seonukkim/gps_hc12_robot/docs/rc_channel_map.md

# RC Channel Map

Context:
- Station controller: disassembled RadioLink transmitter integrated into the Jetson/station box
- Expected receiver output: combined PPM/SUM into OpenRB D6
- Verification sources: old integrated `openrb_robot_controller.ino`, safe PPM
  probes, and rover `USBDBG` logs

The station transmitter panel labels are not enough to validate this map. The
rover-side receiver output mode and the signal wire going to OpenRB `D6` must
also be correct. If USBDBG reports `PPM_SYNC_ONLY_NO_CHANNELS`, then `D6` is
not receiving a usable combined PPM/SUM frame even if the station controller is
powered and linked.

## Station Integrated Controller Mapping

| PPM Channel | Station Control | Firmware Use | Notes |
|---:|---|---|---|
| CH1 | Steering joystick horizontal | Steering | `STEERING_CHANNEL_INDEX = 0` |
| CH2 | Throttle joystick vertical | Throttle | `THROTTLE_CHANNEL_INDEX = 1` |
| CH5 | Manual/Auto switch | Mode select | `MODE_CHANNEL_INDEX = 4` |
| CH7 | Reserved / unused | None | Do not use for mode |

The station panel can physically look like `CH7`, but the firmware uses the receiver's PPM `CH5` for Manual/Auto mode. `CH7` is reserved/unused for now.

## Firmware Constants

- `STEERING_CHANNEL_INDEX = 0`
- `THROTTLE_CHANNEL_INDEX = 1`
- `MODE_CHANNEL_INDEX = 4`
- PPM decoder edge/sync: `RISING`, frame gap `>3000 us`, matching the old
  integrated `openrb_robot_controller.ino` baseline that physically moved
- `STEERING_CENTER_US = 1504`
- `THROTTLE_CENTER_US = 1500`
- `RC_DEADBAND_US = 80`
- `RC_AUTO_SWITCH_ON_US = 1600`
- `MANUAL_FORWARD_SIGN = -1` for the current rover/controller
- `MANUAL_TURN_SIGN = 1` for the current rover/controller
- `MOTOR_OUTPUT_SWAP_LR = 0`
- `DRIVE_CALIBRATION_ENABLE = 0` for the current uncalibrated baseline

RC manual mode no longer uses the old 45-degree remap in the final drive path.
The raw CH1/CH2 stick axes are interpreted as steering and throttle, then mixed
as arcade forward/turn commands into logical wheel commands:

```cpp
forward = MANUAL_FORWARD_SIGN * throttle_norm;
turn = MANUAL_TURN_SIGN * steer_norm;
logical_left = clamp(forward + turn);
logical_right = clamp(forward - turn);
```

The same common output layer used by AUTO and motor pulse then maps logical
wheels to the probe-confirmed physical A/B pins:

```cpp
A = (logical_left + logical_right) / 2;
B = (logical_right - logical_left) / 2;
```

Target behavior:

- physical stick straight up -> forward
- physical stick straight down -> reverse
- physical stick straight left/right -> steering without forward/reverse bias

This is an RC axis sign convention. It does not change the physical output
truth table: A is throttle, B is turn, `A=(L+R)/2`, and `B=(R-L)/2`.

## Mode Interpretation

- `CH5 <= 1600 us` -> `MANUAL`
- `CH5 > 1600 us` -> `AUTO_READY`
- `CH5` high by itself must not drive motors
- In `AUTO_READY`, `control_source` remains `STOP` until a valid explicit station/autonomous command is accepted
- `MANUAL` allows RC manual drive

## Confirmed Observations

- `CH1` moves with steering input
- `CH2` moves with throttle input
- `CH5` low/mid stays `MANUAL`
- `CH5` high selects `AUTO_READY`
- `CH7` is not used by firmware for mode
- Transmitter/link loss drives RC invalid handling and motor stop behavior

## Bench Check

1. Move the steering joystick and confirm `CH1` changes.
2. Move the throttle joystick and confirm `CH2` changes.
3. Toggle the Manual/Auto switch and confirm `CH5` changes between low/high values.
4. Confirm `CH7` may move independently, but it does not affect rover mode.
5. Turn the transmitter off or break the RC link and confirm the rover returns to stop/failsafe behavior.

Before interpreting channel numbers, confirm the PPM frame itself is valid:

- `ppm_frame_count` should increase.
- `ppm_last_channel_count` should be at least `5`.
- `raw_ch1_us`, `raw_ch2_us`, and `raw_ch5_us` should be in the roughly
  `900..2100 us` range.
- If `ppm_edge_count` and `ppm_sync_count` increase but `ppm_frame_count=0`,
  the receiver is not delivering combined PPM/SUM to `D6`.

## Final note on station physical switch label

The physical switch on the station panel may appear to be labeled CH7, but the receiver PPM stream reports this Manual/Auto switch as PPM CH5.

Final firmware mapping:
- Steering: PPM CH1 / code index 0
- Throttle: PPM CH2 / code index 1
- Manual/Auto: PPM CH5 / code index 4
- PPM CH7 is not used for Manual/Auto in the current firmware.

Do not change `MODE_CHANNEL_INDEX` to 6 unless raw PPM logs confirm that the desired physical switch actually changes printed CH7.

## Final physical station control note

Final operating convention:

- Steering: joystick horizontal -> PPM CH1 -> code index 0
- Throttle: joystick vertical -> PPM CH2 -> code index 1
- Manual/Auto mode: the working physical mode switch on the station panel -> PPM CH5 -> code index 4

The station panel label may look confusing because the working physical switch may appear to be in a CH7 position.
For operation, relabel that working switch as `CH5 / MODE / MANUAL-AUTO`.
CH7 is not used for mode in the current firmware.
