seonukkim/gps_hc12_robot/docs/autonomy_plan.md

# Autonomy Plan

This project does not have real autonomous waypoint following yet. The current
autonomy work is limited to a safe fixed-wiring dry-run mode that combines RC
manual driving with GPS readiness calculations.

## Status

Unified fixed-wiring RC + GPS dry-run validation is complete. The single
waypoint experiment with `AUTO_MOTION_ARMED=0` has now passed the no-motion AUTO
candidate-command validation outdoors: GPS placement was corrected, MANUAL/AUTO
switching was verified, `distance_allowed=true` and `safety_ready=true` were
observed, candidate commands reached `0.100` / `0.100`, and final motor outputs
remained inhibited at `0.000` / `0.000`. Compile-time target override is
verified in USBDBG, but targets still become stale whenever the rover moves.
GPS readiness is tiered so no-motion dry-run can use `gps_dryrun_ready`, while
any future armed motion must require `gps_motion_ready`. On 2026-05-29 the armed
build (`AUTO_MOTION_ARMED=1`) reached firmware-side final output for the first
time (`final_left_cmd=0.100` / `final_right_cmd=0.100`, motion-grade GPS, all
gates passing) but produced **no visible motion** — almost certainly the
motor/ESC/friction deadband (`0.100` ≈ 1530 µs, only 30 µs above neutral). The
AUTO command must not be raised ungated. Armed motion is now permitted ONLY
through the guarded ground crawl harness (`GROUND_CRAWL_TEST_MODE=1`) with a
command clamp and a hard latch stop. The first guarded crawl 0.08 validation is
now complete: `AUTO_RUNNING` was reached during a good GPS window,
`ground_crawl_ready=true`, the raw `0.100` candidate commands were clamped to
`0.080`, latch stop forced zero output after the duration limit, too-close
target distance was blocked as `DISTANCE_OUT_OF_RANGE`, and degraded GPS was
blocked as `GPS_NOT_MOTION_READY`. This validates the safety harness, not full
autonomous driving. The current target is now too close and must be replaced
with a fresh target for any future crawl. A later cap-only 0.12 run
confirmed that `GROUND_CRAWL_MAX_CMD` only raises the final cap: the candidate
command stayed at `0.100`, so final commands stayed at `0.100`. The firmware now
uses `SINGLE_WP_CRAWL_BASE_CMD` for candidate speed and keeps
`GROUND_CRAWL_MAX_CMD` as the final safety clamp. Floor waypoint driving is not
approved yet. After the manual/drive mapping fix, the first successful guarded
AUTO crawl physically moved the rover briefly forward. The confirmed baseline
was `MANUAL_FORWARD_SIGN=-1`, `MANUAL_TURN_SIGN=1`,
`old_angle_remap_active=false`, physical A/B mapping
`A=(logical_left+logical_right)/2`, `B=(logical_right-logical_left)/2`,
`SINGLE_WP_CRAWL_BASE_CMD=0.220`, and `GROUND_CRAWL_MAX_CMD=0.220`. The
successful `AUTO_RUNNING` line showed motion-grade GPS, `target_distance_m≈9.6`,
`distance_allowed=true`, `ground_crawl_ready=true`, straight output
`physical_a_cmd=0.220` / `physical_b_cmd=0.000`, and final logical commands
`0.220` / `0.220`; the latch stopped output after roughly `510` ms. This is
short guarded forward motion only, not waypoint following or coverage driving.
The repeated `1000` ms guarded crawl has also now been validated. With
`GROUND_CRAWL_TEST_MODE=1`, `GROUND_CRAWL_MAX_CMD=0.220`,
`GROUND_CRAWL_MAX_AUTO_MS=1000`, `SINGLE_WP_CRAWL_BASE_CMD=0.220`,
`AUTO_MOTION_ARMED=1`, `MANUAL_FORWARD_SIGN=-1`, and `MANUAL_TURN_SIGN=1`, the
user toggled AUTO/MANUAL about `3..4` times and `AUTO_RUNNING` was observed
multiple times. Each valid AUTO window produced straight forward output
(`physical_a_cmd=0.220`, `physical_b_cmd=0.000`) and the latch returned outputs
to zero after about `1000` ms. `target_distance_m` varied around `16.8..18.0`
instead of monotonically decreasing, which is expected because no steering or
course correction is active yet.

Full coverage driving from `mission.json` / `mission.csv` is intentionally not
the next step. The rover must first prove one carefully bounded waypoint motion
with explicit safety gates, GPS validity policy, heading plan, manual override,
and wheel-off-ground checks.

Motor deadband calibration is now temporarily split out from GPS/path planning:
`MOTOR_PULSE_TEST_MODE=1` ignores GPS readiness and waypoint distance, disables
HC-12, preserves RC MANUAL, and emits one AUTO-only neutral-stick pulse before
latching stop. Use it only to identify motor/drivetrain response thresholds.
The first calibration result shows `0.180` is below visible motion while `0.220`
does move, but symmetric `0.220` software output produced rotation-like motion
rather than straight motion. The physical pin probe has now clarified the output
path: physical output A is throttle, physical output B is turn, and logical
wheel commands must be converted with `A=(left+right)/2` and
`B=(right-left)/2`. The current blocker is validating that corrected mapping
with both-wheel forward/reverse tests, not right-side compensation yet.

Staged plan:

1. Dry-run complete: MANUAL RC and AUTO GPS distance/bearing computation coexist
   with AUTO motor output forced to zero.
2. Single-waypoint candidate-command dry-run complete: candidate commands were
   computed behind safety gates while `AUTO_MOTION_ARMED=0` forced final motor
   output to zero.
3. Target override diagnostics complete: USBDBG now confirms
   `target_override_enabled=true`, `target_source=compile_time`, and runtime
   `target_lat` / `target_lon` matching the compile-time macros.
4. RC recovery complete: with the station/controller powered and linked, MANUAL
   shows `mode_us≈1000..1001` and `control_source=RC_MANUAL`; AUTO shows
   `mode_us≈2001..2002`, `mode=AUTO_READY`, and `control_source=STOP`.
5. Outdoor GPS/distance recovery complete: rover placement farther outdoors
   recovered stable GPS and target distance can be brought into range with a
   recomputed compile-time target.
6. Full outdoor fixed-frame no-motion dry-run complete: AUTO_READY,
   `timeout_ok=true`, `distance_allowed=true`, `safety_ready=true`, nonzero
   candidate commands, and inhibited final outputs were observed together.
7. Timeout semantics improvement complete in firmware: the single-waypoint
   experiment tracks AUTO entry time, resets the AUTO timeout when leaving
   AUTO, and reports `timeout_source=auto_entry`, `auto_entry_ms`,
   `auto_elapsed_ms`, `timeout_limit_ms`, and `timeout_ok`.
8. GPS reacquisition policy complete: if GPS is lost, reacquire stable outdoor
   GPS before repeating AUTO_READY validation. Placement farther outdoors is the
   known fix for the recent no-fix runs.
9. GPS readiness hardening complete: operational `gps_lat` / `gps_lon`, target
   distance, and target bearing no longer use stale cached TinyGPS coordinates.
   No-motion dry-run uses the dry-run GPS tier; armed motion uses the motion GPS
   tier.
10. GPS readiness tiers complete:
   - `gps_solution_valid` confirms a valid fresh solution with usable NMEA fix
     status when available.
   - `gps_dryrun_ready` allows no-motion candidate calculations with
     `GPS_DRYRUN_MIN_SATS=4` and `GPS_DRYRUN_MAX_HDOP=6.0`.
   - `gps_motion_ready` keeps stricter motion gating with
     `GPS_MOTION_MIN_SATS=5` and `GPS_MOTION_MAX_HDOP=2.5`.
11. Sensor-frame validation: keep the GPS antenna fixed to the rover body in open
   sky. IMU diagnostics remain useful, but IMU is optional for the current
   GPS+RC single-waypoint preparation stage and must not block candidate dry-run
   work.
12. Guarded ground crawl 0.08 safety validation complete. Armed AUTO motion is
   permitted ONLY through the guarded ground crawl harness. The 0.08 run reached
   `AUTO_RUNNING` with `ground_crawl_ready=true`, clamped
   `candidate_left_cmd=0.100` / `candidate_right_cmd=0.100` down to
   `final_left_cmd=0.080` / `final_right_cmd=0.080`, latched stop after the
   duration limit, blocked a too-close `3.9..4.4` m target as
   `DISTANCE_OUT_OF_RANGE`, and blocked degraded GPS as `GPS_NOT_MOTION_READY`.
13. Guarded ground crawl 0.12 deadband retry: only if 0.08 produced no visible
   physical movement, first reacquire current GPS and compute a fresh target
   `10..12` m away. Then retry with `SINGLE_WP_CRAWL_BASE_CMD=0.12` and
   `GROUND_CRAWL_MAX_CMD=0.12`, the same `GROUND_CRAWL_MAX_AUTO_MS` latch,
   neutral RC, motion-grade GPS, near-field target window, and manual override.
   `SINGLE_WP_CRAWL_BASE_CMD` controls the candidate command; `GROUND_CRAWL_MAX_CMD`
   remains the final safety clamp. Do not reuse stale targets.
14. First successful guarded forward crawl complete. With
   `SINGLE_WP_CRAWL_BASE_CMD=0.220` and `GROUND_CRAWL_MAX_CMD=0.220`, the rover
   briefly moved forward in `AUTO_RUNNING`, then latch-stop forced neutral.
   This validates a short bounded forward crawl, not full path execution.
15. Physical output pin truth table: complete. `firmware/physical_output_pin_probe`
   confirmed A is throttle and B is turn. The integrated conversion now uses
   `A=(left+right)/2` and `B=(right-left)/2`.
16. Corrected direct wheel pulse validation: first run both-wheel forward and
   reverse tests. Single-wheel logical commands are halved at the physical pin
   level and may still be near deadband.
17. Differential left/right motor pulse calibration: after corrected both-wheel
   behavior is verified, characterize left-only, right-only, and matched
   left/right thresholds with `MOTOR_PULSE_LEFT_CMD` and
   `MOTOR_PULSE_RIGHT_CMD` before any GPS path work.
18. Shared drive calibration layer: apply any deadband compensation, left/right
   trim, or output scaling in one common layer used by both MANUAL and AUTO.
   This layer is behind `DRIVE_CALIBRATION_ENABLE=1`; identity/off defaults
   preserve current behavior.
19. Repeated 1000 ms guarded forward crawl complete. This proves repeated
   short guarded autonomous forward actuation, not path execution.
20. Station-side path planning preview only, with no motor execution.
21. Single-waypoint steering dry-run diagnostics added with
   `SINGLE_WP_STEERING_DRYRUN=1`. This mode prints desired steering fields but
   does not enable motion by itself.
22. Heading/course estimation before physical waypoint following. GPS position
   alone is insufficient for steering; course-over-ground is only accepted after
   at least `SINGLE_WAYPOINT_COURSE_MIN_DISPLACEMENT_M` of GPS displacement
   (default `2.0` m, compile-time configurable via
   `-DCOURSE_MIN_DISPLACEMENT_M=<meters>`). A diagnostic tethered steering
   dry-run may set `-DCOURSE_MIN_DISPLACEMENT_M=1.0` to estimate heading over
   shorter movement. This only changes when course-over-ground is estimated; it
   does not weaken actual GPS motion safety thresholds (`gps_motion_min_sats`,
   `gps_motion_max_hdop`, `gps_motion_stale_ms` are unchanged) and does not
   enable motor execution.
23. Low-speed floor test: only after guarded crawl behavior, drivetrain
   calibration, steering behavior, and sensor-frame assumptions are validated.
24. Multi-waypoint motion: only after single-waypoint behavior is proven.
25. Coverage path / lawnmower driving: last step, after mission sequencing,
   heading control, logging, and safety policy are complete.

## GPS Antenna Frame Vs Rover Body Frame

GPS coordinates are antenna coordinates. During the recent single-waypoint
candidate dry-run, the GPS antenna was placed far outside while the rover body
remained indoors. That setup is acceptable for validating GPS reception,
`gps_fix`, distance/bearing computation, and AUTO motor inhibition, but it is
not valid for floor navigation.

A detached antenna means `gps_lat` / `gps_lon` represents the antenna location,
not the rover body location. An IMU cannot fully correct a detached or
free-moving GPS antenna into rover body position. The IMU may help later with
heading, rotation, tilt, and short-term motion sensing, but it does not replace
a rover-mounted GPS position source.

Real outdoor navigation requires one of these conditions:

- the GPS antenna is rigidly mounted on the rover; or
- the antenna offset from the rover body frame is fixed, measured, and modeled.

Until that is true, do not proceed to floor waypoint driving and do not approve
`AUTO_MOTION_ARMED=1` floor tests.

## Next Required Validation Before Further Motion

- BLOCKER (2026-05-30): the AUTO/MANUAL switch channel must be stable before any
  physical path following. A PPM hold test showed receiver CH5 did not hold
  HIGH: `ch5_high_auto_like=4` of `total_ch5_samples=68`
  (`RESULT=CH5_AUTO_DID_NOT_HOLD`). Raising AUTO briefly enters `AUTO_READY` then
  `FAILSAFE` as `ppm_age_ms` grows. Use `firmware/ppm_channel_map_probe` with
  `tools/analyze_ppm_log.py` to find a receiver channel that is a stable
  2-position switch (reaches both LOW and HIGH and holds HIGH), then set
  `-DMODE_CHANNEL_INDEX=<0-based index>` in the main controller (default `4` =
  CH5). Path planning preview is allowed; physical path execution is not.
- Station-side path planning preview only; do not send rover motor commands from
  the station mission output yet.
- Use `SINGLE_WP_STEERING_DRYRUN=1` for no-motion single-waypoint steering
  diagnostics before longer ground motion.
- Add heading/course estimation before physical waypoint following. If movement
  is too small, expect `heading_ready=false` and
  `steering_block_reason=NO_HEADING`. The minimum displacement is
  `SINGLE_WAYPOINT_COURSE_MIN_DISPLACEMENT_M` (default `2.0` m); a tethered
  diagnostic build can lower it with `-DCOURSE_MIN_DISPLACEMENT_M=1.0` without
  changing GPS motion safety thresholds or enabling motion. USBDBG reports the
  active value as `course_min_displacement_m` and the configured macro as
  `course_min_displacement_source`.
- After each guarded crawl, compare GPS delta and target-distance change against
  the expected forward movement. Do not infer path-following quality from wheel
  motion alone.
- For each guarded crawl run, go fully outdoors with the rover and GPS fixed
  together, acquire a fresh GPS fix in MANUAL, and compute a fresh target from
  that actual fix. Do not reuse stale target coordinates.
- Choose a target roughly `10..12` m away so it remains inside the crawl
  near-field window (`5..20` m) but does not immediately trip the too-close
  block.
- Confirm the station/controller is powered on and linked before interpreting
  RC mode values; controller-off can make the PPM stream appear stuck or
  failsafe-like.
- Verify Manual/Auto switch positions before the crawl run: MANUAL should show
  `mode_us≈1000` and `control_source=RC_MANUAL`; AUTO should show
  `mode_us≈2000` and either `mode=AUTO_READY` before the crawl gates pass or
  `mode=AUTO_RUNNING` only while all guarded crawl gates pass.
- Confirm the target override fields still match the intended target, then
  interpret `target_distance_m`, `distance_allowed`, `safety_ready`, and
  `ground_crawl_block_reason`.
- `distance_allowed=true` in MANUAL is not enough; verify the same nearby-target
  condition in AUTO with `gps_motion_ready=true`, `timeout_ok=true`,
  `safety_ready=true`, and `ground_crawl_ready=true`.
- Confirm GPS readiness using `gps_age_ms`, `gps_hdop`, and `gps_sats`; do not
  rely on `gps_fix=true` alone.
- `gps_chars` increasing only proves serial/NMEA input is alive. Do not proceed
  to AUTO candidate validation when `gps_fix=false`, `gps_lat=NA`,
  `gps_lon=NA`, `gps_sats=0`, or `gps_hdop=99.99`.
- In updated USBDBG, `gps_ready` remains the stricter motion-level field.
  `gps_location_valid=true` only means TinyGPS has a cached location; it is not
  enough by itself.
- `AUTO_MOTION_ARMED=0` no-motion candidate calculations may use
  `gps_dryrun_ready=true`; this is reported as `active_gps_ready=true` in the
  single-waypoint debug fields.
- Any `AUTO_MOTION_ARMED=1` guarded crawl build must require
  `gps_motion_ready=true`.
- HDOP around `5` is acceptable only for no-motion dry-run candidate
  calculation. It is not approved for floor driving.
- If the relevant readiness tier is false, target-distance and bearing should
  print `NA`. Inspect `gps_cached_lat`, `gps_cached_lon`, and
  `gps_cached_age_ms` only as debug-only cached data.
- Run candidate validation after entering AUTO; MANUAL GPS waiting no longer
  consumes the single-waypoint AUTO timeout in the updated firmware.
- In MANUAL, expect `auto_entry_ms=NA` and `auto_elapsed_ms=NA`; after switching
  to AUTO, expect `timeout_source=auto_entry`, a numeric `auto_entry_ms`, a
  small `auto_elapsed_ms`, and `timeout_ok=true` until the AUTO timeout limit is
  exceeded.
- Repeated 1000 ms guarded forward crawl succeeded at
  `SINGLE_WP_CRAWL_BASE_CMD=0.220`, `GROUND_CRAWL_MAX_CMD=0.220`, and
  `GROUND_CRAWL_MAX_AUTO_MS=1000`. Future retries must still use the guarded
  crawl harness, duration latch, and fresh target.
- Do not run floor driving yet. Keep any indoor or non-bench validation in
  no-motion mode with `AUTO_MOTION_ARMED=0`; guarded crawl is a bounded
  deadband-calibration step, not full autonomous driving.
- IMU status: optional for the current GPS+RC single-waypoint stage. The
  default `Wire` scanner currently shows D11/D12 stuck low before scanning, so
  no IMU address is verified and no IMU data may be used for autonomy yet.

## Current Fixed-Wiring Dry-Run Mode

Compile-time flag:

```text
FIXED_WIRING_GPS_SERIAL2_RC_AUTONOMY_DRYRUN=1
```

Behavior:

- GPS uses the fixed central OpenRB connector on `Serial2` at `9600`.
- HC-12 is disabled/ignored because it may conflict with the fixed GPS
  `Serial2` wiring.
- RC PPM remains enabled and is the safety/manual interface.
- MANUAL mode preserves current RC manual driving behavior and reports
  `control_source=RC_MANUAL`.
- AUTO switch position does not drive motors. It forces `left_cmd=0` and
  `right_cmd=0`, then prints readiness/debug fields over USB.
- STOP, RC failsafe, and manual override must not be weakened.

AUTO dry-run debug fields:

```text
autonomy_dryrun=true
target_lat=35.571120
target_lon=129.186050
target_distance_m=...
target_bearing_deg=...
gps_ready=...
target_ready=...
autonomy_ready=...
```

The current placeholder target is hard-coded in the firmware as:

```text
lat=35.571120
lon=129.186050
```

The placeholder target is only used to compute distance and bearing from the
current GPS position. It must not cause motor movement.

## Onboard Mission Dry-Run Implementation

The current onboard mission dry-run is implemented inside
`firmware/openrb_robot_controller/openrb_robot_controller.ino` and is enabled
only by:

```text
FIXED_WIRING_GPS_SERIAL2_RC_AUTONOMY_DRYRUN=1
```

The dry-run target is a small placeholder config section in the firmware:

- `DRYRUN_TARGET_AVAILABLE`
- `DRYRUN_TARGET_LAT`
- `DRYRUN_TARGET_LON`
- `DRYRUN_GPS_READY_MAX_AGE_MS`

The Arduino-side geodesy helpers are:

- `dryrunDistanceMeters(...)`: haversine distance in meters.
- `dryrunBearingDegrees(...)`: initial bearing in degrees, normalized to
  `0..360`.

These helpers are currently Arduino-side only, so there is no Python unit test
for them. Manual validation is by USB debug output in the dry-run build:

- verify `target_distance_m` is finite when the active GPS tier is ready
  (`gps_dryrun_ready=true` for inhibited dry-run);
- verify `target_bearing_deg` stays in `0..360`;
- verify motion-level `gps_ready=true` only when GPS has a valid recent
  high-quality location;
- verify AUTO mode still reports `left_cmd=0` and `right_cmd=0`;
- verify switching RC back to MANUAL restores `control_source=RC_MANUAL`.

This is the onboard preparation step for future mission execution. It is not
real waypoint following.

## Validation Result

The unified fixed-wiring dry-run firmware is complete and was tested with
`FIXED_WIRING_GPS_SERIAL2_RC_AUTONOMY_DRYRUN=1`.

Observed:

- USBDBG identified the build as unified dry-run, not default and not GPS-only
  diagnostic:
  - `fixed_wiring_gps_serial2_diag=false`
  - `hc12_enabled=false`
  - `autonomy_dryrun=true`
- `GPS_SERIAL=Serial2`.
- HC-12 was disabled/ignored.
- MANUAL mode worked with RC control.
- `control_source=RC_MANUAL` in MANUAL mode.
- Stick input changed manual command, logical wheel, and final command fields.
- Current MANUAL RC sign convention is `MANUAL_FORWARD_SIGN=-1`,
  `MANUAL_TURN_SIGN=1`, `MOTOR_OUTPUT_SWAP_LR=0`, and
  `DRIVE_CALIBRATION_ENABLE=0`; this is an RC axis sign fix and does not alter
  GPS, motor pulse, or physical A/B output mapping.
- AUTO mode printed `autonomy_dryrun=true`.
- AUTO mode printed GPS fields, `target_lat`, `target_lon`, and target
  distance/bearing fields.
- With the antenna outside/open sky, `gps_fix=true` was observed.
- Earlier `gps_sats=0` / `gps_hdop=99.99` was poor antenna placement, not UART
  failure.
- AUTO mode used `control_source=STOP` and kept `left_cmd=0` and
  `right_cmd=0`.
- No motor movement occurred in AUTO dry-run.

Rule:

- This is the first firmware mode where MANUAL and GPS dry-run coexist in one
  firmware.
- AUTO is still computation-only.
- Real motion is not enabled yet.
- MANUAL remains the recovery/manual override path.
- HC-12 remains disabled in this fixed-wiring GPS mode.

## Readiness Logic

- `gps_ready=true` is the stricter motion-level GPS gate.
- In inhibited dry-run, `gps_dryrun_ready=true` can allow distance, bearing,
  and candidate-command diagnostics while final motor commands remain zero.
- `target_ready=true` when the placeholder waypoint is available.
- `autonomy_ready=true` only when RC is valid, the RC AUTO switch is on, the
  relevant GPS tier is ready, and the target is ready.

`autonomy_ready=true` is still only a dry-run state. It is not permission to
move.

## Single-Waypoint Experiment

Compile-time flag:

```text
FIXED_WIRING_GPS_SERIAL2_SINGLE_WAYPOINT_EXPERIMENT=1
```

Default motion arming flag:

```text
AUTO_MOTION_ARMED=0
```

Behavior:

- GPS uses fixed `Serial2` at `9600`.
- HC-12 is disabled/ignored.
- RC PPM remains enabled.
- MANUAL mode preserves existing RC manual driving and reports
  `control_source=RC_MANUAL`.
- AUTO mode uses one placeholder target only.
- AUTO mode computes `target_distance_m` and `target_bearing_deg`.
- AUTO mode prints candidate left/right commands.
- Candidate commands are straight low-speed placeholders. Target bearing is
  printed for inspection, but heading control is not implemented yet.
- With `AUTO_MOTION_ARMED=0`, final `left_cmd` and `right_cmd` remain zero even
  when candidate commands are nonzero.
- With `AUTO_MOTION_ARMED=1`, low-speed candidate output is allowed only if all
  safety gates pass. This is reserved for a later explicit wheel-off-ground
  bench test.

Target override rule:

- Runtime USBDBG `target_lat` and `target_lon` are the source of truth.
- Compile-time target override flags must be verified in USBDBG before using
  `target_distance_m`, `distance_allowed`, or `safety_ready` to approve any next
  step.
- With both override macros provided, USBDBG should print
  `target_override_enabled=true` and `target_source=compile_time`.
- Without override macros, USBDBG should print `target_override_enabled=false`
  and `target_source=fallback`, using the existing placeholder target.
- USBDBG also prints `target_lat_macro`, `target_lon_macro`,
  `max_target_distance_m`, and `arrival_radius_m` for diagnostics.
- The latest nearby retest attempted to compile with
  `SINGLE_WP_TARGET_LAT=35.5716800` and `SINGLE_WP_TARGET_LON=129.1866516`, but
  runtime USBDBG still printed `target_lat=35.571120` and
  `target_lon=129.186050`.
- Therefore the nearby retest was blocked by target override plumbing and must
  not be counted as a successful nearby candidate-command test.
- A later target override check compiled with
  `SINGLE_WP_TARGET_LAT=35.5710210` and `SINGLE_WP_TARGET_LON=129.1864016`.
  USBDBG correctly printed `target_override_enabled=true`,
  `target_source=compile_time`, matching macro strings, and runtime
  `target_lat=35.571021`, `target_lon=129.186402`.
- That proves target override plumbing is fixed. It does not prove nearby
  candidate command behavior, because the current GPS position was around
  `35.56752..35.56756,129.18688`, making `target_distance_m≈380..392`.
- A next-day retest kept target override working
  (`target_override_enabled=true`, `target_source=compile_time`) but the antenna
  position changed to about `35.571310,129.188630` while the firmware target was
  `35.567560,129.186792`, producing `target_distance_m≈448.9`.
- That next-day run was also blocked by GPS readiness: `gps_fix=true` appeared,
  but `gps_ready=false` remained because `gps_age_ms` was often very large,
  `gps_sats` fluctuated, and `gps_hdop` was often `99.99` with only occasional
  readings around `4.7`.
- A later nearby attempt compiled with `SINGLE_WP_TARGET_LAT=35.5713100` and
  `SINGLE_WP_TARGET_LON=129.1885416`; USBDBG confirmed the override target, and
  GPS fix was acquired at `gps_lat=35.571384`, `gps_lon=129.187514`. The target
  was still `93.3` m away from the actual fix, so `distance_allowed=false` with
  `max_target_distance_m=30.0`.
- The latest window/outside-antenna test compiled with
  `SINGLE_WP_TARGET_LAT=35.5713840` and `SINGLE_WP_TARGET_LON=129.1874256`;
  USBDBG confirmed the override, but the antenna position was around
  `35.571284,129.188456`, the target was still about `93.9` m away, and GPS
  quality was unstable (`gps_sats` often `0`, `gps_hdop` often `99.99`,
  stale `gps_age_ms`).

Safety constants:

- `SINGLE_WP_CRAWL_BASE_CMD=0.100` (candidate straight-line crawl command before
  final guarded-crawl clamping)
- `SINGLE_WAYPOINT_ARRIVAL_RADIUS_M=2.5`
- `SINGLE_WAYPOINT_MAX_TARGET_DISTANCE_M=30.0`
- Dry-run GPS tier: `GPS_DRYRUN_STALE_MS=2000`,
  `GPS_DRYRUN_MIN_SATS=4`, `GPS_DRYRUN_MAX_HDOP=6.0`
- Motion GPS tier: `GPS_MOTION_STALE_MS=2000`, `GPS_MOTION_MIN_SATS=5`,
  `GPS_MOTION_MAX_HDOP=2.5`
- `SINGLE_WAYPOINT_AUTO_TIMEOUT_MS=15000`
- Guarded ground crawl (armed-motion harness; only path to armed motion):
  - `GROUND_CRAWL_TEST_MODE` (default `0`; `1` enables the crawl harness)
  - `GROUND_CRAWL_MAX_CMD=0.08` (final command clamp magnitude)
  - `GROUND_CRAWL_MAX_AUTO_MS=1200` (latch hard-stop after this much continuous
    AUTO; latch clears only on MANUAL)
  - `GROUND_CRAWL_MIN_TARGET_DISTANCE_M=5.0`,
    `GROUND_CRAWL_MAX_TARGET_DISTANCE_M=20.0` (near-field target window, further
    restricting `SINGLE_WAYPOINT_MAX_TARGET_DISTANCE_M=30.0`)

Safety gates:

- GPS tier ready:
  `gps_dryrun_ready=true` when `AUTO_MOTION_ARMED=0`, and
  `gps_motion_ready=true` for any future `AUTO_MOTION_ARMED=1` build.
- Target valid.
- RC input valid.
- RC AUTO switch on.
- Target distance above arrival radius.
- Target distance below max allowed distance.
- AUTO timeout not exceeded.

USB debug fields:

```text
single_waypoint_experiment=true
target_override_enabled=...
target_source=...
target_lat_macro=...
target_lon_macro=...
auto_motion_armed=...
auto_motor_inhibit=...
active_gps_ready=...
gps_location_valid=...
gps_location_fresh=...
gps_solution_valid=...
gps_dryrun_ready=...
gps_motion_ready=...
gps_age_ok=...
gps_sats_ok=...
gps_hdop_ok=...
gps_block_reason=...
gps_dryrun_block_reason=...
gps_motion_block_reason=...
target_ready=...
timeout_source=auto_entry
auto_entry_ms=...
auto_elapsed_ms=...
timeout_limit_ms=...
timeout_ok=...
max_target_distance_m=...
max_coord_sanity_distance_m=...
dryrun_ready=...
motion_ready=...
safety_ready_source=...
arrival_radius_m=...
distance_allowed=...
safety_ready=...
arrived=...
target_lat=...
target_lon=...
target_distance_m=...
target_bearing_deg=...
candidate_left_cmd=...
candidate_right_cmd=...
final_left_cmd=...
final_right_cmd=...
```

This mode does not load `mission.json`, does not run multiple waypoints, and
does not implement coverage/lawnmower driving.

Observed candidate dry-run status:

- `single_waypoint_experiment=true`
- `auto_motion_armed=false`
- `auto_motor_inhibit=true`
- `gps_fix=true` eventually with open-sky antenna placement
- `target_distance_m` and `target_bearing_deg` printed
- AUTO kept final `left_cmd` / `right_cmd` at `0`
- MANUAL returned to `RC_MANUAL`, and stick input changed motor command fields

This confirms candidate dry-run safety and basic distance/bearing computation,
but it does not validate rover body localization while the GPS antenna is
detached from the rover.

Latest nearby candidate retest:

- Build/upload succeeded with
  `FIXED_WIRING_GPS_SERIAL2_SINGLE_WAYPOINT_EXPERIMENT=1`,
  `AUTO_MOTION_ARMED=0`, `SINGLE_WP_TARGET_LAT=35.5716800`, and
  `SINGLE_WP_TARGET_LON=129.1866516`.
- Runtime USBDBG still printed the old placeholder target:
  `target_lat=35.571120`, `target_lon=129.186050`.
- GPS fix was achieved, and at least one log line reached `gps_hdop=1.19` and
  `gps_ready=true`.
- Because the target remained the old placeholder, `target_distance_m` stayed
  around `40` to `60` m, `distance_allowed=false`, and `safety_ready=false`.
- `candidate_left_cmd=0.000`, `candidate_right_cmd=0.000`,
  `final_left_cmd=0.000`, and `final_right_cmd=0.000`.
- MANUAL still returned to `control_source=RC_MANUAL`.
- This was a safe failed validation. Safety gates and motor inhibit worked, but
  target override plumbing is the next blocker.

Latest target override check:

- Build/upload succeeded with
  `FIXED_WIRING_GPS_SERIAL2_SINGLE_WAYPOINT_EXPERIMENT=1`,
  `AUTO_MOTION_ARMED=0`, `SINGLE_WP_TARGET_LAT=35.5710210`, and
  `SINGLE_WP_TARGET_LON=129.1864016`.
- USBDBG correctly printed `target_override_enabled=true`,
  `target_source=compile_time`, `target_lat_macro=35.5710210`,
  `target_lon_macro=129.1864016`, `target_lat=35.571021`, and
  `target_lon=129.186402`.
- GPS fix was true, but current GPS was around `gps_lat≈35.56752..35.56756`
  and `gps_lon≈129.18688`.
- `target_distance_m` remained around `380` to `392` m while
  `max_target_distance_m=30.0`.
- `distance_allowed=false`, `safety_ready=false`,
  `candidate_left_cmd=0.000`, and `candidate_right_cmd=0.000`.
- `AUTO_MOTION_ARMED=0` correctly kept `final_left_cmd=0.000` and
  `final_right_cmd=0.000`.
- This verifies target override plumbing, but nearby candidate command remains
  incomplete. Recompute a nearby target from the current GPS position and rerun
  with `AUTO_MOTION_ARMED=0`.

Latest next-day GPS retest:

- The GPS antenna was placed outside again on the next day.
- Runtime GPS moved to approximately `gps_lat=35.571310`,
  `gps_lon=129.188630`.
- Firmware still used the previous compile-time target:
  `target_lat=35.567560`, `target_lon=129.186792`.
- Target override was still working:
  `target_override_enabled=true`, `target_source=compile_time`.
- The target was no longer nearby: `target_distance_m≈448.9` while
  `max_target_distance_m=30.0`.
- `distance_allowed=false` and `safety_ready=false`.
- `gps_fix=true` appeared, but `gps_ready=false` remained because `gps_age_ms`
  was often very large, `gps_sats` fluctuated, and `gps_hdop` was often
  `99.99` and only occasionally around `4.7`.
- `AUTO_MOTION_ARMED=0` and `auto_motor_inhibit=true` kept
  `final_left_cmd=0.000` and `final_right_cmd=0.000`.
- This was a safe blocked validation, not candidate-command success. Recompute
  the target from the current GPS location and rerun with `AUTO_MOTION_ARMED=0`.

Latest nearby attempt:

- Build/upload succeeded with
  `FIXED_WIRING_GPS_SERIAL2_SINGLE_WAYPOINT_EXPERIMENT=1`,
  `AUTO_MOTION_ARMED=0`, `SINGLE_WP_TARGET_LAT=35.5713100`, and
  `SINGLE_WP_TARGET_LON=129.1885416`.
- USBDBG correctly printed `target_override_enabled=true`,
  `target_source=compile_time`, `target_lat_macro=35.5713100`,
  `target_lon_macro=129.1885416`, `target_lat=35.571310`, and
  `target_lon=129.188542`.
- GPS UART was alive and `gps_chars` increased.
- GPS fix was eventually acquired in MANUAL:
  `gps_fix=true`, `gps_lat=35.571384`, `gps_lon=129.187514`,
  `gps_sats=4`, and `gps_hdop=3.39..4.12`.
- `gps_age_ms` was initially fresh but later grew stale.
- The target was not nearby relative to the actual fix:
  `target_distance_m=93.3`, greater than `max_target_distance_m=30.0`.
- `distance_allowed=false`, `safety_ready=false`,
  `candidate_left_cmd=0.000`, and `candidate_right_cmd=0.000`.
- `AUTO_MOTION_ARMED=0` and `auto_motor_inhibit=true` kept
  `final_left_cmd=0.000` and `final_right_cmd=0.000`.
- This is a safe blocked result, not nearby candidate-command success.
  Recompute the target from the actual GPS fix position
  `35.571384,129.187514` and rerun with `AUTO_MOTION_ARMED=0`.

Latest window/outside-antenna attempt:

- The user tested by placing or throwing the GPS antenna outside from indoors.
- Build/upload succeeded with
  `FIXED_WIRING_GPS_SERIAL2_SINGLE_WAYPOINT_EXPERIMENT=1`,
  `AUTO_MOTION_ARMED=0`, `SINGLE_WP_TARGET_LAT=35.5713840`, and
  `SINGLE_WP_TARGET_LON=129.1874256`.
- USBDBG correctly printed `target_override_enabled=true`,
  `target_source=compile_time`, `target_lat_macro=35.5713840`,
  `target_lon_macro=129.1874256`, `target_lat=35.571384`, and
  `target_lon=129.187426`.
- GPS fix was eventually seen, but not stable enough for candidate validation:
  `gps_fix=true` appeared, `gps_lat≈35.571284`, `gps_lon≈129.188456`,
  `gps_sats` often became `0`, `gps_hdop` often became `99.99`, and
  `gps_age_ms` grew very large.
- The target was not nearby relative to the actual GPS position:
  `target_distance_m≈93.9`, greater than `max_target_distance_m=30.0`.
- `distance_allowed=false`, `gps_ready=false`, `safety_ready=false`,
  `candidate_left_cmd=0.000`, and `candidate_right_cmd=0.000`.
- `AUTO_MOTION_ARMED=0` and `auto_motor_inhibit=true` kept
  `final_left_cmd=0.000` and `final_right_cmd=0.000`.
- This is a safe blocked result, not candidate-command success. Go fully
  outdoors with the rover and GPS fixed together, acquire a fresh MANUAL fix,
  recompute the target from that actual fix, and rerun with
  `AUTO_MOTION_ARMED=0`.

Latest outdoor Manual/Auto recovery and stale-target block:

- The previous RC issue was caused by the station/controller being off.
- After restoring the controller/link, AUTO was verified with
  `mode=AUTO_READY`, `auto_sw=true`, `mode_us≈2001..2002`, and
  `control_source=STOP`.
- MANUAL was verified with `mode=MANUAL`, `auto_sw=false`,
  `mode_us≈1000..1001`, and `control_source=RC_MANUAL`.
- Manual stick input changed `steer_us` / `throttle_us`, and at least one
  MANUAL line produced nonzero `left_cmd` / `final_left_cmd`.
- Outdoor GPS was usable at several points: `gps_fix=true` and `gps_ready=true`
  appeared when HDOP was good.
- The compile-time target was stale: `target_lat=35.570675`,
  `target_lon=129.186769`, while runtime GPS was around `35.5716,129.1875`.
- `target_distance_m≈100..131`, greater than `max_target_distance_m=30.0`.
- `distance_allowed=false`, `safety_ready=false`,
  `candidate_left_cmd=0.000`, and `candidate_right_cmd=0.000`.
- `AUTO_MOTION_ARMED=0` and `auto_motor_inhibit=true` kept AUTO final commands
  at zero.
- This is a successful RC recovery and a safety-blocked autonomy dry-run, not a
  nearby candidate-command success. Recompute a nearby target from the current
  runtime GPS fix and rerun with `AUTO_MOTION_ARMED=0`.

Latest outdoor nearby dry-run:

- Build/upload used `FIXED_WIRING_GPS_SERIAL2_SINGLE_WAYPOINT_EXPERIMENT=1`,
  `AUTO_MOTION_ARMED=0`, `SINGLE_WP_TARGET_LAT=35.5707680`, and
  `SINGLE_WP_TARGET_LON=129.1867906`.
- USBDBG confirmed target override:
  `target_override_enabled=true`, `target_source=compile_time`,
  `target_lat_macro=35.5707680`, `target_lon_macro=129.1867906`,
  `target_lat=35.570768`, and `target_lon=129.186791`.
- Outdoor GPS readiness improved: `gps_fix=true`, repeated `gps_ready=true`,
  `gps_sats=7..8`, `gps_hdop≈0.95..1.98`, and fresh `gps_age_ms` appeared in
  many lines.
- The rover/GPS became close enough to the target. `target_distance_m` decreased
  from around `45..55` m to `27.1`, `25.4`, `23.5`, `21.1`, `18.8`, and
  `18.5` m. `distance_allowed=true` was observed once below
  `max_target_distance_m=30.0`.
- The run was still blocked: mode stayed mostly `MANUAL`, `auto_sw=false`,
  `timeout_ok=false`, `safety_ready=false`, and candidate commands remained
  zero.
- A brief PPM/failsafe-like glitch appeared with `mode=FAILSAFE`,
  `rc_ok=false`, `steer_us≈495`, `throttle_us≈2504`, and
  `control_source=STOP`; keeping `STOP` is the correct safe behavior.
- This is partial progress and a safe blocked validation, not a successful AUTO
  candidate dry-run.

Timeout semantics update:

- The single-waypoint experiment now starts the timeout window on AUTO entry
  rather than at boot or during MANUAL waiting.
- Leaving AUTO resets the AUTO entry timestamp.
- MANUAL no longer consumes the AUTO candidate timeout.
- USBDBG now prints `timeout_source=auto_entry`, `auto_entry_ms`,
  `auto_elapsed_ms`, `timeout_limit_ms`, and `timeout_ok`.
- Next outdoor dry-run should verify `AUTO_READY`, `active_gps_ready=true`,
  `dryrun_ready=true`, `distance_allowed=true`, `timeout_ok=true`,
  `safety_ready=true`, and nonzero candidate commands while
  `AUTO_MOTION_ARMED=0` keeps final outputs at zero.

GPS readiness and stale-coordinate update:

- USBDBG now splits the old ambiguous `gps_fix` meaning into
  `gps_location_valid`, `gps_location_fresh`, `gps_age_ok`, `gps_sats_ok`,
  `gps_hdop_ok`, `gps_ready`, and `gps_block_reason`.
- `gps_ready` remains the stricter motion-level field. It requires valid
  location, fresh age, enough satellites, and good HDOP.
- USBDBG prints `gps_stale_ms`, `gps_min_sats`, and `gps_max_hdop`.
- If motion-level `gps_ready=false`, operational `gps_lat` and `gps_lon` print
  `NA`. In the single-waypoint experiment with `AUTO_MOTION_ARMED=0`,
  `target_distance_m` and `target_bearing_deg` may still print when
  `gps_dryrun_ready=true`.
- Cached TinyGPS coordinates are printed separately as `gps_cached_lat`,
  `gps_cached_lon`, and `gps_cached_age_ms`.
- The single-waypoint experiment computes target distance and bearing only when
  the active tier is ready: dry-run tier for `AUTO_MOTION_ARMED=0`, motion tier
  for any future armed build.
- The single-waypoint experiment also prints `gps_coord_sane`; positions more
  than the coordinate-sanity limit from the compile-time target block safety.
- NMEA status diagnostics now include `last_rmc_status` for `GPRMC` / `GNRMC`
  and `last_gga_fix_quality` for `GPGGA` / `GNGGA`.

GPS readiness tier update:

- `gps_solution_valid` is true when the location is valid and fresh and, when
  NMEA fix status is available, RMC status is `A` or GGA fix quality is at
  least `1`.
- `gps_dryrun_ready` uses `GPS_DRYRUN_STALE_MS=2000`,
  `GPS_DRYRUN_MIN_SATS=4`, and `GPS_DRYRUN_MAX_HDOP=6.0`.
- `gps_motion_ready` uses `GPS_MOTION_STALE_MS=2000`,
  `GPS_MOTION_MIN_SATS=5`, and `GPS_MOTION_MAX_HDOP=2.5`.
- In the single-waypoint experiment, `AUTO_MOTION_ARMED=0` uses
  `gps_dryrun_ready` to compute target distance/bearing and candidate commands.
- In any future `AUTO_MOTION_ARMED=1` build, `gps_motion_ready` is required.
- `safety_ready_source` reports `dryrun_when_inhibited` or
  `motion_when_armed`.
- HDOP around `5` can be used only for no-motion diagnostics. It is not a floor
  driving approval criterion.

Latest post-timeout-fix GPS no-fix attempt:

- Firmware printed `timeout_source=auto_entry`, `auto_entry_ms=NA`,
  `auto_elapsed_ms=NA`, `timeout_limit_ms=15000`, and `timeout_ok=true`, so the
  previous MANUAL-wait timeout issue appears improved.
- Target override was confirmed with `target_override_enabled=true`,
  `target_source=compile_time`, `target_lat_macro=35.5708340`,
  `target_lon_macro=129.1869576`, `target_lat=35.570834`,
  `target_lon=129.186958`, and `target_ready=true`.
- RC was in MANUAL: `mode=MANUAL`, `auto_sw=false`, `mode_us≈1000..1001`, and
  `control_source=RC_MANUAL`.
- GPS UART was alive because `gps_chars` increased continuously.
- GPS fix was not acquired: `gps_fix=false`, `gps_lat=NA`, `gps_lon=NA`,
  `gps_sats=0`, `gps_hdop=99.99`, and `gps_age_ms=NA`.
- Therefore `target_distance_m=NA`, `distance_allowed=false`,
  `safety_ready=false`, candidate commands were zero, and final outputs were
  zero.
- This is a safe blocked validation. The current blocker is GPS satellite fix,
  not timeout, target override, or RC mode mapping.

Latest GPS-only Serial2 probe:

- `firmware/gps_uart_probe` was built and uploaded with
  `GPS_PROBE_MODE=2` and `GPS_PROBE_BAUD=9600`.
- `Serial2/9600` received continuous NMEA characters, so GPS UART wiring and
  baudrate are not the current blocker.
- Most lines showed no usable fix: RMC status `V`, GGA fix quality `0`,
  `sats=0`, `hdop=99.99`, and either `fix=false` or stale cached TinyGPS++
  coordinates.
- A few short bursts showed RMC status `A`, valid lat/lon, `sats=4..5`, and
  `hdop≈1.77..2.48`, but the state returned quickly to RMC `V` / GGA quality
  `0`.
- Treat this as intermittent GPS satellite acquisition. It is not a target
  override issue, RC issue, or timeout issue.

GPS fix recovery after placement change:

- After moving the rover/GPS farther outdoors with clearer sky view, the same
  `Serial2/9600` probe transitioned from `NO_FIX` through `INTERMITTENT_FIX`
  to `STABLE_FIX`.
- Latest stable lines showed `current_valid_fix=true`, RMC `A`, GGA fix
  quality `2`, `sats=9`, `hdop=3.56`, `age_ms≈85..89`, lat/lon around
  `35.57029,129.187078`, and `valid_fix_seconds_consecutive=58..60`.
- The GPS RF issue is now attributed primarily to rover/GPS placement and sky
  view, not UART, target override, RC mode mapping, or timeout semantics.

Main-controller outdoor gate recovery:

- With the rover farther outdoors, main-controller GPS readiness also recovered:
  `gps_location_valid=true`, `gps_location_fresh=true`,
  `gps_solution_valid=true`, `gps_dryrun_ready=true`,
  `gps_motion_ready=true`, `gps_ready=true`, `gps_block_reason=OK`, RMC `A`,
  GGA quality `2`, `gps_sats≈9..11`, and `gps_hdop≈1.46`.
- AUTO entry was verified with `mode=AUTO_READY`, `auto_sw=true`,
  `mode_us≈2001..2002`, `timeout_source=auto_entry`, and `timeout_ok=true`.
- `AUTO_MOTION_ARMED=0` and `auto_motor_inhibit=true` kept
  `final_left_cmd=0.000` and `final_right_cmd=0.000`.
- The prior nearby waypoint candidate dry-run was incomplete because the
  compile-time target was stale: target `35.5702838,129.1869899` versus
  current GPS around `35.57050,129.18736` produced `target_distance_m≈41`,
  which exceeds `max_target_distance_m=30.0`. Therefore
  `distance_allowed=false`, `safety_ready=false`, and candidate commands
  stayed zero.

No-motion AUTO waypoint dry-run complete:

- A follow-up run used a nearby compile-time target:
  `35.5705010,129.1872696`.
- MANUAL confirmed GPS readiness and nearby target range:
  `gps_location_valid=true`, `gps_location_fresh=true`,
  `gps_solution_valid=true`, `gps_dryrun_ready=true`, RMC `A`, GGA quality `2`,
  `gps_sats≈7..9`, `gps_hdop≈1.28..1.56`,
  `target_distance_m≈8.4..15.2`, and `distance_allowed=true`.
- AUTO entry was verified with `mode=AUTO_READY`, `auto_sw=true`,
  `mode_us≈2001`, `timeout_source=auto_entry`, and `timeout_ok=true`.
- The dry-run safety gate passed: `safety_ready=true`.
- Candidate autonomous commands were produced:
  `candidate_left_cmd=0.100`, `candidate_right_cmd=0.100`.
- Final motor output remained inhibited as required:
  `AUTO_MOTION_ARMED=0`, `auto_motor_inhibit=true`,
  `final_left_cmd=0.000`, `final_right_cmd=0.000`.
- Some AUTO lines still reported motion-level `gps_ready=false` /
  `gps_block_reason=BAD_HDOP`. This is acceptable only in
  `AUTO_MOTION_ARMED=0` when `gps_dryrun_ready=true` /
  `active_gps_ready=true`; it is not valid for real motion.

Autonomy block:

- Outdoor GPS recovery is complete for dry-run.
- No-motion AUTO waypoint dry-run is complete.
- Do not proceed to floor driving from this result alone.
- A one-second RMC `A` burst is not enough. Require sustained usable fix fields:
  RMC `A` or GGA fix quality `>=1`, nonzero satellites, acceptable HDOP, fresh
  age, and no immediate fallback to RMC `V` / GGA quality `0`.
- TinyGPS++ cached lat/lon after RMC returns to `V` must not be used for target
  distance or candidate commands.
- Next step is wheel-off-ground bench testing with a strict safety procedure.
  Floor driving remains blocked.

## Safety Rules

- No real autonomous motion in this mode.
- AUTO computes readiness only.
- Switching RC back to MANUAL must immediately return to RC manual behavior.
- If RC is invalid, firmware must stop outputs and enter failsafe behavior.
- HC-12 is not used in this fixed-wiring dry-run mode.
- Motor tests remain wheel-off-ground.

## Future Real Autonomy Requirements

Next milestone:

- Prepare a wheel-off-ground bench test. Keep the rover physically lifted,
  verify RC manual override and STOP/failsafe first, use the same nearby-target
  procedure, and do not move to floor testing until bench logs prove the exact
  expected behavior. Continue IMU electrical diagnostics separately, but do not
  block GPS+RC bench preparation on IMU availability.
- Keep the waypoint target small and explicit when motion work resumes.
- Require GPS readiness, known GPS body-frame placement, heading/attitude plan,
  RC override, STOP/failsafe checks, and wheel-off-ground validation before any
  ground-contact test.
- Do not jump directly to full coverage/lawnmower execution.

Before implementing waypoint following:

- define GPS fix and age requirements;
- define heading source and BMI160 integration plan;
- define STOP/override behavior for every state;
- define path and waypoint acceptance criteria;
- define low-speed test procedure;
- log all GPS, RC, mode, command, target, distance, and bearing fields;
- verify behavior with wheels off ground before any ground-contact test.

Real waypoint following must be introduced as a separate milestone, not by
expanding the dry-run mode directly into motion.

## Path-Following Dry-Run (Breadboard Stage)

A firmware-side path-following dry-run is now available behind
`PATH_FOLLOWING_DRYRUN=1` for safe breadboard/indoor development. It is the
companion to the station path-planning preview (`tools/path_planning_preview.py`).

- Computes per-waypoint distance, bearing, heading (from GPS course-over-ground),
  bearing error, and desired forward/turn/logical/physical commands, and advances
  through a compile-time path on arrival. Indoors it can use a compile-time mock
  position; a mock/static position yields no heading
  (`path_following_block_reason=NO_HEADING`).
- Runs a motor-free HC-12 waypoint protocol (`PING`/`PONG`, `SET_TARGET`,
  `STATUS`, `ESTOP`, `CLEAR`) on `Serial3`/`Serial1`. `SET_TARGET` updates a
  dry-run target only.
- Guarded physical execution exists but is disabled by default: motors stay
  neutral unless all four motion gates plus `PATH_FOLLOWING_MODE_CHANNEL_STABLE`
  are set and every runtime gate passes, under hard forward/turn caps and a
  500 ms latch-stop.

This is still not real autonomous waypoint following. Do not enable physical
output until the RC/PPM Manual/Auto channel holds reliably and an IMU/GPS heading
source is validated (calibration + drift). IMU `0x69`/`0x6F` is signal-only for now.

## IMU Heading Diagnostic Stage (Breadboard -> Outdoor)

The rebuilt breadboard circuit made the IMU and HC-12 reliable, so the next stage
adds IMU heading *diagnostics* (not control) ahead of outdoor validation.

- `firmware/imu_probe` now does gyro-bias calibration, motion detection, and
  relative-yaw integration with configurable axis/sign.
- `firmware/openrb_robot_controller` with `IMU_ENABLE=1` reads the IMU read-only
  in the path-following dry-run and prints yaw + a seeded GPS-course-vs-IMU-yaw
  delta comparison (`heading_agreement_diag`, `heading_agreement_error_deg`).
- IMU yaw is relative and drifts; it is diagnostic-only and never drives motors.
  The plan to qualify it as a heading source: validate raw signal -> calibrate
  bias -> find axis/sign -> integrate relative yaw -> compare delta vs GPS
  course-over-ground outdoors -> only then guard it for path following.

Scope note: UI and ROS2 are optional. ROS2 should not be over-prioritized
because the director plans to try ViAM over the summer, which may replace or
reduce the value of a ROS2 integration. Keep the core protocol, planning, and
firmware dry-run independent of ROS2 so either path stays open. The priority is
physical path planning / path-following validation with the safety gates intact.
