seonukkim/gps_hc12_robot/docs/figures/generated/figure_captions.md

# Generated Figure Captions

Generated by `python3 scripts/analysis/generate_all_figures.py`.
Captions describe what each figure shows without treating mock or schematic data as measured results.

## fig_system_overview.png

- Script: `scripts/analysis/generate_system_figures.py`
- Data source: mock schematic derived from repository architecture, protocol, and safety docs
- Recommended use: System architecture section: introduce station, radio, rover, RC, GPS, and safety boundaries.
- Caption: Repository-derived schematic of the current pre-ROS2 system concept. It shows the intended station, radio, rover, RC, GPS, and motor boundaries without claiming completed end-to-end autonomy.

## fig_control_flow.png

- Script: `scripts/analysis/generate_system_figures.py`
- Data source: mock schematic derived from repository architecture, protocol, and safety docs
- Recommended use: Control architecture section: explain planner-to-station-to-rover flow and safe station defaults.
- Caption: Control-flow schematic for the current Python prototype. The diagram separates offline planning from runtime station behavior and highlights heartbeat/STOP defaults.

## fig_state_machine.png

- Script: `scripts/analysis/generate_system_figures.py`
- Data source: mock schematic derived from repository architecture, protocol, and safety docs
- Recommended use: Safety design section: summarize rover-side state logic and STOP/failsafe behavior.
- Caption: Repository-derived safety state-machine schematic based on current USB debug state fields and documented safety boundaries. It is a design summary, not formal verification.

## fig_ab_region_definition.png

- Script: `scripts/analysis/generate_path_figures.py`
- Data source: mock mission: data/mock_runs/example_20260503_1801/waypoints.csv
- Recommended use: Planning method section: explain manual A/B point selection and planar rectangular region definition.
- Caption: Mock planar work-region definition from operator-selected A/B points. The shaded rectangle and offsets illustrate the current planning assumption, not a validated hull survey.

## fig_lawnmower_path_preview.png

- Script: `scripts/analysis/generate_path_figures.py`
- Data source: mock mission: data/mock_runs/example_20260503_1801/waypoints.csv
- Recommended use: Planning/results section: show the generated coverage pattern before hardware execution.
- Caption: Mock lawnmower coverage preview generated by the ROS-independent Python planner. The sequence shows the intended coverage geometry only; it is not an autonomous field result.

## fig_waypoint_sequence.png

- Script: `scripts/analysis/generate_path_figures.py`
- Data source: mock mission: data/mock_runs/example_20260503_1801/waypoints.csv
- Recommended use: Planner implementation section: document waypoint ordering and alternating lane traversal.
- Caption: Mock waypoint order for the generated lawnmower path. Labels identify the planner's sequential output and alternating lane direction.

## fig_gps_fix_timeline.png

- Script: `scripts/analysis/generate_gps_figures.py`
- Data source: real log: data/gps_logs/gps_fix_usbdbg_20260503_131914.log
- Recommended use: GPS validation section: show whether the selected log reported fix availability over the capture.
- Caption: GPS fix status over the selected log. For USB debug captures without per-line timestamps, elapsed time is reconstructed from sample order and should be treated as nominal.

## fig_gps_satellites_vs_time.png

- Script: `scripts/analysis/generate_gps_figures.py`
- Data source: real log: data/gps_logs/gps_fix_usbdbg_20260503_131914.log
- Recommended use: GPS validation section: summarize satellite count stability during valid-fix records.
- Caption: Satellite count for records with valid GPS fix in the selected log. No-fix placeholder values are omitted from the plotted series.

## fig_gps_hdop_vs_time.png

- Script: `scripts/analysis/generate_gps_figures.py`
- Data source: real log: data/gps_logs/gps_fix_usbdbg_20260503_131914.log
- Recommended use: GPS validation section: report HDOP trend for valid-fix samples without claiming navigation accuracy.
- Caption: HDOP values for records with valid GPS fix in the selected log. The plot is a log quality summary and does not by itself validate closed-loop path tracking.

## fig_gps_position_scatter.png

- Script: `scripts/analysis/generate_gps_figures.py`
- Data source: real log: data/gps_logs/gps_fix_usbdbg_20260503_131914.log
- Recommended use: GPS validation section: visualize fixed-position spread in local meters.
- Caption: Local-position scatter for valid GPS fixes, converted relative to the first fixed point. This summarizes observed spread in the selected log, not hull-surface localization performance.

## fig_manual_control_timeline.png

- Script: `scripts/analysis/generate_manual_control_figures.py`
- Data source: real log: data/safety_logs/manual_safety_20260503_174504.log
- Recommended use: Safety validation section: show RC/manual input and resulting normalized motor commands.
- Caption: Manual-control timeline from the selected USB debug log. The figure summarizes logged commands only and should be discussed with the wheel-off-ground bench-test constraint.

## fig_failsafe_event_timeline.png

- Script: `scripts/analysis/generate_manual_control_figures.py`
- Data source: real log: data/gps_logs/gps_fix_usbdbg_20260503_131914.log
- Recommended use: Failsafe validation section: show when invalid RC/failsafe/STOP conditions appear in the log.
- Caption: Failsafe-related conditions from the selected USB debug log. The bars show logged state conditions and zero-command intervals; they do not claim full autonomous safety validation.

## fig_control_source_transition.png

- Script: `scripts/analysis/generate_manual_control_figures.py`
- Data source: real log: data/safety_logs/manual_safety_20260503_174504.log
- Recommended use: Control and safety section: document transitions among STOP, RC manual, and other logged sources.
- Caption: Logged control-source transitions over the selected USB debug capture. This figure documents source selection in the log and should not be described as completed ROS2 autonomy.
