seonukkim/gps_hc12_robot/legacy/stage_configs/README.md

Deprecated. Use `configs/physical_path_planning_default.json` and the unified
physical path planner workflow.

These templates record historical numbered stage experiment presets.
