seonukkim/gps_hc12_robot/legacy/stage_tools/README.md

Deprecated. Use `scripts/run_physical_path_planner.sh`.

These modules are preserved only for historical compatibility with old numbered
stage workflows. They are not part of the active field workflow and are not
collected by default pytest runs.
