seonukkim/gps_hc12_robot/data/mock_runs/example_20260503_1801/path_preview.png

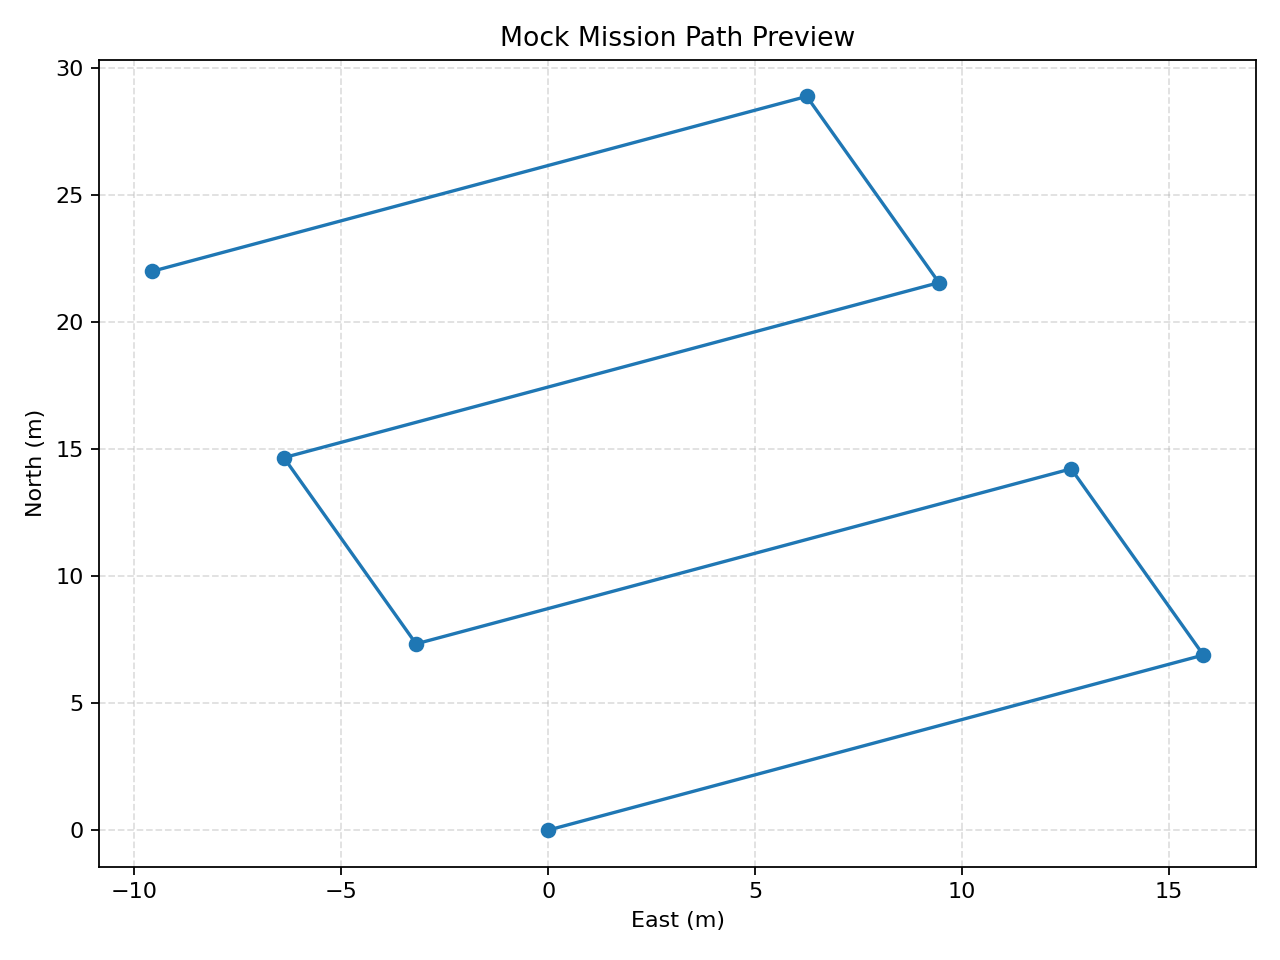
data/mock_runs/example_20260503_1801/path_preview.png
