seonukkim/gps_hc12_robot/docs/figures/generated/fig_ab_region_definition.png

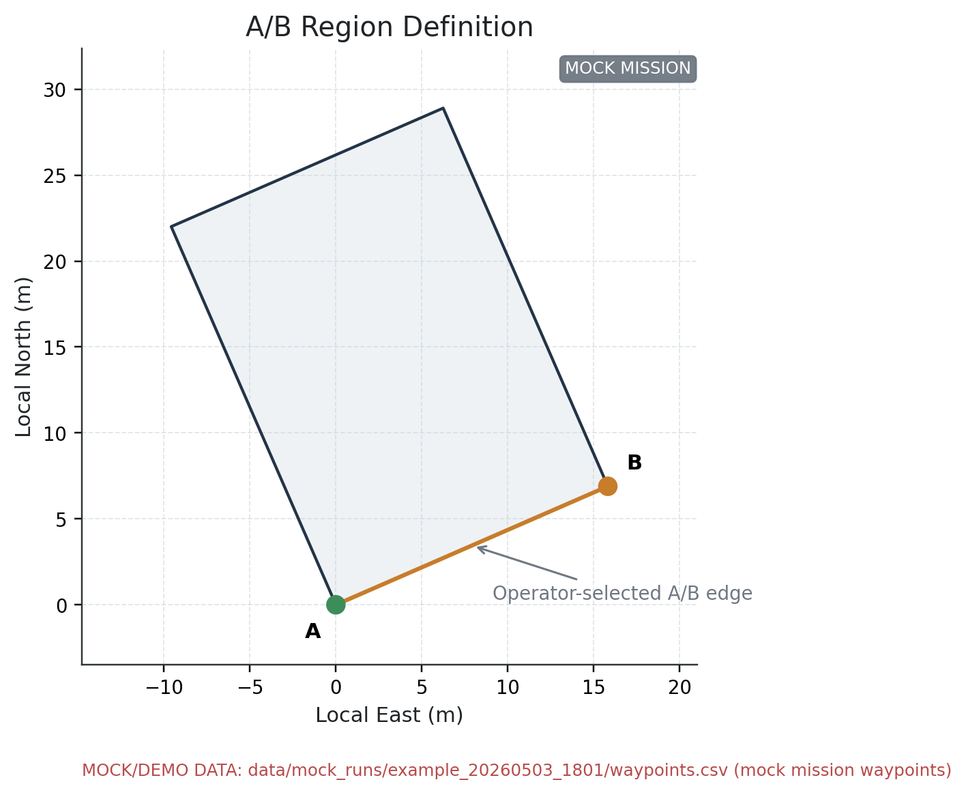
docs/figures/generated/fig_ab_region_definition.png
