seonukkim/gps_hc12_robot/docs/figures/generated/fig_control_flow.png

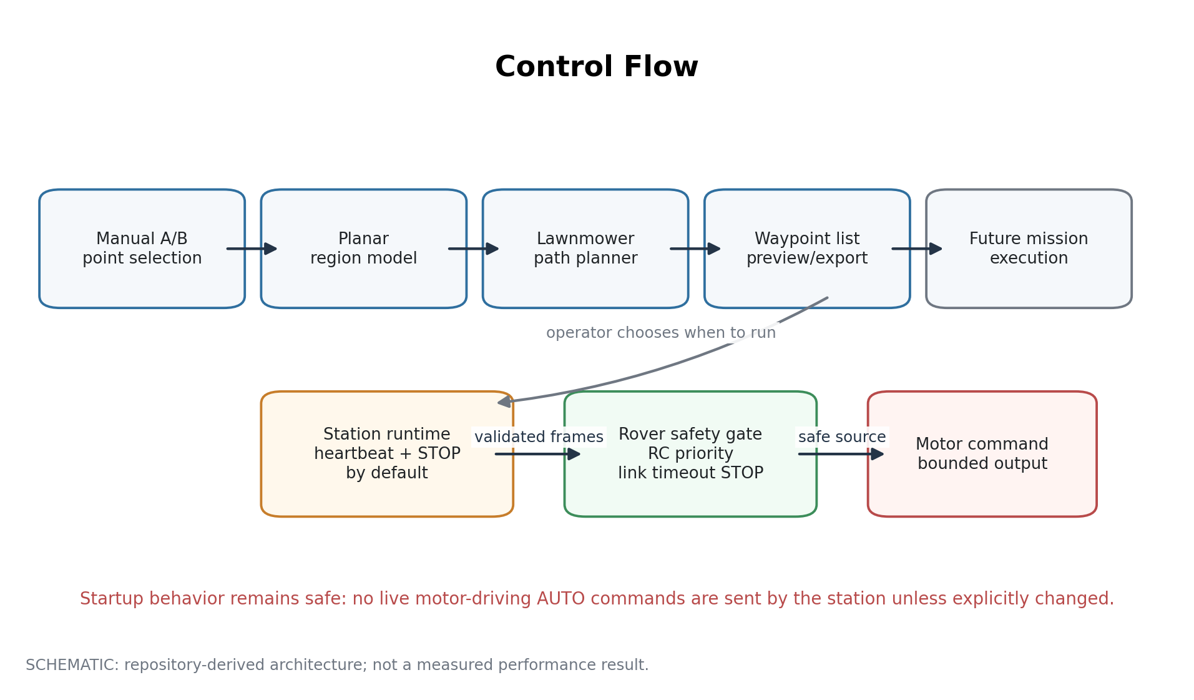
docs/figures/generated/fig_control_flow.png
