seonukkim/gps_hc12_robot/docs/figures/generated/fig_control_source_transition.png

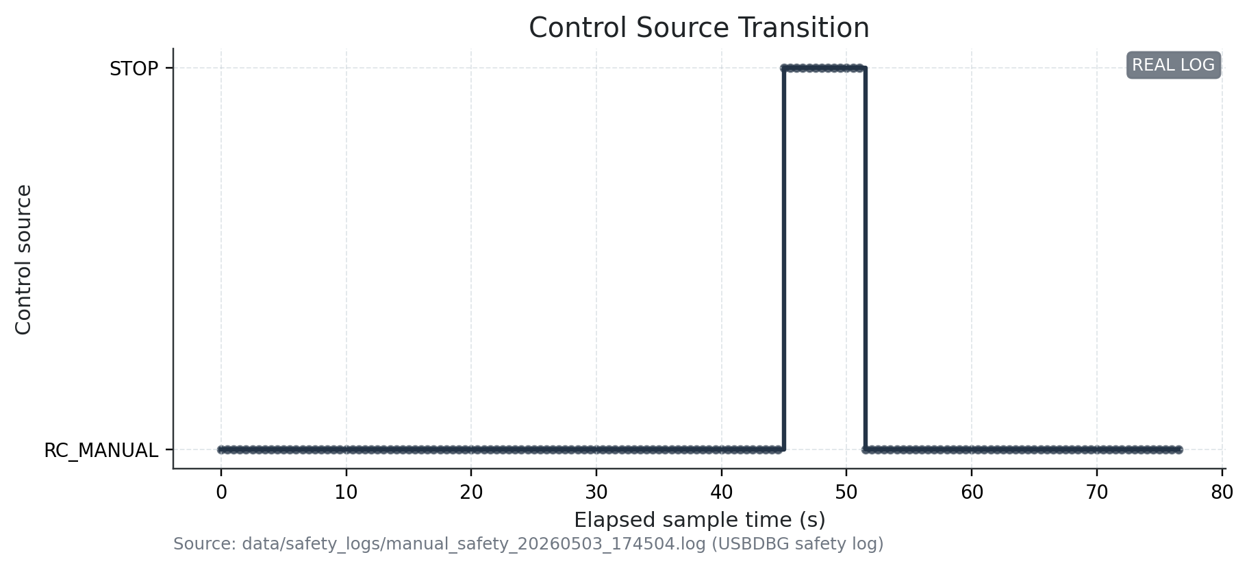
docs/figures/generated/fig_control_source_transition.png
