seonukkim/gps_hc12_robot/docs/figures/generated/fig_failsafe_event_timeline.png

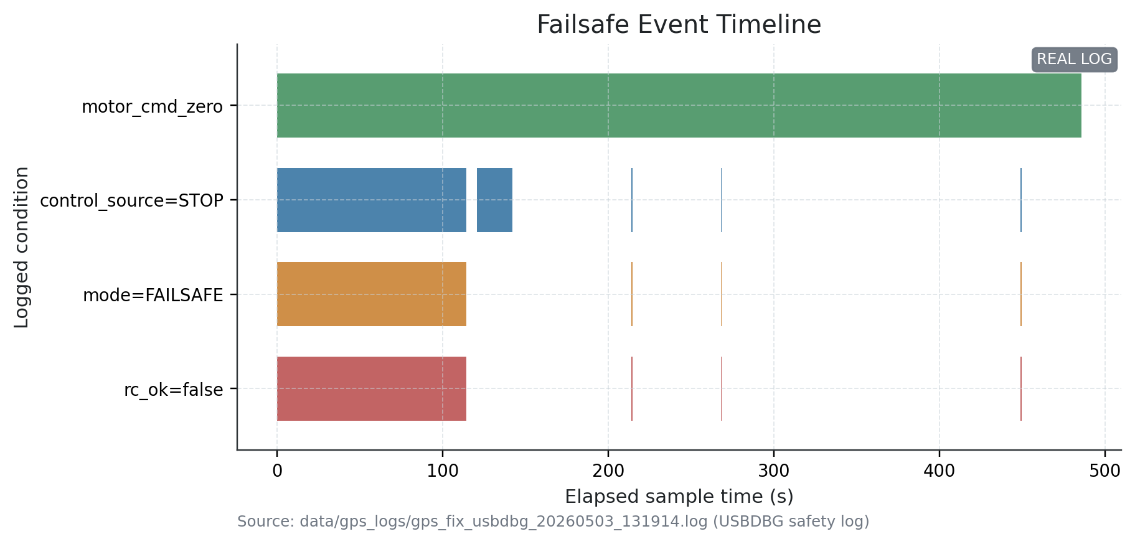
docs/figures/generated/fig_failsafe_event_timeline.png
