seonukkim/gps_hc12_robot/docs/figures/generated/fig_gps_hdop_vs_time.png

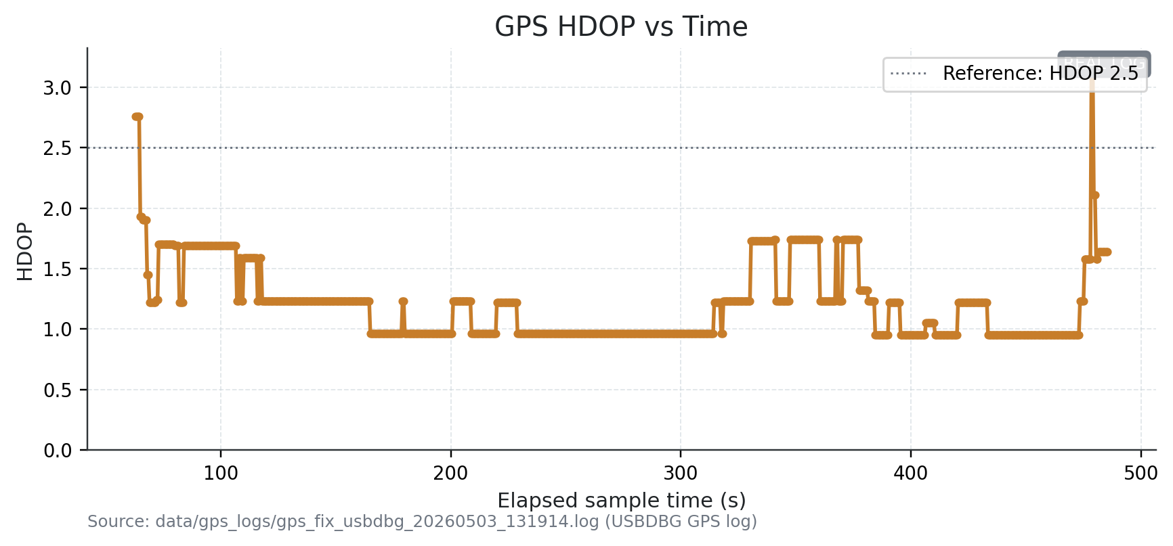
docs/figures/generated/fig_gps_hdop_vs_time.png
