seonukkim/gps_hc12_robot/docs/figures/generated/fig_gps_position_scatter.png

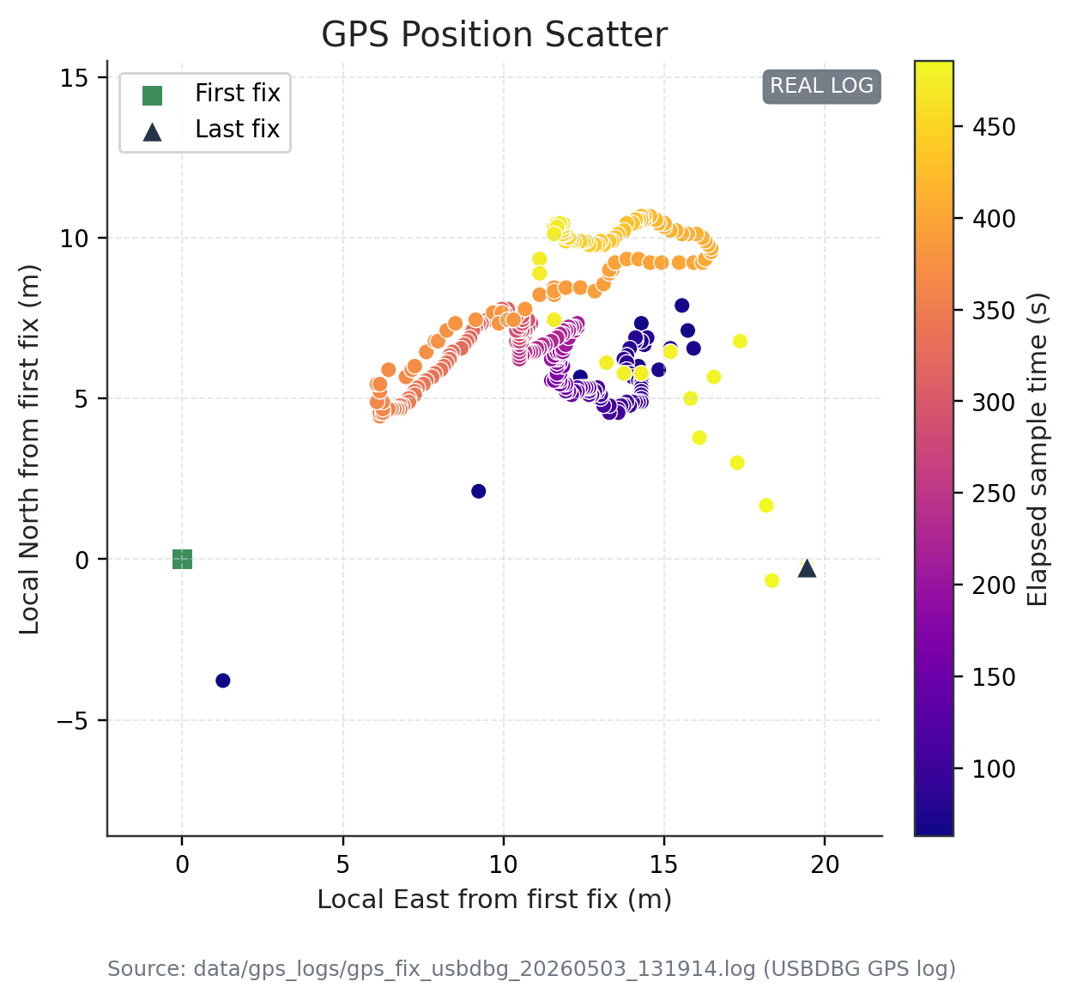
docs/figures/generated/fig_gps_position_scatter.png
