seonukkim/gps_hc12_robot/docs/figures/generated/fig_lawnmower_path_preview.png

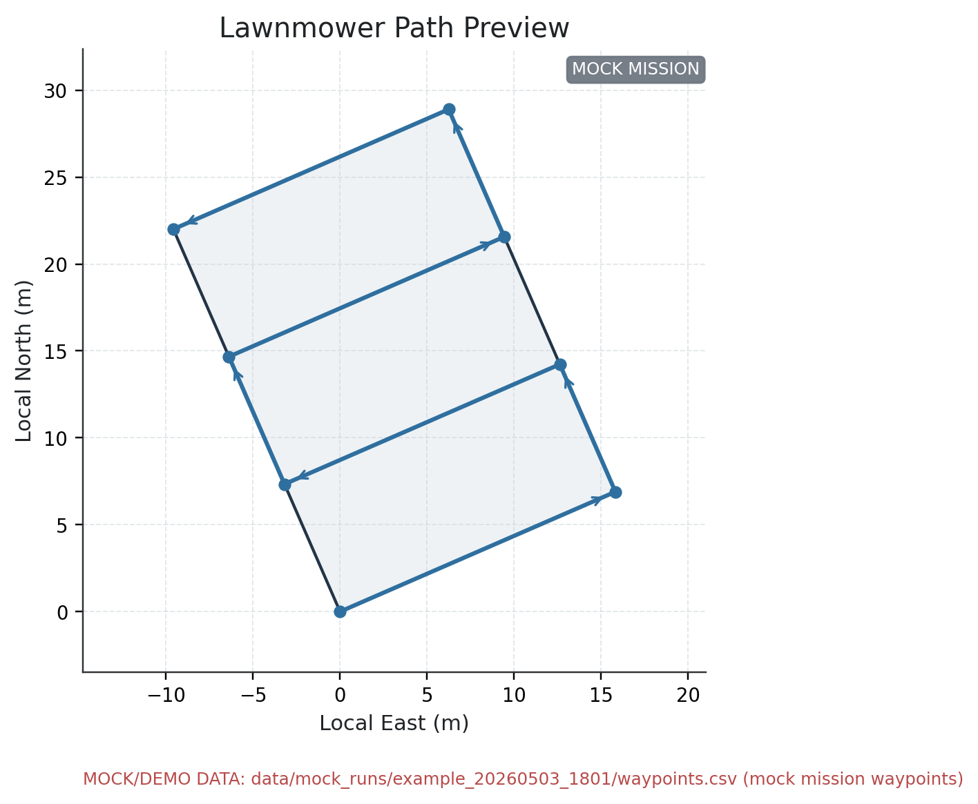
docs/figures/generated/fig_lawnmower_path_preview.png
