seonukkim/gps_hc12_robot/docs/figures/generated/fig_state_machine.png

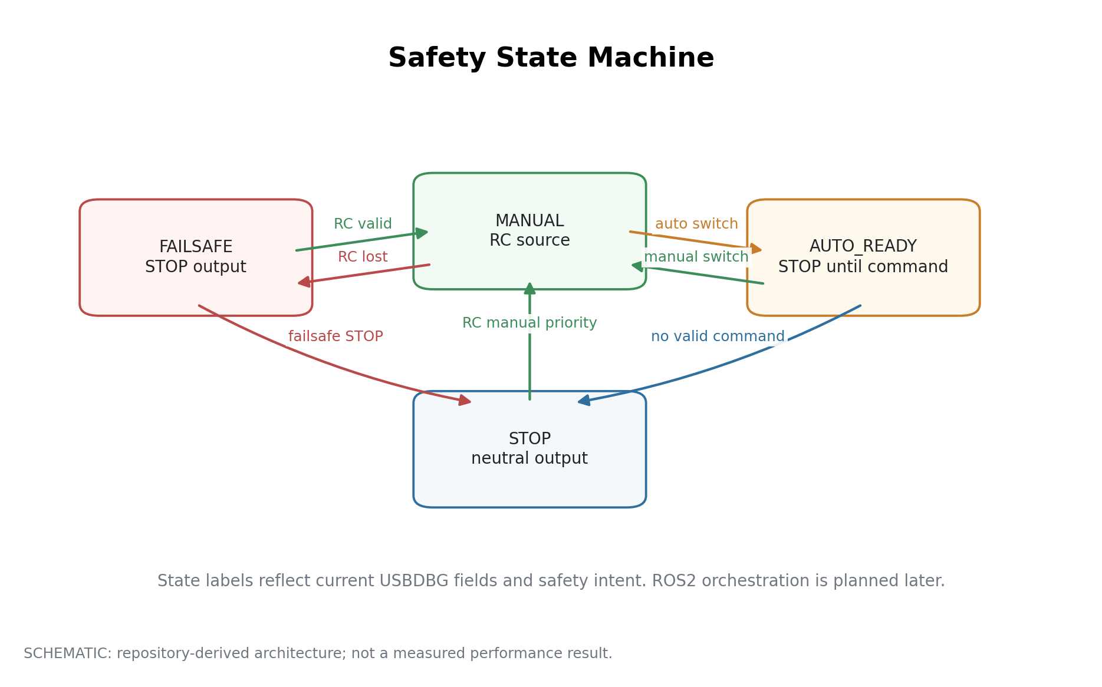
docs/figures/generated/fig_state_machine.png
