seonukkim/gps_hc12_robot/docs/figures/generated/fig_system_overview.png

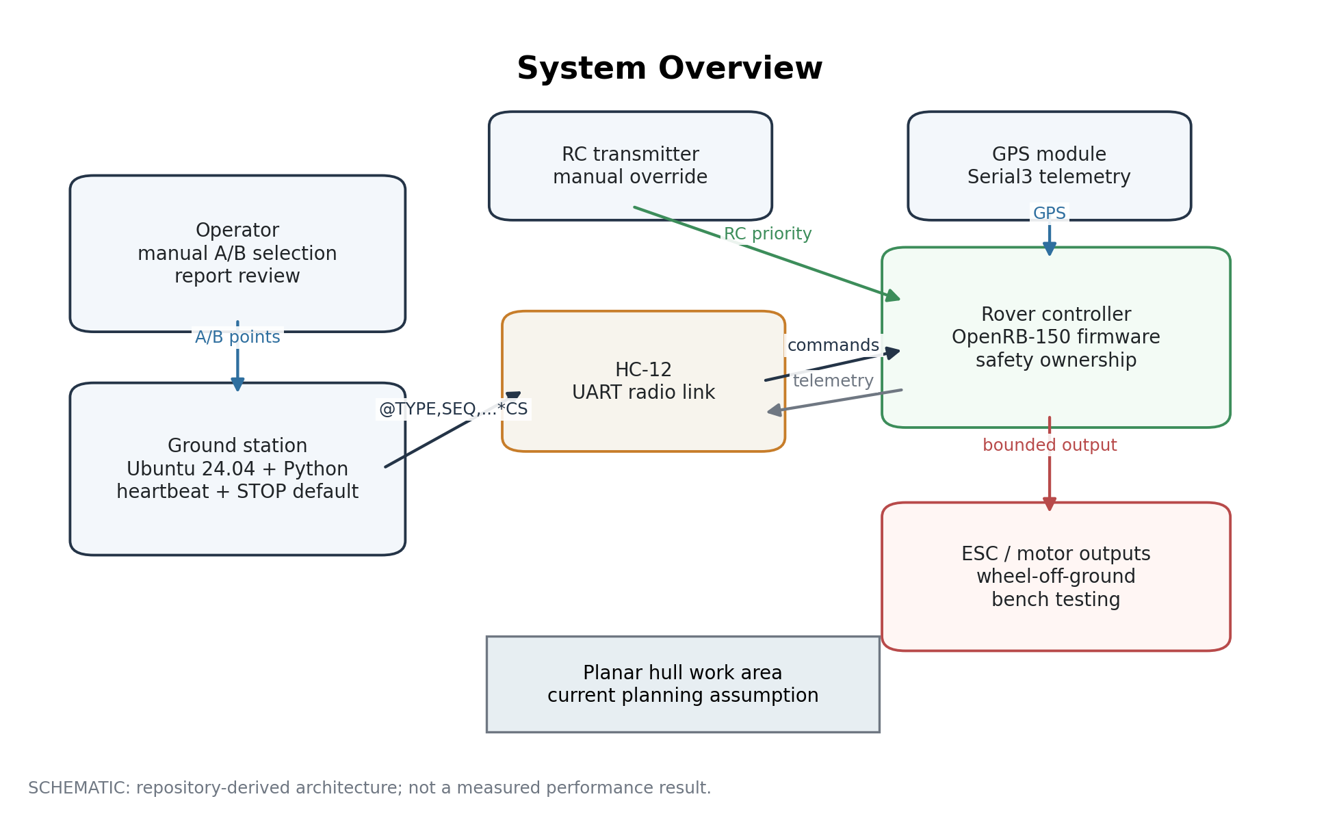
docs/figures/generated/fig_system_overview.png
