seonukkim/gps_hc12_robot/docs/figures/generated/fig_waypoint_sequence.png

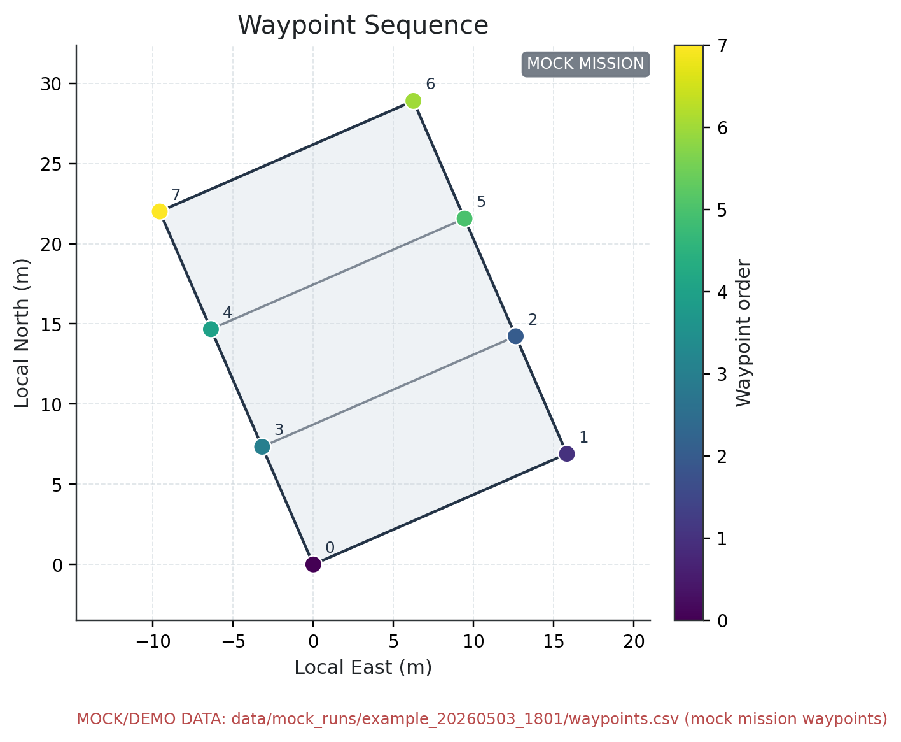
docs/figures/generated/fig_waypoint_sequence.png
