seonukkim/gps_hc12_robot/docs/claude_collaboration_guide.md

# Claude 협업 가이드 (Physical Path Planning)

이 문서는 Claude(또는 다른 AI 어시스턴트)와 함께 이 저장소에서 작업을 이어갈 때
새 세션에 그대로 붙여 넣거나 참조시키기 위한 단일 진입점이다. 마지막 갱신:
2026-06-11 (lawnmower connector 리팩토링 직후).

## 1. 프로젝트 한 줄 요약

OpenRB-150 로버(GPS + BMI160 IMU + HC-12 + PPM RC)를 스테이션(Mac, USB 시리얼)이
감독하며, ㄹ자(lawnmower) 커버리지 경로를 물리적으로 주행시키는 프로젝트.
모든 필드 작업은 단일 진입점을 쓴다:

```bash
bash scripts/run_physical_path_planner.sh <mode> [options]
```

## 2. 새 세션을 시작할 때 Claude에게 먼저 읽힐 것

1. `AGENTS.md` — 저장소 불변 규칙(안전 기본값, STOP 우선, ROS2 금지 등)
2. `docs/claude_collaboration_guide.md` — 이 문서
3. `docs/physical_path_planning_architecture.md` — 모듈 구조와 제어 의미론
4. `docs/README_physical_path_planning.md` — 모드별 런북(ㄹ 필드 런북 포함)
5. `docs/known_issues.md` — 하드웨어 특이사항(특히 회전/모터 항목)
6. 직전 보고서: `docs/reports/interim/2026-06-11_lawnmower_connector_refactor.md`

## 3. 현재 하드웨어 상태(2026-06-11 기준, 코드가 가정하는 사실)

- 바퀴 모터가 비대칭이고 약하다. 특히 우회전이 약함.
- 승인된 모션 캘리브레이션(`outputs/physical_path_planning/calibration/motion_calibration.json`):
  - forward: `A=+0.30, 600ms` / backward: `A=-0.08, 300ms`
  - turn_left_90: `B=+0.24, 700ms` / turn_right_90: `B=-0.08, 600ms`
  - **중요**: 위 turn 펄스는 이름과 달리 실제로는 한 번에 약 15~45도만 돈다.
    실측 각도를 `target_angle_deg`에 저장해야 하며(예: 30), 코드는 그 값으로
    코너당 펄스 수를 계산한다. `assume_90` 정책은 레거시 호환용.
- BMI160 yaw는 상대값이고 드리프트가 있다(절대 나침반 아님). 몇 분짜리 미션
  안에서는 mission heading 기준으로 쓸 만하다.
- GPS는 m급 오차. `--cross-track-correction-threshold-m`은 레인 간격보다
  충분히 작아야 한다(1.2m 간격이면 0.35m 권장).
- RC CH5(모드 스위치)는 MANUAL/AUTO 전환에 쓰이며, USB 감독 모드에서도
  스테이션 루프가 MANUAL 전환을 감지해 즉시 정지한다.

## 4. 핵심 제어 의미론 (2026-06-11 리팩토링 결과)

### 4.1 ㄹ 코너 = turn_step_turn

`coverage_lawnmower`의 레인 전환은 기본적으로 3개 세그먼트로 분해된다:

```
connector_turn(제자리 ~90°) -> step_lane(간격만큼 직진/후진) -> connector_turn(~90° 복귀)
```

- 전진 레인 뒤 스텝은 전진, 후진 레인 뒤 스텝은 후진으로 주행
  (사용자가 원한 "전진→회전→약간 전진→회전→후진→회전→약간 후진→회전" 패턴).
- 각 세그먼트에 `body_heading_deg`(몸체가 향해야 할 방향)와 connector에
  `turn_angle_deg`(부호 있는 회전각, +좌/-우)가 들어 있다.
- 레거시 플랜(`path_connector` 단일 세그먼트)도 그대로 실행 가능.
  새 플랜을 옛 방식으로 만들려면 `--connector-style single_turn`.

### 4.2 connector/보정 회전 = 버스트→정지→측정 사이클

- **모터가 도는 동안에는 yaw를 읽지 않는다.** 펌웨어가 출력 중 MOTOR_TRACE를
  2ms마다 쏟아내 시리얼(115200bps)을 포화시켜, 주행 중 heartbeat가 거의
  도착하지 않기 때문(2026-06-12 필드런에서 연속 피드백 회전 4/4가 10초
  타임아웃으로 실명 회전). 대신:
  1. 남은 각도 ÷ 회전속도 추정(`target_angle_deg/pulse_ms`)의 80%로 버스트
     길이 계산(250~1000ms 클램프) → live SET 1회 → 정지(LIVE_STOP)
  2. 정지하면 trace 홍수가 멈춤 → 안정화된 정지 yaw 측정
  3. 남은 각도 갱신 후 반복. 종료: 허용오차(기본 10°)/과회전(부호 반전)/
     정체(진전 3° 미만 = 모터 멈춤·역방향)/REJECT/MANUAL/시간상한
     (`--max-connector-turn-ms` 기본 20초, 보정은
     `--max-heading-correction-ms` 기본 8초).
- 버스트는 펌웨어 안전 길이라 가드 펄스 최대길이(COMMAND_EXCEEDS_MAX_MS,
  업로드 시 구워짐) 문제 없음.
- IMU가 없을 때만 개루프 펄스 폴백: `ceil(|각도|/target_angle_deg)`개,
  펄스당 1000ms로 클램프(횟수는 비례 보정).

### 4.3 heading 기준 = mission (기본)

- 미션 시작 시(첫 레인, 정렬된 상태) yaw 프레임을 한 번 잡고 끝까지 유지.
- 코너에서 덜 돈 각도가 다음 레인의 heading 오차로 그대로 드러나고,
  기존 IMU 제자리 보정 회전이 그것을 고친다.
- 후진 레인은 `body_heading_deg`(주행방향+180)를 유지한다.
- 옛 동작(레인마다 기준 재캡처, 오차 흡수)은 `--heading-reference per_lane`.

### 4.4 AUTO/MANUAL 스위치 — 유선(auto-relative-run) vs 무선(rc-auto-pattern)

- **유선**: auto-relative-run은 두뇌가 스테이션(Python)에 있다. USB를 뽑으면
  데드맨이 정지시키는 게 설계다(자율 비활성 안전장치).
- **무선**: `rc-auto-pattern` 모드가 별도 펌웨어(full-telemetry-ppm 수동
  프로파일 + IMU + 온보드 ㄹ 패턴)를 업로드한다. CH5 MANUAL=스틱 주행,
  MANUAL 1초 후 AUTO 플립=패턴 1회(타이머 레인 + IMU 피벗), MANUAL 복귀=즉시
  정지. 부팅 시 AUTO면 절대 안 움직임(재무장 필요). 패턴 파라미터는 업로드 시
  컴파일로 구워짐(--lane-ms 등). 업로드 시 예상 경로 PNG
  (rc_auto_pattern_preview.png)를 out-dir에 생성. 온보드 위치는
  IMU+시간 추측항법(GPS 1-2m 오차가 레인급이라 온보드 GPS 보정은 의도적 제외).
- **무선 헤딩 체인(2026-06-12)**: AUTO 시작 순간의 yaw를 기준(RUN_START)으로
  모든 스텝이 **절대 바디 헤딩 목표**를 가진다. 직진은 heading-hold
  (`B = drive_steer_sign × clamp(오차×--heading-kp, ±--heading-hold-max-b)
  + --drive-b-trim`, 전·후진 동일)로 휨을 매 틱 보정하고, 피벗은 남은 각의
  부호로 매 틱 방향을 다시 골라 오버슈트도 되돌아온다(조기 정지 래치 없음).
  상대 목표가 아니므로 코너 잔차·레인 휨이 누적되지 않는다.
- **★주행 중 B 반응 반전(필드 실증 2026-06-12, 절대 잊지 말 것)**: 이 구동계는
  **정지 피벗에서는 +B→+yaw, 주행 중에는 반대(−c·B)**다(전·후진 동일).
  로그 증거: 피벗 2회 수렴(-39.6→+2.5, -50.6→-0.6) vs 주행 3구간 모두 같은
  부호로 발산(-0.3→-148.9 폭주, B 포화 0.25, 모터 0.55 포화). 그래서
  `--drive-steer-sign` 기본 -1 (레인 피드백에만 적용, 피벗 불변). 직진 중
  `heading_err_deg`가 줄어야 정상 — 커지면 부호를 +1로 재업로드해 비교.
  레인 오차가 `--drive-abort-err-deg`(60°)를 넘으면 도넛 방지를 위해 그
  레인을 조기 종료(`DRIVE_ABORT_HEADING` 출력).
- **회전을 진짜 90°로 만드는 3중 장치(2026-06-12)**: ① 관성 보상 조기 정지
  (`--turn-coast-s` 0.15: 정지 명령을 |yaw rate|×0.15s 만큼 일찍) ② 정지·정착
  후 재측정—허용오차 밖이면 같은 피벗 재실행(`--turn-settle-retries` 2,
  `TURN_SETTLE_RETRY` 출력) ③ 정지 시 자이로 바이어스 자동 재영점(아래).
- **자이로 온도 드리프트 자동 보상(2026-06-12)**: 부팅 캘리브레이션 바이어스가
  발열로 이동(-1.3°/s 정지 드리프트 실측). 0.7초 이상 정지가 지속되면
  바이어스를 현재 원시값으로 천천히(τ≈2s) 재추정. 스텝 사이 일시정지 기본
  800ms(--pause-ms)로 매 스텝 경계가 재영점 기회가 된다. "처음엔 잘 되다
  시간 지나면 틀어진다"의 해답.
- **무선 재시작 규칙**: MANUAL→AUTO 플립마다 스텝을 재계산하고 현재 자세를
  새 원점으로 **무조건 0번 스텝부터** 시작한다(이전 부분 실행 재개 없음).
- **무선 RC 유실 유예**: 신호 유실 시 모터는 즉시 정지(failsafe)하되,
  `--rc-loss-grace-ms`(기본 1500) 이내 복귀하면 진행 중이던 스텝을 이어서
  실행(타이머는 유실 시간만큼 시프트). 초과하면 리셋+무장해제 — 다시
  MANUAL(1초)→AUTO 필요(이때도 처음부터). 과거 "직진→회전→약간 직진 후
  멈춤"은 순간 RC 글리치가 런을 즉사시키던 동작이 원인 후보.
- **USB 출력 가드(2026-06-12)**: 모든 디버그 출력은 (a) 호스트 게이트를 최대
  1초에 1번만 평가(코어의 `(bool)Serial`이 호출당 ~10ms일 수 있음), (b) 출력
  소요시간을 측정해 50ms를 넘기면(모니터 방치/포트만 열린 채 리더 죽음) 전체
  출력을 5초 뮤트 후 1패킷 프로브로만 재시도. → 꽂은 상태/뺀 상태/모니터
  멈춤 상태 전부에서 수동 조작이 밀리지 않는다. USBDBG의
  `loop_dt_max_ms`(직전 주기 최악 루프 시간)가 작은데도 조작이 밀리면 원인은
  펌웨어 밖(배터리/모터·ESC 열/송신기)이다.
- **발열 저감**: `LOOP_IDLE_WFI`(기본 1)로 루프 사이 CPU를 인터럽트 대기
  절전(WFI)시킨다(루프 ≥~1kHz 유지, 추가 지연 ≤1ms). busy-spin 자체 발열
  제거 — 보드가 "많이 뜨겁다"(2026-06-12 보고) 완화책. 잔여 발열은 GPS/HC-12/
  수신기 전원 레일과 날씨 몫이므로 그늘/휴식/배터리 점검이 함께 필요.
  피벗은 1.5초간 회전 5° 미만이면 B를 30%씩 증폭(상한 0.6, 방향 반전 시
  기본값 복귀) — 정지마찰/배터리 강하 자동 보상.

### 4.4.1 유선 AUTO/MANUAL (auto-relative-run)

- MANUAL→AUTO: 현재 GPS 위치를 원점으로 상대 ENU 플랜을 1회 실행.
- AUTO→MANUAL: 펄스 윈도/보정 회전 중에도 감지하여 즉시 정지
  (`stop_reason=USER_SWITCHED_TO_MANUAL`), RC 수동 조작으로 복귀.
- 다시 실행하려면 명령을 재실행(AUTO 플립마다 1회 실행, 현재 위치 재앵커).

## 5. 실행 결과를 판독하는 법 (트러블슈팅 결정 트리)

실행 후 `outputs/.../stop_correct_go_trace.csv`를 본다.

1. **코너가 둥글다/덜 돈다** → `phase=connector` 행에서
   `applied_turn_delta_deg` vs `requested_turn_angle_deg` 비교.
   - `turn_pulse_index`가 `turn_pulse_budget`까지 갔는데 미달이면 모터 출력
     부족: B를 키우거나 ms를 늘리고 `target_angle_deg` 재실측.
   - `turn_measured_by_imu=False`면 IMU 미수신 문제부터 해결.
2. **레인이 비스듬하다** → 레인 행 `heading_error_deg`가 큰데
   `phase=correction`이 안 나오면 `--heading-correction-threshold-deg`가
   너무 큰 것. `heading_reference`가 `per_lane`이면 오차가 0으로 숨겨진다.
3. **레인을 벗어나도 복귀 안 함** → `cross_track_error_m` 대비
   `--cross-track-correction-threshold-m`이 큰 것(레인 간격보다 작게).
4. **회전이 끝없이 돈다/너무 오래 돈다** → `turn_timed_out=True`면 모터가
   목표각까지 못 돈 것(`--max-connector-turn-ms` 내). B를 키우거나 배터리 확인.
   `turn_overshoot=True`가 코너마다 나오면 회전이 너무 빠른 것 → B 축소.
5. **A와 B가 동시에 나가는 코너** → connector는 항상 `a=0.000`이어야
   한다(`move_a_cmd` 확인). 아니면 calibration JSON의 turn 항목 `a`를 0으로.
6. **첫 청크 만에 레인이 "완료"됨 / cte가 수 m** → 플랜 원점과 로봇 위치
   불일치(오래된 plan-dir) 또는 GPS 표류. 실행은 `run`(현재 위치 재앵커)으로,
   `--max-gps-jump-m 1.2`로 순간이동 보정 거부(`gps_jump_rejected` 카운트 확인).
7. **rc-auto-pattern에서 AUTO/수동 모두 무반응** → 모니터에서
   `ppm_decode_reason=PPM_SYNC_ONLY_NO_CHANNELS`, `mode=FAILSAFE`인지 확인.
   PPM 디코드 설정이 수신기와 불일치한 것 — `--profile`을 바꿔 재업로드
   (기본 full-telemetry-ppm = 감독 펌웨어와 동일한 검증된 디코드;
   rc-mix-ppm의 FALLING 에지는 2026-06-12에 채널 디코드 실패 확인).
   정상 게이트: `ppm_frame_count` 증가 + MANUAL에서 `mode=MANUAL`.
8. **코너에서 REJECT: COMMAND_EXCEEDS_MAX_MS** → 가드 펄스 길이가 펌웨어
   상한(업로드 시 결정) 초과. 현행 코드는 코너를 live-drive로 돌므로 발생하면
   안 됨 — 발생 시 개루프 폴백(IMU 부재) 여부와 turn_mode 확인.
9. **무선(rc-auto-pattern)에서 직진이 한쪽으로 휜다** → 모니터의
   `heading_err_deg`가 줄지 않으면 `--heading-kp`를 0.02~0.03으로,
   일정한 기계적 편향이면 `--drive-b-trim`(좌로 휘면 음수)을 추가해 재업로드.
10. **무선 패턴이 몇 스텝 만에 영영 멈춘다** → RC 글리치로 grace 초과 여부
   확인(`rc_loss_grace_ms` 늘려 재업로드). 재개하려면 MANUAL(1초)→AUTO —
   이때는 의도적으로 처음부터 재시작된다.
11. **꽂아두면/모니터 띄워두면 수동이 밀린다** → USBDBG `loop_dt_max_ms`와
   `usb_print_stall_count` 확인. stall 카운트가 증가하면 호스트가 포트를 열고
   읽지 않는 상태(출력 가드가 자동 뮤트하므로 구버전 펌웨어인지부터 확인).
   `loop_dt_max_ms`가 작은데도 밀리면 펌웨어 밖: 배터리 전압, ESC/모터 온도,
   송신기 배터리 순으로 점검(전원 끄고 식힌 뒤 회복되면 열/배터리 확정 —
   2026-06-12 현장에서 과열 해소 후 수동 정상 확인됨).
12. **직진 중 heading_err_deg가 점점 커진다(폭주)** → 조향 부호 문제.
   기본 `--drive-steer-sign -1`이 이 로버의 실측값. 만약 -1에서도 발산하면
   +1로 재업로드해 비교(§4.4 ★항목). `DRIVE_ABORT_HEADING`이 자주 뜨면
   kp를 줄이거나 표면 상태(한쪽 바퀴 걸림)를 확인.
13. **회전이 90°가 안 된다** → 모니터에서 TURN 후 PAUSE의 `heading_err_deg`
   확인: tol(8°) 이내면 정상 동작이고 시각적 차이는 시작 자세 문제.
   `TURN_SETTLE_RETRY`가 매번 2회 다 소진되면 coast가 큰 것 —
   `--turn-coast-s`를 0.2~0.25로. 정지 상태에서 yaw가 흘러가면(±0.5°/s 이상)
   재영점이 작동할 정지 시간이 부족한 것 — `--pause-ms`를 1000으로.
14. **PPM 카운터 진단**: `ppm_incomplete_frames`/`ppm_short_rejects`가 운용 중
   계속 늘면 수신기 신호선 노이즈(실측: 2µs 글리치). 배선/전원 분리 점검.
   `ppm_age_ms=42949672xx`(음수 언더플로)는 구펌웨어 표시 버그 — 최신 펌웨어로.

summary.json에서 보는 핵심 카운터:
`connector_turn_count / connector_completed_count / connector_incomplete_count`,
`heading_correction_count`, `turn_calibration_angle_policy`,
`turn_left_90_target_angle_deg`, `turn_right_90_target_angle_deg`,
`turn_angle_warnings`.

## 6. 코드 변경 시 지켜야 할 것 (Claude용 체크리스트)

- 모든 summary에 `ready_for_full_path_following=false`가 유지되어야 한다
  (`checks.assert_not_ready_for_full_path_following`이 강제).
- 기존 CLI 플래그 의미를 바꾸지 말 것. 새 동작은 새 플래그 + 안전한 기본값.
- 시리얼이 필요 없는 로직은 순수 함수로 빼고 `FakeSerial`
  (`tests/test_ppp_stop_correct_go.py` 패턴)으로 테스트를 붙인다.
- 검증 순서: `uv run pytest -q` 전체 통과 →
  `bash -n scripts/run_physical_path_planner.sh` →
  `uv run python -m tools.physical_path_planning.cli <mode> --help` →
  필요 시 `/tmp`에 preview 스모크 실행(PNG 확인).
- outputs/ 아래 산출물과 raw 로그는 커밋하지 않는다.
- 회전/방향 코드를 바꾸기 전 `docs/known_issues.md`의 방향 매핑 항목을 읽는다.

## 7. git 워크플로

```bash
# 스테이션(Mac)에서 최신 작업 받기
cd ~/Desktop/project-lab/gps_hc12_robot
git fetch origin
git checkout claude/epic-rubin-dbha7t   # 이 리팩토링이 들어있는 브랜치
git pull origin claude/epic-rubin-dbha7t

# main에 합쳐졌다면
git checkout main && git pull origin main
```

Claude 원격 세션은 같은 브랜치에 커밋/푸시한다. 필드 테스트 결과(트레이스
CSV, summary)는 필요한 부분만 발췌해 새 세션에 붙여 넣으면 된다.

## 8. 용어 사전 (대화 ↔ 코드)

| 대화 표현 | 코드/문서 용어 |
|---|---|
| ㄹ자 경로 | `coverage_lawnmower` (path_shape) |
| 코너/꺾기 | `connector_turn` 세그먼트, `phase=connector` |
| 약간 전진/후진(스텝) | `step_lane` 세그먼트 (`step_spacing_m` 길이) |
| 작은 회전 펄스 | turn primitive 1회 = `target_angle_deg`만큼 회전 |
| 멈추고-보정-가기 | `--path-control-mode stop_correct_go` |
| 스위치 자동 실행 | `auto-relative-run` (CH5 AUTO 플립) |
| 수동 전환 즉시 정지 | `USER_SWITCHED_TO_MANUAL` abort |
| 진행 기록 | `stop_correct_go_trace.csv`, `summary.md/json` |
