seonukkim/gps_hc12_robot/docs/figures/generated/fig_manual_control_timeline.png

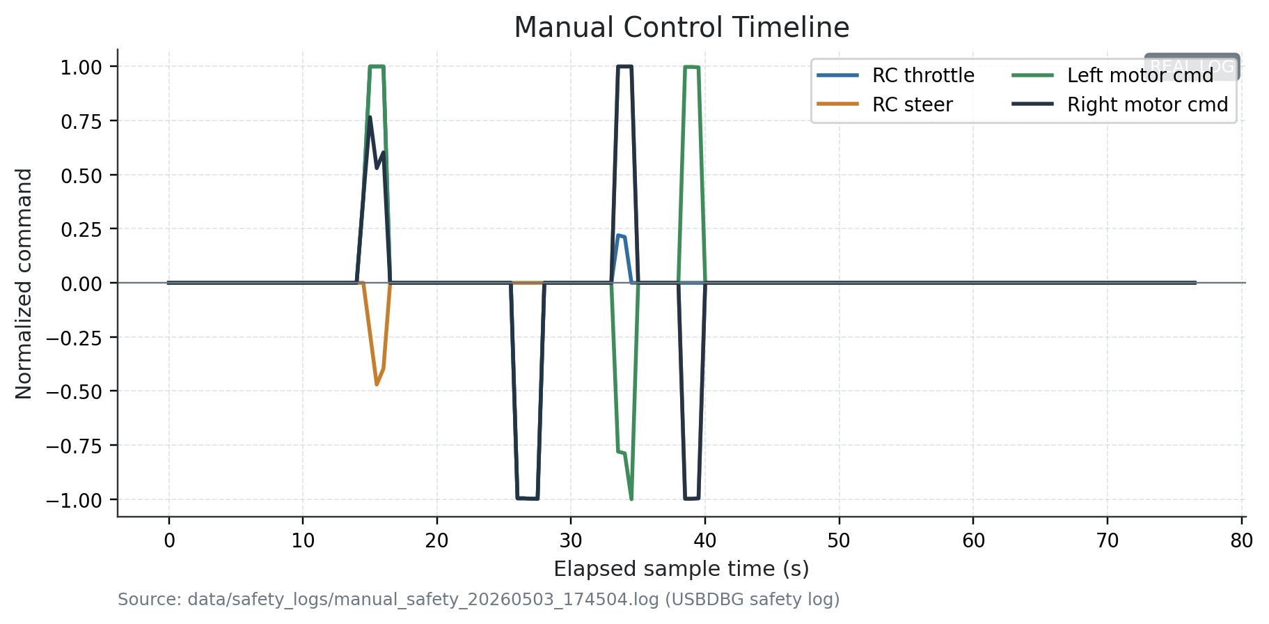
docs/figures/generated/fig_manual_control_timeline.png
