seonukkim/gps_hc12_robot/legacy/stage_tests/README.md

Deprecated. Use tests for `tools/physical_path_planning/`.

These tests cover historical numbered stage modules and are kept outside the
default pytest collection path.
