seonukkim/gps_hc12_robot/docs/known_issues.md

# Known Issues

This file lists known technical gaps and recurring mistakes. Read it before
changing control, protocol, planning, or station workflow code.

## Manual Direction Mapping Is Fragile

Status:

- Current firmware uses `rc-arcade-manual-fwdneg`.
- Neutral USBDBG is verified.
- Working RC sign convention for the current rover/controller is
  `MANUAL_FORWARD_SIGN=-1`, `MANUAL_TURN_SIGN=1`,
  `MOTOR_OUTPUT_SWAP_LR=0`, and `DRIVE_CALIBRATION_ENABLE=0`.
- This is an RC axis sign fix, not a wheel mapping or physical A/B output fix.
- Full straight up/down/left/right wheel-off-ground validation should still be
  repeated after flashing.

Current code:

```cpp
manual_forward_cmd = MANUAL_FORWARD_SIGN * throttle_norm;
manual_turn_cmd = MANUAL_TURN_SIGN * steer_norm;
logical_left_cmd = clamp(manual_forward_cmd + manual_turn_cmd);
logical_right_cmd = clamp(manual_forward_cmd - manual_turn_cmd);
```

Known mistakes:

- changing only throttle sign moved the problem to another diagonal
- after the A/B mapping was fixed, `MANUAL_FORWARD_SIGN=1` made manual
  forward/reverse inverted: pulling drove forward and pushing drove backward
- treating left/right as forward/reverse was wrong
- judging only wheel spin can confuse RC axis mapping with motor/ESC direction

Reference:

- `docs/manual_control.md`
- `docs/field_test_log.md`

## RC Mode Switch Requires Powered Controller/Link

Status:

- A recent outdoor test showed the previous stuck-looking RC issue was caused
  by the station/controller being off.
- After restoring the controller/link, Manual/Auto switching worked again.
- AUTO was verified with `mode=AUTO_READY`, `auto_sw=true`,
  `mode_us≈2001..2002`, and `control_source=STOP`.
- MANUAL was verified with `mode=MANUAL`, `auto_sw=false`,
  `mode_us≈1000..1001`, and `control_source=RC_MANUAL`.
- Manual stick input changed `steer_us` / `throttle_us`, and at least one
  MANUAL line produced nonzero `left_cmd` / `final_left_cmd`.

Diagnostic:

- Use `firmware/rc_channel_probe`.
- Confirm the station/controller is powered on and linked before interpreting
  static channel output.
- Move one stick or switch at a time.
- Record `ch1_us` through `ch8_us`, each channel min/max, and
  `changed_channels`.
- The AUTO candidate is the channel that reaches around `2000 us`.
- Manual/Auto verification requires seeing both ends of the switch travel:
  `mode_us≈1000` for MANUAL and `mode_us≈2000` for AUTO.

Do not repeat:

- Do not assume the physical switch label matches the PPM channel number.
- Do not treat static RC probe channels as a mapping failure until the
  station/controller power and link are confirmed.
- Do not change controller channel mapping based only on panel labels.
- Do not approve AUTO, bench, or floor testing unless USBDBG shows the expected
  Manual/Auto mode values and the relevant safety gates.

## PPM Sync-Only On D6 Is A Receiver Output/Wiring Problem

Status:

- A recent manual-control run showed `ppm_interrupt_edge=FALLING`,
  `ppm_decode_reason=PPM_SYNC_ONLY_NO_CHANNELS`,
  `ppm_edge_count` and `ppm_sync_count` increasing, but
  `ppm_frame_count=0`, `ppm_last_channel_count=0`, `steer_us=0`,
  `throttle_us=0`, and `mode_us=0`.
- This means OpenRB `D6` is receiving periodic sync-like timing edges, but no
  decoded PPM channel intervals.
- The rover correctly remains stopped with `rc_ok=false` and
  `control_source=STOP`.

Interpretation:

- This is not an A/B motor mapping issue.
- This is not a manual direction sign issue.
- This is not solved by changing MANUAL/AUTO channel selection.
- A single PWM receiver channel on `D6` cannot provide CH1 steering, CH2
  throttle, and CH5 mode to a one-wire PPM decoder.

Required next check:

1. Inspect the rover-side receiver, not only the station transmitter panel.
2. Confirm whether the wire going to OpenRB `D6` is connected to a combined
   PPM/SUM output or to an individual PWM channel output.
3. If the receiver supports PPM/SUM, enable that receiver output mode and keep
   the PPM signal on `D6`.
4. If the receiver only provides separate PWM channel outputs, use separate
   wires for CH1, CH2, and CH5 and add/use a separate multi-pin PWM input
   profile.

Do not repeat:

- Do not weaken `rc_ok` or force `control_source=RC_MANUAL` while
  `ppm_frame_count=0`.
- Do not continue changing motor signs or A/B mapping until
  `raw_ch1_us`, `raw_ch2_us`, and `raw_ch5_us` are nonzero and valid.

## AUTO/MANUAL Channel (CH5) Does Not Hold HIGH

Status (2026-05-30):

- A standalone PPM hold test showed receiver CH5 does not hold the AUTO/HIGH
  state: `total_ch5_samples=68`, `ch5_high_auto_like=4`,
  `ch5_low_manual_like=64`, `RESULT=CH5_AUTO_DID_NOT_HOLD`.
- Raw frames look mostly manual-like (`CH5≈1000`) with only brief AUTO blips
  (`CH5≈2001` for a few frames).
- Some frames are misaligned/out of range (`CH1=2617`, `CH3=841`,
  `CH7=1001`, `CH8=1001`), which suggests occasional PPM channel-slip rather
  than a clean switch.
- In the main firmware, raising AUTO briefly enters `AUTO_READY` and then
  `FAILSAFE` because `ppm_age_ms` grows; this is correct failsafe behavior given
  an unstable mode signal.

Impact:

- Physical path following is blocked until a stable 2-position AUTO/MANUAL
  channel is identified and confirmed.
- Path planning preview is allowed; physical path execution is not.

Diagnostic:

- Use `firmware/ppm_channel_map_probe` (read-only; no GPS/HC-12/motors).
- It prints `PPMEVT` lines on each LOW/MID/HIGH transition and `PPMSUM` lines
  every second; capture to a log and run `tools/analyze_ppm_log.py`.
- A usable mode channel must reach both LOW and HIGH and hold HIGH (the analyzer
  reports candidate channels and flags channels whose HIGH does not hold).
- The mode channel is now selectable in the main controller with
  `-DMODE_CHANNEL_INDEX=<0-based index>` (default `4` = CH5, unchanged). USBDBG
  prints `mode_channel_index`, `mode_channel_label`, `raw_mode_channel_us`, and
  `raw_ch1_us`..`raw_ch8_us`.

Do not repeat:

- Do not raise the AUTO command or weaken failsafe to "get past" the unstable
  switch. The failsafe is working as intended.
- Do not change `MODE_CHANNEL_INDEX` until the probe proves another channel is a
  stable 2-position switch.

## Rover Drifts Left/Right During Long Manual Movement

Status:

- known issue
- not the top priority

Likely causes to investigate later:

- motor/ESC calibration mismatch
- wheel traction or mechanical asymmetry
- steering mix imbalance
- surface friction
- heading correction not implemented

Do not hide this by changing path planning. Treat it as a low-level calibration
and control issue after station dry-run workflow is stable.

## GPS Telemetry Schema Mismatch

Firmware currently emits key/value GPS payloads:

```text
fix=1,lat=...,lon=...,sats=...,hdop=...,age_ms=...
```

Python `GPSTelemetry.from_payload()` expects positional fields:

```text
lat,lon,alt,sats,hdop,fix_valid
```

This must be fixed before relying on live station GPS telemetry.

## GPS And HC-12 UART Allocation Conflict

Status:

- GPS UART receive is confirmed on `Serial2` at `9600` with the GPS connected
  to the current central OpenRB connector.
- GPS module baudrate is confirmed as `9600`.
- The central OpenRB connector is confirmed as `Serial2`.
- The purple module appears to be an IMU on an I2C-style connection and should
  not be treated as UART.
- HC-12 appears to be mounted under or behind the OpenRB board and needs its
  UART wiring verified separately.
- GPS cannot be moved.
- HC-12 cannot be moved right now.
- GPS fix succeeded on that path:
  - `lat` around `35.57107`
  - `lon` around `129.1860`
  - `sats` around `5`
  - `hdop` around `1.61-1.62`
- Integrated GPS `Serial2` diagnostic sky test succeeded:
  - `fixed_wiring_gps_serial2_diag=true`
  - `hc12_enabled=false`
  - `gps_chars` increased continuously
  - `gps_fix=true` after moving the external GPS antenna farther outside into
    open sky
  - latitude/longitude, satellites, and HDOP became valid
  - motors remained disarmed/neutral
- The integrated rover firmware currently defines:

```cpp
#define HC12_SERIAL Serial2
#define GPS_SERIAL Serial3
```

Risk:

- GPS and HC-12 cannot both own the same `Serial2` UART during normal rover
  operation.
- If HC-12 shares GPS `Serial2`, simultaneous GPS plus HC-12 bidirectional
  communication may not be possible.
- Do not assume HC-12 shares `Serial2`; audit current wiring from code,
  board inspection, and diagnostics first.
- Keeping the integrated firmware unchanged means integrated GPS telemetry will
  still read from `Serial3`, where current GPS wiring has no bytes.

Decision:

- Previous Option A and Option B UART-rewiring plans are superseded.
- Fixed Wiring Plan:
  - keep GPS on the current central connector / `Serial2`
  - keep HC-12 physically as-is
  - do not move either module
  - audit whether HC-12 is independent from or sharing GPS `Serial2`

Decision table:

| Current HC-12 wiring audit result | Decision |
|---|---|
| HC-12 is independent from GPS `Serial2` | Proceed with integrated GPS on `Serial2` plus HC-12 telemetry after diagnostics confirm both paths can coexist. |
| HC-12 shares GPS `Serial2` | Do not use GPS and HC-12 simultaneously. Use USB/onboard mission flow for GPS-dependent work and mark HC-12 operation blocked by fixed hardware. |

Next software milestone:

- Add an integrated GPS `Serial2` diagnostic firmware mode.
- Audit current HC-12 wiring.
- Run receive-only station telemetry testing only if safe.
- Keep station-side path planning dry-run only.
- The diagnostic mode should report selected GPS UART, raw character counts,
  TinyGPS++ processed characters, fix state, sats, HDOP, lat/lon, and GPS age.
- It must not implement autonomous movement.
- It must not weaken manual control, STOP override, heartbeat timeout, or
  failsafe behavior.

Do not repeat:

- Do not treat `gps_chars=0` in the default controller build as GPS failure
  under current fixed wiring. Default firmware still reads GPS from `Serial3`.
- Do not expect manual driving in `FIXED_WIRING_GPS_SERIAL2_DIAG`; this mode is
  for GPS testing only, disables/ignores HC-12, and forces motors neutral.
- Do not expect HC-12 in fixed-wiring GPS modes. HC-12 remains
  disabled/ignored there because GPS and HC-12 cannot both use the current
  `Serial2` wiring safely.
- Do not connect both OpenRB USB and station USB-serial during OpenRB upload if
  `arduino-cli` selects the wrong upload port.
- If upload fails because it selected `/dev/cu.usbserial-02444963`, unplug the
  station USB-serial and upload with only OpenRB connected.

Next architecture:

- For fixed wiring, implement a future GPS `Serial2` plus RC switch mode:
  - Auto OFF: RC manual drive
  - Auto ON: onboard GPS mission/autonomy after separate safety design
- HC-12 is not used in that mode until hardware can be revised or proven
  independent from GPS `Serial2`.

## GPS Indoor Or Window-Side Fix Can Fail

Status:

- GPS UART bytes can arrive correctly while GPS fix remains false.
- Indoor/window-side tests may show increasing `gps_chars`, valid NMEA
  sentences, and TinyGPS++ character counts, but still fail to acquire enough
  satellites.
- `gps_sats=0` and `gps_hdop=99.99` are consistent with no satellite
  acquisition, not UART or firmware failure by themselves.
- Outdoor/open-sky antenna placement produced `gps_fix=true` in the
  `FIXED_WIRING_GPS_SERIAL2_DIAG` build.
- Rain did not prevent fix when the antenna had open-sky exposure, but the
  electronics, USB adapters, and antenna connectors must be protected from
  water.

Decision rule:

- `gps_chars=0`: wiring, selected UART, baudrate, power, or GPS output problem.
- `gps_chars>0` with `gps_fix=false`: GPS data is arriving, but satellite fix
  quality is not sufficient yet.
- `gps_sats=0` and `gps_hdop=99.99`: no satellite acquisition yet.
- For first fix, place the GPS antenna outdoors with open sky view and wait
  before debugging firmware.

## GPS Antenna Frame Is Not Rover Body Frame

Status:

- Recent GPS fix and single-waypoint candidate dry-run tests used an external
  antenna placed far outside while the rover body remained indoors.
- In that setup, `gps_lat` and `gps_lon` are the antenna position, not the rover
  body position.

Risk:

- Detached-antenna GPS is valid for reception and satellite-fix validation.
- Detached-antenna GPS is invalid for floor navigation and rover body
  localization.
- The IMU cannot fully correct a detached or free-moving GPS antenna into rover
  body position.
- The IMU may help later with heading/rotation sensing, but it does not replace
  a rover-mounted GPS position source.

Required before motion:

- Mount the GPS antenna rigidly on the rover, or define a fixed measured offset
  from the rover body frame.
- Run an IMU I2C scan.
- Verify IMU orientation and axis signs.
- Re-test candidate GPS fields with mounted antenna and open-sky placement.
- Use wheel-off-ground bench testing before any floor test.

Do not repeat:

- Do not approve `AUTO_MOTION_ARMED=1` floor tests while the GPS antenna is
  detached from the rover body.
- Do not assume IMU data can turn detached antenna coordinates into rover body
  coordinates.

## IMU I2C Wiring Is Fixed On D11/D12

Status:

- The IMU wiring cannot be moved casually.
- Current fixed wiring is believed to be:
  - IMU SDA: OpenRB D11 / PA08
  - IMU SCL: OpenRB D12 / PA09
- OpenRB-150 variant files confirm:
  - Arduino D11 = SDA = PA08
  - Arduino D12 = SCL = PA09
  - `PIN_WIRE_SDA = 11`
  - `PIN_WIRE_SCL = 12`
  - `Wire` is constructed using those pins
- Use `firmware/i2c_scanner_test` as the primary diagnostic for the current
  fixed IMU wiring because D11/D12 are the board's default `Wire` pins.
- Use `firmware/i2c_d11_d12_bitbang_scanner` only as a secondary diagnostic.
- If the scanner reports every address, or a very large number of addresses,
  treat it as scanner/bus failure such as ACK stuck low. It is not evidence of
  many I2C devices.
- The original bit-bang scanner produced impossible all-address detection; this
  result is invalid and must not be treated as successful IMU detection.
- The hardened bit-bang scanner was tested with SDA=D11/SCL=D12 and with the
  swapped SDA=D12/SCL=D11 assignment. Both variants repeatedly reported
  `released_sda=LOW`, `released_scl=LOW`, `SDA stuck low`, `SCL stuck low`,
  `raw_found_count=0`, `valid_found_count=0`, and `stable_valid_address=NA`.
- IMU presence remains unverified.
- D11/D12 stuck-low means an electrical or bus issue, not a pin mapping issue.
- Possible causes include IMU power, GND, pullups, or a bus-stuck fault.
- Robust default `Wire` scanner result:
  - scanner runs and prints repeated scan passes
  - every pass shows `pre_scan_sda=LOW` and `pre_scan_scl=LOW`
  - every pass prints `BUS_STUCK_LOW_BEFORE_SCAN`
  - every pass reports `found_count=0`
  - every pass reports `stable_valid_address=NA`
- `pre_scan_sda=LOW` and `pre_scan_scl=LOW` mean the bus is stuck low before
  address probing.
- `stable_valid_address=NA` means no valid IMU address has been verified.
- Continue GPS+RC work without relying on IMU data for now.

Do not repeat:

- Do not ask to move IMU wires as a routine software step.
- Do not conclude the IMU is absent only because `firmware/i2c_scanner_test`
  finds no devices; verify the startup output and D11/D12 line states first.
- Do not treat all-address detection as valid.
- Do not infer device type from I2C address alone.
- Do not rely on IMU heading or acceleration for autonomy until a stable I2C
  device address and orientation/axis checks are confirmed.

## Single-Waypoint Target Override Must Be Verified In USBDBG

Status:

- A nearby single-waypoint candidate retest was compiled/uploaded with:
  - `FIXED_WIRING_GPS_SERIAL2_SINGLE_WAYPOINT_EXPERIMENT=1`
  - `AUTO_MOTION_ARMED=0`
  - `SINGLE_WP_TARGET_LAT=35.5716800`
  - `SINGLE_WP_TARGET_LON=129.1866516`
- Runtime USBDBG still printed the old placeholder:
  - `target_lat=35.571120`
  - `target_lon=129.186050`
- GPS fix was achieved, and at least one log line reached `gps_hdop=1.19` and
  `gps_ready=true`.
- Because the target remained the old placeholder, `target_distance_m` stayed
  around `40` to `60` m, `distance_allowed=false`, and `safety_ready=false`.
- `AUTO_MOTION_ARMED=0` correctly kept final motor output at zero.
- MANUAL still returned to `control_source=RC_MANUAL`.
- Firmware source now supports compile-time target override through:
  - `SINGLE_WP_TARGET_LAT`
  - `SINGLE_WP_TARGET_LON`
- If both macros are provided, USBDBG should print
  `target_override_enabled=true` and `target_source=compile_time`.
- If the macros are not provided, USBDBG should print
  `target_override_enabled=false` and `target_source=fallback`.
- A later check verified target override plumbing with:
  - `SINGLE_WP_TARGET_LAT=35.5710210`
  - `SINGLE_WP_TARGET_LON=129.1864016`
  - `target_override_enabled=true`
  - `target_source=compile_time`
  - `target_lat_macro=35.5710210`
  - `target_lon_macro=129.1864016`
  - `target_lat=35.571021`
  - `target_lon=129.186402`
- That same run had current GPS around `gps_lat≈35.56752..35.56756` and
  `gps_lon≈129.18688`, so `target_distance_m≈380..392`.
- Since `max_target_distance_m=30.0`, `distance_allowed=false` and
  `safety_ready=false` were expected.
- A next-day retest showed the same rule again:
  - runtime GPS moved to approximately `gps_lat=35.571310`,
    `gps_lon=129.188630`
  - firmware still used previous compile-time target
    `target_lat=35.567560`, `target_lon=129.186792`
  - `target_override_enabled=true` and `target_source=compile_time`, so target
    override was working
  - `target_distance_m≈448.9`, above `max_target_distance_m=30.0`
  - `distance_allowed=false` and `safety_ready=false`
- In that next-day run, `gps_fix=true` appeared but `gps_ready=false` remained
  because `gps_age_ms` was often very large, `gps_sats` fluctuated, and
  `gps_hdop` was often `99.99` and only occasionally around `4.7`.
- A later nearby attempt showed why the target must be calculated from the
  actual runtime fix:
  - override target was `target_lat=35.571310`, `target_lon=129.188542`
  - actual GPS fix was `gps_lat=35.571384`, `gps_lon=129.187514`
  - `gps_sats=4`
  - `gps_hdop=3.39..4.12`
  - `gps_age_ms` was initially fresh but later grew stale
  - `target_distance_m=93.3`, above `max_target_distance_m=30.0`
  - `distance_allowed=false` and `safety_ready=false`
- A window/outside-antenna attempt showed another blocked case:
  - target override was valid for `target_lat=35.571384`,
    `target_lon=129.187426`
  - GPS fix appeared around `gps_lat≈35.571284`, `gps_lon≈129.188456`
  - `gps_sats` often became `0`
  - `gps_hdop` often became `99.99`
  - `gps_age_ms` grew very large
  - `target_distance_m≈93.9`, above `max_target_distance_m=30.0`
  - `distance_allowed=false`, `gps_ready=false`, and `safety_ready=false`
- Latest outdoor Manual/Auto recovery showed the RC path is recovered and GPS
  can be usable outdoors, but the autonomy dry-run was still target-blocked:
  - AUTO verified with `mode_us≈2001..2002`, `mode=AUTO_READY`, and
    `control_source=STOP`
  - MANUAL verified with `mode_us≈1000..1001` and
    `control_source=RC_MANUAL`
  - runtime GPS was around `35.5716,129.1875`
  - target remained stale at `35.570675,129.186769`
  - `target_distance_m≈100..131`, above `max_target_distance_m=30.0`
  - `distance_allowed=false` and `safety_ready=false`
  - `AUTO_MOTION_ARMED=0` / `auto_motor_inhibit=true` kept AUTO final commands
    at zero
- Latest outdoor nearby dry-run showed partial progress but remained blocked:
  - target override worked with `target_lat=35.570768`,
    `target_lon=129.186791`
  - outdoor GPS readiness was repeatedly good (`gps_ready=true`,
    `gps_sats=7..8`, `gps_hdop≈0.95..1.98`, fresh `gps_age_ms`)
  - `target_distance_m` decreased below `30.0` m, and
    `distance_allowed=true` was observed
  - mode stayed mostly `MANUAL`
  - `auto_sw=false`
  - `timeout_ok=false`
  - `safety_ready=false`
  - `candidate_left_cmd=0.000` and `candidate_right_cmd=0.000`
- A brief PPM/failsafe-like glitch was observed with `mode=FAILSAFE`,
  `rc_ok=false`, `steer_us≈495`, `throttle_us≈2504`, and
  `control_source=STOP`.

Interpretation:

- This was a safe failed validation, not a successful nearby candidate-command
  test.
- Safety gates and AUTO motor inhibit worked correctly.
- Compile-time target override is now verified, but target override success must
  be checked separately from `distance_allowed`, `safety_ready`, or candidate
  command values.
- Runtime GPS can move far from a previously computed target. Recompute the
  nearby target from the current GPS position before each nearby candidate run.
- The target must be recalculated from the actual runtime GPS fix, not from an
  assumed antenna location.
- Outdoor GPS readiness and RC mode recovery do not make a stale target valid.
  Recompute the target from the current runtime GPS fix before interpreting
  `distance_allowed` or candidate commands.
- `distance_allowed=true` in MANUAL is progress, but it is not sufficient for a
  candidate dry-run success.
- `safety_ready` must be verified in `AUTO_READY` with the active GPS tier
  ready (`active_gps_ready=true`; `dryrun_ready=true` for inhibited dry-run or
  `motion_ready=true` for future armed motion), `distance_allowed=true`,
  `timeout_ok=true`, valid RC, and the AUTO switch on.
- Previous `timeout_ok=false` observations showed that the experiment timeout
  could expire while waiting in MANUAL for GPS/target setup.
- Firmware has been updated so the single-waypoint experiment timeout starts on
  AUTO entry, resets when leaving AUTO, and no longer consumes time during
  MANUAL waiting.
- USBDBG must now be checked for `timeout_source=auto_entry`,
  `auto_entry_ms`, `auto_elapsed_ms`, `timeout_limit_ms`, and `timeout_ok`.
- Brief PPM/failsafe glitches can occur; the safe response is
  `control_source=STOP` with no autonomous output.
- A window-thrown or window/outside antenna position is not equivalent to the
  rover body position. It can validate that GPS reception is possible, but it
  cannot validate rover localization.
- Compile-time nearby targets are only valid for the GPS location used when
  calculating them. If the antenna is moved on another day, the target must be
  recalculated.
- Compile-time targets also become stale whenever the rover itself moves. A
  target that was nearby before moving the rover can immediately exceed
  `max_target_distance_m`.
- The latest successful no-motion dry-run used compile-time target
  `35.5705010,129.1872696` and target distance around `8.4..15.2` m. If the
  rover moves before the next test, recompute the target again.
- `distance_allowed=false` is expected when `target_distance_m` exceeds
  `max_target_distance_m`.
- If GPS quality is good (`gps_ready=true`, RMC `A`, GGA quality `>=1`, enough
  satellites, acceptable HDOP) but `distance_allowed=false`, the usual cause is
  that the compile-time target is too far or stale, not that GPS is broken.
- `gps_fix=true` alone is not enough. `gps_age_ms`, `gps_hdop`, and `gps_sats`
  must also satisfy readiness gates before interpreting a run as GPS-ready.
- `gps_chars` increasing does not imply `gps_fix=true`; it only proves that
  NMEA/serial input is alive.
- GPS fix can be lost between outdoor attempts. If `gps_sats=0` and
  `gps_hdop=99.99`, treat the run as GPS no-fix and do not proceed to AUTO
  candidate validation.
- Latest GPS-only `Serial2/9600` probe showed continuous NMEA input but
  intermittent fix. Most lines reported RMC status `V`, GGA fix quality `0`,
  `sats=0`, and `hdop=99.99`; a few short bursts reached RMC `A`, valid
  lat/lon, `sats=4..5`, and `hdop≈1.77..2.48`, then returned to no-fix.
- Moving the rover/GPS farther outdoors recovered stable fix in the standalone
  probe. The latest stable lines showed `gps_probe_state=STABLE_FIX`,
  `current_valid_fix=true`, RMC `A`, GGA quality `2`, `sats=9`, `hdop=3.56`,
  and `valid_fix_seconds_consecutive=58..60`.
- Main-controller outdoor validation also recovered GPS and AUTO gates:
  `gps_dryrun_ready=true`, `gps_motion_ready=true`, `gps_ready=true`,
  `gps_block_reason=OK`, RMC `A`, GGA quality `2`, `gps_sats≈9..11`,
  `gps_hdop≈1.46`, `mode=AUTO_READY`, `auto_sw=true`, and `timeout_ok=true`.
  It was still blocked because stale target distance was about `41` m, greater
  than `max_target_distance_m=30.0`.
- Main-controller no-motion AUTO waypoint dry-run is now validated with
  `AUTO_MOTION_ARMED=0`: `safety_ready=true`,
  `candidate_left_cmd=0.100`, `candidate_right_cmd=0.100`,
  `auto_motor_inhibit=true`, and final commands still `0.000`.
- Treat the previous persistent `NO_FIX` primarily as a placement/sky-view
  issue. Indoor, near-building, window-side, or partially covered positions can
  keep reporting RMC `V`, GGA quality `0`, `sats=0`, and `hdop=99.99` even
  while UART data is continuous.
- `gps_chars` increasing only proves serial/NMEA input. It does not prove a
  usable GPS position.
- RMC status `V`, GGA fix quality `0`, `sats=0`, and `hdop=99.99` means no
  current usable fix.
- RMC status `A` or GGA quality `>=1` for one second is not enough for
  autonomy validation; require sustained stable fix. In `gps_uart_probe`, use
  `gps_probe_state=STABLE_FIX` or `valid_fix_seconds_consecutive >= 30`.
- TinyGPS++ cached lat/lon after RMC returns to `V` must not be used for target
  distance, safety gates, or candidate commands.
- The current blocker is unstable GPS satellite acquisition, not target
  override, RC mode mapping, or timeout semantics.
- The latest post-timeout-fix run confirmed `timeout_source=auto_entry` and
  target override, but was blocked by `gps_fix=false`, `gps_lat=NA`,
  `gps_lon=NA`, `gps_sats=0`, `gps_hdop=99.99`, and `gps_age_ms=NA`.
- The firmware now separates cached TinyGPS location validity from a usable GPS
  solution:
  - `gps_location_valid` means TinyGPS has a cached location.
  - `gps_location_fresh` / `gps_age_ok` mean the cached location is recent.
  - `gps_sats_ok` requires enough satellites.
  - `gps_hdop_ok` requires acceptable HDOP.
  - `gps_ready` is the stricter motion-level usable-position gate.
- GPS readiness is tiered:
  - `gps_solution_valid` requires valid/fresh location plus RMC `A` or GGA fix
    quality at least `1` when those NMEA statuses are available.
  - `gps_dryrun_ready` is for no-motion candidate calculation and allows HDOP
    up to `6.0`.
  - `gps_motion_ready` is for any future armed motion and keeps stricter HDOP
    and satellite thresholds.
- Dry-run GPS and motion GPS gates are intentionally different.
  `gps_ready=false` / `gps_block_reason=BAD_HDOP` can coexist with
  `safety_ready=true` only in `AUTO_MOTION_ARMED=0` when
  `gps_dryrun_ready=true` / `active_gps_ready=true`. It is not acceptable for
  real motion or floor driving.
- If motion-level `gps_ready=false`, operational `gps_lat` and `gps_lon`
  should be `NA`. In the single-waypoint experiment with
  `AUTO_MOTION_ARMED=0`, target distance and bearing may still be computed from
  `gps_dryrun_ready=true` for no-motion diagnostics.
- Cached coordinates may still be visible as `gps_cached_lat`,
  `gps_cached_lon`, and `gps_cached_age_ms`, but they are debug-only and must
  not be used for target distance or safety decisions.
- `gps_block_reason` identifies the first blocker, such as `NO_LOCATION`,
  `STALE_LOCATION`, `NO_SATS`, `BAD_HDOP`, `NOT_READY`, or `OK`.
- NMEA status fields `last_rmc_status` and `last_gga_fix_quality` are
  diagnostics only; armed-motion safety must still require `gps_motion_ready`
  / motion-level `gps_ready`.
- HDOP around `5` is acceptable only for no-motion dry-run candidate
  calculation when `gps_dryrun_ready=true`. It is not approved for floor
  driving or armed motion.
- `target_distance_m` must also be checked even when `gps_fix=true` and target
  override are both valid.
- `safety_ready` is the combined gate to inspect before any later motion work.
- `timeout_ok` can expire while waiting too long after upload/reset or AUTO
  entry; candidate validation should be done promptly after the run is ready.
- Runtime `target_lat` and `target_lon` are the source of truth.

Do not repeat:

- Do not assume a compile command changed the target unless USBDBG confirms the
  runtime `target_lat` / `target_lon`.
- Do not treat `target_override_enabled=true` as proof that the target is nearby
  enough. Check `target_distance_m` against `max_target_distance_m`.
- Do not treat `distance_allowed=true` in MANUAL as a successful AUTO candidate
  dry-run.
- Do not approve bench testing until `AUTO_READY`, `active_gps_ready=true`,
  `dryrun_ready=true`, `distance_allowed=true`, `timeout_ok=true`,
  `safety_ready=true`, and nonzero candidate commands are observed while final
  outputs remain inhibited.
- Do not reuse a previously computed nearby target after moving the antenna or
  on a later day without recalculating it from the current GPS position.
- Do not reuse a compile-time target from an earlier outdoor location; even
  100 m of target error correctly keeps `distance_allowed=false`.
- Do not compute the target from an assumed antenna location; use the actual
  runtime GPS fix printed by USBDBG.
- Do not treat a window/outside antenna toss as equivalent to moving the rover
  outdoors with the GPS fixed to the rover body.
- Do not treat `gps_fix=true` as sufficient when `gps_age_ms` is stale,
  `gps_hdop` is high, or satellites are unstable.
- Do not treat increasing `gps_chars` as a valid GPS position fix.
- Do not treat `gps_location_valid=true` as a usable GPS fix if age, satellites,
  or HDOP fail.
- Do not treat `gps_dryrun_ready=true` as approval for floor driving. Armed
  motion must require `gps_motion_ready=true`.
- Do not use `gps_cached_lat` / `gps_cached_lon` for target distance,
  waypoint acceptance, or safety decisions.
- Do not proceed to AUTO candidate validation when `gps_sats=0` and
  `gps_hdop=99.99`.
- Do not ignore `timeout_ok`; if it expires, rerun the validation promptly from
  a fresh AUTO entry state.
- Do not interpret `timeout_ok` without checking `timeout_source=auto_entry`.
  In MANUAL, `auto_entry_ms` / `auto_elapsed_ms` should be `NA`; after switching
  to AUTO, they should become numeric.
- Do not ignore PPM/failsafe glitches; any `rc_ok=false` or invalid pulse values
  must keep the rover stopped.
- Do not approve bench testing or floor driving from a run where the target
  override did not take effect or where `distance_allowed=false`.

## Station HC-12 Device Still Needs Confirmation

The repository defaults to `/dev/ttyACM0`, but the actual station HC-12 USB
adapter must be confirmed on the target station host. Do not hard-code a new
port. Use `--port`.

## Path Planning Is Offline/Mock

The planner generates a locally planar A/B lawnmower path. It does not yet:

- capture live A/B points from a station UI
- account for hull curvature
- account for obstacles or edge margins
- account for paint/cleaning process constraints
- command rover motion

Path generation must remain dry-run until a mission approval and safety state
machine exists.

## GPS Fix Loss Policy Is Not Fully Enforced For Autonomy

Autonomous GPS-dependent motion is not implemented. Before adding it:

- define valid GPS fix requirements
- define stale GPS timeout
- define station UI warnings
- define rover-side rejection behavior
- log GPS fix state alongside command requests

## RC + GPS Dry-Run Is Not Real Autonomy

The build flag `FIXED_WIRING_GPS_SERIAL2_RC_AUTONOMY_DRYRUN=1` is a safe
integration step, not waypoint following.

Validated behavior:

- USBDBG build identity for the completed validation:
  `fixed_wiring_gps_serial2_diag=false`, `hc12_enabled=false`, and
  `autonomy_dryrun=true`.
- This is the first firmware mode where MANUAL and GPS dry-run coexist in one
  firmware.
- MANUAL mode works with `control_source=RC_MANUAL`, and stick input changes
  manual command and logical wheel fields.
- AUTO mode prints `autonomy_dryrun=true`, GPS fields, and target
  distance/bearing fields.
- AUTO mode must keep `control_source=STOP`, `left_cmd=0`, and `right_cmd=0`.
- No motor movement occurs in AUTO dry-run.
- GPS may show increasing `gps_chars` indoors or near a window while still
  failing to fix; open-sky antenna placement is required before treating this
  as firmware failure.

Known boundaries:

- HC-12 is disabled/ignored in this mode.
- RC MANUAL mode may drive using the existing RC manual behavior.
- AUTO mode must force `left_cmd=0` and `right_cmd=0`.
- `autonomy_ready=true` only means RC, GPS, and target readiness checks passed.
- The placeholder target `35.571120,129.186050` is for distance/bearing
  calculation only.
- AUTO is still computation-only.
- Real motion is not enabled yet.
- Do not convert this mode into motor-driving autonomy without a separate
  safety design and test plan.

## Armed AUTO Output Reached But No Motion (Motor Deadband)

On 2026-05-29 the armed single-waypoint build (`AUTO_MOTION_ARMED=1`) reached
firmware-side final output for the first time: `mode=AUTO_RUNNING`,
`auto_motor_inhibit=false`, motion-grade GPS, all gates passing, and
`final_left_cmd=0.100` / `final_right_cmd=0.100`. No visible rover movement
occurred. Returning to MANUAL drove final commands to `0.000`.

Diagnosis:

- This is NOT a GPS problem and NOT an AUTO-gate problem; the firmware produced
  the commanded output correctly.
- `0.100` maps to only ≈1530 µs (30 µs above the 1500 µs neutral), almost
  certainly below the motor/ESC/friction deadband.

Rule — do not raise the AUTO command without the latch stop:

- Do NOT raise the armed AUTO command magnitude in an ungated, time-unbounded
  build. That is a runaway risk.
- The next motion test must use the guarded ground crawl build
  (`GROUND_CRAWL_TEST_MODE=1`). Armed motion is now gated to zero in any build
  without it.
- The crawl harness clamps to ±`GROUND_CRAWL_MAX_CMD` (default `0.08`, which is
  intentionally below the observed deadband) and latches a hard stop after
  `GROUND_CRAWL_MAX_AUTO_MS` (default `1200` ms; clears only on MANUAL). Step the
  command up only by setting `-DSINGLE_WP_CRAWL_BASE_CMD` for the candidate
  command and `-DGROUND_CRAWL_MAX_CMD` for the final clamp, under latch
  protection, wheels-off-ground or open-area-with-kill-switch.
- Confirm the deadband interpretation with `unclamped_final_left_cmd` /
  `unclamped_final_right_cmd` and `ground_crawl_block_reason` in USBDBG before
  raising the cap.

## Guarded Crawl 0.08 Validated; Current Target Too Close

The guarded ground crawl 0.08 test validated the safety harness:

- `GROUND_CRAWL_TEST_MODE=1` and `AUTO_MOTION_ARMED=1` were active.
- A good GPS window reached `AUTO_RUNNING` with `gps_motion_ready=true`,
  `gps_sats=5`, `gps_hdop≈1.34`, and `gps_block_reason=OK`.
- `ground_crawl_ready=true` and `ground_crawl_block_reason=OK` were observed.
- `candidate_left_cmd=0.100` / `candidate_right_cmd=0.100` were clamped to
  `final_left_cmd=0.080` / `final_right_cmd=0.080`.
- `ground_crawl_latched_stop=true` stopped output after the duration limit.

Remaining cautions:

- The compile-time target later became too close (`target_distance_m≈3.9..4.4`),
  below `GROUND_CRAWL_MIN_TARGET_DISTANCE_M=5.0`, so the harness correctly
  blocked as `DISTANCE_OUT_OF_RANGE`.
- Intermittent GPS degradation can still block as `GPS_NOT_MOTION_READY`.
- This validates the guarded crawl safety behavior, not full autonomous
  driving.
- Historical 0.08/0.12 tests established that `SINGLE_WP_CRAWL_BASE_CMD`
  controls candidate speed and `GROUND_CRAWL_MAX_CMD` is only the final clamp.
  Do not reuse stale or too-close target coordinates.

## First Guarded AUTO Crawl Succeeded, But It Is Not Full Autonomy

Status:

- After the manual/drive mapping fix, the rover briefly moved forward under
  guarded `AUTO_RUNNING`.
- Working manual baseline: `MANUAL_FORWARD_SIGN=-1`,
  `MANUAL_TURN_SIGN=1`, `old_angle_remap_active=false`.
- Physical A/B mapping remains A = throttle and B = turn:
  `A=(logical_left+logical_right)/2`, `B=(logical_right-logical_left)/2`.
- Successful crawl fields included `gps_motion_ready=true`,
  `gps_block_reason=OK`, `target_distance_m≈9.6`, `distance_allowed=true`,
  `ground_crawl_ready=true`, `ground_crawl_block_reason=OK`,
  `left_cmd=0.220`, `right_cmd=0.220`, `final_left_cmd=0.220`,
  `final_right_cmd=0.220`, `physical_a_cmd=0.220`, and `physical_b_cmd=0.000`.
- The latch stopped output after roughly `510` ms.

Known risk:

- Do not treat a short straight guarded crawl as waypoint-following success.
- The 1000 ms repeat is complete. The next checks are station-side path planning
  preview only, single-waypoint steering dry-run, and heading/course estimation.
- Full floor waypoint driving and coverage driving remain blocked.

## Repeated 1000 ms Guarded Crawl Is Still Straight-Only

Status:

- Repeated 1000 ms guarded AUTO crawl succeeded with `GROUND_CRAWL_TEST_MODE=1`,
  `GROUND_CRAWL_MAX_CMD=0.220`, `GROUND_CRAWL_MAX_AUTO_MS=1000`,
  `SINGLE_WP_CRAWL_BASE_CMD=0.220`, and `AUTO_MOTION_ARMED=1`.
- `AUTO_RUNNING` was observed multiple times after the user toggled AUTO/MANUAL
  about `3..4` times.
- Straight output was correct: `physical_a_cmd=0.220`,
  `physical_b_cmd=0.000`.
- Latch stop returned final outputs to zero after roughly `1000` ms.
- `target_distance_m` varied around `16.8..18.0` and did not monotonically
  decrease.

Interpretation:

- This is expected because the current guarded crawl only drives straight.
- It has no steering correction, heading/course estimator, or waypoint follower
  yet.
- Do not diagnose this as a path-planning failure.

Next:

- station-side path planning preview only, no motor execution
- single-waypoint steering dry-run
- heading/course estimation before physical waypoint following

## GPS Bearing Is Not Rover Heading

Status:

- `SINGLE_WP_STEERING_DRYRUN=1` adds steering diagnostics.
- GPS position can compute `target_bearing_deg`, but it does not tell which way
  the rover body is pointing.
- Course-over-ground is estimated only after the rover has moved at least
  `2.0` m between GPS samples.

Known pitfall:

- Do not use target bearing alone as `desired_turn_cmd`.
- If `heading_ready=false` and `steering_block_reason=NO_HEADING`, the steering
  dry-run must not be interpreted as ready for physical waypoint following.
- Straight guarded crawl may move the rover but still leave
  `target_distance_m` non-monotonic because heading/course correction is not
  active.

## GPS-Gated Crawl Is Noisy For Motor Deadband Calibration

GPS remains intermittent enough that GPS-gated guarded crawl tests can be slow
and noisy when the immediate question is only motor deadband or drivetrain
response.

Use `MOTOR_PULSE_TEST_MODE=1` for GPS-independent deadband calibration:

- It does not use GPS readiness or waypoint target distance.
- It disables HC-12.
- It preserves RC MANUAL behavior.
- AUTO emits one neutral-stick pulse and then latches stop until MANUAL.
- It intentionally skips GPS initialization and GPS byte processing. Do not use
  motor pulse USBDBG lines to validate GPS.

Do not use this mode as autonomy proof. It only answers whether a given
`MOTOR_PULSE_CMD` produces physical drivetrain response.

Expected motor pulse GPS-looking fields:

- `gps_chars=0`
- `last_rmc_status=NA`
- `last_gga_fix_quality=NA`
- `gps_block_reason=NO_LOCATION`

These are expected in `MOTOR_PULSE_TEST_MODE=1` and do not mean the GPS module
or `Serial2/9600` wiring failed. Validate GPS separately with
`firmware/gps_uart_probe` or with the no-motion main-controller GPS build:
`FIXED_WIRING_GPS_SERIAL2_SINGLE_WAYPOINT_EXPERIMENT=1` and
`AUTO_MOTION_ARMED=0`, with no `MOTOR_PULSE_TEST_MODE`.

## Drivetrain Asymmetry Suspected

Current calibration observations:

- `MOTOR_PULSE_CMD=0.180` produced valid software output but no visible motion.
- `MOTOR_PULSE_CMD=0.220` produced visible motion.
- The 0.22 log showed symmetric software output:
  - `left_cmd=0.220`
  - `right_cmd=0.220`
  - `motor_pulse_ready=true`
  - `motor_pulse_block_reason=OK`
- The observed physical motion looked more like rotation than straight forward
  motion.
- Manual RC driving is also asymmetric:
  - forward tends to drift/curve left;
  - backward tends to drift/curve right.

Working hypothesis:

- The right-side drive may be stronger than the left-side drive, or the left
  side may have higher friction/deadband.
- Causes may be mechanical, electrical, motor/ESC-related, or software scaling.

Do not hide this in GPS/path planning. Use differential left/right motor pulse
calibration (`MOTOR_PULSE_LEFT_CMD`, `MOTOR_PULSE_RIGHT_CMD`) to characterize
the drivetrain, then apply corrections through the shared drive calibration
layer (`DRIVE_CALIBRATION_ENABLE=1`) used by both MANUAL and AUTO command
paths. Keep defaults identity/off until measured values justify a change.

Latest differential pulse observations:

- Left-only `+0.22`: left wheel rotates forward.
- Right-only `+0.22`: right wheel rotates forward, and the rover curves left as
  expected for right-only drive.
- Both `+0.22/+0.22`: both wheels appear to rotate forward, but the rover
  curves/rotates right instead of going straight.
- Both `-0.22/-0.22`: both wheels appear to rotate backward, but the rover
  curves left while reversing.

Interpretation:

- Basic motor polarity was not enough to explain the behavior.
- The motor pulse path bypasses RC stick angle remapping, but the physical PWM
  pins were later found to be throttle/turn inputs rather than direct wheel-side
  outputs.
- Treat the old symmetric pulse observations as pre-mapping-fix evidence. Do not
  use them to tune left/right scale.

Next debugging step: validate the corrected `A=(left+right)/2`,
`B=(right-left)/2` mapping with both-wheel forward/reverse tests.

Latest critical retest:

- `MOTOR_PULSE_LEFT_CMD=+0.25`, `MOTOR_PULSE_RIGHT_CMD=0.00` made the physical
  left wheel rotate forward while the physical right wheel rotated backward.
- `MOTOR_PULSE_LEFT_CMD=0.00`, `MOTOR_PULSE_RIGHT_CMD=+0.25` made the physical
  left wheel rotate backward while the physical right wheel rotated forward.

This result must be treated as a direct-output-path validation failure, not as a
simple left/right scale problem. Do not run compensation tests until USBDBG shows
the staged command path clearly:

- `motor_pulse_left_cmd` / `motor_pulse_right_cmd`
- `logical_left_cmd` / `logical_right_cmd`
- `calibrated_left_cmd` / `calibrated_right_cmd`
- `output_left_cmd` / `output_right_cmd`
- `output_left_pin_cmd` / `output_right_pin_cmd`
- `motor_output_swap_lr=false` unless explicitly testing a physical output swap

The firmware now separates those stages. `MOTOR_PULSE_LEFT_CMD` and
`MOTOR_PULSE_RIGHT_CMD` are intended to be direct logical wheel commands, not
steering/throttle commands. In motor pulse mode, the firmware converts those
direct wheel commands to the current controller's steer/throttle-style PWM input
pair only at the final pin-write stage.

Latest pin-path conclusion:

- `logical_left_cmd` / `logical_right_cmd` now match the compile-time
  `MOTOR_PULSE_LEFT_CMD` / `MOTOR_PULSE_RIGHT_CMD` values.
- `output_left_pin_cmd` and `output_right_pin_cmd` are physical controller pin
  commands, not physical left/right wheel commands.
- `firmware/physical_output_pin_probe` confirmed A is throttle and B is turn.
- The integrated conversion now uses `A=(left+right)/2` and
  `B=(right-left)/2`.

Do not tune `LEFT_MOTOR_SCALE`, `RIGHT_MOTOR_SCALE`, `LEFT_MOTOR_MIN_CMD`, or
`RIGHT_MOTOR_MIN_CMD` until the corrected mapping is physically verified with
both-wheel forward/reverse motor pulse tests. Single-wheel logical commands are
halved at the physical pin level and can still sit near deadband.

## Legacy IMU Notes Superseded By BMI160 Integration

Older notes said BMI160/IMU support was not integrated and that D11/D12 remained
unverified. That is now superseded for the current hardware:

- BMI160 is detected on `Wire` at `0x68`.
- `firmware/imu_bmi160_normal_probe` passed with `chip_id=0xD1`, accel/gyro PMU
  normal, plausible `accel_mag_g`, and low stationary `gyro_mag_dps`.
- Integrated no-motion controller reports `imu_type=BMI160`, `imu_present=true`,
  `imu_chip_id=0xD1`, `imu_pmu_normal=true`, `imu_data_plausible=true`, and
  `imu_heading_ready=true`.

The legacy `firmware/imu_probe` is MPU/ICM-only and must not be used as the
BMI160 health check. BMI160 relative-yaw/heading remains diagnostic only; do not
enable physical path following from IMU data.

## ROS2 Is Skeleton-Only

`ros2_ws/src/` packages exist but are not functional runtime nodes. Do not claim
ROS2 integration is complete. Do not introduce ROS2 behavior until simple HC-12
telemetry, STOP, and dry-run station workflow are stable.

## micro-ROS Should Wait

Do not introduce micro-ROS on the rover now. The OpenRB firmware has a simple
HC-12 protocol that should be stabilized first.

## Generated Artifacts Policy Is Unsettled

Some mock mission outputs and generated figures are useful report evidence, but
logs and local test outputs can grow quickly. Decide per artifact whether it is:

- tracked report evidence
- reproducible generated output
- ignored local run data

## Firmware Source Must Match Board Firmware

The rover previously had firmware that printed:

```text
STAT,...,MANUAL_CENTER_STOP,...
```

That firmware source was not the active repo integrated firmware. Always confirm
the USB startup marker after upload before debugging behavior.

## Legacy MPU/ICM Device Identity Note

Status:

- This applies only to the old MPU/ICM-style `firmware/imu_probe` result
  (`0x69` / `WHO_AM_I=0x6F`).
- The current rover IMU path is BMI160 at `0x68`, `CHIP_ID=0xD1`.
- Do not use `WHO_AM_I=0x6F` as the current IMU identity.

## GPS And HC-12 Serial Allocation

Status:

- GPS is confirmed on `Serial2` (central connector). The legacy default
  controller build also assigns HC-12 to `Serial2`, so that legacy build cannot
  validate GPS + HC-12 together.
- The integrated no-motion path-following dry-run selects HC-12 on `Serial3`,
  so GPS (`Serial2`) and HC-12 (`Serial3`) do not conflict in that build.
- OpenRB-150 has two other hardware UARTs (`Serial1` D26/D27, `Serial3`
  D14/D13). The path-following HC-12 protocol rejects `Serial2` at compile time.
- Current status is `HC12_DEFERRED_RF_LINK`: Serial3 is configured, but RF RX/TX
  and parse success are not proven yet.

## Old Circuit Was The Root Cause Of IMU/HC-12 Failures (Resolved 2026-06-03)

Status:

- After a director meeting, the previous board/circuit was found to have
  wiring/circuit issues. The circuit was rebuilt on a breadboard.
- HC-12 now works with the computer/station, and the IMU is detected and works.
- The earlier IMU and HC-12 failures were therefore most likely the old
  circuit/wiring, not the OpenRB-150 board or the firmware/code.
- Wiring rule reaffirmed: GPS on `Serial2`; HC-12 on `Serial3` (or `Serial1`),
  never `Serial2`. Path-following builds reject HC-12 on `Serial2` at compile
  time.
- Remaining blockers before physical driving are unchanged: the RC/PPM
  Manual/Auto mode channel must hold, and a heading source must be validated
  outdoors (GPS course, and an IMU-yaw-vs-GPS-course agreement check).

## IMU Yaw Is Relative And Drifts (Not An Absolute Heading)

Status:

- Gyro-integrated yaw (`imu_relative_yaw_deg`) is relative, reset to 0 at start,
  and drifts unless calibrated/fused/seeded. It is NOT a compass heading.
- The probe and the controller dry-run print it as diagnostic only. The
  controller never uses IMU yaw for motor output: `HEADING_SOURCE_MODE` values
  other than GPS_COURSE (0) / GPS_COURSE_WITH_IMU_DIAG (2) report
  `physical_block_reason=HEADING_SOURCE_NOT_APPROVED_FOR_MOTION`.
- Correct path: validate raw signal, calibrate gyro bias, find axis/sign,
  integrate relative yaw, compare IMU-yaw delta with GPS course-over-ground
  outdoors, and only then consider it a guarded heading source.

## Lawnmower Corners Rounded Into Wide Arcs (Resolved 2026-06-11)

Status: fixed in code; re-verify on the field.

Symptom: the executed ㄹ/lawnmower path looked roughly right but every corner
was a wide gentle arc and lanes drifted diagonally, even though the preview
showed sharp 90 degree corners.

Three compounding causes, all in `tools/physical_path_planning/`:

1. The angle-calibrated connector assumed ONE turn pulse completes a 90 degree
   corner, but the stored `turn_left_90`/`turn_right_90` pulses physically turn
   only ~15-45 degrees on this rover. The calibration JSON's `target_angle_deg`
   was dropped by `connector_primitive`, and the post-turn verification
   measured against `--start-yaw-deg`, which is normally absent, so the check
   always read zero error and "passed" after one small pulse.
2. Each lane re-captured its IMU reference yaw at the lane start, so the
   connector's 45-75 degree under-turn was silently adopted as the new
   "correct" heading instead of being corrected.
3. The planned `path_connector` claimed a `step_spacing_m` sideways translation
   that execution never drove (a pivot cannot translate), so the planned and
   physical paths could never match even with perfect turns.

Fixes (see `docs/physical_path_planning_architecture.md`):

- connectors now pulse repeatedly and stop on the measured IMU yaw delta,
  budgeted from `target_angle_deg` and capped by
  `--max-connector-pulses-per-turn`;
- `--heading-reference mission` (default) chains one yaw frame across the run;
- the lawnmower planner decomposes corners into
  `connector_turn -> step_lane -> connector_turn` (`--connector-style
  turn_step_turn`, the default).

Operator rules learned:

- store the REAL measured per-pulse angle in `target_angle_deg`
  (`set-motion-calibration --target-angle-deg 30`), never a hoped-for 90;
- keep `--cross-track-correction-threshold-m` well below the lane spacing
  (a 1.5 m threshold on 1.2 m lanes disables lane recovery entirely);
- check `stop_correct_go_trace.csv` `phase=connector` rows
  (`applied_turn_delta_deg` vs `requested_turn_angle_deg`) before blaming
  calibration strength.

## First Field Run Findings After The Corner Refactor (2026-06-12)

Two failures from the first 2.4 m x 2.4 m run, both fixed in code:

1. `COMMAND_EXCEEDS_MAX_MS` on the first corner: the guarded-pulse firmware's
   maximum pulse duration is a COMPILE-TIME flag baked in at upload
   (`STAGE_USB_GUARDED_MAX_MS_VALUE`; tune-motion uploads with 3000 ms,
   usb-pulse-test with 1000 ms), so a 2200 ms calibrated turn pulse can pass in
   tune-motion and then be rejected during execution under a different upload.
   Connectors now run as continuous live-drive IMU pivots (no long guarded
   pulses); the no-IMU fallback clamps pulses to 1000 ms.
2. Lane "completed" after one chunk with cross-track ~1.8 m: the plan origin
   (preview-time fix) and the rover's execute-time position disagreed by
   meters, and with 5 sats / HDOP ~2 the stationary fix wandered ~1 m per 10 s.
   Use `run` (re-anchors the relative plan at the current fix) for execution
   and `--max-gps-jump-m` to reject teleport-scale GPS steps mid-run. A 2.4 m
   lane is at the GPS noise floor; expect IMU + dead reckoning to carry
   progress and treat GPS as a loose tether.

Measured turn rates for reference (B command, continuous):

- left B=+0.24: ~13 deg/s (2200 ms -> ~28 deg median, stiction outliers ~2 deg)
- right B=-0.12: ~80 deg/s (2050-2200 ms -> ~160-173 deg, one ~81 deg outlier)

## Untethered Pattern: Veer, Early Permanent Stop, And "Resume" Illusion (Resolved 2026-06-12)

First untethered rc-auto-pattern run: straights bowed hard left (yaw 37->98
during one lane), the run stopped for good after forward -> turn -> short
forward, and re-flipping AUTO appeared to "continue the remaining path".

Causes and fixes (all in the RC_AUTO_PATTERN firmware module):

1. Lanes were driven open-loop (`B=0`), so a drivetrain veer of ~14 deg/s
   went uncorrected. Straights now run heading-hold against an ABSOLUTE
   body-heading chain anchored at AUTO start (`RUN_START`):
   `B = clamp(err * HEADING_KP, +/-HEADING_MAX_B) + DRIVE_B_TRIM`, both
   drive directions.
2. Any RC blip entered the `!rcValid` branch, which killed and DISARMED the
   run permanently (rover sat idle until a fresh MANUAL->AUTO). Signal loss
   still stops motors instantly, but a dropout <= RC_LOSS_GRACE_MS (1500)
   now only pauses the run and resumes the interrupted step; longer outages
   reset+disarm as before.
3. Turn targets were RELATIVE (+/-90 from wherever the body pointed), so a
   re-armed run in a rotated pose looked like it was "resuming". Targets are
   now absolute headings in the run frame, and every MANUAL->AUTO flip
   rebuilds the steps and restarts from step 0 at the current pose - resume
   of a partial run is impossible by construction.

## Manual Control Lag While Plugged In / After Long Hot Sessions (2026-06-12)

Two distinct mechanisms, do not conflate them:

1. FIRMWARE (fixed): a USB host that holds the CDC port open but stops
   draining it (monitor window suspended, reader killed without closing the
   port) makes every Serial write block; one ~3 KB status line can stall the
   loop for seconds. All debug printing now passes a stall guard: cached
   host gate (checked <= 1/s, because the core's `(bool)Serial` can cost
   ~10 ms per call), a 50 ms per-print budget, a 5 s mute on breach, and a
   one-packet probe to resume. `usb_print_stall_count` in USBDBG counts
   breaches. Additionally `LOOP_IDLE_WFI` (default on) sleeps the CPU until
   the next interrupt each loop instead of busy-spinning - less board
   self-heating; loop still runs >= ~1 kHz.
2. HARDWARE (operator checklist): lag that survives a power cycle AND an
   unplugged cable is not firmware - the board reported "very hot", and
   powering everything off and resting recovered it. Suspect battery sag
   (voltage recovers after rest) and ESC/motor/regulator heat. Use
   `loop_dt_max_ms` in USBDBG to discriminate: small (a few ms) while
   controls feel mushy = electrical/thermal, not the control loop. Field
   rules: shade the electronics, power off between sessions, verify battery
   voltage/charge before blaming firmware, let it cool before re-testing.

## Drive-Time B Response Is INVERTED vs Stationary Pivots (Field-Proven 2026-06-12)

Tethered monitor capture of the first heading-hold run is unambiguous and
MUST be respected by any future motion code:

- Both pivots converged with the pivot-domain sign (absolute heading errors
  -39.6 -> +2.5 and -50.6 -> -0.6 deg): stationary, +B raises yaw.
- All three driven segments diverged under the SAME sign: lane heading error
  accelerated -0.3 -> -3.8 -> -24.9 -> -55.7 -> -99.2 -> -148.9 deg while the
  correction grew to saturation (B=-0.25), i.e. while TRANSLATING the yaw
  response to B is OPPOSITE (forward A=+0.3 and reverse A=-0.3 both showed
  yaw_rate ~ -c*B). The runaway also explains motor saturation (left=0.55),
  battery strain, and "lanes bowing" reports.

Consequences in code: RC_AUTO_PATTERN drives lanes with
`RC_AUTO_PATTERN_DRIVE_STEER_SIGN` (default -1) applied to the heading-hold
feedback only; pivots keep the pivot-domain sign. A lane aborts early past
`RC_AUTO_PATTERN_DRIVE_ABORT_ERR_DEG` (60) as an anti-donut safety net. The
station's stop_correct_go is unaffected: it corrects heading while STOPPED
(pivot domain). If a future surface/drivetrain change restores the normal
relation, re-upload with `--drive-steer-sign 1` -- decide from the monitor's
`heading_err_deg` trend (must shrink during DRIVE), never from theory.

## Gyro Bias Drifts With Temperature; Stationary Re-Zero Added (2026-06-12)

After a long hot session the boot-time gyro bias was off enough to show
-1.3 deg/s of yaw drift while imu_stationary=true (log tail: 161.4 -> 158.6
over ~2 s stationary). Over a 60 s pattern that is tens of degrees of fake
heading error, which corrupts "90 deg" corners progressively -- matching the
"turns are not really 90" and "fine at first, degrades over time" reports.
Fix: whenever the body is measurably stationary for >=700 ms, all three gyro
bias estimates relax toward the current raw readings (alpha 0.01 per 20 ms
sample, tau ~2 s). The pattern's inter-step pause default rose to 800 ms so
every step boundary provides a re-zero window. Square corners additionally
use coast-compensated stops (`RC_AUTO_PATTERN_TURN_COAST_S`) plus
settle-verify retries (`RC_AUTO_PATTERN_TURN_SETTLE_RETRIES`): after the
pause, the settled heading is re-checked and the same pivot re-runs (bounded)
if outside tolerance.

## Printed PPM Ages Can Show 4294967xxx / False rc_input_detected=false (Fixed 2026-06-12)

`(bool)Serial` inside the print gate can sleep ~10 ms on SAMD cores; ages
computed against a pre-gate `millis()` then see ISR-stamped frame times from
the "future" and underflow (ppm_age_ms=4294967288 = -8 ms), printing
rc_input_detected=false / PPM_EDGES_NO_VALID_FRAME on alternate lines while
control (which reads its own clock) was healthy the whole time. The debug
printers now re-read millis() after the gate. Also seen and benign-but-noted:
ppm_min_width_us=2 (a real electrical glitch on D6 rejected by the decoder)
and loop_dt_max_ms alternating ~15/~25 ms tethered (status line cost plus the
once-per-second gate refresh).
