seonukkim/gps_hc12_robot/docs/figures/generated/fig_gps_fix_timeline.png

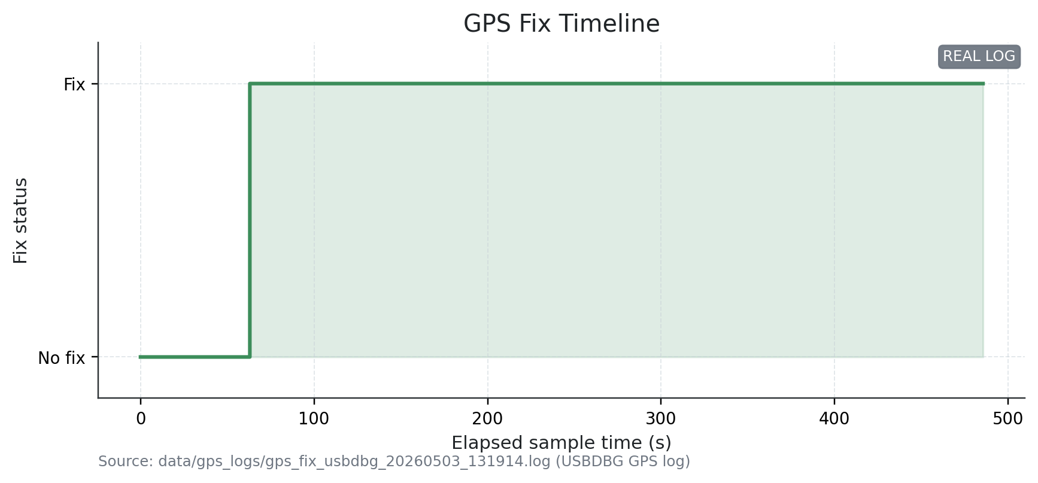
docs/figures/generated/fig_gps_fix_timeline.png
