seonukkim/gps_hc12_robot/firmware/openrb_robot_controller/openrb_robot_controller.ino

#include <Servo.h>
#include <TinyGPS++.h>
#include <math.h>

// ---- IMU diagnostic integration (Task D) ----
// Read-only IMU diagnostics on the Wire bus (D11 SDA / D12 SCL). Disabled by
// default: with IMU_ENABLE=0 there is no Wire include, no IMU code, and the
// default controller behaviour is unchanged. IMU yaw here is a RELATIVE,
// drifting diagnostic and is never used to drive motors.
#ifndef IMU_ENABLE
#define IMU_ENABLE 0
#endif
#ifndef IMU_HEADING_DRYRUN
#define IMU_HEADING_DRYRUN 0
#endif
#ifndef IMU_YAW_DIAG
#define IMU_YAW_DIAG 0
#endif
#ifndef IMU_CALIBRATION_SECONDS
#define IMU_CALIBRATION_SECONDS 5
#endif
#ifndef IMU_YAW_AXIS
#define IMU_YAW_AXIS 2
#endif
#ifndef IMU_YAW_SIGN
#define IMU_YAW_SIGN 1
#endif
#ifndef IMU_I2C_ADDR
#define IMU_I2C_ADDR 0x69
#endif
#ifndef IMU_GYRO_LSB_PER_DPS
#define IMU_GYRO_LSB_PER_DPS 131.0
#endif
#ifndef IMU_ACCEL_LSB_PER_G
#define IMU_ACCEL_LSB_PER_G 16384.0
#endif
// HEADING_SOURCE_MODE: 0=GPS_COURSE (default/existing), 1=IMU_RELATIVE,
// 2=GPS_COURSE_WITH_IMU_DIAG, 3=MOCK_HEADING, 4=FUSION_DIAG. Only GPS-course
// modes (0/2) are approved to drive motors; the rest are diagnostic-only.
#ifndef HEADING_SOURCE_MODE
#define HEADING_SOURCE_MODE 0
#endif
#ifndef MOCK_HEADING_DEG
#define MOCK_HEADING_DEG 0.0
#endif
#if IMU_ENABLE
#include <Wire.h>
#endif

#ifndef FIXED_WIRING_GPS_SERIAL2_DIAG
#define FIXED_WIRING_GPS_SERIAL2_DIAG 0
#endif

#ifndef FIXED_WIRING_GPS_SERIAL2_RC_AUTONOMY_DRYRUN
#define FIXED_WIRING_GPS_SERIAL2_RC_AUTONOMY_DRYRUN 0
#endif

#ifndef FIXED_WIRING_GPS_SERIAL2_SINGLE_WAYPOINT_EXPERIMENT
#define FIXED_WIRING_GPS_SERIAL2_SINGLE_WAYPOINT_EXPERIMENT 0
#endif

#ifndef MOTOR_PULSE_TEST_MODE
#define MOTOR_PULSE_TEST_MODE 0
#endif

#ifndef MANUAL_RC_RECOVERY
#define MANUAL_RC_RECOVERY 0
#endif

#ifndef MANUAL_CONTROL_PPM
#define MANUAL_CONTROL_PPM 0
#endif

// Untethered RC AUTO pattern: with MANUAL_CONTROL_PPM, CH5=MANUAL drives RC
// manual as usual and CH5=AUTO runs ONE onboard lawnmower (turn-step-turn)
// pattern using timed lanes and IMU-feedback pivots. Re-arming requires a
// fresh MANUAL period, so booting with the switch in AUTO never moves.
#ifndef RC_AUTO_PATTERN
#define RC_AUTO_PATTERN 0
#endif
#ifndef RC_AUTO_PATTERN_LANES
#define RC_AUTO_PATTERN_LANES 4
#endif
#ifndef RC_AUTO_PATTERN_LANE_MS
#define RC_AUTO_PATTERN_LANE_MS 4200
#endif
#ifndef RC_AUTO_PATTERN_STEP_MS
#define RC_AUTO_PATTERN_STEP_MS 1400
#endif
#ifndef RC_AUTO_PATTERN_FORWARD_A
#define RC_AUTO_PATTERN_FORWARD_A 0.30f
#endif
#ifndef RC_AUTO_PATTERN_REVERSE_A
#define RC_AUTO_PATTERN_REVERSE_A -0.30f
#endif
#ifndef RC_AUTO_PATTERN_TURN_B_LEFT
#define RC_AUTO_PATTERN_TURN_B_LEFT 0.24f
#endif
#ifndef RC_AUTO_PATTERN_TURN_B_RIGHT
#define RC_AUTO_PATTERN_TURN_B_RIGHT -0.12f
#endif
#ifndef RC_AUTO_PATTERN_TURN_TARGET_DEG
#define RC_AUTO_PATTERN_TURN_TARGET_DEG 90.0
#endif
#ifndef RC_AUTO_PATTERN_TURN_TOL_DEG
#define RC_AUTO_PATTERN_TURN_TOL_DEG 8.0
#endif
#ifndef RC_AUTO_PATTERN_TURN_TIMEOUT_MS
#define RC_AUTO_PATTERN_TURN_TIMEOUT_MS 15000
#endif
// 800 ms lets the body settle AND gives the stationary gyro re-zero a window
// at every step boundary, so yaw drift cannot accumulate across the pattern.
#ifndef RC_AUTO_PATTERN_PAUSE_MS
#define RC_AUTO_PATTERN_PAUSE_MS 800
#endif
// Pivot coast compensation: command the stop early by (yaw rate x this many
// seconds) so a fast pivot (~80 deg/s measured on the right turn) does not
// coast past the target after motors stop.
#ifndef RC_AUTO_PATTERN_TURN_COAST_S
#define RC_AUTO_PATTERN_TURN_COAST_S 0.15f
#endif
// Settle-verify: after a pivot stops and the pause elapses, the yaw is read
// again while fully stationary; if the body settled outside tolerance the
// SAME turn re-runs (up to this many times) before the pattern advances.
// This is what makes corners physically ~90 deg instead of "tolerance plus
// coast plus drift".
#ifndef RC_AUTO_PATTERN_TURN_SETTLE_RETRIES
#define RC_AUTO_PATTERN_TURN_SETTLE_RETRIES 2
#endif
#ifndef RC_AUTO_PATTERN_ARM_MANUAL_MS
#define RC_AUTO_PATTERN_ARM_MANUAL_MS 1000
#endif
// Heading-hold on straight steps: B = kP * heading error (deg), clamped.
#ifndef RC_AUTO_PATTERN_HEADING_KP
#define RC_AUTO_PATTERN_HEADING_KP 0.015f
#endif
#ifndef RC_AUTO_PATTERN_HEADING_MAX_B
#define RC_AUTO_PATTERN_HEADING_MAX_B 0.25f
#endif
#ifndef RC_AUTO_PATTERN_DRIVE_B_TRIM
#define RC_AUTO_PATTERN_DRIVE_B_TRIM 0.0f
#endif
// Sign of the heading-hold feedback while TRANSLATING. Field log 2026-06-12:
// on this drivetrain the yaw response to B while driving is INVERTED relative
// to a stationary pivot (pivots converged with the pivot-domain sign, while
// the same sign during lanes produced a positive-feedback runaway: error
// -0.3 -> -3.8 -> -24.9 -> -55.7 -> -99.2 deg as B saturated). Default -1
// flips the lane feedback only; pivots are untouched.
#ifndef RC_AUTO_PATTERN_DRIVE_STEER_SIGN
#define RC_AUTO_PATTERN_DRIVE_STEER_SIGN -1.0f
#endif
// Safety net: if a lane's heading error still diverges past this many degrees
// (wrong steer sign for the surface, dragged wheel, shove), end the drive step
// early instead of carving a donut; the next pivot re-aims at the absolute
// target heading.
#ifndef RC_AUTO_PATTERN_DRIVE_ABORT_ERR_DEG
#define RC_AUTO_PATTERN_DRIVE_ABORT_ERR_DEG 60.0
#endif
// Brief RC dropouts pause the run (motors stopped) instead of killing it;
// only a loss longer than this grace disarms the pattern.
#ifndef RC_AUTO_PATTERN_RC_LOSS_GRACE_MS
#define RC_AUTO_PATTERN_RC_LOSS_GRACE_MS 1500
#endif

#ifndef PPM_INTERRUPT_EDGE_FALLING
#define PPM_INTERRUPT_EDGE_FALLING 0
#endif

#ifndef PPM_SYNC_THRESHOLD_US
#define PPM_SYNC_THRESHOLD_US 3000
#endif

#ifndef PPM_CAPTURE_MIN_US_VALUE
#define PPM_CAPTURE_MIN_US_VALUE 800
#endif

#ifndef PPM_CAPTURE_MAX_US_VALUE
#define PPM_CAPTURE_MAX_US_VALUE 2200
#endif

#ifndef MOTOR_TRACE_ENABLE
#define MOTOR_TRACE_ENABLE 1
#endif

// Idle the core between loop iterations (wake on any interrupt: SysTick 1 ms,
// PPM edge, SERCOM RX, USB). A free-running busy spin burns full CPU power
// continuously, which adds avoidable self-heating to a board that already
// runs hot outdoors; with WFI the loop still runs at >=~1 kHz, far above the
// 50 Hz PPM frame rate every control path is clocked from.
#ifndef LOOP_IDLE_WFI
#define LOOP_IDLE_WFI 1
#endif

#ifndef AUTO_MOTION_ARMED
#define AUTO_MOTION_ARMED 0
#endif

#ifndef MOTOR_PULSE_CMD
#define MOTOR_PULSE_CMD 0.15
#endif

#ifndef MOTOR_PULSE_LEFT_CMD
#define MOTOR_PULSE_LEFT_CMD MOTOR_PULSE_CMD
#endif

#ifndef MOTOR_PULSE_RIGHT_CMD
#define MOTOR_PULSE_RIGHT_CMD MOTOR_PULSE_CMD
#endif

#ifndef MOTOR_PULSE_MS
#define MOTOR_PULSE_MS 300
#endif

#ifndef DRIVE_CALIBRATION_ENABLE
#define DRIVE_CALIBRATION_ENABLE 0
#endif

#ifndef LEFT_MOTOR_SIGN
#define LEFT_MOTOR_SIGN 1
#endif

#ifndef RIGHT_MOTOR_SIGN
#define RIGHT_MOTOR_SIGN 1
#endif

#ifndef LEFT_MOTOR_SCALE
#define LEFT_MOTOR_SCALE 1.0
#endif

#ifndef RIGHT_MOTOR_SCALE
#define RIGHT_MOTOR_SCALE 1.0
#endif

#ifndef LEFT_MOTOR_MIN_CMD
#define LEFT_MOTOR_MIN_CMD 0.0
#endif

#ifndef RIGHT_MOTOR_MIN_CMD
#define RIGHT_MOTOR_MIN_CMD 0.0
#endif

#ifndef MOTOR_OUTPUT_SWAP_LR
#define MOTOR_OUTPUT_SWAP_LR 0
#endif

#ifndef MANUAL_FORWARD_SIGN
#define MANUAL_FORWARD_SIGN -1
#endif

#ifndef MANUAL_TURN_SIGN
#define MANUAL_TURN_SIGN 1
#endif

#ifndef GROUND_CRAWL_TEST_MODE
#define GROUND_CRAWL_TEST_MODE 0
#endif

#ifndef STAGE15_GUARDED_CRAWL_TEST
#define STAGE15_GUARDED_CRAWL_TEST 0
#endif

#ifndef STAGE15_MAX_CMD
#define STAGE15_MAX_CMD 0.06
#endif

#ifndef STAGE15_PULSE_MS
#define STAGE15_PULSE_MS 200
#endif

#ifndef STAGE15_INTER_PULSE_MS
#define STAGE15_INTER_PULSE_MS 2000
#endif

#ifndef STAGE15_REQUIRE_RC_NEUTRAL
#define STAGE15_REQUIRE_RC_NEUTRAL 0
#endif

#ifndef STAGE16_USB_GUARDED_CRAWL
#define STAGE16_USB_GUARDED_CRAWL 0
#endif

#ifndef STAGE16_MAX_CMD
#define STAGE16_MAX_CMD 0.04
#endif

#ifndef STAGE16_MAX_MS
#define STAGE16_MAX_MS 150
#endif

#ifndef STAGE17_FIRST_PRIMITIVE_CRAWL
#define STAGE17_FIRST_PRIMITIVE_CRAWL 0
#endif

#ifndef STAGE17_MAX_CMD
#define STAGE17_MAX_CMD 0.06
#endif

#ifndef STAGE17_MAX_MS
#define STAGE17_MAX_MS 500
#endif

#ifndef STAGE18_MOTOR_MAPPING_PROBE
#define STAGE18_MOTOR_MAPPING_PROBE 0
#endif

#ifndef STAGE18_MAX_CMD
#define STAGE18_MAX_CMD 0.08
#endif

#ifndef STAGE18_MAX_MS
#define STAGE18_MAX_MS 800
#endif

#ifndef STATION_DRIVE_GUARDED
#define STATION_DRIVE_GUARDED 0
#endif

#ifndef STATION_DRIVE_IGNORE_RC_INPUT
#define STATION_DRIVE_IGNORE_RC_INPUT 0
#endif

#ifndef STATION_DRIVE_MAX_ABS_A
#define STATION_DRIVE_MAX_ABS_A 0.35
#endif

#ifndef STATION_DRIVE_MAX_ABS_B
#define STATION_DRIVE_MAX_ABS_B 0.35
#endif

#ifndef STATION_DRIVE_MAX_MS
#define STATION_DRIVE_MAX_MS 1000
#endif

#ifndef USB_PULSE_TEST_GUARDED
#define USB_PULSE_TEST_GUARDED 0
#endif

#ifndef USB_PULSE_TEST_IGNORE_RC_INPUT
#define USB_PULSE_TEST_IGNORE_RC_INPUT 0
#endif

#ifndef MAC_PHYSICAL_SUPERVISED
#define MAC_PHYSICAL_SUPERVISED 0
#endif

#ifndef USB_PULSE_TEST_MAX_ABS_A
#define USB_PULSE_TEST_MAX_ABS_A 0.35
#endif

#ifndef USB_PULSE_TEST_MAX_ABS_B
#define USB_PULSE_TEST_MAX_ABS_B 0.35
#endif

#ifndef USB_PULSE_TEST_MAX_MS
#define USB_PULSE_TEST_MAX_MS 1000
#endif

#ifndef USB_DRIVE_LIVE_ENABLE
#define USB_DRIVE_LIVE_ENABLE 0
#endif

#ifndef USB_DRIVE_LIVE_IGNORE_RC_INPUT
#define USB_DRIVE_LIVE_IGNORE_RC_INPUT 0
#endif

#ifndef USB_DRIVE_LIVE_MAX_ABS_A
#define USB_DRIVE_LIVE_MAX_ABS_A 0.35
#endif

#ifndef USB_DRIVE_LIVE_MAX_ABS_B
#define USB_DRIVE_LIVE_MAX_ABS_B 0.35
#endif

#ifndef USB_DRIVE_LIVE_MAX_DURATION_MS
#define USB_DRIVE_LIVE_MAX_DURATION_MS 3000
#endif

#ifndef USB_DRIVE_LIVE_UPDATE_TIMEOUT_MS
#define USB_DRIVE_LIVE_UPDATE_TIMEOUT_MS 350
#endif

#ifndef STATION_HW_MANUAL_ENABLE
#define STATION_HW_MANUAL_ENABLE 0
#endif

#ifndef STATION_HW_MANUAL_A_B_MAPPING
#define STATION_HW_MANUAL_A_B_MAPPING 0
#endif

#ifndef STATION_HW_MANUAL_IGNORE_RC_INPUT
#define STATION_HW_MANUAL_IGNORE_RC_INPUT 0
#endif

#ifndef STATION_HW_MANUAL_DIAGNOSE_ONLY
#define STATION_HW_MANUAL_DIAGNOSE_ONLY 0
#endif

#ifndef STATION_HW_MANUAL_MAX_ABS_A
#define STATION_HW_MANUAL_MAX_ABS_A 0.35
#endif

#ifndef STATION_HW_MANUAL_MAX_ABS_B
#define STATION_HW_MANUAL_MAX_ABS_B 0.35
#endif

#ifndef STAGE20_PHYSICAL_AB_GUARDED_CRAWL
#define STAGE20_PHYSICAL_AB_GUARDED_CRAWL 0
#endif

#ifndef STAGE20_MAX_ABS_A
#define STAGE20_MAX_ABS_A 0.25
#endif

#ifndef STAGE20_MAX_ABS_B
#define STAGE20_MAX_ABS_B 0.25
#endif

#ifndef STAGE20_MAX_MS
#define STAGE20_MAX_MS 300
#endif

#ifndef STATION_MANUAL_IGNORE_RC_INPUT
#define STATION_MANUAL_IGNORE_RC_INPUT 0
#endif

#if STATION_DRIVE_GUARDED
#undef STAGE20_PHYSICAL_AB_GUARDED_CRAWL
#define STAGE20_PHYSICAL_AB_GUARDED_CRAWL 1
#undef STAGE20_MAX_ABS_A
#define STAGE20_MAX_ABS_A STATION_DRIVE_MAX_ABS_A
#undef STAGE20_MAX_ABS_B
#define STAGE20_MAX_ABS_B STATION_DRIVE_MAX_ABS_B
#undef STAGE20_MAX_MS
#define STAGE20_MAX_MS STATION_DRIVE_MAX_MS
#undef STATION_MANUAL_IGNORE_RC_INPUT
#define STATION_MANUAL_IGNORE_RC_INPUT STATION_DRIVE_IGNORE_RC_INPUT
#endif

#if USB_PULSE_TEST_GUARDED
#undef STAGE20_PHYSICAL_AB_GUARDED_CRAWL
#define STAGE20_PHYSICAL_AB_GUARDED_CRAWL 1
#undef STAGE20_MAX_ABS_A
#define STAGE20_MAX_ABS_A USB_PULSE_TEST_MAX_ABS_A
#undef STAGE20_MAX_ABS_B
#define STAGE20_MAX_ABS_B USB_PULSE_TEST_MAX_ABS_B
#undef STAGE20_MAX_MS
#define STAGE20_MAX_MS USB_PULSE_TEST_MAX_MS
#undef STATION_MANUAL_IGNORE_RC_INPUT
#define STATION_MANUAL_IGNORE_RC_INPUT USB_PULSE_TEST_IGNORE_RC_INPUT
#endif

#if USB_DRIVE_LIVE_ENABLE
#undef STAGE20_PHYSICAL_AB_GUARDED_CRAWL
#define STAGE20_PHYSICAL_AB_GUARDED_CRAWL 1
#undef STAGE20_MAX_ABS_A
#define STAGE20_MAX_ABS_A USB_DRIVE_LIVE_MAX_ABS_A
#undef STAGE20_MAX_ABS_B
#define STAGE20_MAX_ABS_B USB_DRIVE_LIVE_MAX_ABS_B
#undef STAGE20_MAX_MS
#define STAGE20_MAX_MS USB_DRIVE_LIVE_MAX_DURATION_MS
#undef STATION_MANUAL_IGNORE_RC_INPUT
#define STATION_MANUAL_IGNORE_RC_INPUT USB_DRIVE_LIVE_IGNORE_RC_INPUT
#endif

#if STAGE15_GUARDED_CRAWL_TEST && \
    (PHYSICAL_PATH_FOLLOWING_ENABLE != 0 || PATH_FOLLOWING_ALLOW_MOTOR_OUTPUT != 0 || \
     PATH_FOLLOWING_DRYRUN != 0 || GROUND_CRAWL_TEST_MODE != 0 || AUTO_MOTION_ARMED != 0 || \
     STAGE16_USB_GUARDED_CRAWL != 0 || STAGE17_FIRST_PRIMITIVE_CRAWL != 0 || \
     STAGE18_MOTOR_MAPPING_PROBE != 0 || STAGE20_PHYSICAL_AB_GUARDED_CRAWL != 0)
#error "Stage 15 guarded crawl must not enable path following, autonomous motion, or path motor-output gates."
#endif

#if STAGE16_USB_GUARDED_CRAWL && \
    (PHYSICAL_PATH_FOLLOWING_ENABLE != 0 || PATH_FOLLOWING_ALLOW_MOTOR_OUTPUT != 0 || \
     PATH_FOLLOWING_DRYRUN != 0 || GROUND_CRAWL_TEST_MODE != 0 || AUTO_MOTION_ARMED != 0 || \
     STAGE15_GUARDED_CRAWL_TEST != 0 || STAGE17_FIRST_PRIMITIVE_CRAWL != 0 || \
     STAGE18_MOTOR_MAPPING_PROBE != 0 || STAGE20_PHYSICAL_AB_GUARDED_CRAWL != 0)
#error "Stage 16 guarded crawl must not enable path following, autonomous motion, Stage 15, or path motor-output gates."
#endif

#if STAGE17_FIRST_PRIMITIVE_CRAWL && \
    (PHYSICAL_PATH_FOLLOWING_ENABLE != 0 || PATH_FOLLOWING_ALLOW_MOTOR_OUTPUT != 0 || \
     PATH_FOLLOWING_DRYRUN != 0 || GROUND_CRAWL_TEST_MODE != 0 || AUTO_MOTION_ARMED != 0 || \
     STAGE15_GUARDED_CRAWL_TEST != 0 || STAGE16_USB_GUARDED_CRAWL != 0 || \
     STAGE18_MOTOR_MAPPING_PROBE != 0 || STAGE20_PHYSICAL_AB_GUARDED_CRAWL != 0)
#error "Stage 17 first-primitive crawl must not enable path following, autonomous motion, Stage 15, Stage 16, or path motor-output gates."
#endif

#if STAGE18_MOTOR_MAPPING_PROBE && \
    (PHYSICAL_PATH_FOLLOWING_ENABLE != 0 || PATH_FOLLOWING_ALLOW_MOTOR_OUTPUT != 0 || \
     PATH_FOLLOWING_DRYRUN != 0 || GROUND_CRAWL_TEST_MODE != 0 || AUTO_MOTION_ARMED != 0 || \
     STAGE15_GUARDED_CRAWL_TEST != 0 || STAGE16_USB_GUARDED_CRAWL != 0 || \
     STAGE17_FIRST_PRIMITIVE_CRAWL != 0 || STAGE20_PHYSICAL_AB_GUARDED_CRAWL != 0)
#error "Stage 18 motor mapping probe must not enable path following, autonomous motion, Stage 15, Stage 16, Stage 17, or path motor-output gates."
#endif

#if STAGE20_PHYSICAL_AB_GUARDED_CRAWL && \
    (PHYSICAL_PATH_FOLLOWING_ENABLE != 0 || PATH_FOLLOWING_ALLOW_MOTOR_OUTPUT != 0 || \
     PATH_FOLLOWING_DRYRUN != 0 || GROUND_CRAWL_TEST_MODE != 0 || AUTO_MOTION_ARMED != 0 || \
     STAGE15_GUARDED_CRAWL_TEST != 0 || STAGE16_USB_GUARDED_CRAWL != 0 || \
     STAGE17_FIRST_PRIMITIVE_CRAWL != 0 || STAGE18_MOTOR_MAPPING_PROBE != 0)
#error "Stage 20 physical A/B guarded crawl must not enable path following, autonomous motion, Stage 15, Stage 16, Stage 17, Stage 18, or path motor-output gates."
#endif

#if (MANUAL_RC_RECOVERY || MANUAL_CONTROL_PPM) && \
    (PHYSICAL_PATH_FOLLOWING_ENABLE != 0 || PATH_FOLLOWING_ALLOW_MOTOR_OUTPUT != 0 || \
     PATH_FOLLOWING_DRYRUN != 0 || GROUND_CRAWL_TEST_MODE != 0 || AUTO_MOTION_ARMED != 0 || \
     STAGE15_GUARDED_CRAWL_TEST != 0 || STAGE16_USB_GUARDED_CRAWL != 0 || \
     STAGE17_FIRST_PRIMITIVE_CRAWL != 0 || STAGE18_MOTOR_MAPPING_PROBE != 0 || \
     STAGE20_PHYSICAL_AB_GUARDED_CRAWL != 0)
#error "PPM manual control must not enable path following, autonomous motion, or guarded station pulse modes."
#endif

#ifndef GROUND_CRAWL_MAX_CMD
#define GROUND_CRAWL_MAX_CMD 0.08
#endif

#ifndef GROUND_CRAWL_MAX_AUTO_MS
#define GROUND_CRAWL_MAX_AUTO_MS 1200
#endif

#ifndef SINGLE_WP_CRAWL_BASE_CMD
#define SINGLE_WP_CRAWL_BASE_CMD 0.100
#endif

#ifndef SINGLE_WP_STEERING_DRYRUN
#define SINGLE_WP_STEERING_DRYRUN 0
#endif

#ifndef COURSE_MIN_DISPLACEMENT_M
#define COURSE_MIN_DISPLACEMENT_M 2.0
#endif

#ifndef GPS_COURSE_LATCH_DIAG
#define GPS_COURSE_LATCH_DIAG 1
#endif

#ifndef GPS_COURSE_LATCH_DIAG_MAX_AGE_MS
#define GPS_COURSE_LATCH_DIAG_MAX_AGE_MS 5000
#endif

#ifndef GPS_COURSE_OUTPUT_LATCH_MS
#define GPS_COURSE_OUTPUT_LATCH_MS GPS_COURSE_LATCH_DIAG_MAX_AGE_MS
#endif

// 0-based PPM index of the Manual/Auto switch channel. Default 4 = receiver CH5.
// Override only after firmware/ppm_channel_map_probe proves a stable 2-position
// switch channel. This does not weaken failsafe or change motion gates.
#ifndef MODE_CHANNEL_INDEX
#define MODE_CHANNEL_INDEX 4
#endif

// ---- Path-following dry-run / guarded execution (Tasks E/F/G) ----
// PATH_FOLLOWING_DRYRUN is a self-contained top-level mode. It computes waypoint
// distance/bearing/heading/steering diagnostics and NEVER drives motors unless
// every gate below is satisfied. All four motion gates default to 0, so the
// default build (and the dry-run build) can never move motors.
#ifndef PATH_FOLLOWING_DRYRUN
#define PATH_FOLLOWING_DRYRUN 0
#endif
#ifndef PHYSICAL_PATH_FOLLOWING_ENABLE
#define PHYSICAL_PATH_FOLLOWING_ENABLE 0
#endif
#ifndef PATH_FOLLOWING_ALLOW_MOTOR_OUTPUT
#define PATH_FOLLOWING_ALLOW_MOTOR_OUTPUT 0
#endif
// Operator acknowledgement that the RC/PPM Manual/Auto channel is stable. The
// current hardware blocker (CH5 did not hold HIGH) means this must stay 0 until
// firmware/ppm_channel_map_probe proves a stable 2-position switch.
#ifndef PATH_FOLLOWING_MODE_CHANNEL_STABLE
#define PATH_FOLLOWING_MODE_CHANNEL_STABLE 0
#endif
// Allow a compile-time mock current position so the dry-run works indoors with
// no GPS fix. Mock position cannot produce a heading, so it can never satisfy
// the physical-output gate.
#ifndef PATH_FOLLOWING_ALLOW_MOCK_POSITION
#define PATH_FOLLOWING_ALLOW_MOCK_POSITION 1
#endif
#ifndef PATH_FOLLOWING_MOCK_CURRENT_LAT
#define PATH_FOLLOWING_MOCK_CURRENT_LAT 35.5705500
#endif
#ifndef PATH_FOLLOWING_MOCK_CURRENT_LON
#define PATH_FOLLOWING_MOCK_CURRENT_LON 129.1871000
#endif
// Hard caps for any guarded physical output.
#ifndef PATH_FOLLOWING_MAX_FORWARD_CMD
#define PATH_FOLLOWING_MAX_FORWARD_CMD 0.18
#endif
#ifndef PATH_FOLLOWING_MAX_TURN_CMD
#define PATH_FOLLOWING_MAX_TURN_CMD 0.04
#endif
#ifndef PATH_FOLLOWING_MAX_AUTO_MS
#define PATH_FOLLOWING_MAX_AUTO_MS 500
#endif
#ifndef PATH_FOLLOWING_ARRIVAL_RADIUS_M
#define PATH_FOLLOWING_ARRIVAL_RADIUS_M 2.0
#endif
#ifndef PATH_FOLLOWING_MIN_TARGET_DISTANCE_M
#define PATH_FOLLOWING_MIN_TARGET_DISTANCE_M 3.0
#endif
#ifndef PATH_FOLLOWING_MAX_TARGET_DISTANCE_M
#define PATH_FOLLOWING_MAX_TARGET_DISTANCE_M 20.0
#endif
// HC-12 waypoint protocol for the dry-run. It must be on a UART different from
// GPS (Serial2); 1=Serial1, 3=Serial3. Serial2 is rejected at compile time.
#ifndef PATH_FOLLOWING_HC12_ENABLED
#define PATH_FOLLOWING_HC12_ENABLED 1
#endif
#ifndef PATH_FOLLOWING_HC12_SERIAL_PORT
#define PATH_FOLLOWING_HC12_SERIAL_PORT 3
#endif
#ifndef PATH_FOLLOWING_HC12_CMD_STALE_MS
#define PATH_FOLLOWING_HC12_CMD_STALE_MS 2000
#endif
// Compile-time path (override per-waypoint with -D...). Defaults are real nearby
// coordinates from the documented test site, forming a short multi-leg path.
#ifndef PATH_FOLLOWING_WP_COUNT
#define PATH_FOLLOWING_WP_COUNT 3
#endif
#ifndef PATH_FOLLOWING_WP1_LAT
#define PATH_FOLLOWING_WP1_LAT 35.5706361
#endif
#ifndef PATH_FOLLOWING_WP1_LON
#define PATH_FOLLOWING_WP1_LON 129.1870540
#endif
#ifndef PATH_FOLLOWING_WP2_LAT
#define PATH_FOLLOWING_WP2_LAT 35.5707680
#endif
#ifndef PATH_FOLLOWING_WP2_LON
#define PATH_FOLLOWING_WP2_LON 129.1867906
#endif
#ifndef PATH_FOLLOWING_WP3_LAT
#define PATH_FOLLOWING_WP3_LAT 35.5705010
#endif
#ifndef PATH_FOLLOWING_WP3_LON
#define PATH_FOLLOWING_WP3_LON 129.1872696
#endif

#define STRINGIFY_VALUE_IMPL(value) #value
#define STRINGIFY_VALUE(value) STRINGIFY_VALUE_IMPL(value)

#define ENABLE_GPS_TELEMETRY 1
#if MOTOR_PULSE_TEST_MODE || FIXED_WIRING_GPS_SERIAL2_DIAG || \
    FIXED_WIRING_GPS_SERIAL2_RC_AUTONOMY_DRYRUN || \
    FIXED_WIRING_GPS_SERIAL2_SINGLE_WAYPOINT_EXPERIMENT || PATH_FOLLOWING_DRYRUN || \
    STAGE15_GUARDED_CRAWL_TEST || STAGE16_USB_GUARDED_CRAWL || \
    STAGE17_FIRST_PRIMITIVE_CRAWL || STAGE18_MOTOR_MAPPING_PROBE || \
    STAGE20_PHYSICAL_AB_GUARDED_CRAWL || MANUAL_RC_RECOVERY || MANUAL_CONTROL_PPM
// GPS owns Serial2 here. The legacy station HC-12 command stack (which can drive
// motors via CMD,MANUAL/CMD,AUTO) stays disabled. Path-following mode runs its
// own motor-free HC-12 waypoint protocol on a separate UART (Serial1/Serial3).
#define HC12_LINK_ENABLED 0
#define GPS_SERIAL Serial2
#else
#define HC12_LINK_ENABLED 1
#define HC12_SERIAL Serial2
#define GPS_SERIAL Serial3
#endif

constexpr const char *FIRMWARE_ID = "openrb_robot_controller station-hw-manual usb-pulse-test rc-arcade-manual-fwdneg 2026-05-30";
constexpr uint8_t PPM_PIN = 6;
constexpr uint8_t ESC_LEFT_PIN = 4;
constexpr uint8_t ESC_RIGHT_PIN = 5;
constexpr long HC12_BAUD = 9600;
constexpr long GPS_BAUD = 9600;
constexpr long USB_BAUD = 115200;

constexpr uint32_t GPS_DRYRUN_STALE_MS = 2000;
constexpr uint8_t GPS_DRYRUN_MIN_SATS = 4;
constexpr double GPS_DRYRUN_MAX_HDOP = 6.0;
constexpr uint32_t GPS_MOTION_STALE_MS = 2000;
constexpr uint8_t GPS_MOTION_MIN_SATS = 5;
constexpr double GPS_MOTION_MAX_HDOP = 2.5;
constexpr uint32_t GPS_STALE_MS = GPS_MOTION_STALE_MS;
constexpr uint8_t GPS_MIN_SATS = GPS_MOTION_MIN_SATS;
constexpr double GPS_MAX_HDOP = GPS_MOTION_MAX_HDOP;
constexpr bool MOTOR_PULSE_ENABLED = MOTOR_PULSE_TEST_MODE != 0;
constexpr bool MANUAL_RC_RECOVERY_ENABLED = MANUAL_RC_RECOVERY != 0;
constexpr bool MANUAL_CONTROL_PPM_ENABLED = MANUAL_CONTROL_PPM != 0;
constexpr bool MOTOR_TRACE_ENABLED =
    MOTOR_TRACE_ENABLE != 0 && !(MANUAL_RC_RECOVERY != 0 || MANUAL_CONTROL_PPM != 0);
constexpr float MOTOR_PULSE_CMD_VALUE = MOTOR_PULSE_CMD;
constexpr float MOTOR_PULSE_LEFT_CMD_VALUE = MOTOR_PULSE_LEFT_CMD;
constexpr float MOTOR_PULSE_RIGHT_CMD_VALUE = MOTOR_PULSE_RIGHT_CMD;
constexpr uint32_t MOTOR_PULSE_MS_VALUE = MOTOR_PULSE_MS;
constexpr bool DRIVE_CALIBRATION_ENABLED = DRIVE_CALIBRATION_ENABLE != 0;
constexpr float LEFT_MOTOR_SIGN_VALUE = LEFT_MOTOR_SIGN;
constexpr float RIGHT_MOTOR_SIGN_VALUE = RIGHT_MOTOR_SIGN;
constexpr float LEFT_MOTOR_SCALE_VALUE = LEFT_MOTOR_SCALE;
constexpr float RIGHT_MOTOR_SCALE_VALUE = RIGHT_MOTOR_SCALE;
constexpr float LEFT_MOTOR_MIN_CMD_VALUE = LEFT_MOTOR_MIN_CMD;
constexpr float RIGHT_MOTOR_MIN_CMD_VALUE = RIGHT_MOTOR_MIN_CMD;
constexpr bool MOTOR_OUTPUT_SWAP_LR_ENABLED = MOTOR_OUTPUT_SWAP_LR != 0;
constexpr float MANUAL_FORWARD_SIGN_VALUE = MANUAL_FORWARD_SIGN;
constexpr float MANUAL_TURN_SIGN_VALUE = MANUAL_TURN_SIGN;
constexpr bool STAGE15_GUARDED_CRAWL_ENABLED = STAGE15_GUARDED_CRAWL_TEST != 0;
constexpr float STAGE15_MAX_CMD_VALUE = STAGE15_MAX_CMD;
constexpr uint32_t STAGE15_PULSE_MS_VALUE = STAGE15_PULSE_MS;
constexpr uint32_t STAGE15_INTER_PULSE_MS_VALUE = STAGE15_INTER_PULSE_MS;
constexpr bool STAGE15_REQUIRE_RC_NEUTRAL_VALUE = STAGE15_REQUIRE_RC_NEUTRAL != 0;
constexpr bool STAGE16_USB_GUARDED_CRAWL_ENABLED = STAGE16_USB_GUARDED_CRAWL != 0;
constexpr float STAGE16_MAX_CMD_VALUE = STAGE16_MAX_CMD;
constexpr uint32_t STAGE16_MAX_MS_VALUE = STAGE16_MAX_MS;
constexpr bool STAGE17_FIRST_PRIMITIVE_CRAWL_ENABLED = STAGE17_FIRST_PRIMITIVE_CRAWL != 0;
constexpr float STAGE17_MAX_CMD_VALUE = STAGE17_MAX_CMD;
constexpr uint32_t STAGE17_MAX_MS_VALUE = STAGE17_MAX_MS;
constexpr bool STAGE18_MOTOR_MAPPING_PROBE_ENABLED = STAGE18_MOTOR_MAPPING_PROBE != 0;
constexpr float STAGE18_MAX_CMD_VALUE = STAGE18_MAX_CMD;
constexpr uint32_t STAGE18_MAX_MS_VALUE = STAGE18_MAX_MS;
constexpr bool STATION_DRIVE_GUARDED_ENABLED = STATION_DRIVE_GUARDED != 0;
constexpr bool USB_PULSE_TEST_GUARDED_ENABLED = USB_PULSE_TEST_GUARDED != 0;
constexpr bool USB_DRIVE_LIVE_ENABLED = USB_DRIVE_LIVE_ENABLE != 0;
constexpr bool USB_DRIVE_LIVE_IGNORE_RC_INPUT_ENABLED = USB_DRIVE_LIVE_IGNORE_RC_INPUT != 0;
constexpr float USB_DRIVE_LIVE_MAX_ABS_A_VALUE = USB_DRIVE_LIVE_MAX_ABS_A;
constexpr float USB_DRIVE_LIVE_MAX_ABS_B_VALUE = USB_DRIVE_LIVE_MAX_ABS_B;
constexpr uint32_t USB_DRIVE_LIVE_MAX_DURATION_MS_VALUE = USB_DRIVE_LIVE_MAX_DURATION_MS;
constexpr uint32_t USB_DRIVE_LIVE_UPDATE_TIMEOUT_MS_VALUE = USB_DRIVE_LIVE_UPDATE_TIMEOUT_MS;
constexpr bool STATION_HW_MANUAL_ENABLED = STATION_HW_MANUAL_ENABLE != 0;
constexpr bool STATION_HW_MANUAL_A_B_MAPPING_ENABLED =
    STATION_HW_MANUAL_ENABLE != 0 && STATION_HW_MANUAL_A_B_MAPPING != 0;
constexpr bool STATION_HW_MANUAL_DIAGNOSE_ONLY_ENABLED =
    STATION_HW_MANUAL_ENABLE != 0 && STATION_HW_MANUAL_DIAGNOSE_ONLY != 0;
constexpr float STATION_HW_MANUAL_MAX_ABS_A_VALUE = STATION_HW_MANUAL_MAX_ABS_A;
constexpr float STATION_HW_MANUAL_MAX_ABS_B_VALUE = STATION_HW_MANUAL_MAX_ABS_B;
constexpr bool STAGE20_PHYSICAL_AB_GUARDED_CRAWL_ENABLED = STAGE20_PHYSICAL_AB_GUARDED_CRAWL != 0;
constexpr bool STATION_MANUAL_IGNORE_RC_INPUT_ENABLED =
    STAGE20_PHYSICAL_AB_GUARDED_CRAWL != 0 && STATION_MANUAL_IGNORE_RC_INPUT != 0;
constexpr float STAGE20_MAX_ABS_A_VALUE = STAGE20_MAX_ABS_A;
constexpr float STAGE20_MAX_ABS_B_VALUE = STAGE20_MAX_ABS_B;
constexpr uint32_t STAGE20_MAX_MS_VALUE = STAGE20_MAX_MS;
constexpr bool STAGE_USB_GUARDED_CRAWL_ENABLED =
    STAGE16_USB_GUARDED_CRAWL != 0 || STAGE17_FIRST_PRIMITIVE_CRAWL != 0 ||
    STAGE18_MOTOR_MAPPING_PROBE != 0 || STAGE20_PHYSICAL_AB_GUARDED_CRAWL != 0;
constexpr float STAGE_USB_GUARDED_MAX_CMD_VALUE =
    STAGE20_PHYSICAL_AB_GUARDED_CRAWL ? STAGE20_MAX_ABS_A :
    (STAGE18_MOTOR_MAPPING_PROBE ? STAGE18_MAX_CMD : (STAGE17_FIRST_PRIMITIVE_CRAWL ? STAGE17_MAX_CMD : STAGE16_MAX_CMD));
constexpr float STAGE_USB_GUARDED_MAX_B_VALUE =
    STAGE20_PHYSICAL_AB_GUARDED_CRAWL ? STAGE20_MAX_ABS_B : STAGE_USB_GUARDED_MAX_CMD_VALUE;
constexpr uint32_t STAGE_USB_GUARDED_MAX_MS_VALUE =
    STAGE20_PHYSICAL_AB_GUARDED_CRAWL ? STAGE20_MAX_MS :
    (STAGE18_MOTOR_MAPPING_PROBE ? STAGE18_MAX_MS : (STAGE17_FIRST_PRIMITIVE_CRAWL ? STAGE17_MAX_MS : STAGE16_MAX_MS));
constexpr bool DRYRUN_TARGET_AVAILABLE = true;
constexpr double DRYRUN_TARGET_LAT = 35.571120;
constexpr double DRYRUN_TARGET_LON = 129.186050;
constexpr uint32_t DRYRUN_GPS_READY_MAX_AGE_MS = GPS_DRYRUN_STALE_MS;
constexpr bool SINGLE_WAYPOINT_TARGET_AVAILABLE = true;
constexpr double SINGLE_WAYPOINT_FALLBACK_TARGET_LAT = 35.571120;
constexpr double SINGLE_WAYPOINT_FALLBACK_TARGET_LON = 129.186050;
#if defined(SINGLE_WP_TARGET_LAT) && defined(SINGLE_WP_TARGET_LON)
constexpr bool SINGLE_WAYPOINT_TARGET_OVERRIDE_ENABLED = true;
constexpr double SINGLE_WAYPOINT_TARGET_LAT = SINGLE_WP_TARGET_LAT;
constexpr double SINGLE_WAYPOINT_TARGET_LON = SINGLE_WP_TARGET_LON;
constexpr const char *SINGLE_WAYPOINT_TARGET_SOURCE = "compile_time";
#else
constexpr bool SINGLE_WAYPOINT_TARGET_OVERRIDE_ENABLED = false;
constexpr double SINGLE_WAYPOINT_TARGET_LAT = SINGLE_WAYPOINT_FALLBACK_TARGET_LAT;
constexpr double SINGLE_WAYPOINT_TARGET_LON = SINGLE_WAYPOINT_FALLBACK_TARGET_LON;
constexpr const char *SINGLE_WAYPOINT_TARGET_SOURCE = "fallback";
#endif
#if defined(SINGLE_WP_TARGET_LAT)
constexpr const char *SINGLE_WAYPOINT_TARGET_LAT_MACRO = STRINGIFY_VALUE(SINGLE_WP_TARGET_LAT);
#else
constexpr const char *SINGLE_WAYPOINT_TARGET_LAT_MACRO = "NA";
#endif
#if defined(SINGLE_WP_TARGET_LON)
constexpr const char *SINGLE_WAYPOINT_TARGET_LON_MACRO = STRINGIFY_VALUE(SINGLE_WP_TARGET_LON);
#else
constexpr const char *SINGLE_WAYPOINT_TARGET_LON_MACRO = "NA";
#endif
constexpr bool SINGLE_WAYPOINT_AUTO_MOTION_ARMED = AUTO_MOTION_ARMED != 0;
constexpr float SINGLE_WAYPOINT_CRAWL_BASE_CMD = SINGLE_WP_CRAWL_BASE_CMD;
constexpr bool SINGLE_WAYPOINT_STEERING_DRYRUN_ENABLED = SINGLE_WP_STEERING_DRYRUN != 0;
constexpr double SINGLE_WAYPOINT_ARRIVAL_RADIUS_M = 2.5;
constexpr double SINGLE_WAYPOINT_MAX_TARGET_DISTANCE_M = 30.0;
constexpr double SINGLE_WAYPOINT_MAX_COORD_SANITY_DISTANCE_M = 1000.0;
constexpr uint32_t SINGLE_WAYPOINT_GPS_STALE_MS = GPS_DRYRUN_STALE_MS;
constexpr double SINGLE_WAYPOINT_MAX_HDOP = GPS_DRYRUN_MAX_HDOP;
constexpr uint32_t SINGLE_WAYPOINT_AUTO_TIMEOUT_MS = 15000;
constexpr double SINGLE_WAYPOINT_COURSE_MIN_DISPLACEMENT_M = COURSE_MIN_DISPLACEMENT_M;
constexpr const char *SINGLE_WAYPOINT_COURSE_MIN_DISPLACEMENT_SOURCE = STRINGIFY_VALUE(COURSE_MIN_DISPLACEMENT_M);
constexpr bool GPS_COURSE_LATCH_DIAG_ENABLED = GPS_COURSE_LATCH_DIAG != 0;
constexpr uint32_t GPS_COURSE_OUTPUT_LATCH_MS_VALUE = GPS_COURSE_OUTPUT_LATCH_MS;

constexpr bool     GROUND_CRAWL_ENABLED = GROUND_CRAWL_TEST_MODE != 0;
constexpr float    GROUND_CRAWL_MAX_CMD_VALUE = GROUND_CRAWL_MAX_CMD;
constexpr uint32_t GROUND_CRAWL_MAX_AUTO_MS_VALUE = GROUND_CRAWL_MAX_AUTO_MS;
constexpr double   GROUND_CRAWL_MIN_TARGET_DISTANCE_M = 5.0;
constexpr double   GROUND_CRAWL_MAX_TARGET_DISTANCE_M = 20.0;

constexpr uint8_t CHANNEL_COUNT = 8;
// Printed transmitter labels are 1-based (CH1-CH8), while ppmChannels[] uses 0-based indexes.
// The integrated station controller can physically look like CH7 at the panel,
// but the receiver PPM mapping used by firmware is CH1 steering, CH2 throttle,
// and CH5 Manual/Auto. CH7 is reserved/unused for now.
constexpr uint8_t STEERING_CHANNEL_INDEX = 0;  // Station joystick horizontal: PPM CH1
constexpr uint8_t THROTTLE_CHANNEL_INDEX = 1;  // Station joystick vertical: PPM CH2
constexpr uint8_t MODE_CHANNEL_INDEX_VALUE = MODE_CHANNEL_INDEX;  // Manual/Auto switch (default PPM CH5)
constexpr uint16_t STEERING_CENTER_US = 1504;
constexpr uint16_t THROTTLE_CENTER_US = 1500;
constexpr uint16_t RC_DEADBAND_US = 80;
constexpr uint16_t RC_MIN_VALID_US = 900;
constexpr uint16_t RC_MAX_VALID_US = 2100;
constexpr uint16_t RC_AUTO_SWITCH_ON_US = 1600;
constexpr uint16_t PPM_SYNC_US = PPM_SYNC_THRESHOLD_US;
constexpr uint16_t PPM_CAPTURE_MIN_US = PPM_CAPTURE_MIN_US_VALUE;
constexpr uint16_t PPM_CAPTURE_MAX_US = PPM_CAPTURE_MAX_US_VALUE;
constexpr uint32_t RC_FRAME_TIMEOUT_MS = 500;
constexpr uint8_t PPM_REQUIRED_CHANNEL_COUNT = MODE_CHANNEL_INDEX_VALUE + 1;
constexpr bool PPM_INTERRUPT_EDGE_FALLING_ENABLED = PPM_INTERRUPT_EDGE_FALLING != 0;
constexpr const char *PPM_INTERRUPT_EDGE_NAME = PPM_INTERRUPT_EDGE_FALLING_ENABLED ? "FALLING" : "RISING";
constexpr float RC_MANUAL_AXIS_ROTATION_SCALE = 0.70710678f;
constexpr uint16_t ESC_NEUTRAL_US = 1500;
constexpr uint16_t ESC_RANGE_US = 300;
constexpr uint32_t STATION_TIMEOUT_MS = 500;
constexpr float STATION_MANUAL_MAX_OUTPUT = 0.25f;
constexpr uint32_t TELEMETRY_PERIOD_MS = 1000;
constexpr uint32_t STATUS_PERIOD_MS = 500;
constexpr bool ENABLE_USB_DEBUG = true;
constexpr uint32_t USB_DEBUG_PERIOD_MS = MOTOR_PULSE_TEST_MODE ? 100 : 500;

enum RobotMode {
  DISARMED,
  MANUAL,
  AUTO_READY,
  AUTO_RUNNING,
  LINK_LOST,
  FAILSAFE
};

enum ControlSource {
  CONTROL_SOURCE_STOP,
  CONTROL_SOURCE_RC_MANUAL,
  CONTROL_SOURCE_STATION_MANUAL,
  CONTROL_SOURCE_AUTO
};

struct StationManualCommand {
  float steer;
  float throttle;
  bool deadman;
  uint32_t lastFrameMs;
};

#if ENABLE_GPS_TELEMETRY
TinyGPSPlus gps;
String gpsNmeaLine;
char lastRmcStatus = '\0';
int lastGgaFixQuality = -1;
#endif
Servo escLeft;
Servo escRight;

volatile uint16_t ppmChannels[CHANNEL_COUNT] = {0};
volatile uint8_t ppmIndex = 0;
volatile uint8_t ppmLastFrameChannelCount = 0;
volatile uint32_t lastPpmEdgeMicros = 0;
volatile uint32_t lastPpmFrameMs = 0;
volatile uint32_t lastPpmSyncMs = 0;
volatile uint32_t ppmIsrEdgeCount = 0;
volatile uint32_t ppmSyncPulseCount = 0;
volatile uint32_t ppmAcceptedFrameCount = 0;
volatile uint32_t ppmIncompleteFrameCount = 0;
volatile uint32_t ppmShortPulseRejectCount = 0;
volatile uint32_t ppmLongPulseRejectCount = 0;
volatile uint16_t ppmLastRejectedPulseUs = 0;
volatile uint16_t ppmLastWidthUs = 0;
volatile uint16_t ppmMinWidthUs = 65535;
volatile uint16_t ppmMaxWidthUs = 0;

RobotMode currentMode = DISARMED;
String hc12Line;
uint32_t lastStationFrameMs = 0;
long lastStationSeq = -1;
uint32_t stationHc12RxCount = 0;
uint32_t stationHc12TxCount = 0;
uint32_t stationFrameCount = 0;
uint32_t stationParseOkCount = 0;
uint32_t stationParseErrorCount = 0;
uint8_t stationRawDumpCount = 0;
StationManualCommand stationManual = {0.0f, 0.0f, false, 0};
bool stationEstop = false;
bool autoCommandActive = false;
uint32_t lastTelemetryMs = 0;
uint32_t lastStatusMs = 0;
uint32_t lastUsbDebugMs = 0;
ControlSource currentControlSource = CONTROL_SOURCE_STOP;
float autoLeftCmd = 0.0f;
float autoRightCmd = 0.0f;
float lastLeftOutputCmd = 0.0f;
float lastRightOutputCmd = 0.0f;
float lastLogicalLeftCmd = 0.0f;
float lastLogicalRightCmd = 0.0f;
float lastRawLeftCmd = 0.0f;
float lastRawRightCmd = 0.0f;
float lastCalibratedLeftCmd = 0.0f;
float lastCalibratedRightCmd = 0.0f;
float lastOutputLeftPinCmd = 0.0f;
float lastOutputRightPinCmd = 0.0f;
bool lastMixerBypassedForMotorPulse = false;
bool motorEscWriteInitialized = false;

#if FIXED_WIRING_GPS_SERIAL2_SINGLE_WAYPOINT_EXPERIMENT
bool singleWaypointAutoTimingActiveFlag = false;
uint32_t singleWaypointAutoEntryMs = 0;
uint32_t singleWaypointAutoElapsedMs = 0;
bool singleWaypointGpsReadyFlag = false;
bool singleWaypointDryrunReadyFlag = false;
bool singleWaypointMotionReadyFlag = false;
bool singleWaypointTargetReadyFlag = false;
bool singleWaypointTimeoutOkFlag = false;
bool singleWaypointDistanceAllowedFlag = false;
bool singleWaypointSafetyReadyFlag = false;
bool singleWaypointArrivedFlag = false;
bool singleWaypointAutoMotorInhibitFlag = true;
bool singleWaypointTargetComputedFlag = false;
bool singleWaypointGpsCoordSaneFlag = false;
double singleWaypointTargetDistanceM = 0.0;
double singleWaypointTargetBearingDeg = 0.0;
float singleWaypointCandidateLeftCmd = 0.0f;
float singleWaypointCandidateRightCmd = 0.0f;
bool steeringCourseReferenceValidFlag = false;
double steeringCourseReferenceLat = 0.0;
double steeringCourseReferenceLon = 0.0;
bool steeringHeadingReadyFlag = false;
double steeringEstimatedCourseDeg = 0.0;
double steeringBearingErrorDeg = 0.0;
float steeringDesiredForwardCmd = 0.0f;
float steeringDesiredTurnCmd = 0.0f;
float steeringDesiredLogicalLeftCmd = 0.0f;
float steeringDesiredLogicalRightCmd = 0.0f;
float steeringDesiredPhysicalACmd = 0.0f;
float steeringDesiredPhysicalBCmd = 0.0f;
double steeringCourseDisplacementM = 0.0;
const char *steeringBlockReason = "MODE_OFF";
bool groundCrawlNeutralOkFlag = false;
bool groundCrawlReadyFlag = false;
bool groundCrawlLatchedStopFlag = false;
uint32_t groundCrawlElapsedMs = 0;
float groundCrawlUnclampedLeftCmd = 0.0f;
float groundCrawlUnclampedRightCmd = 0.0f;
const char *groundCrawlBlockReason = "MODE_OFF";
#endif

#if MOTOR_PULSE_TEST_MODE
bool motorPulseTimingActiveFlag = false;
uint32_t motorPulseStartMs = 0;
uint32_t motorPulseElapsedMs = 0;
bool motorPulseLatchedStopFlag = false;
bool motorPulseReadyFlag = false;
const char *motorPulseBlockReason = "MODE_OFF";
#endif

#if STAGE15_GUARDED_CRAWL_TEST
String stage15UsbLine;
bool stage15PulseActiveFlag = false;
uint32_t stage15PulseStartMs = 0;
uint32_t stage15LastStopMs = 0;
uint32_t stage15PulseElapsedMs = 0;
const char *stage15PulseType = "test_stop";
float stage15PulseLeftCmd = 0.0f;
float stage15PulseRightCmd = 0.0f;
const char *stage15BlockReason = "WAITING_FOR_TRIGGER";
bool stage15FailsafeSeenFlag = false;
uint32_t stage15PulseSequence = 0;
#endif

#if STAGE16_USB_GUARDED_CRAWL || STAGE17_FIRST_PRIMITIVE_CRAWL || STAGE18_MOTOR_MAPPING_PROBE || STAGE20_PHYSICAL_AB_GUARDED_CRAWL
String stage16UsbLine;
bool stage16PulseActiveFlag = false;
uint32_t stage16PulseStartMs = 0;
uint32_t stage16PulseElapsedMs = 0;
int32_t stage16CmdSeq = -1;
float stage16LeftCmd = 0.0f;
float stage16RightCmd = 0.0f;
uint32_t stage16CmdMs = 0;
const char *stage16CmdState = "IDLE";
const char *stage16RejectReason = "NONE";
bool stage16LatchedStopFlag = false;
bool stage16ArmedFlag = false;
uint32_t stage16LastCmdMs = 0;
uint32_t stage16LastHeartbeatMs = 0;
bool usbDriveLiveActiveFlag = false;
int32_t usbDriveLiveSeq = -1;
float usbDriveLiveACmd = 0.0f;
float usbDriveLiveBCmd = 0.0f;
uint32_t usbDriveLiveStartMs = 0;
uint32_t usbDriveLiveLastUpdateMs = 0;
uint32_t usbDriveLiveDurationMs = 0;
uint32_t usbDriveLiveTtlMs = USB_DRIVE_LIVE_UPDATE_TIMEOUT_MS_VALUE;
const char *usbDriveLiveRejectReason = "NONE";
#endif

void printImuDiagFields();

void ppmISR() {
  uint32_t now = micros();
  ppmIsrEdgeCount++;
  if (lastPpmEdgeMicros == 0) {
    lastPpmEdgeMicros = now;
    return;
  }
  uint32_t width = now - lastPpmEdgeMicros;
  lastPpmEdgeMicros = now;
  uint16_t widthUs = width > 65535UL ? 65535 : static_cast<uint16_t>(width);
  ppmLastWidthUs = widthUs;
  if (widthUs < ppmMinWidthUs) {
    ppmMinWidthUs = widthUs;
  }
  if (widthUs > ppmMaxWidthUs) {
    ppmMaxWidthUs = widthUs;
  }

  if (width > PPM_SYNC_US) {
    uint32_t nowMs = millis();
    ppmSyncPulseCount++;
    ppmLastFrameChannelCount = ppmIndex;
    lastPpmSyncMs = nowMs;
    if (ppmIndex >= PPM_REQUIRED_CHANNEL_COUNT) {
      ppmAcceptedFrameCount++;
      lastPpmFrameMs = nowMs;
    } else if (ppmIndex > 0) {
      ppmIncompleteFrameCount++;
    }
    ppmIndex = 0;
    return;
  }

  if (ppmIndex == 0 && width < PPM_CAPTURE_MIN_US) {
    ppmShortPulseRejectCount++;
    ppmLastRejectedPulseUs = static_cast<uint16_t>(width);
    return;
  }

  if (ppmIndex < CHANNEL_COUNT) {
    ppmChannels[ppmIndex] = static_cast<uint16_t>(width);
    ppmIndex++;
  }
}

uint8_t checksumXor(const String &body) {
  uint8_t checksum = 0;
  for (size_t i = 0; i < body.length(); ++i) {
    checksum ^= static_cast<uint8_t>(body[i]);
  }
  return checksum;
}

void writeFrame(const char *type, uint32_t seq, const String &payload) {
#if HC12_LINK_ENABLED
  String body = String(type) + "," + String(seq);
  if (payload.length() > 0) {
    body += "," + payload;
  }

  uint8_t checksum = checksumXor(body);
  HC12_SERIAL.print("@");
  HC12_SERIAL.print(body);
  HC12_SERIAL.print("*");
  if (checksum < 0x10) {
    HC12_SERIAL.print("0");
  }
  HC12_SERIAL.println(checksum, HEX);
  stationHc12TxCount++;
#else
  (void)type;
  (void)seq;
  (void)payload;
#endif
}

bool motorOutputZeroState() {
  return (lastLogicalLeftCmd < 0.0f ? -lastLogicalLeftCmd : lastLogicalLeftCmd) <= 0.0001f &&
         (lastLogicalRightCmd < 0.0f ? -lastLogicalRightCmd : lastLogicalRightCmd) <= 0.0001f &&
         (lastLeftOutputCmd < 0.0f ? -lastLeftOutputCmd : lastLeftOutputCmd) <= 0.0001f &&
         (lastRightOutputCmd < 0.0f ? -lastRightOutputCmd : lastRightOutputCmd) <= 0.0001f &&
         (lastOutputLeftPinCmd < 0.0f ? -lastOutputLeftPinCmd : lastOutputLeftPinCmd) <= 0.0001f &&
         (lastOutputRightPinCmd < 0.0f ? -lastOutputRightPinCmd : lastOutputRightPinCmd) <= 0.0001f;
}

void printMotorTrace(const char *source, float requestedACmd, float requestedBCmd, bool motorWriteCalled) {
  if (!MOTOR_TRACE_ENABLED) {
    return;
  }

  Serial.print(F("MOTOR_TRACE timestamp_ms="));
  Serial.print(millis());
  Serial.print(F(" source="));
  Serial.print(source);
  Serial.print(F(" requested_a_cmd="));
  Serial.print(requestedACmd, 3);
  Serial.print(F(" requested_b_cmd="));
  Serial.print(requestedBCmd, 3);
  Serial.print(F(" physical_a_cmd="));
  Serial.print(lastOutputLeftPinCmd, 3);
  Serial.print(F(" physical_b_cmd="));
  Serial.print(lastOutputRightPinCmd, 3);
  Serial.print(F(" final_left_cmd="));
  Serial.print(lastLeftOutputCmd, 3);
  Serial.print(F(" final_right_cmd="));
  Serial.print(lastRightOutputCmd, 3);
  Serial.print(F(" output_left_pin_cmd="));
  Serial.print(lastOutputLeftPinCmd, 3);
  Serial.print(F(" output_right_pin_cmd="));
  Serial.print(lastOutputRightPinCmd, 3);
  Serial.print(F(" motor_write_called="));
  Serial.print(motorWriteCalled ? F("true") : F("false"));
  Serial.println();
}

void motorStopWithSource(const char *source) {
  if (motorEscWriteInitialized && motorOutputZeroState()) {
    return;
  }
  escLeft.writeMicroseconds(ESC_NEUTRAL_US);
  escRight.writeMicroseconds(ESC_NEUTRAL_US);
  motorEscWriteInitialized = true;
  lastLogicalLeftCmd = 0.0f;
  lastLogicalRightCmd = 0.0f;
  lastRawLeftCmd = 0.0f;
  lastRawRightCmd = 0.0f;
  lastCalibratedLeftCmd = 0.0f;
  lastCalibratedRightCmd = 0.0f;
  lastLeftOutputCmd = 0.0f;
  lastRightOutputCmd = 0.0f;
  lastOutputLeftPinCmd = 0.0f;
  lastOutputRightPinCmd = 0.0f;
  lastMixerBypassedForMotorPulse = false;
  printMotorTrace(source, 0.0f, 0.0f, true);
}

void motorStop() {
  motorStopWithSource("STOP");
}

void clearAutoCommand() {
  autoLeftCmd = 0.0f;
  autoRightCmd = 0.0f;
  autoCommandActive = false;
}

uint16_t clampPulse(int pulse) {
  if (pulse < ESC_NEUTRAL_US - ESC_RANGE_US) {
    return ESC_NEUTRAL_US - ESC_RANGE_US;
  }
  if (pulse > ESC_NEUTRAL_US + ESC_RANGE_US) {
    return ESC_NEUTRAL_US + ESC_RANGE_US;
  }
  return pulse;
}

float clampUnit(float value) {
  if (value > 1.0f) {
    return 1.0f;
  }
  if (value < -1.0f) {
    return -1.0f;
  }
  return value;
}

float absFloat(float value) {
  return value < 0.0f ? -value : value;
}

#if FIXED_WIRING_GPS_SERIAL2_RC_AUTONOMY_DRYRUN || \
    FIXED_WIRING_GPS_SERIAL2_SINGLE_WAYPOINT_EXPERIMENT || PATH_FOLLOWING_DRYRUN
double degreesToRadians(double degrees) {
  return degrees * 0.017453292519943295;
}

double radiansToDegrees(double radians) {
  return radians * 57.29577951308232;
}

double normalizeBearingDegrees(double degrees) {
  while (degrees < 0.0) {
    degrees += 360.0;
  }
  while (degrees >= 360.0) {
    degrees -= 360.0;
  }
  return degrees;
}

double normalizeBearingErrorDegrees(double degrees) {
  while (degrees <= -180.0) {
    degrees += 360.0;
  }
  while (degrees > 180.0) {
    degrees -= 360.0;
  }
  return degrees;
}

double dryrunDistanceMeters(double fromLat, double fromLon, double toLat, double toLon) {
  constexpr double earthRadiusMeters = 6371000.0;
  double lat1 = degreesToRadians(fromLat);
  double lat2 = degreesToRadians(toLat);
  double dLat = degreesToRadians(toLat - fromLat);
  double dLon = degreesToRadians(toLon - fromLon);
  double sinHalfLat = sin(dLat * 0.5);
  double sinHalfLon = sin(dLon * 0.5);
  double a = sinHalfLat * sinHalfLat + cos(lat1) * cos(lat2) * sinHalfLon * sinHalfLon;
  double c = 2.0 * atan2(sqrt(a), sqrt(1.0 - a));
  return earthRadiusMeters * c;
}

double dryrunBearingDegrees(double fromLat, double fromLon, double toLat, double toLon) {
  double lat1 = degreesToRadians(fromLat);
  double lat2 = degreesToRadians(toLat);
  double dLon = degreesToRadians(toLon - fromLon);
  double y = sin(dLon) * cos(lat2);
  double x = cos(lat1) * sin(lat2) - sin(lat1) * cos(lat2) * cos(dLon);
  return normalizeBearingDegrees(radiansToDegrees(atan2(y, x)));
}

bool dryrunGpsReady() {
  return gpsDryrunReady();
}
#endif

#if ENABLE_GPS_TELEMETRY
bool gpsLocationValid() {
  return gps.location.isValid();
}

bool gpsAgeOk(uint32_t staleMs) {
  return gpsLocationValid() && gps.location.age() <= staleMs;
}

bool gpsAgeOk() {
  return gpsAgeOk(GPS_MOTION_STALE_MS);
}

bool gpsNmeaFixKnown() {
  return lastRmcStatus != '\0' || lastGgaFixQuality >= 0;
}

bool gpsNmeaFixOk() {
  return lastRmcStatus == 'A' || lastGgaFixQuality >= 1;
}

bool gpsSolutionValid() {
  return gpsLocationValid() && gpsAgeOk(GPS_DRYRUN_STALE_MS) &&
         (!gpsNmeaFixKnown() || gpsNmeaFixOk());
}

bool gpsSatsOk() {
  return gps.satellites.isValid() && gps.satellites.value() >= GPS_MOTION_MIN_SATS;
}

bool gpsHdopOk() {
  return gps.hdop.isValid() && gps.hdop.hdop() <= GPS_MOTION_MAX_HDOP;
}

bool gpsDryrunSatsOk() {
  return gps.satellites.isValid() && gps.satellites.value() >= GPS_DRYRUN_MIN_SATS;
}

bool gpsDryrunHdopOk() {
  return gps.hdop.isValid() && gps.hdop.hdop() <= GPS_DRYRUN_MAX_HDOP;
}

bool gpsMotionSatsOk() {
  return gps.satellites.isValid() && gps.satellites.value() >= GPS_MOTION_MIN_SATS;
}

bool gpsMotionHdopOk() {
  return gps.hdop.isValid() && gps.hdop.hdop() <= GPS_MOTION_MAX_HDOP;
}

bool gpsDryrunReady() {
  return gpsSolutionValid() && gpsAgeOk(GPS_DRYRUN_STALE_MS) &&
         gpsDryrunSatsOk() && gpsDryrunHdopOk();
}

bool gpsMotionReady() {
  return gpsSolutionValid() && gpsAgeOk(GPS_MOTION_STALE_MS) &&
         gpsMotionSatsOk() && gpsMotionHdopOk();
}

bool gpsReady() {
  return gpsMotionReady();
}

const char *gpsTierBlockReason(uint32_t staleMs, uint8_t minSats, double maxHdop) {
  if (!gpsLocationValid()) {
    return "NO_LOCATION";
  }
  if (!gpsAgeOk(staleMs)) {
    return "STALE_LOCATION";
  }
  if (gpsNmeaFixKnown() && !gpsNmeaFixOk()) {
    return "NO_FIX_STATUS";
  }
  if (!gps.satellites.isValid() || gps.satellites.value() < minSats) {
    return "NO_SATS";
  }
  if (!gps.hdop.isValid() || gps.hdop.hdop() > maxHdop) {
    return "BAD_HDOP";
  }
  return "OK";
}

const char *gpsDryrunBlockReason() {
  const char *reason = gpsTierBlockReason(GPS_DRYRUN_STALE_MS, GPS_DRYRUN_MIN_SATS, GPS_DRYRUN_MAX_HDOP);
  return gpsDryrunReady() ? "OK" : reason;
}

const char *gpsMotionBlockReason() {
  const char *reason = gpsTierBlockReason(GPS_MOTION_STALE_MS, GPS_MOTION_MIN_SATS, GPS_MOTION_MAX_HDOP);
  return gpsMotionReady() ? "OK" : reason;
}

const char *gpsBlockReason() {
  return gpsMotionBlockReason();
}

bool nmeaSentenceType(const String &sentence, char a, char b, char c) {
  return sentence.length() >= 6 && sentence.charAt(0) == '$' &&
         ((sentence.charAt(1) == 'G' && sentence.charAt(2) == 'P') ||
          (sentence.charAt(1) == 'G' && sentence.charAt(2) == 'N')) &&
         sentence.charAt(3) == a && sentence.charAt(4) == b && sentence.charAt(5) == c;
}

bool nmeaField(const String &sentence, uint8_t index, String &field) {
  uint8_t current = 0;
  int start = 0;
  while (start < sentence.length()) {
    int end = sentence.indexOf(',', start);
    int checksum = sentence.indexOf('*', start);
    if (end < 0 || (checksum >= 0 && checksum < end)) {
      end = checksum >= 0 ? checksum : sentence.length();
    }
    if (current == index) {
      field = sentence.substring(start, end);
      return true;
    }
    if (end >= sentence.length() || sentence.charAt(end) == '*') {
      return false;
    }
    start = end + 1;
    current++;
  }
  return false;
}

void updateNmeaStatus(const String &sentence) {
  String field;
  if (nmeaSentenceType(sentence, 'R', 'M', 'C') && nmeaField(sentence, 2, field) && field.length() > 0) {
    lastRmcStatus = field.charAt(0);
  } else if (nmeaSentenceType(sentence, 'G', 'G', 'A') && nmeaField(sentence, 6, field) && field.length() > 0) {
    lastGgaFixQuality = field.toInt();
  }
}

void processGpsChar(char c) {
  gps.encode(c);
  if (c == '\n') {
    if (gpsNmeaLine.length() > 0) {
      updateNmeaStatus(gpsNmeaLine);
      gpsNmeaLine = "";
    }
  } else if (c != '\r') {
    if (gpsNmeaLine.length() < 96) {
      gpsNmeaLine += c;
    } else {
      gpsNmeaLine = "";
    }
  }
}
#endif

#if FIXED_WIRING_GPS_SERIAL2_SINGLE_WAYPOINT_EXPERIMENT
bool singleWaypointGpsReady() {
  return SINGLE_WAYPOINT_AUTO_MOTION_ARMED ? gpsMotionReady() : gpsDryrunReady();
}

void resetSteeringDryrunOutputs(const char *reason) {
  steeringHeadingReadyFlag = false;
  steeringEstimatedCourseDeg = 0.0;
  steeringBearingErrorDeg = 0.0;
  steeringDesiredForwardCmd = 0.0f;
  steeringDesiredTurnCmd = 0.0f;
  steeringDesiredLogicalLeftCmd = 0.0f;
  steeringDesiredLogicalRightCmd = 0.0f;
  steeringDesiredPhysicalACmd = 0.0f;
  steeringDesiredPhysicalBCmd = 0.0f;
  steeringCourseDisplacementM = 0.0;
  steeringBlockReason = reason;
}

void updateSingleWaypointSteeringDryrun() {
  if (!SINGLE_WAYPOINT_STEERING_DRYRUN_ENABLED) {
    resetSteeringDryrunOutputs("MODE_OFF");
    return;
  }

  if (!singleWaypointGpsReadyFlag || !gps.location.isValid()) {
    steeringCourseReferenceValidFlag = false;
    resetSteeringDryrunOutputs("GPS_NOT_READY");
    return;
  }

  double currentLat = gps.location.lat();
  double currentLon = gps.location.lng();
  if (!steeringCourseReferenceValidFlag) {
    steeringCourseReferenceLat = currentLat;
    steeringCourseReferenceLon = currentLon;
    steeringCourseReferenceValidFlag = true;
    resetSteeringDryrunOutputs("NO_HEADING");
    return;
  }

  steeringCourseDisplacementM =
      dryrunDistanceMeters(steeringCourseReferenceLat, steeringCourseReferenceLon, currentLat, currentLon);

  if (steeringCourseDisplacementM < SINGLE_WAYPOINT_COURSE_MIN_DISPLACEMENT_M) {
    double displacementM = steeringCourseDisplacementM;
    resetSteeringDryrunOutputs("NO_HEADING");
    steeringCourseDisplacementM = displacementM;
    return;
  }

  steeringEstimatedCourseDeg =
      dryrunBearingDegrees(steeringCourseReferenceLat, steeringCourseReferenceLon, currentLat, currentLon);
  steeringCourseReferenceLat = currentLat;
  steeringCourseReferenceLon = currentLon;

  if (!singleWaypointTargetComputedFlag) {
    double displacementM = steeringCourseDisplacementM;
    double estimatedCourseDeg = steeringEstimatedCourseDeg;
    resetSteeringDryrunOutputs("NO_TARGET");
    steeringCourseDisplacementM = displacementM;
    steeringEstimatedCourseDeg = estimatedCourseDeg;
    return;
  }

  steeringHeadingReadyFlag = true;
  steeringBearingErrorDeg =
      normalizeBearingErrorDegrees(singleWaypointTargetBearingDeg - steeringEstimatedCourseDeg);
  steeringDesiredForwardCmd = SINGLE_WAYPOINT_CRAWL_BASE_CMD;
  steeringDesiredTurnCmd =
      clampUnit(static_cast<float>(steeringBearingErrorDeg / 90.0)) * SINGLE_WAYPOINT_CRAWL_BASE_CMD;
  steeringDesiredLogicalLeftCmd = clampUnit(steeringDesiredForwardCmd + steeringDesiredTurnCmd);
  steeringDesiredLogicalRightCmd = clampUnit(steeringDesiredForwardCmd - steeringDesiredTurnCmd);
  steeringDesiredPhysicalACmd =
      clampUnit((steeringDesiredLogicalLeftCmd + steeringDesiredLogicalRightCmd) * 0.5f);
  steeringDesiredPhysicalBCmd =
      clampUnit((steeringDesiredLogicalRightCmd - steeringDesiredLogicalLeftCmd) * 0.5f);
  steeringBlockReason = "OK";
}

void updateSingleWaypointExperimentState(bool rcValid, bool autoSwitchOn, uint32_t now) {
  singleWaypointTargetReadyFlag = SINGLE_WAYPOINT_TARGET_AVAILABLE;
  singleWaypointDryrunReadyFlag = gpsDryrunReady();
  singleWaypointMotionReadyFlag = gpsMotionReady();
  singleWaypointGpsReadyFlag = singleWaypointGpsReady();
  singleWaypointTargetComputedFlag = singleWaypointTargetReadyFlag && singleWaypointGpsReadyFlag;
  singleWaypointGpsCoordSaneFlag = false;
  singleWaypointTargetDistanceM = 0.0;
  singleWaypointTargetBearingDeg = 0.0;
  singleWaypointArrivedFlag = false;
  singleWaypointDistanceAllowedFlag = false;

  if (singleWaypointTargetComputedFlag) {
    singleWaypointTargetDistanceM = dryrunDistanceMeters(
        gps.location.lat(), gps.location.lng(), SINGLE_WAYPOINT_TARGET_LAT, SINGLE_WAYPOINT_TARGET_LON);
    singleWaypointTargetBearingDeg = dryrunBearingDegrees(
        gps.location.lat(), gps.location.lng(), SINGLE_WAYPOINT_TARGET_LAT, SINGLE_WAYPOINT_TARGET_LON);
    singleWaypointGpsCoordSaneFlag =
        singleWaypointTargetDistanceM <= SINGLE_WAYPOINT_MAX_COORD_SANITY_DISTANCE_M;
    singleWaypointArrivedFlag = singleWaypointTargetDistanceM <= SINGLE_WAYPOINT_ARRIVAL_RADIUS_M;
    singleWaypointDistanceAllowedFlag =
        singleWaypointGpsCoordSaneFlag &&
        singleWaypointTargetDistanceM > SINGLE_WAYPOINT_ARRIVAL_RADIUS_M &&
        singleWaypointTargetDistanceM <= SINGLE_WAYPOINT_MAX_TARGET_DISTANCE_M;
  }

  bool autoCandidateActive = rcValid && autoSwitchOn;
  if (autoCandidateActive) {
    if (!singleWaypointAutoTimingActiveFlag) {
      singleWaypointAutoTimingActiveFlag = true;
      singleWaypointAutoEntryMs = now;
    }
    singleWaypointAutoElapsedMs = now - singleWaypointAutoEntryMs;
    singleWaypointTimeoutOkFlag = singleWaypointAutoElapsedMs <= SINGLE_WAYPOINT_AUTO_TIMEOUT_MS;
  } else {
    singleWaypointAutoTimingActiveFlag = false;
    singleWaypointAutoEntryMs = 0;
    singleWaypointAutoElapsedMs = 0;
    singleWaypointTimeoutOkFlag = true;
  }

  singleWaypointSafetyReadyFlag =
      rcValid && autoSwitchOn && singleWaypointGpsReadyFlag && singleWaypointTargetReadyFlag &&
      singleWaypointGpsCoordSaneFlag && singleWaypointDistanceAllowedFlag && singleWaypointTimeoutOkFlag;

  if (singleWaypointSafetyReadyFlag) {
    // Heading control is not implemented yet; this candidate is straight low-speed only.
    singleWaypointCandidateLeftCmd = SINGLE_WAYPOINT_CRAWL_BASE_CMD;
    singleWaypointCandidateRightCmd = SINGLE_WAYPOINT_CRAWL_BASE_CMD;
  } else {
    singleWaypointCandidateLeftCmd = 0.0f;
    singleWaypointCandidateRightCmd = 0.0f;
  }

  singleWaypointAutoMotorInhibitFlag =
      !SINGLE_WAYPOINT_AUTO_MOTION_ARMED || !singleWaypointSafetyReadyFlag;

  updateSingleWaypointSteeringDryrun();
}
#endif

#if MOTOR_PULSE_TEST_MODE
void updateMotorPulseState(bool rcValid, bool autoSwitchOn, bool rcManualActive,
                           uint16_t steeringUs, uint16_t throttleUs, uint32_t now) {
  bool neutralOk =
      normRcCentered(steeringUs, STEERING_CENTER_US) == 0.0f &&
      normRcCentered(throttleUs, THROTTLE_CENTER_US) == 0.0f;

  motorPulseReadyFlag = false;

  if (rcManualActive) {
    motorPulseLatchedStopFlag = false;
    motorPulseTimingActiveFlag = false;
    motorPulseStartMs = 0;
    motorPulseElapsedMs = 0;
    motorPulseBlockReason = "MODE_OFF";
    return;
  }

  if (!rcValid) {
    motorPulseTimingActiveFlag = false;
    motorPulseStartMs = 0;
    motorPulseElapsedMs = 0;
    motorPulseBlockReason = "RC_INVALID";
    return;
  }

  if (!autoSwitchOn) {
    motorPulseTimingActiveFlag = false;
    motorPulseStartMs = 0;
    motorPulseElapsedMs = 0;
    motorPulseBlockReason = "MODE_OFF";
    return;
  }

  if (motorPulseLatchedStopFlag) {
    motorPulseTimingActiveFlag = false;
    motorPulseBlockReason = "LATCHED_STOP";
    return;
  }

  if (!neutralOk) {
    motorPulseTimingActiveFlag = false;
    motorPulseStartMs = 0;
    motorPulseElapsedMs = 0;
    motorPulseBlockReason = "RC_NOT_NEUTRAL";
    return;
  }

  if (!motorPulseTimingActiveFlag) {
    motorPulseTimingActiveFlag = true;
    motorPulseStartMs = now;
  }

  motorPulseElapsedMs = now - motorPulseStartMs;
  if (motorPulseElapsedMs >= MOTOR_PULSE_MS_VALUE) {
    motorPulseLatchedStopFlag = true;
    motorPulseReadyFlag = false;
    motorPulseBlockReason = "LATCHED_STOP";
    return;
  }

  motorPulseReadyFlag = true;
  motorPulseBlockReason = "OK";
}
#endif

float clampGroundCrawl(float value) {
  if (value > GROUND_CRAWL_MAX_CMD_VALUE) return GROUND_CRAWL_MAX_CMD_VALUE;
  if (value < -GROUND_CRAWL_MAX_CMD_VALUE) return -GROUND_CRAWL_MAX_CMD_VALUE;
  return value;
}

float applyMotorCalibration(float raw, float sign, float scale, float minCmd) {
  if (!DRIVE_CALIBRATION_ENABLED) {
    return clampUnit(raw);
  }

  float calibrated = raw * sign * scale;
  float minMagnitude = absFloat(minCmd);
  if (calibrated > 0.0f && calibrated < minMagnitude) {
    calibrated = minMagnitude;
  } else if (calibrated < 0.0f && -calibrated < minMagnitude) {
    calibrated = -minMagnitude;
  }
  return clampUnit(calibrated);
}

void writeEscOutputPinsWithTrace(float physicalACmd, float physicalBCmd, const char *source,
                                 float requestedACmd, float requestedBCmd) {
  lastOutputLeftPinCmd = physicalACmd;
  lastOutputRightPinCmd = physicalBCmd;

  int leftPulse = ESC_NEUTRAL_US + static_cast<int>(physicalACmd * ESC_RANGE_US);
  int rightPulse = ESC_NEUTRAL_US + static_cast<int>(physicalBCmd * ESC_RANGE_US);
  escLeft.writeMicroseconds(clampPulse(leftPulse));
  escRight.writeMicroseconds(clampPulse(rightPulse));
  motorEscWriteInitialized = true;
  printMotorTrace(source, requestedACmd, requestedBCmd, true);
}

void writeEscOutputPins(float physicalACmd, float physicalBCmd) {
  writeEscOutputPinsWithTrace(physicalACmd, physicalBCmd, "PHYSICAL_OUTPUT", physicalACmd, physicalBCmd);
}

void applyDriveCommandInternal(float logicalLeft, float logicalRight, bool motorPulseDirectWheelMode) {
  // Inputs are direct logical wheel commands. Mixers, if any, must run before this function.
  lastLogicalLeftCmd = logicalLeft;
  lastLogicalRightCmd = logicalRight;
  lastRawLeftCmd = logicalLeft;
  lastRawRightCmd = logicalRight;
  lastMixerBypassedForMotorPulse = motorPulseDirectWheelMode;

  float calibratedLeft =
      applyMotorCalibration(logicalLeft, LEFT_MOTOR_SIGN_VALUE, LEFT_MOTOR_SCALE_VALUE, LEFT_MOTOR_MIN_CMD_VALUE);
  float calibratedRight =
      applyMotorCalibration(logicalRight, RIGHT_MOTOR_SIGN_VALUE, RIGHT_MOTOR_SCALE_VALUE, RIGHT_MOTOR_MIN_CMD_VALUE);

  lastCalibratedLeftCmd = calibratedLeft;
  lastCalibratedRightCmd = calibratedRight;

  float outputLeft = calibratedLeft;
  float outputRight = calibratedRight;
  if (MOTOR_OUTPUT_SWAP_LR_ENABLED) {
    outputLeft = calibratedRight;
    outputRight = calibratedLeft;
  }

  lastLeftOutputCmd = outputLeft;
  lastRightOutputCmd = outputRight;

  // Physical output channel A is throttle and channel B is turn.
  // Probe-confirmed wheel model:
  //   physical_left_wheel  = A - B
  //   physical_right_wheel = A + B
  // Therefore the inverse from logical wheel commands is:
  //   A = (left + right) / 2
  //   B = (right - left) / 2
  float physicalACmd = clampUnit((outputLeft + outputRight) * 0.5f);
  float physicalBCmd = clampUnit((outputRight - outputLeft) * 0.5f);

  writeEscOutputPinsWithTrace(physicalACmd, physicalBCmd, "WHEEL_MIXER", physicalACmd, physicalBCmd);
}

void applyDriveCommand(float logicalLeft, float logicalRight) {
  applyDriveCommandInternal(logicalLeft, logicalRight, false);
}

void applyMotorPulseDirectWheelCommand(float logicalLeft, float logicalRight) {
  applyDriveCommandInternal(logicalLeft, logicalRight, true);
}

void applyPhysicalABManualEquivalentCommandWithSource(float physicalACmd, float physicalBCmd, const char *source) {
  float a = clampUnit(physicalACmd);
  float b = clampUnit(physicalBCmd);
  float logicalLeft = clampUnit(a - b);
  float logicalRight = clampUnit(a + b);
  lastLogicalLeftCmd = logicalLeft;
  lastLogicalRightCmd = logicalRight;
  lastRawLeftCmd = logicalLeft;
  lastRawRightCmd = logicalRight;
  lastCalibratedLeftCmd = logicalLeft;
  lastCalibratedRightCmd = logicalRight;
  lastLeftOutputCmd = logicalLeft;
  lastRightOutputCmd = logicalRight;
  lastMixerBypassedForMotorPulse = true;
  writeEscOutputPinsWithTrace(a, b, source, a, b);
}

void applyPhysicalABManualEquivalentCommand(float physicalACmd, float physicalBCmd) {
  applyPhysicalABManualEquivalentCommandWithSource(physicalACmd, physicalBCmd, "PHYSICAL_AB");
}

void applyAutoCommand(float left, float right) {
  // Wheel-off-ground only for ESC validation.
  applyDriveCommand(left, right);
}

bool stationLinkValid() {
  return lastStationFrameMs != 0 && millis() - lastStationFrameMs <= STATION_TIMEOUT_MS;
}

bool stationManualValid() {
  return stationManual.lastFrameMs != 0 && millis() - stationManual.lastFrameMs <= STATION_TIMEOUT_MS;
}

void clearStationManualCommand() {
  stationManual.steer = 0.0f;
  stationManual.throttle = 0.0f;
  stationManual.deadman = false;
  stationManual.lastFrameMs = 0;
}

bool rcFrameRecent() {
  return lastPpmFrameMs != 0 && millis() - lastPpmFrameMs < RC_FRAME_TIMEOUT_MS;
}

void readRcChannels(uint16_t &steering, uint16_t &throttle, uint16_t &mode) {
  noInterrupts();
  steering = ppmChannels[STEERING_CHANNEL_INDEX];
  throttle = ppmChannels[THROTTLE_CHANNEL_INDEX];
  mode = ppmChannels[MODE_CHANNEL_INDEX_VALUE];
  interrupts();
}

bool rcPulseValid(uint16_t pulseUs) {
  return pulseUs >= RC_MIN_VALID_US && pulseUs <= RC_MAX_VALID_US;
}

float normRcCentered(uint16_t pulseUs, uint16_t centerUs) {
  int delta = static_cast<int>(pulseUs) - static_cast<int>(centerUs);

  if (abs(delta) <= RC_DEADBAND_US) {
    return 0.0f;
  }

  float denom = delta > 0 ? (2000.0f - centerUs) : (centerUs - 1000.0f);
  if (denom < 1.0f) {
    return 0.0f;
  }

  return clampUnit(static_cast<float>(delta) / denom);
}

// Deprecated legacy diagonal remap. Do not use for the final MANUAL drive path.
void mapRcManualAxes(float rawSteering, float rawThrottle, float &steeringOut, float &throttleOut) {
  steeringOut = clampUnit((rawSteering + rawThrottle) * RC_MANUAL_AXIS_ROTATION_SCALE);
  throttleOut = clampUnit((rawSteering - rawThrottle) * RC_MANUAL_AXIS_ROTATION_SCALE);
}

void computeManualArcadeCommands(float rawSteering, float rawThrottle,
                                 float &forwardOut, float &turnOut,
                                 float &logicalLeftOut, float &logicalRightOut) {
  forwardOut = clampUnit(MANUAL_FORWARD_SIGN_VALUE * rawThrottle);
  turnOut = clampUnit(MANUAL_TURN_SIGN_VALUE * rawSteering);
  logicalLeftOut = clampUnit(forwardOut + turnOut);
  logicalRightOut = clampUnit(forwardOut - turnOut);
}

#if FIXED_WIRING_GPS_SERIAL2_SINGLE_WAYPOINT_EXPERIMENT
// Guarded ground crawl: the ONLY path to armed AUTO motion. Clamps the candidate
// command to +/-GROUND_CRAWL_MAX_CMD, latches to a hard stop after
// GROUND_CRAWL_MAX_AUTO_MS of continuous AUTO, and requires neutral RC sticks plus
// motion-grade GPS and a near-field target before motion is permitted.
void updateGroundCrawlState(bool rcValid, bool autoSwitchOn, bool rcManualActive,
                            uint16_t steeringUs, uint16_t throttleUs) {
  groundCrawlNeutralOkFlag =
      (normRcCentered(steeringUs, STEERING_CENTER_US) == 0.0f) &&
      (normRcCentered(throttleUs, THROTTLE_CENTER_US) == 0.0f);

  groundCrawlElapsedMs = singleWaypointAutoElapsedMs;
  groundCrawlUnclampedLeftCmd = singleWaypointCandidateLeftCmd;
  groundCrawlUnclampedRightCmd = singleWaypointCandidateRightCmd;

  // Latch clears only on a return to MANUAL.
  if (rcManualActive) {
    groundCrawlLatchedStopFlag = false;
  }

  bool crawlAutoActive = GROUND_CRAWL_ENABLED && SINGLE_WAYPOINT_AUTO_MOTION_ARMED &&
                         rcValid && autoSwitchOn && !rcManualActive;
  if (crawlAutoActive && groundCrawlElapsedMs > GROUND_CRAWL_MAX_AUTO_MS_VALUE) {
    groundCrawlLatchedStopFlag = true;
  }

  bool crawlDistanceOk =
      singleWaypointGpsCoordSaneFlag &&
      singleWaypointTargetDistanceM >= GROUND_CRAWL_MIN_TARGET_DISTANCE_M &&
      singleWaypointTargetDistanceM <= GROUND_CRAWL_MAX_TARGET_DISTANCE_M;

  if (!GROUND_CRAWL_ENABLED) {
    groundCrawlBlockReason = "MODE_OFF";
  } else if (groundCrawlLatchedStopFlag) {
    groundCrawlBlockReason = "LATCHED_STOP";
  } else if (!groundCrawlNeutralOkFlag) {
    groundCrawlBlockReason = "RC_NOT_NEUTRAL";
  } else if (!singleWaypointMotionReadyFlag) {
    groundCrawlBlockReason = "GPS_NOT_MOTION_READY";
  } else if (!singleWaypointSafetyReadyFlag) {
    groundCrawlBlockReason = "SAFETY_NOT_READY";
  } else if (!crawlDistanceOk) {
    groundCrawlBlockReason = "DISTANCE_OUT_OF_RANGE";
  } else {
    groundCrawlBlockReason = "OK";
  }

  groundCrawlReadyFlag = GROUND_CRAWL_ENABLED && !groundCrawlLatchedStopFlag &&
                         groundCrawlNeutralOkFlag && singleWaypointMotionReadyFlag &&
                         singleWaypointSafetyReadyFlag && crawlDistanceOk;
}
#endif

bool rcChannelsValid(uint16_t steering, uint16_t throttle, uint16_t mode) {
  if (!rcFrameRecent()) {
    return false;
  }

  return rcPulseValid(steering) && rcPulseValid(throttle) && rcPulseValid(mode);
}

bool rcChannelsValid() {
  uint16_t steering = 0;
  uint16_t throttle = 0;
  uint16_t mode = 0;
  readRcChannels(steering, throttle, mode);
  return rcChannelsValid(steering, throttle, mode);
}

bool rcAutoSwitchOn(uint16_t mode) {
  return mode > RC_AUTO_SWITCH_ON_US;
}

bool rcAutoSwitchOn() {
  uint16_t steering = 0;
  uint16_t throttle = 0;
  uint16_t mode = 0;
  readRcChannels(steering, throttle, mode);
  return rcAutoSwitchOn(mode);
}

#if STAGE15_GUARDED_CRAWL_TEST
bool stage15NeutralOk(uint16_t steeringUs, uint16_t throttleUs) {
  return normRcCentered(steeringUs, STEERING_CENTER_US) == 0.0f &&
         normRcCentered(throttleUs, THROTTLE_CENTER_US) == 0.0f;
}

void stage15PrintEvent(const char *event, bool rcValid, bool neutralOk, const char *reason) {
  Serial.print(F("STAGE15 stage15_guarded_crawl=true event="));
  Serial.print(event);
  Serial.print(F(" path_following_enable=false"));
  Serial.print(F(" physical_path_following_enable=false"));
  Serial.print(F(" allow_motor_output=false"));
  Serial.print(F(" path_package_used=false"));
  Serial.print(F(" virtual_controller_used=false"));
  Serial.print(F(" autonomous_mode=false"));
  Serial.print(F(" pulse_sequence="));
  Serial.print(stage15PulseSequence);
  Serial.print(F(" pulse_type="));
  Serial.print(stage15PulseType);
  Serial.print(F(" pulse_cmd_left="));
  Serial.print(stage15PulseLeftCmd, 3);
  Serial.print(F(" pulse_cmd_right="));
  Serial.print(stage15PulseRightCmd, 3);
  Serial.print(F(" pulse_ms="));
  Serial.print(STAGE15_PULSE_MS_VALUE);
  Serial.print(F(" pulse_elapsed_ms="));
  Serial.print(stage15PulseElapsedMs);
  Serial.print(F(" max_cmd="));
  Serial.print(STAGE15_MAX_CMD_VALUE, 3);
  Serial.print(F(" physical_output_active="));
  Serial.print(stage15PulseActiveFlag ? F("true") : F("false"));
  Serial.print(F(" stop_confirmed="));
  Serial.print(stage15PulseActiveFlag ? F("false") : F("true"));
  Serial.print(F(" rc_ok="));
  Serial.print(rcValid ? F("true") : F("false"));
  Serial.print(F(" neutral_ok="));
  Serial.print(neutralOk ? F("true") : F("false"));
  Serial.print(F(" failsafe_seen="));
  Serial.print(stage15FailsafeSeenFlag ? F("true") : F("false"));
  Serial.print(F(" final_left_cmd="));
  Serial.print(lastLeftOutputCmd, 3);
  Serial.print(F(" final_right_cmd="));
  Serial.print(lastRightOutputCmd, 3);
  Serial.print(F(" block_reason="));
  Serial.print(reason);
  Serial.println();
}

void stage15Stop(bool rcValid, bool neutralOk, const char *reason) {
  stage15PulseActiveFlag = false;
  stage15PulseLeftCmd = 0.0f;
  stage15PulseRightCmd = 0.0f;
  stage15PulseType = "test_stop";
  stage15BlockReason = reason;
  stage15LastStopMs = millis();
  motorStop();
  stage15PrintEvent("pulse_stop", rcValid, neutralOk, reason);
}

bool stage15StartPulse(const char *pulseType, float leftCmd, float rightCmd,
                       bool rcValid, bool neutralOk, uint32_t now) {
  if (stage15PulseActiveFlag) {
    stage15PrintEvent("pulse_rejected", rcValid, neutralOk, "PULSE_ALREADY_ACTIVE");
    return false;
  }
  if (STAGE15_REQUIRE_RC_NEUTRAL_VALUE && (!rcValid || !neutralOk)) {
    stage15PrintEvent("pulse_rejected", rcValid, neutralOk, rcValid ? "RC_NOT_NEUTRAL" : "RC_INVALID");
    return false;
  }
  if (stage15LastStopMs != 0 && now - stage15LastStopMs < STAGE15_INTER_PULSE_MS_VALUE) {
    stage15PrintEvent("pulse_rejected", rcValid, neutralOk, "INTER_PULSE_WAIT");
    return false;
  }

  float maxCmd = absFloat(STAGE15_MAX_CMD_VALUE);
  if (maxCmd > 0.10f) {
    maxCmd = 0.10f;
  }
  stage15PulseLeftCmd = clampUnit(leftCmd > maxCmd ? maxCmd : (leftCmd < -maxCmd ? -maxCmd : leftCmd));
  stage15PulseRightCmd = clampUnit(rightCmd > maxCmd ? maxCmd : (rightCmd < -maxCmd ? -maxCmd : rightCmd));
  stage15PulseType = pulseType;
  stage15PulseStartMs = now;
  stage15PulseElapsedMs = 0;
  stage15PulseActiveFlag = true;
  stage15PulseSequence++;
  stage15BlockReason = "OK";
  applyMotorPulseDirectWheelCommand(stage15PulseLeftCmd, stage15PulseRightCmd);
  stage15PrintEvent("pulse_start", rcValid, neutralOk, "OK");
  return true;
}

void stage15HandleCommand(const String &line, bool rcValid, bool neutralOk, uint32_t now) {
  if (line == "test_stop" || line == "STOP" || line == "stop") {
    stage15Stop(rcValid, neutralOk, "USB_STOP");
  } else if (line == "test_forward_pulse") {
    stage15StartPulse("test_forward_pulse", STAGE15_MAX_CMD_VALUE, STAGE15_MAX_CMD_VALUE, rcValid, neutralOk, now);
  } else if (line == "test_backward_pulse") {
    stage15StartPulse("test_backward_pulse", -STAGE15_MAX_CMD_VALUE, -STAGE15_MAX_CMD_VALUE, rcValid, neutralOk, now);
  } else if (line == "test_rotate_left_pulse") {
    stage15StartPulse("test_rotate_left_pulse", -STAGE15_MAX_CMD_VALUE, STAGE15_MAX_CMD_VALUE, rcValid, neutralOk, now);
  } else if (line == "test_rotate_right_pulse") {
    stage15StartPulse("test_rotate_right_pulse", STAGE15_MAX_CMD_VALUE, -STAGE15_MAX_CMD_VALUE, rcValid, neutralOk, now);
  } else if (line.length() > 0) {
    stage15PrintEvent("command_ignored", rcValid, neutralOk, "UNKNOWN_COMMAND");
  }
}

void stage15ReadUsbCommands(bool rcValid, bool neutralOk, uint32_t now) {
  while (Serial.available() > 0) {
    char c = static_cast<char>(Serial.read());
    if (c == '\n') {
      stage15UsbLine.trim();
      stage15HandleCommand(stage15UsbLine, rcValid, neutralOk, now);
      stage15UsbLine = "";
    } else if (c != '\r') {
      stage15UsbLine += c;
      if (stage15UsbLine.length() > 80) {
        stage15UsbLine = "";
      }
    }
  }
}

void stage15UpdatePulse(bool rcValid, bool neutralOk, uint32_t now) {
  stage15FailsafeSeenFlag = stage15FailsafeSeenFlag || !rcValid;
  if (!stage15PulseActiveFlag) {
    motorStop();
    return;
  }
  stage15PulseElapsedMs = now - stage15PulseStartMs;
  if (stage15PulseElapsedMs >= STAGE15_PULSE_MS_VALUE || STAGE15_PULSE_MS_VALUE > 300) {
    stage15Stop(rcValid, neutralOk, "PULSE_COMPLETE");
    return;
  }
  applyMotorPulseDirectWheelCommand(stage15PulseLeftCmd, stage15PulseRightCmd);
}
#endif

#if STAGE16_USB_GUARDED_CRAWL || STAGE17_FIRST_PRIMITIVE_CRAWL || STAGE18_MOTOR_MAPPING_PROBE || STAGE20_PHYSICAL_AB_GUARDED_CRAWL
bool stage16NeutralOk(uint16_t steeringUs, uint16_t throttleUs) {
  return normRcCentered(steeringUs, STEERING_CENTER_US) == 0.0f &&
         normRcCentered(throttleUs, THROTTLE_CENTER_US) == 0.0f;
}

bool stage16ExtractToken(const String &line, const char *key, String &out) {
  String prefix = String(key) + "=";
  int start = line.indexOf(prefix);
  if (start < 0) {
    return false;
  }
  start += prefix.length();
  int end = line.indexOf(' ', start);
  if (end < 0) {
    end = line.length();
  }
  out = line.substring(start, end);
  return out.length() > 0;
}

bool stage16ParseFloatToken(const String &line, const char *key, float &out) {
  String token;
  if (!stage16ExtractToken(line, key, token)) {
    return false;
  }
  char *endPtr = nullptr;
  out = strtof(token.c_str(), &endPtr);
  return endPtr != token.c_str() && *endPtr == '\0';
}

bool stage16ParseIntToken(const String &line, const char *key, int32_t &out) {
  String token;
  if (!stage16ExtractToken(line, key, token)) {
    return false;
  }
  char *endPtr = nullptr;
  long parsed = strtol(token.c_str(), &endPtr, 10);
  if (endPtr == token.c_str() || *endPtr != '\0') {
    return false;
  }
  out = parsed;
  return true;
}

bool stage16RcInputRequiredForStationPulse() {
  return !STATION_MANUAL_IGNORE_RC_INPUT_ENABLED;
}

void printImuDiagFields();
void printModeSwitchFields();

void stage16PrintStatus(const char *event, bool rcValid, bool neutralOk) {
  uint32_t now = millis();
  bool guardedOutputActive = stage16PulseActiveFlag || usbDriveLiveActiveFlag;
  if (USB_PULSE_TEST_GUARDED_ENABLED || STATION_DRIVE_GUARDED_ENABLED || USB_DRIVE_LIVE_ENABLED) {
    Serial.print(F("USB_PULSE_TEST usb_pulse_test_mode=true event="));
    Serial.print(event);
    Serial.print(F(" firmware_profile="));
    Serial.print(MAC_PHYSICAL_SUPERVISED ? F("MAC_PHYSICAL_SUPERVISED") : F("USB_SUPERVISED"));
    Serial.print(F(" mac_physical_supervised="));
    Serial.print(MAC_PHYSICAL_SUPERVISED ? F("true") : F("false"));
    Serial.print(F(" usb_pulse_test_ready=true"));
    Serial.print(F(" usb_pulse_test_ignore_rc_input="));
    Serial.print(STATION_MANUAL_IGNORE_RC_INPUT_ENABLED ? F("true") : F("false"));
    Serial.print(F(" usb_pulse_test_cmd_state="));
    Serial.print(stage16CmdState);
    Serial.print(F(" usb_pulse_test_armed="));
    Serial.print(stage16ArmedFlag ? F("true") : F("false"));
    Serial.print(F(" usb_pulse_test_cmd_seq="));
    Serial.print(stage16CmdSeq < 0 ? 0 : stage16CmdSeq);
    Serial.print(F(" usb_pulse_test_last_cmd_age_ms="));
    if (stage16LastCmdMs == 0) {
      Serial.print(F("NA"));
    } else {
      Serial.print(now - stage16LastCmdMs);
    }
    Serial.print(F(" usb_pulse_test_ms="));
    Serial.print(stage16CmdMs);
    Serial.print(F(" usb_drive_live_mode="));
    Serial.print(USB_DRIVE_LIVE_ENABLED ? F("true") : F("false"));
    Serial.print(F(" usb_drive_live_active="));
    Serial.print(usbDriveLiveActiveFlag ? F("true") : F("false"));
    Serial.print(F(" usb_drive_live_seq="));
    Serial.print(usbDriveLiveSeq < 0 ? 0 : usbDriveLiveSeq);
    Serial.print(F(" usb_drive_live_last_update_age_ms="));
    if (usbDriveLiveLastUpdateMs == 0) {
      Serial.print(F("NA"));
    } else {
      Serial.print(now - usbDriveLiveLastUpdateMs);
    }
    Serial.print(F(" requested_a_cmd="));
    Serial.print(stage16LeftCmd, 3);
    Serial.print(F(" requested_b_cmd="));
    Serial.print(stage16RightCmd, 3);
    Serial.print(F(" physical_a_cmd="));
    Serial.print(lastOutputLeftPinCmd, 3);
    Serial.print(F(" physical_b_cmd="));
    Serial.print(lastOutputRightPinCmd, 3);
    Serial.print(F(" usb_pulse_test_reject_reason="));
    Serial.print(stage16RejectReason);
    Serial.print(F(" usb_pulse_test_physical_output_active="));
    Serial.print(guardedOutputActive ? F("true") : F("false"));
    Serial.print(F(" physical_output_active="));
    Serial.print(guardedOutputActive ? F("true") : F("false"));
    Serial.print(F(" motor_write_called="));
    Serial.print(guardedOutputActive ? F("true") : F("false"));
    Serial.print(F(" final_left_cmd="));
    Serial.print(lastLeftOutputCmd, 3);
    Serial.print(F(" final_right_cmd="));
    Serial.print(lastRightOutputCmd, 3);
    Serial.print(F(" physical_a_role=throttle physical_b_role=turn"));
    Serial.print(F(" wheel_to_physical_mapping=physical_ab_manual_equivalent"));
    Serial.print(F(" rc_ok="));
    Serial.print(rcValid ? F("true") : F("false"));
    Serial.print(F(" neutral_ok="));
    Serial.print(neutralOk ? F("true") : F("false"));
    Serial.print(F(" latched_stop="));
    Serial.print(stage16LatchedStopFlag ? F("true") : F("false"));
    Serial.print(F(" gps_chars="));
    Serial.print(gps.charsProcessed());
    Serial.print(F(" gps_solution_valid="));
    Serial.print(gpsSolutionValid() ? F("true") : F("false"));
    Serial.print(F(" gps_ready="));
    Serial.print(gpsReady() ? F("true") : F("false"));
    Serial.print(F(" gps_block_reason="));
    Serial.print(gpsBlockReason());
    Serial.print(F(" current_lat="));
    if (gpsLocationValid()) {
      Serial.print(gps.location.lat(), 7);
    } else {
      Serial.print(F("NA"));
    }
    Serial.print(F(" current_lon="));
    if (gpsLocationValid()) {
      Serial.print(gps.location.lng(), 7);
    } else {
      Serial.print(F("NA"));
    }
    Serial.print(F(" gps_lat="));
    if (gpsReady()) {
      Serial.print(gps.location.lat(), 6);
    } else {
      Serial.print(F("NA"));
    }
    Serial.print(F(" gps_lon="));
    if (gpsReady()) {
      Serial.print(gps.location.lng(), 6);
    } else {
      Serial.print(F("NA"));
    }
    Serial.print(F(" gps_cached_lat="));
    if (gpsLocationValid()) {
      Serial.print(gps.location.lat(), 6);
    } else {
      Serial.print(F("NA"));
    }
    Serial.print(F(" gps_cached_lon="));
    if (gpsLocationValid()) {
      Serial.print(gps.location.lng(), 6);
    } else {
      Serial.print(F("NA"));
    }
    Serial.print(F(" gps_cached_age_ms="));
    if (gpsLocationValid()) {
      Serial.print(gps.location.age());
    } else {
      Serial.print(F("NA"));
    }
    Serial.print(F(" gps_sats="));
    if (gps.satellites.isValid()) {
      Serial.print(gps.satellites.value());
    } else {
      Serial.print(F("NA"));
    }
    Serial.print(F(" gps_hdop="));
    if (gps.hdop.isValid()) {
      Serial.print(gps.hdop.hdop(), 2);
    } else {
      Serial.print(F("NA"));
    }
    Serial.print(F(" last_rmc_status="));
    if (lastRmcStatus != '\0') {
      Serial.print(lastRmcStatus);
    } else {
      Serial.print(F("NA"));
    }
    Serial.print(F(" last_gga_fix_quality="));
    if (lastGgaFixQuality >= 0) {
      Serial.print(lastGgaFixQuality);
    } else {
      Serial.print(F("NA"));
    }
    printImuDiagFields();
    printModeSwitchFields();
    Serial.print(F(" physical_path_following_enable=false allow_motor_output=false path_package_used=false hc12_used=false"));
    Serial.print(F(" ready_for_full_path_following=false"));
    Serial.println();
    return;
  }
#if STAGE20_PHYSICAL_AB_GUARDED_CRAWL
  Serial.print(F("STAGE20 stage20_physical_ab_guarded_crawl=true stage18_motor_mapping_probe=false stage17_first_primitive_crawl=false stage16_guarded_crawl=false event="));
#elif STAGE18_MOTOR_MAPPING_PROBE
  Serial.print(F("STAGE18 stage18_motor_mapping_probe=true stage17_first_primitive_crawl=false stage16_guarded_crawl=false event="));
#elif STAGE17_FIRST_PRIMITIVE_CRAWL
  Serial.print(F("STAGE17 stage17_first_primitive_crawl=true stage16_guarded_crawl=false event="));
#else
  Serial.print(F("STAGE16 stage16_guarded_crawl=true stage17_first_primitive_crawl=false event="));
#endif
  Serial.print(event);
  Serial.print(F(" stage16_firmware_ready=true stage17_firmware_ready="));
  Serial.print(STAGE17_FIRST_PRIMITIVE_CRAWL_ENABLED ? F("true") : F("false"));
  Serial.print(F(" stage18_firmware_ready="));
  Serial.print(STAGE18_MOTOR_MAPPING_PROBE_ENABLED ? F("true") : F("false"));
  Serial.print(F(" stage20_firmware_ready="));
  Serial.print(STAGE20_PHYSICAL_AB_GUARDED_CRAWL_ENABLED ? F("true") : F("false"));
  Serial.print(F(" stage20_cmd_state="));
  Serial.print(stage16CmdState);
  Serial.print(F(" stage20_armed="));
  Serial.print(stage16ArmedFlag ? F("true") : F("false"));
  Serial.print(F(" station_manual_ignore_rc_input="));
  Serial.print(STATION_MANUAL_IGNORE_RC_INPUT_ENABLED ? F("true") : F("false"));
  Serial.print(F(" stage16_cmd_seq="));
  Serial.print(stage16CmdSeq < 0 ? 0 : stage16CmdSeq);
  Serial.print(F(" stage16_cmd_state="));
  Serial.print(stage16CmdState);
  Serial.print(F(" stage16_last_cmd_age_ms="));
  if (stage16LastCmdMs == 0) {
    Serial.print(F("NA"));
  } else {
    Serial.print(now - stage16LastCmdMs);
  }
  Serial.print(F(" stage16_left_cmd="));
  Serial.print(stage16LeftCmd, 3);
  Serial.print(F(" stage16_right_cmd="));
  Serial.print(stage16RightCmd, 3);
  Serial.print(F(" stage16_ms="));
  Serial.print(stage16CmdMs);
  Serial.print(F(" requested_left_cmd="));
  Serial.print(stage16LeftCmd, 3);
  Serial.print(F(" requested_right_cmd="));
  Serial.print(stage16RightCmd, 3);
  Serial.print(F(" requested_a_cmd="));
  Serial.print(stage16LeftCmd, 3);
  Serial.print(F(" requested_b_cmd="));
  Serial.print(stage16RightCmd, 3);
  Serial.print(F(" manual_equivalent_forward_cmd="));
  Serial.print(stage16LeftCmd, 3);
  Serial.print(F(" manual_equivalent_turn_cmd="));
  Serial.print(stage16RightCmd, 3);
  Serial.print(F(" stage16_reject_reason="));
  Serial.print(stage16RejectReason);
  Serial.print(F(" stage16_physical_output_active="));
  Serial.print(stage16PulseActiveFlag ? F("true") : F("false"));
  Serial.print(F(" physical_output_active="));
  Serial.print(stage16PulseActiveFlag ? F("true") : F("false"));
  Serial.print(F(" final_left_cmd="));
  Serial.print(lastLeftOutputCmd, 3);
  Serial.print(F(" final_right_cmd="));
  Serial.print(lastRightOutputCmd, 3);
  Serial.print(F(" logical_left_cmd="));
  Serial.print(lastLogicalLeftCmd, 3);
  Serial.print(F(" logical_right_cmd="));
  Serial.print(lastLogicalRightCmd, 3);
  Serial.print(F(" raw_left_cmd="));
  Serial.print(lastRawLeftCmd, 3);
  Serial.print(F(" raw_right_cmd="));
  Serial.print(lastRawRightCmd, 3);
  Serial.print(F(" calibrated_left_cmd="));
  Serial.print(lastCalibratedLeftCmd, 3);
  Serial.print(F(" calibrated_right_cmd="));
  Serial.print(lastCalibratedRightCmd, 3);
  Serial.print(F(" physical_a_cmd="));
  Serial.print(lastOutputLeftPinCmd, 3);
  Serial.print(F(" physical_b_cmd="));
  Serial.print(lastOutputRightPinCmd, 3);
  Serial.print(F(" motor_write_called="));
  Serial.print(stage16PulseActiveFlag ? F("true") : F("false"));
  Serial.print(F(" motor_backend=servo_pwm"));
  Serial.print(F(" motor_enable_state=attached"));
  Serial.print(F(" pwm_or_dynamixel_write_status=OK"));
  Serial.print(F(" physical_a_role=throttle physical_b_role=turn"));
  Serial.print(F(" wheel_to_physical_mapping="));
  Serial.print(STAGE20_PHYSICAL_AB_GUARDED_CRAWL_ENABLED ? F("physical_ab_manual_equivalent") : F("diff_to_throttle_turn"));
  Serial.print(F(" rc_ok="));
  Serial.print(rcValid ? F("true") : F("false"));
  Serial.print(F(" neutral_ok="));
  Serial.print(neutralOk ? F("true") : F("false"));
  Serial.print(F(" latched_stop="));
  Serial.print(stage16LatchedStopFlag ? F("true") : F("false"));
  Serial.print(F(" stage16_armed="));
  Serial.print(stage16ArmedFlag ? F("true") : F("false"));
  Serial.print(F(" motor_command_source="));
  Serial.print(stage16PulseActiveFlag ? (STAGE20_PHYSICAL_AB_GUARDED_CRAWL_ENABLED ? F("STAGE20_PHYSICAL_AB_GUARDED_CRAWL") : (STAGE18_MOTOR_MAPPING_PROBE_ENABLED ? F("STAGE18_MOTOR_MAPPING_PROBE") : (STAGE17_FIRST_PRIMITIVE_CRAWL_ENABLED ? F("STAGE17_FIRST_PRIMITIVE_CRAWL") : F("STAGE16_USB_GUARDED_CRAWL")))) : F("NONE"));
  Serial.print(F(" active_target_source="));
  Serial.print(stage16PulseActiveFlag ? (STAGE20_PHYSICAL_AB_GUARDED_CRAWL_ENABLED ? F("station_physical_ab_guarded") : (STAGE18_MOTOR_MAPPING_PROBE_ENABLED ? F("station_motor_mapping_probe") : (STAGE17_FIRST_PRIMITIVE_CRAWL_ENABLED ? F("station_first_primitive_guarded") : F("station_path_package_guarded")))) : F("NONE"));
  Serial.print(F(" physical_path_following_enable=false allow_motor_output=false path_package_used=false hc12_used=false"));
  Serial.print(F(" gps_block_reason="));
  Serial.print(gpsDryrunBlockReason());
  Serial.print(F(" position_source="));
  bool gpsPositionReady = gpsDryrunReady() && gps.location.isValid();
  Serial.print(gpsPositionReady ? F("gps") : F("NA"));
  Serial.print(F(" current_lat="));
  if (gpsPositionReady) {
    Serial.print(gps.location.lat(), 7);
  } else {
    Serial.print(F("NA"));
  }
  Serial.print(F(" current_lon="));
  if (gpsPositionReady) {
    Serial.print(gps.location.lng(), 7);
  } else {
    Serial.print(F("NA"));
  }
  Serial.print(F(" gps_sats="));
  if (gps.satellites.isValid()) {
    Serial.print(gps.satellites.value());
  } else {
    Serial.print(F("NA"));
  }
  Serial.print(F(" gps_hdop="));
  if (gps.hdop.isValid()) {
    Serial.print(gps.hdop.hdop(), 2);
  } else {
    Serial.print(F("NA"));
  }
  printImuDiagFields();
  Serial.println();
}

void stage16Stop(bool rcValid, bool neutralOk, const char *reason) {
  bool alreadyZero = !stage16PulseActiveFlag && !usbDriveLiveActiveFlag && motorOutputZeroState();
  stage16PulseActiveFlag = false;
  usbDriveLiveActiveFlag = false;
  stage16ArmedFlag = false;
  stage16LatchedStopFlag = true;
  stage16LeftCmd = 0.0f;
  stage16RightCmd = 0.0f;
  stage16CmdMs = 0;
  stage16CmdState = "STOPPED";
  if (alreadyZero && strcmp(reason, "USB_STOP") == 0) {
    stage16RejectReason = "STOP_ALREADY_ZERO";
    stage16PrintStatus("STOP_ALREADY_ZERO", rcValid, neutralOk);
    return;
  }
  stage16RejectReason = reason;
  motorStopWithSource(reason);
  stage16PrintStatus("STOP", rcValid, neutralOk);
}

void stage16Reject(bool rcValid, bool neutralOk, const char *reason) {
  stage16CmdState = "REJECTED";
  stage16RejectReason = reason;
  stage16PulseActiveFlag = false;
  usbDriveLiveActiveFlag = false;
  stage16ArmedFlag = false;
  stage16LatchedStopFlag = true;
  motorStopWithSource("REJECT");
  stage16PrintStatus("REJECT", rcValid, neutralOk);
}

void stage16Arm(bool rcValid, bool neutralOk, uint32_t now, const String &line) {
  int32_t seq = 0;
  if (stage16ParseIntToken(line, "seq", seq)) {
    stage16CmdSeq = seq;
  }
  stage16LastCmdMs = now;
  bool requireRcInput = stage16RcInputRequiredForStationPulse();
  if (requireRcInput && !rcValid) {
    stage16Reject(rcValid, neutralOk, "ARM_RC_NOT_OK");
    return;
  }
  if (requireRcInput && !neutralOk) {
    stage16Reject(rcValid, neutralOk, "ARM_NEUTRAL_NOT_OK");
    return;
  }
  if (stage16PulseActiveFlag || absFloat(lastLeftOutputCmd) > 0.0001f || absFloat(lastRightOutputCmd) > 0.0001f) {
    stage16Reject(rcValid, neutralOk, "ARM_OUTPUT_ACTIVE");
    return;
  }
  stage16LatchedStopFlag = false;
  stage16ArmedFlag = true;
  stage16CmdState = "ARMED";
  stage16RejectReason = "NONE";
  motorStop();
  stage16PrintStatus("ARM", rcValid, neutralOk);
}

bool usbDriveLiveHandleCommand(const String &line, bool rcValid, bool neutralOk, uint32_t now) {
  if (!USB_DRIVE_LIVE_ENABLED) {
    return false;
  }
  if (line.startsWith("USB_DRIVE_LIVE_STOP")) {
    int32_t seq = 0;
    if (stage16ParseIntToken(line, "seq", seq)) {
      usbDriveLiveSeq = seq;
      stage16CmdSeq = seq;
    }
    stage16LastCmdMs = now;
    stage16Stop(rcValid, neutralOk, "USB_DRIVE_LIVE_STOP");
    return true;
  }
  if (!line.startsWith("USB_DRIVE_LIVE_SET")) {
    return false;
  }

  int32_t seq = 0;
  float a = 0.0f;
  float b = 0.0f;
  int32_t durationMs = 0;
  int32_t ttlMs = USB_DRIVE_LIVE_UPDATE_TIMEOUT_MS_VALUE;
  bool parsed = stage16ParseIntToken(line, "seq", seq) &&
                stage16ParseFloatToken(line, "a", a) &&
                stage16ParseFloatToken(line, "b", b) &&
                stage16ParseIntToken(line, "duration_ms", durationMs);
  stage16ParseIntToken(line, "ttl_ms", ttlMs);
  if (!parsed) {
    stage16Reject(rcValid, neutralOk, "USB_DRIVE_LIVE_PARSE_ERROR");
    return true;
  }
  bool requireRcInput = stage16RcInputRequiredForStationPulse();
  if (requireRcInput && !rcValid) {
    stage16Reject(rcValid, neutralOk, "RC_INVALID");
    return true;
  }
  if (absFloat(a) > USB_DRIVE_LIVE_MAX_ABS_A_VALUE || absFloat(b) > USB_DRIVE_LIVE_MAX_ABS_B_VALUE) {
    stage16Reject(rcValid, neutralOk, "USB_DRIVE_LIVE_COMMAND_EXCEEDS_MAX");
    return true;
  }
  if (durationMs < 1 || static_cast<uint32_t>(durationMs) > USB_DRIVE_LIVE_MAX_DURATION_MS_VALUE) {
    stage16Reject(rcValid, neutralOk, "USB_DRIVE_LIVE_DURATION_EXCEEDS_MAX");
    return true;
  }
  if (ttlMs < 50 || static_cast<uint32_t>(ttlMs) > USB_DRIVE_LIVE_UPDATE_TIMEOUT_MS_VALUE) {
    ttlMs = USB_DRIVE_LIVE_UPDATE_TIMEOUT_MS_VALUE;
  }

  if (!usbDriveLiveActiveFlag || usbDriveLiveSeq != seq) {
    usbDriveLiveStartMs = now;
  }
  usbDriveLiveSeq = seq;
  usbDriveLiveACmd = a;
  usbDriveLiveBCmd = b;
  usbDriveLiveDurationMs = static_cast<uint32_t>(durationMs);
  usbDriveLiveTtlMs = static_cast<uint32_t>(ttlMs);
  usbDriveLiveLastUpdateMs = now;
  usbDriveLiveActiveFlag = true;
  usbDriveLiveRejectReason = "NONE";
  stage16CmdSeq = seq;
  stage16LeftCmd = a;
  stage16RightCmd = b;
  stage16CmdMs = static_cast<uint32_t>(durationMs);
  stage16LastCmdMs = now;
  stage16LatchedStopFlag = false;
  stage16ArmedFlag = false;
  stage16PulseActiveFlag = false;
  stage16CmdState = "ACTIVE";
  stage16RejectReason = "NONE";
  applyPhysicalABManualEquivalentCommandWithSource(a, b, "USB_DRIVE_LIVE");
  stage16PrintStatus("ACTIVE", rcValid, neutralOk);
  return true;
}

void stage16HandleCommand(const String &line, bool rcValid, bool neutralOk, uint32_t now) {
  if (usbDriveLiveHandleCommand(line, rcValid, neutralOk, now)) {
    return;
  }
  if (line.startsWith("USB_PULSE_TEST_STOP") || line.startsWith("STATION_DRIVE_STOP") || line.startsWith("STAGE16_STOP") || line.startsWith("STAGE17_STOP") || line.startsWith("STAGE18_STOP") || line.startsWith("STAGE20_STOP")) {
    int32_t seq = 0;
    if (stage16ParseIntToken(line, "seq", seq)) {
      stage16CmdSeq = seq;
    }
    stage16LastCmdMs = now;
    stage16Stop(rcValid, neutralOk, "USB_STOP");
    return;
  }
  if (line.startsWith("USB_PULSE_TEST_ARM") || line.startsWith("STATION_DRIVE_ARM") || line.startsWith("STAGE16_ARM") || line.startsWith("STAGE17_ARM") || line.startsWith("STAGE18_ARM") || line.startsWith("STAGE20_ARM")) {
    stage16Arm(rcValid, neutralOk, now, line);
    return;
  }
  if (!line.startsWith("USB_PULSE_TEST_CMD") && !line.startsWith("STATION_DRIVE_CMD") && !line.startsWith("STAGE16_CMD") && !line.startsWith("STAGE17_CMD") && !line.startsWith("STAGE18_CMD") && !line.startsWith("STAGE20_CMD")) {
    stage16Reject(rcValid, neutralOk, "UNKNOWN_COMMAND");
    return;
  }

  int32_t seq = 0;
  float left = 0.0f;
  float right = 0.0f;
  int32_t ms = 0;
  bool parsedMotion = false;
  if (line.startsWith("USB_PULSE_TEST_CMD") || line.startsWith("STATION_DRIVE_CMD") || line.startsWith("STAGE20_CMD")) {
    parsedMotion = stage16ParseIntToken(line, "seq", seq) &&
                   stage16ParseFloatToken(line, "a", left) &&
                   stage16ParseFloatToken(line, "b", right) &&
                   stage16ParseIntToken(line, "ms", ms);
  } else {
    parsedMotion = stage16ParseIntToken(line, "seq", seq) &&
                   stage16ParseFloatToken(line, "left", left) &&
                   stage16ParseFloatToken(line, "right", right) &&
                   stage16ParseIntToken(line, "ms", ms);
  }
  if (!parsedMotion) {
    stage16Reject(rcValid, neutralOk, "PARSE_ERROR");
    return;
  }
  stage16CmdSeq = seq;
  stage16LastCmdMs = now;
  if (stage16RcInputRequiredForStationPulse() && !rcValid) {
    stage16Reject(rcValid, neutralOk, "RC_INVALID");
    return;
  }
  if (stage16LatchedStopFlag) {
    stage16Reject(rcValid, neutralOk, "LATCHED_STOP");
    return;
  }
  if (!stage16ArmedFlag) {
    stage16Reject(rcValid, neutralOk, "NOT_ARMED");
    return;
  }
  if (stage16PulseActiveFlag) {
    stage16Reject(rcValid, neutralOk, "PULSE_ALREADY_ACTIVE");
    return;
  }
  if (absFloat(left) > STAGE_USB_GUARDED_MAX_CMD_VALUE || absFloat(right) > STAGE_USB_GUARDED_MAX_B_VALUE) {
    stage16Reject(rcValid, neutralOk, "COMMAND_EXCEEDS_MAX_CMD");
    return;
  }
  if (ms < 1 || static_cast<uint32_t>(ms) > STAGE_USB_GUARDED_MAX_MS_VALUE) {
    stage16Reject(rcValid, neutralOk, "COMMAND_EXCEEDS_MAX_MS");
    return;
  }

  stage16LeftCmd = left;
  stage16RightCmd = right;
  stage16CmdMs = static_cast<uint32_t>(ms);
  stage16PulseStartMs = now;
  stage16PulseElapsedMs = 0;
  stage16PulseActiveFlag = true;
  stage16ArmedFlag = false;
  stage16CmdState = "ACTIVE";
  stage16RejectReason = "NONE";
  if (STAGE20_PHYSICAL_AB_GUARDED_CRAWL_ENABLED) {
    applyPhysicalABManualEquivalentCommandWithSource(stage16LeftCmd, stage16RightCmd, "USB_PULSE_TEST");
  } else {
    applyMotorPulseDirectWheelCommand(stage16LeftCmd, stage16RightCmd);
  }
  stage16PrintStatus("ACK", rcValid, neutralOk);
}

void stage16ReadUsbCommands(bool rcValid, bool neutralOk, uint32_t now) {
  while (Serial.available() > 0) {
    char c = static_cast<char>(Serial.read());
    if (c == '\n') {
      stage16UsbLine.trim();
      if (stage16UsbLine.length() > 0) {
        stage16HandleCommand(stage16UsbLine, rcValid, neutralOk, now);
      }
      stage16UsbLine = "";
    } else if (c != '\r') {
      stage16UsbLine += c;
      if (stage16UsbLine.length() > 120) {
        stage16UsbLine = "";
      }
    }
  }
}

void stage16UpdatePulse(bool rcValid, bool neutralOk, uint32_t now) {
  if (stage16RcInputRequiredForStationPulse() && !rcValid) {
    stage16LatchedStopFlag = true;
    stage16ArmedFlag = false;
    if (stage16PulseActiveFlag) {
      stage16Stop(rcValid, neutralOk, "RC_INVALID");
    } else if (usbDriveLiveActiveFlag) {
      stage16Stop(rcValid, neutralOk, "RC_INVALID");
    } else {
      motorStop();
    }
    return;
  }
  if (usbDriveLiveActiveFlag) {
    if (now - usbDriveLiveLastUpdateMs > usbDriveLiveTtlMs) {
      stage16Stop(rcValid, neutralOk, "USB_DRIVE_LIVE_UPDATE_TIMEOUT");
      return;
    }
    if (now - usbDriveLiveStartMs >= usbDriveLiveDurationMs) {
      stage16Stop(rcValid, neutralOk, "USB_DRIVE_LIVE_DURATION_COMPLETE");
      return;
    }
    stage16CmdState = "ACTIVE";
    return;
  }
  if (!stage16PulseActiveFlag) {
    motorStop();
    return;
  }
  stage16PulseElapsedMs = now - stage16PulseStartMs;
  if (stage16PulseElapsedMs >= stage16CmdMs || stage16CmdMs > STAGE_USB_GUARDED_MAX_MS_VALUE) {
    stage16Stop(rcValid, neutralOk, "PULSE_COMPLETE");
    return;
  }
  if (STAGE20_PHYSICAL_AB_GUARDED_CRAWL_ENABLED) {
    applyPhysicalABManualEquivalentCommandWithSource(stage16LeftCmd, stage16RightCmd, "USB_PULSE_TEST");
  } else {
    applyMotorPulseDirectWheelCommand(stage16LeftCmd, stage16RightCmd);
  }
}

void stage16Heartbeat(bool rcValid, bool neutralOk, uint32_t now) {
  if (now - stage16LastHeartbeatMs < 500) {
    return;
  }
  stage16LastHeartbeatMs = now;
  stage16PrintStatus("HEARTBEAT", rcValid, neutralOk);
}
#endif

void applyManualOverride(uint16_t steeringUs, uint16_t throttleUs) {
  float rawSteering = normRcCentered(steeringUs, STEERING_CENTER_US);
  float rawThrottle = normRcCentered(throttleUs, THROTTLE_CENTER_US);
  float forward = 0.0f;
  float turn = 0.0f;
  float left = 0.0f;
  float right = 0.0f;
  computeManualArcadeCommands(rawSteering, rawThrottle, forward, turn, left, right);
  applyDriveCommand(left, right);
}

void applyStationManualCommand() {
  if (STATION_HW_MANUAL_DIAGNOSE_ONLY_ENABLED) {
    motorStop();
    return;
  }
  if (STATION_HW_MANUAL_A_B_MAPPING_ENABLED) {
    float physicalA = stationManual.throttle;
    float physicalB = stationManual.steer;
    if (absFloat(physicalA) > STATION_HW_MANUAL_MAX_ABS_A_VALUE) {
      physicalA = (physicalA > 0.0f ? 1.0f : -1.0f) * STATION_HW_MANUAL_MAX_ABS_A_VALUE;
    }
    if (absFloat(physicalB) > STATION_HW_MANUAL_MAX_ABS_B_VALUE) {
      physicalB = (physicalB > 0.0f ? 1.0f : -1.0f) * STATION_HW_MANUAL_MAX_ABS_B_VALUE;
    }
    applyPhysicalABManualEquivalentCommand(physicalA, physicalB);
    return;
  }
  float left = stationManual.throttle - stationManual.steer;
  float right = stationManual.throttle + stationManual.steer;
  float maxMagnitude = absFloat(left);
  if (absFloat(right) > maxMagnitude) {
    maxMagnitude = absFloat(right);
  }
  if (maxMagnitude > STATION_MANUAL_MAX_OUTPUT && maxMagnitude > 0.0f) {
    float scale = STATION_MANUAL_MAX_OUTPUT / maxMagnitude;
    left *= scale;
    right *= scale;
  }
  applyDriveCommand(left, right);
}

const char *modeName(RobotMode mode) {
  switch (mode) {
    case DISARMED: return "DISARMED";
    case MANUAL: return "MANUAL";
    case AUTO_READY: return "AUTO_READY";
    case AUTO_RUNNING: return "AUTO_RUNNING";
    case LINK_LOST: return "LINK_LOST";
    case FAILSAFE: return "FAILSAFE";
    default: return "UNKNOWN";
  }
}

const char *controlSourceName(ControlSource source) {
  switch (source) {
    case CONTROL_SOURCE_RC_MANUAL: return "RC_MANUAL";
    case CONTROL_SOURCE_STATION_MANUAL: return STATION_HW_MANUAL_ENABLED ? "STATION_HW_MANUAL" : "STATION_MANUAL";
    case CONTROL_SOURCE_AUTO: return "AUTO";
    case CONTROL_SOURCE_STOP:
    default: return "STOP";
  }
}

bool parseFloatToken(const String &token, float &valueOut) {
  char *endPtr = nullptr;
  valueOut = strtof(token.c_str(), &endPtr);
  return endPtr != token.c_str() && *endPtr == '\0';
}

bool parseBoolToken(const String &token, bool &valueOut) {
  if (token == "1" || token.equalsIgnoreCase("true")) {
    valueOut = true;
    return true;
  }
  if (token == "0" || token.equalsIgnoreCase("false")) {
    valueOut = false;
    return true;
  }
  return false;
}

bool splitCsvFields(const String &text, String *fields, size_t maxFields, size_t &fieldCount) {
  fieldCount = 0;
  int start = 0;
  while (start <= text.length()) {
    if (fieldCount >= maxFields) {
      return false;
    }
    int comma = text.indexOf(',', start);
    if (comma < 0) {
      fields[fieldCount++] = text.substring(start);
      return true;
    }
    fields[fieldCount++] = text.substring(start, comma);
    start = comma + 1;
  }
  return true;
}

String normalizeStationToken(String token) {
  token.trim();
  token.toUpperCase();
  return token;
}

void acceptStationManualCommand(float steer, float throttle, bool deadman, bool estop) {
  clearAutoCommand();
  stationManual.steer = clampUnit(steer);
  stationManual.throttle = clampUnit(throttle);
  stationManual.deadman = deadman;
  stationManual.lastFrameMs = millis();
  stationEstop = estop;
  if (stationEstop) {
    motorStop();
    currentControlSource = CONTROL_SOURCE_STOP;
  }
}

bool parseStationKeyValueLine(const String &line, float &steer, float &throttle, bool &deadman, bool &estop) {
  String normalized = line;
  normalized.replace(' ', ',');
  normalized.replace(';', ',');
  String fields[12];
  size_t fieldCount = 0;
  if (!splitCsvFields(normalized, fields, 12, fieldCount) || fieldCount == 0) {
    return false;
  }

  bool sawSteer = false;
  bool sawThrottle = false;
  bool sawDeadman = false;
  bool sawEstop = false;
  for (size_t i = 0; i < fieldCount; ++i) {
    String token = fields[i];
    token.trim();
    int equals = token.indexOf('=');
    if (equals <= 0) {
      continue;
    }
    String key = normalizeStationToken(token.substring(0, equals));
    String value = token.substring(equals + 1);
    value.trim();

    float floatValue = 0.0f;
    bool boolValue = false;
    if (key == "STEER" || key == "STEERING" || key == "TURN" || key == "B" ||
        key == "STATION_TURN_CMD" || key == "STATION_PHYSICAL_B_CMD") {
      if (!parseFloatToken(value, floatValue)) {
        return false;
      }
      steer = floatValue;
      sawSteer = true;
    } else if (key == "THROTTLE" || key == "FORWARD" || key == "PUSH" || key == "A" ||
               key == "STATION_FORWARD_CMD" || key == "STATION_PHYSICAL_A_CMD") {
      if (!parseFloatToken(value, floatValue)) {
        return false;
      }
      throttle = floatValue;
      sawThrottle = true;
    } else if (key == "DEADMAN" || key == "ENABLE") {
      if (!parseBoolToken(value, boolValue)) {
        return false;
      }
      deadman = boolValue;
      sawDeadman = true;
    } else if (key == "ESTOP" || key == "E_STOP" || key == "STOP") {
      if (!parseBoolToken(value, boolValue)) {
        return false;
      }
      estop = boolValue;
      sawEstop = true;
    }
  }
  return sawSteer && sawThrottle && sawDeadman && sawEstop;
}

bool parseStationCsvLine(const String &line, float &steer, float &throttle, bool &deadman, bool &estop) {
  String fields[8];
  size_t fieldCount = 0;
  if (!splitCsvFields(line, fields, 8, fieldCount) || fieldCount == 0) {
    return false;
  }

  for (size_t i = 0; i < fieldCount; ++i) {
    fields[i].trim();
  }

  String command0 = normalizeStationToken(fields[0]);
  size_t offset = 0;
  if (command0 == "CMD") {
    if (fieldCount < 2) {
      return false;
    }
    offset = 1;
  }

  String command = normalizeStationToken(fields[offset]);
  if (command == "MANUAL") {
    if (fieldCount != offset + 5) {
      return false;
    }
    return parseFloatToken(fields[offset + 1], steer) &&
           parseFloatToken(fields[offset + 2], throttle) &&
           parseBoolToken(fields[offset + 3], deadman) &&
           parseBoolToken(fields[offset + 4], estop);
  }

  if (command == "AB" || command == "A_B" || command == "PHYSICAL_AB") {
    if (fieldCount != offset + 5) {
      return false;
    }
    float physicalA = 0.0f;
    float physicalB = 0.0f;
    if (!parseFloatToken(fields[offset + 1], physicalA) ||
        !parseFloatToken(fields[offset + 2], physicalB) ||
        !parseBoolToken(fields[offset + 3], deadman) ||
        !parseBoolToken(fields[offset + 4], estop)) {
      return false;
    }
    throttle = physicalA;
    steer = physicalB;
    return true;
  }

  return false;
}

bool parseStationManualLineAuto(const String &line, float &steer, float &throttle, bool &deadman, bool &estop) {
  if (parseStationCsvLine(line, steer, throttle, deadman, estop)) {
    return true;
  }
  if (parseStationKeyValueLine(line, steer, throttle, deadman, estop)) {
    return true;
  }
  return false;
}

void printStationRawFrameDump(const String &line, const char *reason) {
  if (stationRawDumpCount >= 20) {
    return;
  }
  stationRawDumpCount++;
  Serial.print(F("STATION_HW_PARSE_ERROR station_parser=auto_station_manual station_parse_error_reason="));
  Serial.print(reason);
  Serial.print(F(" station_raw_frame="));
  for (uint16_t i = 0; i < line.length(); ++i) {
    uint8_t value = static_cast<uint8_t>(line.charAt(i));
    bool safe = (value >= 'A' && value <= 'Z') || (value >= 'a' && value <= 'z') ||
                (value >= '0' && value <= '9') || value == '-' || value == '_' ||
                value == '.' || value == ':' || value == '/' ||
                value == '@' || value == '*';
    if (safe) {
      Serial.print(static_cast<char>(value));
    } else {
      Serial.print('%');
      if (value < 0x10) {
        Serial.print('0');
      }
      Serial.print(value, HEX);
    }
  }
  Serial.print(F(" station_raw_frame_hex="));
  for (uint16_t i = 0; i < line.length(); ++i) {
    uint8_t value = static_cast<uint8_t>(line.charAt(i));
    if (value < 0x10) {
      Serial.print('0');
    }
    Serial.print(value, HEX);
  }
  Serial.println();
}

// ---------------------------------------------------------------------------
// USB debug print stall guard
//
// Native-USB CDC writes can block the control loop whenever a host holds the
// port open but stops draining it: a monitor window left open and suspended,
// scroll-locked, or a reader killed without releasing the port. One ~3 KB
// status line then stalls for up to seconds, which the driver feels as laggy
// manual control WHILE the cable is plugged in. The mirror failure (printing
// with no host at all) stalled the loop when the cable was pulled. The guard
// covers both:
//   - it caches the (bool)Serial host gate, because the SAMD core's operator
//     bool can cost ~10 ms per evaluation and must not run every loop tick,
//   - it times every gated print block and mutes ALL debug printing for a
//     cooldown when one print runs over budget,
//   - while muted it retries with a one-packet probe line instead of a full
//     status line, so a still-stalled host costs bounded tens of ms per
//     cooldown instead of seconds per status period.
// Motor control never waits on printing: when in doubt the guard drops output.
constexpr uint32_t USB_PRINT_GATE_REFRESH_MS = 1000;
constexpr uint32_t USB_PRINT_STALL_BUDGET_MS = 50;
constexpr uint32_t USB_PRINT_PROBE_BUDGET_MS = 10;
constexpr uint32_t USB_PRINT_MUTE_MS = 5000;

// Control-loop latency telemetry: the worst loop iteration since the last
// status print, in microseconds. If manual driving feels laggy while
// loop_dt_max_ms stays small, the cause is OUTSIDE this firmware (battery
// sag, hot motors, transmitter); if it spikes, something is blocking loop().
uint32_t loopDtPrevUs = 0;
uint32_t loopDtMaxUs = 0;

void loopDtSample() {
  uint32_t nowUs = micros();
  if (loopDtPrevUs != 0) {
    uint32_t dt = nowUs - loopDtPrevUs;
    if (dt > loopDtMaxUs) {
      loopDtMaxUs = dt;
    }
  }
  loopDtPrevUs = nowUs;
}
bool usbPrintGateOpen = false;
bool usbPrintGateChecked = false;
bool usbPrintMuted = false;
uint32_t usbPrintGateCheckedMs = 0;
uint32_t usbPrintMutedAtMs = 0;
uint32_t usbPrintStallCount = 0;

void usbDebugPrintFinished(uint32_t startedMs) {
  uint32_t finishedMs = millis();
  if (finishedMs - startedMs > USB_PRINT_STALL_BUDGET_MS) {
    usbPrintMuted = true;
    usbPrintMutedAtMs = finishedMs;
    usbPrintStallCount++;
  }
}

bool usbDebugPrintAllowed(uint32_t now) {
  if (!usbPrintGateChecked || now - usbPrintGateCheckedMs >= USB_PRINT_GATE_REFRESH_MS) {
    usbPrintGateChecked = true;
    usbPrintGateCheckedMs = now;
    usbPrintGateOpen = (bool)Serial;
  }
  if (!usbPrintGateOpen) {
    return false;
  }
  if (usbPrintMuted) {
    if (now - usbPrintMutedAtMs < USB_PRINT_MUTE_MS) {
      return false;
    }
    // Probe with a single short line: a draining host completes it in well
    // under a millisecond; a still-stalled host costs one bounded packet
    // timeout and the mute window re-arms.
    uint32_t probeStartMs = millis();
    Serial.println(F("USBDBG_RESUME_PROBE"));
    if (millis() - probeStartMs > USB_PRINT_PROBE_BUDGET_MS) {
      usbPrintMutedAtMs = millis();
      usbPrintStallCount++;
      return false;
    }
    usbPrintMuted = false;
  }
  return true;
}
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
void loop() {
#if LOOP_IDLE_WFI
  // Sleep until the next interrupt instead of busy-spinning. Maximum added
  // command latency is one SysTick (1 ms); the win is much lower continuous
  // CPU power draw, i.e. less self-heating during long field sessions.
  __WFI();
#endif
  loopDtSample();
#if ENABLE_GPS_TELEMETRY && !MOTOR_PULSE_TEST_MODE && !STAGE15_GUARDED_CRAWL_TEST
  while (GPS_SERIAL.available() > 0) {
    processGpsChar(static_cast<char>(GPS_SERIAL.read()));
  }
#endif

#if HC12_LINK_ENABLED
  while (HC12_SERIAL.available() > 0) {
    char c = static_cast<char>(HC12_SERIAL.read());
    if (c == '\n') {
      processHC12Line(hc12Line);
      hc12Line = "";
    } else if (c != '\r') {
      hc12Line += c;
    }
  }
#endif

  uint16_t steeringUs = 0;
  uint16_t throttleUs = 0;
  uint16_t modeUs = 0;
  readRcChannels(steeringUs, throttleUs, modeUs);

  uint32_t now = millis();
#if IMU_ENABLE
  imuControllerUpdate(now);  // read-only IMU diagnostics; never affects motors
#endif
  bool rcValid = rcChannelsValid(steeringUs, throttleUs, modeUs);
  bool autoSwitchOn = rcAutoSwitchOn(modeUs);
  bool stationManualFresh = stationManualValid();
  bool stationManualActive = stationManualFresh && stationManual.deadman && !stationEstop;
  bool rcManualActive = rcValid && !autoSwitchOn;

#if STAGE15_GUARDED_CRAWL_TEST
  clearAutoCommand();
  clearStationManualCommand();
  bool neutralOk = stage15NeutralOk(steeringUs, throttleUs);
  stage15ReadUsbCommands(rcValid, neutralOk, now);
  stage15UpdatePulse(rcValid, neutralOk, now);
  currentControlSource = stage15PulseActiveFlag ? CONTROL_SOURCE_AUTO : CONTROL_SOURCE_STOP;
  currentMode = rcValid ? (stage15PulseActiveFlag ? AUTO_RUNNING : AUTO_READY) : FAILSAFE;
  return;
#endif

#if STAGE16_USB_GUARDED_CRAWL || STAGE17_FIRST_PRIMITIVE_CRAWL || STAGE18_MOTOR_MAPPING_PROBE || STAGE20_PHYSICAL_AB_GUARDED_CRAWL
  clearAutoCommand();
  clearStationManualCommand();
  bool neutralOk = stage16NeutralOk(steeringUs, throttleUs);
  if (STAGE20_PHYSICAL_AB_GUARDED_CRAWL_ENABLED && !USB_DRIVE_LIVE_ENABLED && rcManualActive && !neutralOk) {
    stage16PulseActiveFlag = false;
    stage16ArmedFlag = false;
    stage16CmdState = "STOPPED";
    stage16LeftCmd = 0.0f;
    stage16RightCmd = 0.0f;
    stage16CmdMs = 0;
    currentMode = MANUAL;
    currentControlSource = CONTROL_SOURCE_RC_MANUAL;
    applyManualOverride(steeringUs, throttleUs);
    debugPrintStatus();
    return;
  }
  stage16ReadUsbCommands(rcValid, neutralOk, now);
  stage16UpdatePulse(rcValid, neutralOk, now);
  stage16Heartbeat(rcValid, neutralOk, now);
  bool guardedUsbActive = stage16PulseActiveFlag || usbDriveLiveActiveFlag;
  currentControlSource = guardedUsbActive ? CONTROL_SOURCE_AUTO : CONTROL_SOURCE_STOP;
  currentMode = rcValid ? (guardedUsbActive ? AUTO_RUNNING : AUTO_READY) : FAILSAFE;
  return;
#endif

#if MANUAL_CONTROL_PPM || MANUAL_RC_RECOVERY
  clearAutoCommand();
  clearStationManualCommand();
  if (!rcValid) {
#if RC_AUTO_PATTERN
    // Failsafe stop happens below either way; a SHORT link glitch keeps a
    // running pattern paused (grace window) instead of killing the run.
    rcAutoPatternNoteRcLost(now);
#endif
    currentControlSource = CONTROL_SOURCE_STOP;
    currentMode = FAILSAFE;
    motorStop();
  } else if (rcManualActive) {
#if RC_AUTO_PATTERN
    rcAutoPatternNoteManual(now);
#endif
    currentMode = MANUAL;
    currentControlSource = CONTROL_SOURCE_RC_MANUAL;
    applyManualOverride(steeringUs, throttleUs);
  } else {
#if RC_AUTO_PATTERN
    // CH5 in AUTO: run the onboard pattern (arming requires a fresh MANUAL
    // period; flipping back to MANUAL stops motors on the next tick).
    rcAutoPatternTick(now);
#else
    currentControlSource = CONTROL_SOURCE_STOP;
    currentMode = AUTO_READY;
    motorStop();
#endif
  }
  // Printing is fully self-guarded inside debugPrintStatus (cached host gate
  // + write-stall watchdog), so plugged, unplugged, and stalled-monitor hosts
  // all keep manual control responsive.
  debugPrintStatus();
  return;
#endif

#if MOTOR_PULSE_TEST_MODE
  clearAutoCommand();
  clearStationManualCommand();
  updateMotorPulseState(rcValid, autoSwitchOn, rcManualActive, steeringUs, throttleUs, now);
  if (!rcValid) {
    currentControlSource = CONTROL_SOURCE_STOP;
    currentMode = FAILSAFE;
    motorStop();
  } else if (rcManualActive) {
    currentMode = MANUAL;
    currentControlSource = CONTROL_SOURCE_RC_MANUAL;
    applyManualOverride(steeringUs, throttleUs);
  } else if (autoSwitchOn) {
    if (motorPulseReadyFlag) {
      currentMode = AUTO_RUNNING;
      currentControlSource = CONTROL_SOURCE_AUTO;
      applyMotorPulseDirectWheelCommand(MOTOR_PULSE_LEFT_CMD_VALUE, MOTOR_PULSE_RIGHT_CMD_VALUE);
    } else {
      currentMode = AUTO_READY;
      currentControlSource = CONTROL_SOURCE_STOP;
      motorStop();
    }
  } else {
    currentControlSource = CONTROL_SOURCE_STOP;
    currentMode = DISARMED;
    motorStop();
  }
  debugPrintStatus();
  return;
#endif

#if FIXED_WIRING_GPS_SERIAL2_DIAG
  clearAutoCommand();
  clearStationManualCommand();
  currentControlSource = CONTROL_SOURCE_STOP;
  currentMode = rcValid ? DISARMED : FAILSAFE;
  motorStop();
  debugPrintStatus();
  return;
#endif

#if FIXED_WIRING_GPS_SERIAL2_RC_AUTONOMY_DRYRUN
  clearAutoCommand();
  clearStationManualCommand();
  if (!rcValid) {
    currentControlSource = CONTROL_SOURCE_STOP;
    currentMode = FAILSAFE;
    motorStop();
  } else if (rcManualActive) {
    currentMode = MANUAL;
    currentControlSource = CONTROL_SOURCE_RC_MANUAL;
    applyManualOverride(steeringUs, throttleUs);
  } else if (autoSwitchOn) {
    currentMode = AUTO_READY;
    currentControlSource = CONTROL_SOURCE_STOP;
    motorStop();
  } else {
    currentControlSource = CONTROL_SOURCE_STOP;
    currentMode = DISARMED;
    motorStop();
  }
  debugPrintStatus();
  return;
#endif

#if FIXED_WIRING_GPS_SERIAL2_SINGLE_WAYPOINT_EXPERIMENT
  clearAutoCommand();
  clearStationManualCommand();
  updateSingleWaypointExperimentState(rcValid, autoSwitchOn, now);
  updateGroundCrawlState(rcValid, autoSwitchOn, rcManualActive, steeringUs, throttleUs);
  if (!rcValid) {
    currentControlSource = CONTROL_SOURCE_STOP;
    currentMode = FAILSAFE;
    motorStop();
  } else if (rcManualActive) {
    currentMode = MANUAL;
    currentControlSource = CONTROL_SOURCE_RC_MANUAL;
    applyManualOverride(steeringUs, throttleUs);
  } else if (autoSwitchOn) {
    // Armed AUTO motion is permitted ONLY through the guarded ground crawl harness.
    // Any armed build without GROUND_CRAWL_TEST_MODE=1 (or a failed/latched crawl
    // gate) holds the final commands at zero.
    if (singleWaypointSafetyReadyFlag && SINGLE_WAYPOINT_AUTO_MOTION_ARMED &&
        GROUND_CRAWL_ENABLED && groundCrawlReadyFlag) {
      currentMode = AUTO_RUNNING;
      currentControlSource = CONTROL_SOURCE_AUTO;
      applyAutoCommand(clampGroundCrawl(singleWaypointCandidateLeftCmd),
                       clampGroundCrawl(singleWaypointCandidateRightCmd));
    } else {
      currentMode = AUTO_READY;
      currentControlSource = CONTROL_SOURCE_STOP;
      motorStop();
    }
  } else {
    currentControlSource = CONTROL_SOURCE_STOP;
    currentMode = DISARMED;
    motorStop();
  }
  debugPrintStatus();
  return;
#endif

#if PATH_FOLLOWING_DRYRUN
  clearAutoCommand();
  clearStationManualCommand();
  pfReadHc12();
  updatePathFollowingDryrun(rcValid, autoSwitchOn, rcManualActive, steeringUs, throttleUs, now);
  const char *pfPhysReason =
      pathFollowingPhysicalBlockReason(rcValid, autoSwitchOn, rcManualActive);
  bool pfPhysAllowed = (strcmp(pfPhysReason, "OK") == 0);
  pfPhysicalOutputActiveFlag = false;
  if (!rcValid) {
    currentControlSource = CONTROL_SOURCE_STOP;
    currentMode = FAILSAFE;
    motorStop();
  } else if (rcManualActive) {
    currentMode = MANUAL;
    currentControlSource = CONTROL_SOURCE_RC_MANUAL;
    applyManualOverride(steeringUs, throttleUs);
  } else if (autoSwitchOn) {
    // Guarded physical path-following. pfPhysAllowed is true only when every
    // compile gate AND runtime gate passed; the default build keeps it false.
    if (pfPhysAllowed) {
      float left = clampUnit(pfDesiredForwardCmd + pfDesiredTurnCmd);
      float right = clampUnit(pfDesiredForwardCmd - pfDesiredTurnCmd);
      currentMode = AUTO_RUNNING;
      currentControlSource = CONTROL_SOURCE_AUTO;
      pfPhysicalOutputActiveFlag = true;
      applyAutoCommand(left, right);
    } else {
      currentMode = AUTO_READY;
      currentControlSource = CONTROL_SOURCE_STOP;
      motorStop();
    }
  } else {
    currentControlSource = CONTROL_SOURCE_STOP;
    currentMode = DISARMED;
    motorStop();
  }
  pathFollowingDebugPrint(rcValid, autoSwitchOn, steeringUs, throttleUs, modeUs, pfPhysReason);
  return;
#endif

  if (autoCommandActive && !stationLinkValid()) {
    currentMode = LINK_LOST;
    clearAutoCommand();
    motorStop();
  }

  bool autoActive = rcValid && autoSwitchOn && autoCommandActive && stationLinkValid() && !stationEstop;

  if (stationEstop) {
    currentControlSource = CONTROL_SOURCE_STOP;
    currentMode = DISARMED;
    motorStop();
  } else if (stationManualActive) {
    currentMode = MANUAL;
    currentControlSource = CONTROL_SOURCE_STATION_MANUAL;
    applyStationManualCommand();
  } else if (rcManualActive) {
    currentMode = MANUAL;
    currentControlSource = CONTROL_SOURCE_RC_MANUAL;
    clearAutoCommand();
    applyManualOverride(steeringUs, throttleUs);
  } else if (autoActive) {
    currentMode = AUTO_RUNNING;
    currentControlSource = CONTROL_SOURCE_AUTO;
    applyAutoCommand(autoLeftCmd, autoRightCmd);
  } else {
    currentControlSource = CONTROL_SOURCE_STOP;
    motorStop();
    if (!rcValid) {
      currentMode = FAILSAFE;
    } else if (autoSwitchOn) {
      if (currentMode != LINK_LOST) {
        currentMode = AUTO_READY;
      }
    } else {
      currentMode = DISARMED;
    }
  }

  if (now - lastTelemetryMs > TELEMETRY_PERIOD_MS) {
    sendGpsTelemetry();
    lastTelemetryMs = now;
  }

  if (now - lastStatusMs > STATUS_PERIOD_MS) {
    sendStatus(lastStationSeq >= 0 ? static_cast<uint32_t>(lastStationSeq) : 0);
    lastStatusMs = now;
  }

  debugPrintStatus();
}
