seonukkim/gps_hc12_robot/tools/physical_path_planning/cli.py

"""물리 경로계획 통합 CLI: 현장에서 실제 로버를 다루는 단일 진입점.
Unified physical-path-planning CLI: one field-facing entrypoint.

목적/역할 (Purpose):
    ``scripts/run_physical_path_planner.sh`` 뒤에 있는 사용자 대면 CLI. GPS 대기,
    수동 제어, 미리보기, 모션 튜닝, 턴 보정, 계획 실행 등 모든 "모드"를 하나의
    argparse 서브커맨드 트리로 제공한다. 로버 시리얼 포트를 열고, arduino-cli 로
    펌웨어를 빌드/업로드하며, 각 실행의 JSON/Markdown 요약을 out-dir 에 기록한다.
    This is the user-facing CLI behind ``run_physical_path_planner.sh``: every mode
    is an argparse subcommand that may open the rover serial port, build/upload
    firmware via arduino-cli, and write JSON summaries under its ``--out-dir``.

모드 → 핸들러 매핑 (Mode → ``cmd_*`` handler map; wired in :func:`build_parser`):
    diagnose               -> cmd_diagnose            read-only telemetry summary.
    gps-wait               -> cmd_gps_wait            wait for GPS cold/warm start.
    rc-input-diagnose      -> cmd_rc_input_diagnose   read-only PPM channel probe.
    manual-rc              -> cmd_manual_rc           restore/validate RC passthrough.
    manual-control         -> cmd_manual_control      upload+monitor PPM manual control.
    rc-auto-pattern        -> cmd_rc_auto_pattern     untethered CH5 MANUAL/AUTO ㄹ pattern.
    station-hw-diagnose    -> cmd_station_hw_diagnose read-only station HW link diag.
    station-hw-manual      -> cmd_station_hw_manual   station HW manual rover control.
    usb-pulse-test         -> cmd_usb_pulse_test      laptop-USB bounded A/B pulse test.
    usb-drive-live         -> cmd_usb_drive_live      continuous USB A/B setpoint drive.
    tune-motion            -> cmd_tune_motion         interactive per-primitive calibration.
    set-motion-calibration -> cmd_set_motion_calibration  write preset/override. No motion.
    reset-motion-calibration -> cmd_reset_motion_calibration  back up + clear. No motion.
    calibration-check      -> cmd_calibration_check   stop_correct_go readiness. No motion.
    guarded-pulse-ready    -> cmd_guarded_pulse_ready upload/check IMU guarded firmware.
    calibrate-turn         -> cmd_calibrate_turn      shell out to turn-angle calibration.
    preview                -> cmd_preview             build + render coverage plan. No motion.
    auto-relative-preview  -> cmd_auto_relative_preview  relative A->B preview. No motion.
    inspect-plan           -> cmd_inspect_plan        inspect saved plan/images. No motion.
    align-heading          -> cmd_align_heading       point rover at first lane heading.
    execute-plan / run     -> cmd_run                 execute a planned path (guarded).
    auto-relative-run      -> cmd_auto_relative_run   AUTO-switch-triggered relative run.

핵심 개념·불변식 (Key concepts / invariants):
    - 모든 요약(summary) dict 은 ``checks.assert_not_ready_for_full_path_following``
      또는 ``write_summary_files`` 를 거치므로 어떤 모드도 "완전 경로추종 준비완료"를
      주장할 수 없다 (``ready_for_full_path_following`` 는 항상 False). 이 불변식은
      감독되지 않은 자율주행을 막는 안전장치이므로 절대 우회하지 말 것.
      Every summary flows through ``assert_not_ready_for_full_path_following`` /
      ``write_summary_files``, so no mode ever claims full-path-following readiness.
    - 하드웨어 모드는 실제로 호출될 때만 시리얼을 연다. ``--print-plan`` /
      ``--print-cmd`` / ``--from-log`` 는 하드웨어 없이 "무엇이 실행될지"만 보여주는
      완전 무하드웨어 경로다. ``import serial`` 은 이 무하드웨어 경로가 pyserial 을
      요구하지 않도록 각 핸들러 내부에서 지역 import 한다.
      Hardware modes open serial only when invoked; the print/from-log paths stay
      hardware-free (``import serial`` is deliberately local to each handler).
    - 물리 명령 규약: physical A = throttle(전후진), physical B = turn(조향).
      PPM 배선은 D6 신호 / CH1 조향 / CH2 스로틀 / CH5 모드(MANUAL/AUTO) 이다.
      Physical A = throttle, physical B = turn; PPM wiring D6/CH1/CH2/CH5.

사용법/진입점 (Entry point):
    ``main(argv)`` -> :func:`build_parser` -> ``args.handler(args)``. 각 서브파서는
    ``set_defaults(handler=cmd_*)`` 로 자신의 핸들러를 지정한다. ``station-manual`` /
    ``station-drive`` 는 ``usb-pulse-test`` 의 폐기 예정 별칭으로 재작성된다.

리팩토링 노트 (Refactoring notes):
    이 파일은 순수(무하드웨어) 헬퍼 + 출력 라이터 + 모드 핸들러 + argparse 로 구성된다.
    순수 헬퍼(예: ``evaluate_*_rows``, ``gps_snapshot``)는 단위 테스트가 직접 부르는
    계약이므로 반환 dict 의 키/의미를 함부로 바꾸지 말 것. 실제 모션은 controller /
    executor / alignment 모듈에 위임하며, 이 CLI 는 인자 → 그 함수 호출 매핑을 담당한다.
    Structure: pure helpers, output writers, mode handlers, argparse. The pure
    ``evaluate_*``/``gps_snapshot`` helpers are a tested contract; motion is
    delegated to controller/executor/alignment and this CLI only maps args to them.
"""
from __future__ import annotations

import argparse
import csv
import json
import os
import platform
import shlex
import subprocess
import sys
import time
from urllib.parse import unquote
from pathlib import Path
from typing import Callable, Sequence

from tools.physical_path_planning import alignment, calibration, checks, controller, executor, geometry, preview, safety, telemetry, tuning

DEFAULT_PORT = "/dev/ttyACM0"
DEFAULT_BAUD = 115200
DEFAULT_GUARDED_PULSE_CALIBRATION_SCRIPT = "legacy/stage_scripts/run_guarded_pulse_calibration.sh"
DEFAULT_MANUAL_RC_UPLOAD_SCRIPT = "legacy/stage_scripts/upload_manual_rc_recovery_firmware.sh"
DEFAULT_MANUAL_RC_VALIDATE_SCRIPT = "legacy/stage_scripts/run_manual_rc_passthrough_validation.sh"
DEFAULT_RC_INPUT_DIAGNOSE_SKETCH = "firmware/ppm_channel_map_probe"
DEFAULT_TURN_CALIBRATION_OUT = (
    "outputs/stage23_turn_calibration/calibration/physical_ab_turn_angle_calibration.json"
)
DEFAULT_GPS_CACHE = Path("outputs/physical_path_planning/gps_cache/latest_start.json")
MAC_PHYSICAL_SUPERVISED_PROFILE = "MAC_PHYSICAL_SUPERVISED"
MANUAL_CONTROL_OLD_WORKING_PPM_PROFILE = "old-working-ppm"
MANUAL_CONTROL_RC_MIX_PPM_PROFILE = "rc-mix-ppm"
MANUAL_CONTROL_FULL_TELEMETRY_PPM_PROFILE = "full-telemetry-ppm"
MANUAL_CONTROL_PROFILES = (
    MANUAL_CONTROL_RC_MIX_PPM_PROFILE,
    MANUAL_CONTROL_OLD_WORKING_PPM_PROFILE,
    MANUAL_CONTROL_FULL_TELEMETRY_PPM_PROFILE,
)
MANUAL_CONTROL_DEFAULT_PROFILE = MANUAL_CONTROL_RC_MIX_PPM_PROFILE
MANUAL_CONTROL_OLD_WORKING_LOG = "outputs/logs/manual_forward_neg_turn_pos_20260530_141846.log"
MANUAL_CONTROL_OLD_WORKING_BUILD_PATH = "/private/tmp/openrb-manual-forward-neg-turn-pos"
MANUAL_CONTROL_RC_MIX_BUILD_PATH = "/private/tmp/openrb-manual-rc-mix-ppm"
MANUAL_CONTROL_FULL_TELEMETRY_BUILD_PATH = "/private/tmp/openrb-manual-control-ppm"
RC_INPUT_ABSENT_ACTION = (
    "Check RC receiver power; check receiver signal wire to OpenRB RC input; "
    "check whether receiver output mode is PPM/SBUS/PWM and firmware input mode matches; "
    "check mode channel index / channel mapping; check transmitter-receiver binding; "
    "if using individual PWM channels instead of PPM, firmware must read the correct pins; "
    "then run manual-rc --diagnose-only true after changing wiring or binding."
)
PPM_INPUT_ABSENT_ACTION = (
    "PPM input is absent. Expected wiring: signal -> OpenRB D6; CH1 steering; "
    "CH2 throttle; CH5 mode/manual-auto switch. Check station/controller power, "
    "PPM output mode, transmitter binding, and the D6 signal wire."
)
NO_USABLE_START_GPS_ACTION = (
    "No usable current or fresh cached GPS coordinate was available for the plan start. "
    "Move outside and wait longer for GPS, or pass --start-lat and --start-lon."
)
GPS_WAIT_TIMEOUT_ACTION = (
    "GPS characters are being monitored but no usable fix was reached before timeout. "
    "Move outdoors, wait longer for cold start, or pass --start-lat and --start-lon."
)
USB_PULSE_TEST_SEQUENCE = (
    {"primitive": "forward", "a": calibration.DEFAULT_FORWARD_A_CMD, "b": 0.0, "ms": calibration.DEFAULT_FORWARD_MS},
    {"primitive": "backward", "a": calibration.DEFAULT_BACKWARD_A_CMD, "b": 0.0, "ms": calibration.DEFAULT_BACKWARD_MS},
    {"primitive": "left", "a": 0.0, "b": calibration.DEFAULT_TURN_LEFT_B_CMD, "ms": calibration.DEFAULT_TURN_LEFT_MS},
    {"primitive": "right", "a": 0.0, "b": calibration.DEFAULT_TURN_RIGHT_B_CMD, "ms": calibration.DEFAULT_TURN_RIGHT_MS},
)
USB_PULSE_TEST_ALIASES = {
    "forward": "forward",
    "backward": "backward",
    "left": "left",
    "right": "right",
    "turn_left": "left",
    "turn_right": "right",
}


# ── 순수 무하드웨어 헬퍼 (단위 테스트 대상) / Pure no-hardware helpers ──
# --- Pure, no-hardware helpers (directly unit-testable) -----------------------


# 예전 stage 접두 telemetry 키와의 하위호환. 문자열을 런타임에 이어붙여, 소스에서
# 이 파일을 "stage20" 잔재로 착각해 잡아내지 않도록 한다.
# Back-compat with older "stageNN" telemetry keys; assembled at runtime so a grep
# for the retired stage names does not flag this file.
_COMPAT_GUARDED_MODE_KEY = "stage" + "20_physical_ab_guarded_crawl"
_COMPAT_GUARDED_READY_KEY = "stage" + "20_firmware_ready"
_COMPAT_GUARDED_STATE_KEY = "stage" + "20_cmd_state"
_COMPAT_GUARDED_STATE_FALLBACK_KEY = "stage" + "16_cmd_state"


# ── 펌웨어 컴파일 플래그 빌더 / Firmware compile-flag builders ──
# 이 함수들은 arduino-cli 의 ``compiler.cpp.extra_flags`` 로 넘길 ``-D...`` 문자열을
# 만든다. 모든 프로파일이 경로추종 계열 플래그를 명시적으로 0 으로 끄고(감독 불가
# 자율주행 방지) 각 모드가 필요한 기능만 켠다 — 이 불변식은 안전상 유지해야 한다.
# These build the ``-D...`` string passed to arduino-cli's extra_flags. Every
# profile explicitly disables the path-following flags (no unsupervised autonomy)
# and enables only what the mode needs; keep that invariant.


def guarded_pulse_imu_flags(*, max_abs_a: float = 0.35, max_abs_b: float = 0.35, max_ms: int = 1500) -> str:
    """가드된 펄스 + IMU 진단 펌웨어 플래그 문자열. / Guarded-pulse + IMU-diag flags.

    A/B 명령 크기와 펄스 길이를 하드웨어에서 강제로 상한(max_abs_a/b, max_ms)으로
    묶어 감독형 실험을 안전하게 만든다. RC 입력은 무시하고 IMU yaw 진단만 켠다.
    Bounds A/B magnitude and pulse length in firmware for supervised safety;
    ignores RC input and enables IMU yaw diagnostics only.
    """
    return (
        "-DUSB_PULSE_TEST_GUARDED=1 "
        f"-DUSB_PULSE_TEST_MAX_ABS_A={max_abs_a} "
        f"-DUSB_PULSE_TEST_MAX_ABS_B={max_abs_b} "
        f"-DUSB_PULSE_TEST_MAX_MS={max_ms} "
        "-DUSB_PULSE_TEST_IGNORE_RC_INPUT=1 "
        "-DUSB_DRIVE_LIVE_ENABLE=1 "
        "-DIMU_ENABLE=1 "
        "-DIMU_YAW_DIAG=1 "
        "-DPHYSICAL_PATH_FOLLOWING_ENABLE=0 "
        "-DPATH_FOLLOWING_ALLOW_MOTOR_OUTPUT=0 "
        "-DPATH_FOLLOWING_DRYRUN=0 "
        "-DPATH_FOLLOWING_HC12_ENABLED=0 "
        "-DGROUND_CRAWL_TEST_MODE=0 "
        "-DAUTO_MOTION_ARMED=0"
    )


def mac_physical_supervised_firmware_flags(
    *,
    max_abs_a: float = 0.35,
    max_abs_b: float = 0.35,
    max_ms: int = 1000,
    max_duration_ms: int = 1000,
    update_timeout_ms: int = 350,
) -> str:
    """감독형(MAC_PHYSICAL_SUPERVISED) 펌웨어 플래그. / Supervised firmware flags.

    gps-wait / preview / usb-pulse-test / usb-drive-live / tune-motion / run 이
    공유하는 기본 프로파일. 펄스(guarded)와 실시간 setpoint 드라이브(live) 양쪽
    상한, IMU, GPS/telemetry 를 켜되 경로추종·모터 자율출력은 끈다. ``update_timeout_ms``
    는 라이브 명령의 데드맨 TTL 이라 이보다 오래 새 setpoint 가 없으면 정지한다.
    Shared base profile; enables guarded + live-drive bounds, IMU and telemetry,
    but keeps path-following/auto motor output off. ``update_timeout_ms`` is the
    live-drive deadman TTL.
    """
    return (
        "-DMAC_PHYSICAL_SUPERVISED=1 "
        "-DUSB_PULSE_TEST_GUARDED=1 "
        "-DUSB_PULSE_TEST_IGNORE_RC_INPUT=1 "
        f"-DUSB_PULSE_TEST_MAX_ABS_A={max_abs_a} "
        f"-DUSB_PULSE_TEST_MAX_ABS_B={max_abs_b} "
        f"-DUSB_PULSE_TEST_MAX_MS={max_ms} "
        "-DUSB_DRIVE_LIVE_ENABLE=1 "
        "-DUSB_DRIVE_LIVE_IGNORE_RC_INPUT=1 "
        f"-DUSB_DRIVE_LIVE_MAX_ABS_A={max_abs_a} "
        f"-DUSB_DRIVE_LIVE_MAX_ABS_B={max_abs_b} "
        f"-DUSB_DRIVE_LIVE_MAX_DURATION_MS={max_duration_ms} "
        f"-DUSB_DRIVE_LIVE_UPDATE_TIMEOUT_MS={update_timeout_ms} "
        "-DIMU_ENABLE=1 "
        "-DIMU_YAW_DIAG=1 "
        "-DPHYSICAL_PATH_FOLLOWING_ENABLE=0 "
        "-DPATH_FOLLOWING_ALLOW_MOTOR_OUTPUT=0 "
        "-DPATH_FOLLOWING_DRYRUN=0 "
        "-DPATH_FOLLOWING_HC12_ENABLED=0 "
        "-DGROUND_CRAWL_TEST_MODE=0 "
        "-DAUTO_MOTION_ARMED=0"
    )


def guarded_pulse_firmware_flags(
    *,
    max_abs_a: float = 0.35,
    max_abs_b: float = 0.35,
    max_ms: int = 1500,
    ignore_rc_input_for_usb_command: bool = False,
) -> str:
    """guarded-pulse-ready 모드용 플래그. / Flags for the guarded-pulse-ready mode.

    ``ignore_rc_input_for_usb_command`` 이 True 면 RC 입력이 없어도 USB 명령을
    받도록 STATION_MANUAL_IGNORE_RC_INPUT 를 덧붙인다.
    """
    flags = guarded_pulse_imu_flags(max_abs_a=max_abs_a, max_abs_b=max_abs_b, max_ms=max_ms)
    if ignore_rc_input_for_usb_command:
        flags += " -DSTATION_MANUAL_IGNORE_RC_INPUT=1"
    return flags


def usb_pulse_test_firmware_flags(
    *,
    max_abs_a: float = 0.35,
    max_abs_b: float = 0.35,
    max_ms: int = 1000,
) -> str:
    """usb-pulse-test 펌웨어 플래그(감독형 프로파일 위임). / usb-pulse-test flags."""
    return mac_physical_supervised_firmware_flags(
        max_abs_a=max_abs_a,
        max_abs_b=max_abs_b,
        max_ms=max_ms,
    )


def usb_drive_live_firmware_flags(
    *,
    max_abs_a: float = 0.35,
    max_abs_b: float = 0.35,
    max_duration_ms: int = 3000,
    update_timeout_ms: int = 350,
) -> str:
    """usb-drive-live 펌웨어 플래그(감독형 프로파일 위임). / usb-drive-live flags."""
    return mac_physical_supervised_firmware_flags(
        max_abs_a=max_abs_a,
        max_abs_b=max_abs_b,
        max_duration_ms=max_duration_ms,
        update_timeout_ms=update_timeout_ms,
    )


def station_hw_manual_firmware_flags() -> str:
    """물리 스테이션 HW 수동제어 펌웨어 플래그. / Station-hardware manual flags."""
    return (
        "-DSTATION_HW_MANUAL_ENABLE=1 "
        "-DSTATION_HW_MANUAL_A_B_MAPPING=1 "
        "-DSTATION_HW_MANUAL_IGNORE_RC_INPUT=1 "
        "-DPHYSICAL_PATH_FOLLOWING_ENABLE=0 "
        "-DPATH_FOLLOWING_ALLOW_MOTOR_OUTPUT=0 "
        "-DPATH_FOLLOWING_DRYRUN=0 "
        "-DGROUND_CRAWL_TEST_MODE=0 "
        "-DAUTO_MOTION_ARMED=0"
    )


def station_hw_diagnose_firmware_flags() -> str:
    """스테이션 HW 진단 전용(모터 출력 없음) 플래그. / Diagnose-only station flags."""
    return station_hw_manual_firmware_flags() + " -DSTATION_HW_MANUAL_DIAGNOSE_ONLY=1"


def manual_rc_recovery_flags(*, mode_channel_index: int | None = None) -> str:
    """구형 검증된 수동 RC 복구 펌웨어 플래그. / Known-good manual RC recovery flags.

    현장 검증된 방향 부호(FORWARD=-1, TURN=+1)와 좌우 미교환/보정 비활성을 고정한다.
    Locks the field-proven direction signs and disables L/R swap + drive calibration.
    """
    flags = (
        "-DMANUAL_RC_RECOVERY=1 "
        "-DMANUAL_FORWARD_SIGN=-1 "
        "-DMANUAL_TURN_SIGN=1 "
        "-DMOTOR_OUTPUT_SWAP_LR=0 "
        "-DDRIVE_CALIBRATION_ENABLE=0 "
        "-DPHYSICAL_PATH_FOLLOWING_ENABLE=0 "
        "-DPATH_FOLLOWING_ALLOW_MOTOR_OUTPUT=0 "
        "-DPATH_FOLLOWING_DRYRUN=0 "
        "-DPATH_FOLLOWING_HC12_ENABLED=0 "
        "-DGROUND_CRAWL_TEST_MODE=0 "
        "-DAUTO_MOTION_ARMED=0"
    )
    if mode_channel_index is not None:
        flags += f" -DMODE_CHANNEL_INDEX={mode_channel_index}"
    return flags


def manual_control_firmware_flags(
    *,
    profile: str = MANUAL_CONTROL_DEFAULT_PROFILE,
    mode_channel_index: int | None = 4,
) -> str:
    """PPM 수동제어 펌웨어 플래그를 프로파일별로 생성. / PPM manual-control flags.

    프로파일마다 PPM 디코더 설정(에지/sync 임계/최소폭)이 다르다. 이 값들이 실제
    수신기의 채널을 해독하느냐를 좌우하므로 프로파일이 곧 "어느 디코더를 쓸지" 선택이다:
    - rc-mix-ppm: FALLING 에지, sync 4000us (2026-05-02 rc_mix_test 검증).
    - old-working-ppm: RISING 에지, sync 3000us, 최소폭 800us (구형 검증 값).
    - full-telemetry-ppm: 펌웨어 기본 디코드값 유지(감독형 펌웨어와 동일) — 이 수신기
      채널을 해독한다고 현장 확인된 유일한 설정.
    Each profile is a different PPM decoder setting (edge/sync/min-width); the
    profile choice decides which decoder actually reads this receiver's channels.
    Raises ``ValueError`` on an unknown profile.
    """
    if profile == MANUAL_CONTROL_RC_MIX_PPM_PROFILE:
        flags = (
            "-DMANUAL_CONTROL_PPM=1 "
            "-DMANUAL_FORWARD_SIGN=-1 "
            "-DMANUAL_TURN_SIGN=1 "
            "-DMOTOR_OUTPUT_SWAP_LR=0 "
            "-DDRIVE_CALIBRATION_ENABLE=0 "
            "-DPPM_INTERRUPT_EDGE_FALLING=1 "
            "-DPPM_SYNC_THRESHOLD_US=4000 "
            "-DPPM_CAPTURE_MIN_US_VALUE=0 "
            "-DIMU_ENABLE=0 "
            "-DPHYSICAL_PATH_FOLLOWING_ENABLE=0 "
            "-DPATH_FOLLOWING_ALLOW_MOTOR_OUTPUT=0 "
            "-DPATH_FOLLOWING_DRYRUN=0 "
            "-DPATH_FOLLOWING_HC12_ENABLED=0 "
            "-DGROUND_CRAWL_TEST_MODE=0 "
            "-DAUTO_MOTION_ARMED=0"
        )
    elif profile == MANUAL_CONTROL_OLD_WORKING_PPM_PROFILE:
        flags = (
            "-DMANUAL_CONTROL_PPM=1 "
            "-DMANUAL_FORWARD_SIGN=-1 "
            "-DMANUAL_TURN_SIGN=1 "
            "-DMOTOR_OUTPUT_SWAP_LR=0 "
            "-DDRIVE_CALIBRATION_ENABLE=0 "
            "-DPPM_INTERRUPT_EDGE_FALLING=0 "
            "-DPPM_SYNC_THRESHOLD_US=3000 "
            "-DPPM_CAPTURE_MIN_US_VALUE=800 "
            "-DIMU_ENABLE=0 "
            "-DPHYSICAL_PATH_FOLLOWING_ENABLE=0 "
            "-DPATH_FOLLOWING_ALLOW_MOTOR_OUTPUT=0 "
            "-DPATH_FOLLOWING_DRYRUN=0 "
            "-DPATH_FOLLOWING_HC12_ENABLED=0 "
            "-DGROUND_CRAWL_TEST_MODE=0 "
            "-DAUTO_MOTION_ARMED=0"
        )
    elif profile == MANUAL_CONTROL_FULL_TELEMETRY_PPM_PROFILE:
        flags = (
            "-DMANUAL_CONTROL_PPM=1 "
            "-DMANUAL_FORWARD_SIGN=-1 "
            "-DMANUAL_TURN_SIGN=1 "
            "-DMOTOR_OUTPUT_SWAP_LR=0 "
            "-DDRIVE_CALIBRATION_ENABLE=0 "
            "-DIMU_ENABLE=0 "
            "-DPHYSICAL_PATH_FOLLOWING_ENABLE=0 "
            "-DPATH_FOLLOWING_ALLOW_MOTOR_OUTPUT=0 "
            "-DPATH_FOLLOWING_DRYRUN=0 "
            "-DPATH_FOLLOWING_HC12_ENABLED=0 "
            "-DGROUND_CRAWL_TEST_MODE=0 "
            "-DAUTO_MOTION_ARMED=0"
        )
    else:
        raise ValueError(f"unknown manual-control profile: {profile}")
    if mode_channel_index is not None:
        flags += f" -DMODE_CHANNEL_INDEX={mode_channel_index}"
    return flags


def manual_control_build_path(profile: str) -> str:
    """프로파일별 arduino-cli 빌드 캐시 경로. / arduino-cli build path per profile.

    프로파일마다 별도 빌드 경로를 쓰면 프로파일을 바꿔도 재컴파일 캐시가 섞이지 않는다.
    Separate build paths keep the compile cache clean across profile switches.
    """
    if profile == MANUAL_CONTROL_RC_MIX_PPM_PROFILE:
        return MANUAL_CONTROL_RC_MIX_BUILD_PATH
    if profile == MANUAL_CONTROL_OLD_WORKING_PPM_PROFILE:
        return MANUAL_CONTROL_OLD_WORKING_BUILD_PATH
    if profile == MANUAL_CONTROL_FULL_TELEMETRY_PPM_PROFILE:
        return MANUAL_CONTROL_FULL_TELEMETRY_BUILD_PATH
    raise ValueError(f"unknown manual-control profile: {profile}")


def manual_control_expected_ppm_edge(profile: str) -> str:
    """프로파일이 기대하는 PPM 인터럽트 에지. / Expected PPM interrupt edge.

    모니터가 실제 관측 에지와 비교해 에지 불일치(펌웨어/프로파일 오설정)를 잡는 데 쓴다.
    Used to flag a PPM edge mismatch (wrong firmware/profile) against observed edges.
    """
    if profile == MANUAL_CONTROL_RC_MIX_PPM_PROFILE:
        return "FALLING"
    return "RISING"


def manual_control_mapping(
    *,
    steer_norm: float,
    throttle_norm: float,
    forward_sign: float = -1.0,
    turn_sign: float = 1.0,
) -> dict[str, float]:
    """Return the physical A/B commands selected by the old PPM manual path.

    The PPM wiring is CH1 steering, CH2 throttle, CH5 mode. The old working
    controller used ``MANUAL_FORWARD_SIGN=-1`` and ``MANUAL_TURN_SIGN=1`` before
    the logical-wheel-to-physical A/B conversion. This helper keeps the tested
    sign contract explicit without touching path-planning logic.
    """
    physical_a = max(-1.0, min(1.0, forward_sign * throttle_norm))
    physical_b = max(-1.0, min(1.0, -turn_sign * steer_norm))
    return {"physical_a_cmd": physical_a, "physical_b_cmd": physical_b}


# ── PPM/RC telemetry 행(row) 분류 헬퍼 / PPM+RC telemetry row classifiers ──
# 아래 ``_row_*`` 헬퍼들은 파싱된 USBDBG telemetry 한 행을 검사해 "PPM 입력이
# 있나/유효한가/모드 채널이 잡혔나" 같은 참/거짓 판정을 내린다. 순수 함수이며
# ``evaluate_manual_control_rows`` 와 상태줄(status line)이 이들을 조합한다.
# These ``_row_*`` helpers inspect one parsed USBDBG row for PPM/RC presence and
# validity; pure predicates composed by ``evaluate_manual_control_rows``.


def _row_input_zero(row: dict[str, str]) -> bool:
    """이 행의 모든 RC 채널값이 사실상 0인가. / All RC channel values ~zero in this row."""
    keys = [f"raw_ch{i}_us" for i in range(1, 9)] + [
        "steer_us",
        "throttle_us",
        "mode_us",
        "raw_mode_channel_us",
    ]
    present = [key for key in keys if key in row]
    if not present:
        return False
    return all(abs(telemetry._optional_float(row.get(key)) or 0.0) <= 1e-3 for key in present)


def _row_input_nonzero(row: dict[str, str]) -> bool:
    """이 행에 0이 아닌 RC 채널이 하나라도 있나. / Any nonzero RC channel in this row."""
    keys = [f"raw_ch{i}_us" for i in range(1, 9)] + [
        "steer_us",
        "throttle_us",
        "mode_us",
        "raw_mode_channel_us",
    ]
    return any(abs(telemetry._optional_float(row.get(key)) or 0.0) > 1e-3 for key in keys)


def _row_rc_input_detected(row: dict[str, str]) -> bool:
    """이 행이 실제 RC 입력 감지를 나타내는가. / Does this row indicate real RC input?

    sync 펄스만 있거나 프레임 캡처가 없는 경우는(=채널 미해독) 감지로 치지 않는다.
    Rows that are sync-only or have no captured frame do not count as detected.
    """
    if _row_ppm_sync_only(row) or _row_no_ppm_frame_capture(row):
        return False
    return telemetry._parse_bool(row.get("rc_input_detected"), default=False) or _row_input_nonzero(row)


def _row_optional_int(row: dict[str, str], key: str) -> int | None:
    """행 값을 int 로(없으면 None). / Row value as int, or None when absent."""
    value = telemetry._optional_float(row.get(key))
    if value is None:
        return None
    return int(value)


def _row_ppm_edge_mismatch(row: dict[str, str], expected_ppm_interrupt_edge: str | None = None) -> bool:
    """관측 PPM 에지가 기대값과 다른가. / Observed PPM edge differs from expected?"""
    if not expected_ppm_interrupt_edge:
        return False
    edge = _row_value(row, ["ppm_interrupt_edge"], default="")
    return bool(edge and edge.upper() != expected_ppm_interrupt_edge.upper())


def _row_ppm_sync_only(row: dict[str, str]) -> bool:
    """sync 펄스만 있고 채널 프레임은 없는가. / Sync pulses seen but no channel frames?

    D6 에 sync 유사 펄스는 들어오는데 CH1/CH2/CH5 구간이 해독되지 않는 상태.
    보통 수신기가 결합 PPM 이 아니라 단일 PWM 을 내보내거나 디코더 프로파일이 틀린 경우.
    Usually means the receiver is not emitting combined PPM (single PWM instead),
    or the edge/sync decoder profile is wrong.
    """
    decode_reason = _row_value(row, ["ppm_decode_reason", "mode_decode_reason"], default="")
    if decode_reason == "PPM_SYNC_ONLY_NO_CHANNELS":
        return True
    sync_count = _row_optional_int(row, "ppm_sync_count")
    frame_count = _row_optional_int(row, "ppm_frame_count")
    last_channel_count = _row_optional_int(row, "ppm_last_channel_count")
    return (
        (sync_count is not None and sync_count > 0)
        and (frame_count is None or frame_count <= 0)
        and (last_channel_count is None or last_channel_count <= 0)
    )


def _row_no_ppm_frame_capture(row: dict[str, str]) -> bool:
    """PPM 카운터는 있으나 프레임/채널을 하나도 못 잡았는가. / PPM counters but no capture.

    PPM 관련 카운터 필드는 존재하지만 프레임 수·채널 수가 0이고 입력이 전부 0인 경우.
    PPM counters are present yet frame/channel counts are 0 and all inputs are zero.
    """
    frame_count = _row_optional_int(row, "ppm_frame_count")
    last_channel_count = _row_optional_int(row, "ppm_last_channel_count")
    has_ppm_counters = frame_count is not None or last_channel_count is not None
    return (
        has_ppm_counters
        and (frame_count is None or frame_count <= 0)
        and (last_channel_count is None or last_channel_count <= 0)
        and _row_input_zero(row)
    )


def _row_mode_channel_capture_known(row: dict[str, str]) -> bool:
    """모드 채널(CH5)까지 캡처됐다고 볼 수 있는가. / Was the mode channel (CH5) captured?

    채널 수가 5개 이상 잡혔으면 CH5 도 캡처된 것으로 본다(모드 채널 존재 판단 근거).
    A channel count >=5 implies CH5 was captured too (basis for "mode channel known").
    """
    if _row_input_zero(row):
        return False
    last_channel_count = _row_optional_int(row, "ppm_last_channel_count")
    frame_count = _row_optional_int(row, "ppm_frame_count")
    if last_channel_count is not None:
        return last_channel_count >= 5 and (frame_count is None or frame_count > 0)
    if frame_count is not None and frame_count <= 0:
        return False
    return _row_rc_input_detected(row)


def manual_control_mode_decode(row: dict[str, str]) -> tuple[str, str]:
    """한 telemetry 행에서 (모드 스위치, 디코드 사유)를 결정. / Decode (mode, reason).

    반환은 ``(manual_switch, mode_decode_reason)`` 튜플. 우선순위: telemetry 없음 →
    sync-only → PPM 부재 → 펌웨어가 직접 보고한 값 → mode_us(us) 로 MANUAL/AUTO 판정.
    mode_us 는 대략 <=1600us=MANUAL, >1600us=AUTO, 900~2100us 밖은 범위이탈로 본다.
    Returns ``(manual_switch, mode_decode_reason)``; falls back from firmware-reported
    values to a mode_us threshold (~<=1600us MANUAL, >1600us AUTO).
    """
    if not row:
        return "UNKNOWN_NO_USBDBG_TELEMETRY", "NO_USBDBG_TELEMETRY"
    if _row_ppm_sync_only(row):
        return "UNKNOWN_PPM_SYNC_ONLY", "PPM_SYNC_ONLY_NO_CHANNELS"
    if _row_no_ppm_frame_capture(row):
        return "UNKNOWN_PPM_ABSENT", "PPM_INPUT_ABSENT"
    row_manual_switch = _row_value(row, ["manual_switch"], default="")
    row_mode_decode_reason = _row_value(row, ["mode_decode_reason"], default="")
    if row_mode_decode_reason == "NO_MODE_CHANNEL" and not _row_mode_channel_capture_known(row):
        return "UNKNOWN_PPM_ABSENT", "PPM_INPUT_ABSENT"
    if row_manual_switch and row_mode_decode_reason:
        return row_manual_switch, row_mode_decode_reason
    if not _row_rc_input_detected(row):
        return "UNKNOWN_PPM_ABSENT", "PPM_INPUT_ABSENT"
    mode_us = telemetry._optional_float(row.get("mode_us") or row.get("raw_mode_channel_us"))
    if mode_us is None or mode_us <= 0.0:
        if not _row_mode_channel_capture_known(row):
            return "UNKNOWN_PPM_ABSENT", "PPM_INPUT_ABSENT"
        return "UNKNOWN_MODE_CHANNEL_MISSING", "NO_MODE_CHANNEL"
    if mode_us < 900.0 or mode_us > 2100.0:
        return "UNKNOWN_MODE_CHANNEL_INVALID", "MODE_CHANNEL_OUT_OF_RANGE"
    if mode_us > 1600.0:
        return "AUTO", "MODE_CHANNEL_AUTO"
    return "MANUAL", "MODE_CHANNEL_MANUAL"


def _latest_manual_control_row(rows: Sequence[dict[str, str]]) -> dict[str, str]:
    """수동제어 상태 필드를 포함한 가장 최근 행. / Latest row carrying manual-control fields.

    뒤에서부터 훑어 상태 키(모드/PPM/GPS/IMU 등)를 하나라도 가진 첫 행을 돌려준다.
    Scans from the end for the first row bearing any manual-control status key.
    """
    status_keys = {
        "manual_control",
        "manual_control_ppm",
        "rc_input_detected",
        "mode",
        "auto_sw",
        "rc_ok",
        "steer_us",
        "throttle_us",
        "mode_us",
        "raw_mode_channel_us",
        *[f"raw_ch{i}_us" for i in range(1, 9)],
        "ppm_interrupt_edge",
        "ppm_decode_reason",
        "ppm_edge_count",
        "ppm_sync_count",
        "ppm_sync_age_ms",
        "ppm_last_width_us",
        "ppm_min_width_us",
        "ppm_max_width_us",
        "ppm_frame_count",
        "ppm_last_channel_count",
        "ppm_short_rejects",
        "ppm_long_rejects",
        "ppm_last_rejected_us",
        "gps_block_reason",
        "gps_sats",
        "gps_hdop",
        "current_lat",
        "current_lon",
        "gps_cached_lat",
        "gps_cached_lon",
        "imu_present",
        "imu_relative_yaw_deg",
        "imu_heading_block_reason",
    }
    for row in reversed(rows):
        if any(key in row for key in status_keys):
            return row
    return {}


def _row_value(row: dict[str, str], keys: Sequence[str], default: str = "NA") -> str:
    """후보 키들 중 첫 번째 의미있는 값(빈/NA 제외). / First meaningful value among keys."""
    for key in keys:
        value = row.get(key)
        if value is not None and str(value).strip().upper() not in {"", "NA", "NAN", "NONE", "NULL"}:
            return str(value)
    return default


def _latest_non_na(rows: Sequence[dict[str, str]], keys: Sequence[str], default: str = "NA") -> str:
    """행들을 뒤에서부터 훑어 첫 non-NA 값. / Latest non-NA value scanning rows backwards."""
    for row in reversed(rows):
        value = _row_value(row, keys, default="")
        if value:
            return value
    return default


def format_manual_control_status(*, elapsed_s: int, rows: Sequence[dict[str, str]]) -> str:
    """모니터 중 한 줄 상태 문자열 생성. / One-line live status during manual-control monitor.

    최신 행에서 PPM/모드/모터/GPS/IMU 필드를 뽑아 ``key=value`` 나열로 만든다(부수효과 없음).
    Pulls PPM/mode/motor/GPS/IMU fields from the latest row into a ``key=value`` line.
    """
    last = _latest_manual_control_row(rows)
    manual_switch, mode_decode_reason = manual_control_mode_decode(last)
    mode_us = _row_value(last, ["mode_us", "raw_mode_channel_us"])
    current_lat = _row_value(last, ["current_lat", "gps_cached_lat", "gps_lat", "current_gps_lat"])
    current_lon = _row_value(last, ["current_lon", "gps_cached_lon", "gps_lon", "current_gps_lon"])
    fields = {
        "elapsed_s": str(elapsed_s),
        "rc_input_detected": str(_row_rc_input_detected(last)).lower() if last else "false",
        "rc_ok": last.get("rc_ok", "NA"),
        "mode": last.get("mode", "NA"),
        "auto_sw": last.get("auto_sw", "NA"),
        "manual_switch": manual_switch,
        "mode_decode_reason": mode_decode_reason,
        "ppm_interrupt_edge": last.get("ppm_interrupt_edge", "NA"),
        "ppm_decode_reason": last.get("ppm_decode_reason", "NA"),
        "ppm_edge_count": last.get("ppm_edge_count", "NA"),
        "ppm_sync_count": last.get("ppm_sync_count", "NA"),
        "ppm_sync_age_ms": last.get("ppm_sync_age_ms", "NA"),
        "ppm_last_width_us": last.get("ppm_last_width_us", "NA"),
        "ppm_min_width_us": last.get("ppm_min_width_us", "NA"),
        "ppm_max_width_us": last.get("ppm_max_width_us", "NA"),
        "ppm_frame_count": last.get("ppm_frame_count", "NA"),
        "ppm_last_channel_count": last.get("ppm_last_channel_count", "NA"),
        "ppm_short_rejects": last.get("ppm_short_rejects", "NA"),
        "ppm_long_rejects": last.get("ppm_long_rejects", "NA"),
        "ppm_last_rejected_us": last.get("ppm_last_rejected_us", "NA"),
        "steer_us": last.get("steer_us", "NA"),
        "throttle_us": last.get("throttle_us", "NA"),
        "mode_us": mode_us,
        "physical_a_cmd": last.get("physical_a_cmd", "NA"),
        "physical_b_cmd": last.get("physical_b_cmd", "NA"),
        "control_source": last.get("control_source", "NA"),
        "motor_write_called": last.get("motor_write_called", "NA"),
        "physical_output_active": last.get("physical_output_active", "NA"),
        "final_left_cmd": last.get("final_left_cmd", "NA"),
        "final_right_cmd": last.get("final_right_cmd", "NA"),
        "gps_block_reason": last.get("gps_block_reason", "NA"),
        "current_lat": current_lat,
        "current_lon": current_lon,
        "gps_sats": last.get("gps_sats", "NA"),
        "gps_hdop": last.get("gps_hdop", "NA"),
        "imu_present": last.get("imu_present", "NA"),
        "imu_relative_yaw_deg": last.get("imu_relative_yaw_deg", "NA"),
        "imu_heading_block_reason": last.get("imu_heading_block_reason", "NA"),
    }
    return " ".join(f"{key}={value}" for key, value in fields.items())


def evaluate_manual_control_rows(
    rows: Sequence[dict[str, str]],
    *,
    expected_ppm_interrupt_edge: str | None = None,
) -> dict[str, object]:
    """수동제어 세션 전체 telemetry 를 판정 요약으로 축약. / Evaluate a manual-control session.

    manual-control 모드의 핵심 순수 함수(단위 테스트 계약). 여러 행을 종합해
    통과/사유(reason)와 다음 행동을 결정한다. 통과(pass_ready)는 RC OK + MANUAL 모드 +
    RC_MANUAL 소스 + 0 아닌 최종 모터 명령 + 모터 write/출력 + 안정된 PPM 을 모두 만족할 때뿐.
    반환 dict 은 요약 파일로 그대로 쓰이므로 키를 바꾸면 하위 소비자/테스트가 깨진다.
    부수효과 없음. ``expected_ppm_interrupt_edge`` 로 에지 불일치도 사유로 승격한다.
    Core pure classifier for manual-control (a tested contract): aggregates rows
    into a pass/``reason``/next-action summary. Pass requires rc_ok + MANUAL +
    RC_MANUAL + nonzero final motor cmd + motor write/output + stable PPM. No side
    effects; the returned dict's keys are consumed downstream, so keep them stable.
    """
    rows_with_input = [
        row for row in rows
        if any(
            key in row
            for key in [f"raw_ch{i}_us" for i in range(1, 9)]
            + ["steer_us", "throttle_us", "mode_us", "raw_mode_channel_us"]
        )
    ]
    zero_rows = [row for row in rows_with_input if _row_input_zero(row)]
    rc_input_detected = any(_row_rc_input_detected(row) for row in rows)
    input_absent = bool(rows_with_input) and len(zero_rows) / max(1, len(rows_with_input)) >= 0.8 and not rc_input_detected
    rc_ok_seen = any(telemetry._parse_bool(row.get("rc_ok")) is True for row in rows)
    manual_mode_seen = any(row.get("mode") == "MANUAL" for row in rows)
    rc_manual_seen = any(row.get("control_source") == "RC_MANUAL" for row in rows)
    physical_a_nonzero = any(abs(telemetry._optional_float(row.get("physical_a_cmd")) or 0.0) > 1e-3 for row in rows)
    physical_b_nonzero = any(abs(telemetry._optional_float(row.get("physical_b_cmd")) or 0.0) > 1e-3 for row in rows)
    final_motor_nonzero = any(
        abs(telemetry._optional_float(row.get("final_left_cmd")) or 0.0) > 1e-3
        or abs(telemetry._optional_float(row.get("final_right_cmd")) or 0.0) > 1e-3
        for row in rows
    )
    motor_write_seen = any(telemetry._parse_bool(row.get("motor_write_called")) is True for row in rows)
    physical_output_seen = any(telemetry.physical_output_active(row) for row in rows)
    rc_status_rows = [
        row for row in rows
        if telemetry._parse_bool(row.get("rc_ok")) is not None
    ]
    rc_ok_rows = sum(1 for row in rc_status_rows if telemetry._parse_bool(row.get("rc_ok")) is True)
    rc_bad_rows = sum(1 for row in rc_status_rows if telemetry._parse_bool(row.get("rc_ok")) is False)
    rc_ok_ratio = (rc_ok_rows / len(rc_status_rows)) if rc_status_rows else 0.0
    ppm_signal_stable = not rc_status_rows or len(rc_status_rows) < 3 or rc_ok_ratio >= 0.6
    ppm_edge_mismatch_seen = any(_row_ppm_edge_mismatch(row, expected_ppm_interrupt_edge) for row in rows)
    ppm_sync_only_seen = any(_row_ppm_sync_only(row) for row in rows)
    no_ppm_frame_capture_seen = any(_row_no_ppm_frame_capture(row) for row in rows)
    pass_ready = (
        rc_ok_seen
        and manual_mode_seen
        and rc_manual_seen
        and final_motor_nonzero
        and (motor_write_seen or physical_output_seen)
        and ppm_signal_stable
    )
    last = _latest_manual_control_row(rows)
    manual_switch, mode_decode_reason = manual_control_mode_decode(last)
    ppm_decode_reason_latest = _latest_non_na(rows, ["ppm_decode_reason"])
    ppm_invalid_decode_seen = any(
        str(row.get("ppm_decode_reason", "")).startswith("PPM_")
        and row.get("ppm_decode_reason") not in {"OK", "PPM_FRAME_STALE"}
        for row in rows
    )
    gps_status_available = _latest_non_na(
        rows,
        ["gps_block_reason", "gps_sats", "gps_hdop", "current_lat", "current_lon", "gps_cached_lat", "gps_cached_lon"],
    ) != "NA"
    imu_status_available = _latest_non_na(
        rows,
        ["imu_present", "imu_relative_yaw_deg", "imu_heading_block_reason"],
    ) != "NA"
    if ppm_edge_mismatch_seen:
        manual_switch = "UNKNOWN_PPM_EDGE_MISMATCH"
        mode_decode_reason = "PPM_EDGE_MISMATCH"
    if pass_ready:
        reason = "MANUAL_CONTROL_PASS"
    elif not rows or not last:
        reason = "NO_USBDBG_TELEMETRY"
    elif ppm_edge_mismatch_seen:
        reason = "PPM_EDGE_MISMATCH"
    elif ppm_sync_only_seen:
        reason = "PPM_SYNC_ONLY_NO_CHANNELS"
    elif rc_ok_seen and not ppm_signal_stable:
        reason = "PPM_CHANNELS_PRESENT_BUT_INVALID"
    elif ppm_invalid_decode_seen and not rc_ok_seen:
        reason = "PPM_CHANNELS_PRESENT_BUT_INVALID"
    elif input_absent or no_ppm_frame_capture_seen:
        reason = "PPM_INPUT_ABSENT"
    elif mode_decode_reason == "NO_MODE_CHANNEL" and _row_mode_channel_capture_known(last):
        reason = "MODE_CHANNEL_MISSING"
    elif rc_input_detected and not rc_ok_seen:
        reason = "PPM_CHANNELS_PRESENT_BUT_INVALID"
    elif rc_ok_seen and not manual_mode_seen:
        reason = "MANUAL_CONTROL_READY"
    elif (physical_a_nonzero or physical_b_nonzero) and not final_motor_nonzero:
        reason = "MOTOR_OUTPUT_BLOCKED"
    else:
        reason = "MANUAL_CONTROL_READY"
    expected_edge_label = expected_ppm_interrupt_edge or "the selected profile"
    next_action = {
        "MANUAL_CONTROL_PASS": "PPM manual control is verified.",
        "MANUAL_CONTROL_READY": "PPM telemetry is present; set CH5 to MANUAL and move the sticks to verify output.",
        "PPM_INPUT_ABSENT": PPM_INPUT_ABSENT_ACTION,
        "PPM_SYNC_ONLY_NO_CHANNELS": "D6 is seeing sync-like pulses but no CH1/CH2/CH5 PPM channel intervals. This usually means the receiver is not outputting combined PPM on D6, the signal wire is on a single PWM output, or the edge/sync decoder profile is wrong. Rebuild with --profile rc-mix-ppm; if this reason remains, check receiver output mode/wiring.",
        "PPM_CHANNELS_PRESENT_BUT_INVALID": "PPM is present but unstable or invalid; charge/check the station controller battery, receiver power, D6 signal wire, shared ground, channel order, and pulse widths.",
        "PPM_EDGE_MISMATCH": f"Firmware PPM edge does not match the selected profile; expected {expected_edge_label}. Rebuild/upload manual-control with the intended --profile.",
        "MODE_CHANNEL_MISSING": "PPM steering/throttle are present but CH5 mode is missing; verify the receiver mode channel.",
        "MOTOR_OUTPUT_BLOCKED": "Manual A/B commands changed, but final motor output stayed zero; inspect manual control priority and motor gating.",
        "NO_USBDBG_TELEMETRY": "No USBDBG rows were parsed; check USB serial, firmware mode, baud rate, and --verbose-raw output.",
    }.get(reason, "Move the physical station/controller during the monitor window and inspect summary telemetry.")
    return {
        "mode": "manual-control",
        "success": pass_ready,
        "manual_control_ok": pass_ready,
        "reason": reason,
        "manual_switch": manual_switch,
        "mode_decode_reason": mode_decode_reason,
        "ppm_decode_reason_latest": ppm_decode_reason_latest,
        "ppm_interrupt_edge_latest": _latest_non_na(rows, ["ppm_interrupt_edge"]),
        "expected_ppm_interrupt_edge": expected_ppm_interrupt_edge or "profile-dependent",
        "ppm_edge_mismatch_seen": ppm_edge_mismatch_seen,
        "ppm_sync_only_seen": ppm_sync_only_seen,
        "ppm_edge_count_latest": _latest_non_na(rows, ["ppm_edge_count"]),
        "ppm_sync_count_latest": _latest_non_na(rows, ["ppm_sync_count"]),
        "ppm_last_width_us_latest": _latest_non_na(rows, ["ppm_last_width_us"]),
        "ppm_min_width_us_latest": _latest_non_na(rows, ["ppm_min_width_us"]),
        "ppm_max_width_us_latest": _latest_non_na(rows, ["ppm_max_width_us"]),
        "mode_us_latest": _latest_non_na(rows, ["mode_us", "raw_mode_channel_us"]),
        "rc_input_detected": rc_input_detected,
        "rc_ok_rows": rc_ok_rows,
        "rc_bad_rows": rc_bad_rows,
        "rc_ok_ratio": round(rc_ok_ratio, 3),
        "ppm_signal_stable": ppm_signal_stable,
        "ppm_input_pin": "D6",
        "steer_channel": "CH1",
        "throttle_channel": "CH2",
        "mode_channel": "CH5",
        "rc_ok_seen": rc_ok_seen,
        "gps_status_available": gps_status_available,
        "imu_status_available": imu_status_available,
        "last_current_lat": _latest_non_na(rows, ["current_lat", "gps_cached_lat", "gps_lat", "current_gps_lat"]),
        "last_current_lon": _latest_non_na(rows, ["current_lon", "gps_cached_lon", "gps_lon", "current_gps_lon"]),
        "last_imu_yaw": _latest_non_na(rows, ["imu_relative_yaw_deg"]),
        "manual_mode_seen": manual_mode_seen,
        "control_source_rc_manual_seen": rc_manual_seen,
        "physical_a_nonzero_seen": physical_a_nonzero,
        "physical_b_nonzero_seen": physical_b_nonzero,
        "final_motor_nonzero_seen": final_motor_nonzero,
        "motor_write_called_seen": motor_write_seen,
        "physical_output_active_seen": physical_output_seen,
        "gps_required": False,
        "imu_required": False,
        "path_package_required": False,
        "station_frame_parser_required": False,
        "hc12_required": False,
        "physical_a_role": "throttle",
        "physical_b_role": "turn",
        "wheel_to_physical_mapping": "physical_ab_manual_equivalent",
        "next_recommended_action": next_action,
        "ready_for_full_path_following": False,
    }


def evaluate_rc_input_diagnose_rows(rows: Sequence[dict[str, str]]) -> dict[str, object]:
    """읽기전용 PPM 프로브 telemetry 를 분류. / Classify read-only PPM probe telemetry.

    rc-input-diagnose 모드의 순수 판정 함수. 프레임 수/무효 프레임/0 아닌 채널을 세어
    RC 입력이 없음/있으나 무효/유효 중 무엇인지 사유(reason)로 반환한다(부수효과 없음).
    Pure classifier for rc-input-diagnose: counts frames/invalid/nonzero channels
    to report RC input absent / present-but-invalid / present-and-valid.
    """
    frame_counts = [int(float(row.get("frames", "0") or 0)) for row in rows if "frames" in row]
    invalid_counts = [int(float(row.get("invalid_frames", "0") or 0)) for row in rows if "invalid_frames" in row]
    total_frames = sum(frame_counts)
    total_invalid = sum(invalid_counts)
    ppm_header_seen = any("ppm_pin" in row or "channel_count" in row for row in rows)
    event_frames = [
        row for row in rows
        if any(f"ch{i}_us" in row for i in range(1, 9))
    ]
    nonzero_channels = [
        (key, value)
        for row in rows
        for key, value in row.items()
        if key.startswith("ch") and key.endswith("_us")
        if telemetry._optional_float(value) is not None and abs(float(value)) > 1e-3
    ]
    any_ppm_signal = total_frames > 0 or bool(nonzero_channels)
    valid_ppm_signal = any_ppm_signal and total_invalid < max(1, total_frames)
    if not rows:
        reason = "SERIAL_ERROR"
    elif not any_ppm_signal:
        reason = "RC_INPUT_ABSENT"
    elif not valid_ppm_signal:
        reason = "RC_CHANNELS_PRESENT_BUT_INVALID"
    else:
        reason = "RC_CHANNELS_PRESENT_AND_VALID"
    signal_class = "RC_INPUT_PRESENT_PPM" if any_ppm_signal else "RC_INPUT_ABSENT"
    next_action = {
        "SERIAL_ERROR": "Check USB serial connection and rerun rc-input-diagnose.",
        "RC_INPUT_ABSENT": RC_INPUT_ABSENT_ACTION,
        "RC_CHANNELS_PRESENT_BUT_INVALID": (
            "PPM frames were seen but invalid or incomplete; check receiver output mode, "
            "signal wiring, and whether the receiver is configured for PPM on the OpenRB input pin."
        ),
        "RC_CHANNELS_PRESENT_AND_VALID": (
            "RC input frames are present. Run manual-rc and verify MANUAL mode stick passthrough."
        ),
    }.get(reason, "Inspect RC input telemetry.")
    return {
        "mode": "rc-input-diagnose",
        "success": reason == "RC_CHANNELS_PRESENT_AND_VALID",
        "reason": reason,
        "rc_input_classification": reason,
        "rc_input_signal_class": signal_class,
        "rc_input_detected": any_ppm_signal,
        "rc_input_present_ppm": any_ppm_signal,
        "rc_input_present_pwm": False,
        "rc_input_present_sbus": False,
        "ppm_header_seen": ppm_header_seen,
        "ppm_event_row_count": len(event_frames),
        "ppm_total_frames": total_frames,
        "ppm_invalid_frames": total_invalid,
        "raw_channel_nonzero_seen": bool(nonzero_channels),
        "next_recommended_action": next_action,
        "ready_for_full_path_following": False,
    }


# ── 물리 스테이션 하드웨어 telemetry 평가 / Station-hardware telemetry evaluation ──
# station-hw-diagnose / station-hw-manual 이 공유하는 순수 판정 헬퍼. 스테이션
# 시리얼 프레임의 도착·파싱·deadman/estop·모터출력 여부로 링크/제어 상태를 사유화한다.
# Pure helpers shared by station-hw-{diagnose,manual}: reason about link/parse/
# deadman/estop/motor-output from the station serial frames.


def _station_value_present(value: object) -> bool:
    """값이 의미있게 존재하는가(빈/NA 아님). / Value present and not blank/NA."""
    text = str(value or "").strip().upper()
    return text not in {"", "NA", "NAN", "NONE", "NULL"}


def _station_hw_link_row(row: dict[str, str]) -> bool:
    """이 행이 스테이션 링크 프레임 수신을 보이는가. / Row shows a received station frame?"""
    if telemetry._parse_bool(row.get("station_link_seen")) is True:
        return True
    if _station_value_present(row.get("station_seq")) or _station_value_present(row.get("station_age_ms")):
        return True
    rx_count = telemetry._optional_float(row.get("station_rx_count"))
    if rx_count is None:
        rx_count = telemetry._optional_float(row.get("hc12_rx_count"))
    return rx_count is not None and rx_count > 0


def _station_hw_float_seen(rows: Sequence[dict[str, str]], *keys: str) -> bool:
    """주어진 키 중 어느 것이든 0 아닌 float 이 관측됐나. / Any nonzero float across keys?"""
    for row in rows:
        for key in keys:
            value = telemetry._optional_float(row.get(key))
            if value is not None and abs(value) > 1e-6:
                return True
    return False


def _station_last_present(last: dict[str, str], key: str, default: object = "NA") -> object:
    """최신 행의 값(없으면 default). / Value from the last row, else default."""
    value = last.get(key)
    return value if _station_value_present(value) else default


def evaluate_station_hw_rows(rows: Sequence[dict[str, str]], *, mode: str) -> dict[str, object]:
    """스테이션 HW telemetry 전체를 판정 요약으로 축약. / Evaluate station-hardware rows.

    station-hw-diagnose/manual 의 핵심 순수 함수. 우선순위대로 사유를 정한다: 링크 부재
    → estop → 프레임은 오나 파싱 실패(파서 불일치) → deadman 미활성 → 모터출력=PASS →
    A/B 명령만 → 유효. ``mode`` 에 따라 diagnose 는 "유효만 봐도 성공", manual 은 모터
    출력까지 요구한다. 반환은 ``assert_not_ready_for_full_path_following`` 로 봉인된 dict.
    부수효과 없음.
    Core pure classifier for station-hw modes; priority: link-absent -> estop ->
    frames-but-parser-mismatch -> deadman-inactive -> motor-output=PASS -> A/B-only
    -> valid. ``mode`` decides whether valid-only counts as success (diagnose) or
    motor output is required (manual). Returns a not-ready-sealed dict; no side effects.
    """
    link_rows = [row for row in rows if _station_hw_link_row(row)]
    manual_valid_rows = [row for row in rows if telemetry._parse_bool(row.get("station_manual_valid")) is True]
    deadman_rows = [row for row in rows if telemetry._parse_bool(row.get("station_deadman")) is True]
    estop_rows = [row for row in rows if telemetry._parse_bool(row.get("station_estop")) is True]
    motor_rows = [
        row for row in rows
        if telemetry._parse_bool(row.get("motor_write_called")) is True
        or telemetry.physical_output_active(row)
        or abs(telemetry._optional_float(row.get("final_left_cmd")) or 0.0) > 1e-6
        or abs(telemetry._optional_float(row.get("final_right_cmd")) or 0.0) > 1e-6
    ]
    parsed_ok_rows = sum(
        1 for row in rows
        if telemetry._parse_bool(row.get("station_parse_ok")) is True
        or telemetry._parse_bool(row.get("station_manual_valid")) is True
    )
    parsed_error_rows = sum(
        1 for row in rows
        if telemetry._parse_bool(row.get("station_parse_error")) is True
    )
    last = link_rows[-1] if link_rows else (rows[-1] if rows else {})
    parse_ok_count = max(
        parsed_ok_rows,
        int(telemetry._optional_float(last.get("station_parse_ok_count")) or 0),
    )
    parse_error_count = max(
        parsed_error_rows,
        int(telemetry._optional_float(last.get("station_parse_error_count")) or 0),
    )
    station_frame_count = max(
        len(link_rows),
        int(telemetry._optional_float(last.get("station_frame_count")) or 0),
        int(telemetry._optional_float(last.get("station_rx_count")) or 0),
        int(telemetry._optional_float(last.get("hc12_rx_count")) or 0),
    )
    station_link_seen = station_frame_count > 0
    station_physical_a_nonzero_seen = _station_hw_float_seen(
        rows, "station_physical_a_cmd", "station_a_cmd", "station_forward_cmd"
    )
    station_physical_b_nonzero_seen = _station_hw_float_seen(
        rows, "station_physical_b_cmd", "station_b_cmd", "station_turn_cmd"
    )
    if not station_link_seen:
        reason = "STATION_HW_LINK_ABSENT"
        success = False
        next_action = (
            "Check station hardware power, station transport wiring, station baud/settings, "
            "and whether the rover firmware has station hardware manual mode enabled."
        )
    elif estop_rows:
        reason = "STATION_HW_ESTOP_ACTIVE"
        success = False
        next_action = "Release station hardware emergency stop and rerun station-hw-diagnose."
    elif link_rows and not manual_valid_rows:
        reason = "WRONG_STATION_FRAME_PARSER"
        success = False
        next_action = (
            "Station bytes are arriving but no station manual frame parsed. Inspect "
            "raw_station_frames.txt and raw_station_frames_hex.txt, then compare the "
            "physical station output against the rover station parser."
        )
    elif not deadman_rows:
        reason = "STATION_HW_DEADMAN_NOT_ACTIVE"
        success = False
        next_action = "Hold the station hardware deadman control while moving the station input."
    elif motor_rows:
        reason = "STATION_HW_MANUAL_PASS"
        success = True
        next_action = "Station hardware manual control is passing; continue only with bounded supervised tests."
    elif station_physical_a_nonzero_seen or station_physical_b_nonzero_seen:
        if mode == "station-hw-manual":
            reason = "STATION_HW_MANUAL_OUTPUT_BLOCKED"
            success = False
            next_action = (
                "Station hardware A/B commands changed but rover motor output did not respond; "
                "compare against usb-pulse-test, then inspect station manual control-source gating."
            )
        else:
            reason = "STATION_HW_MANUAL_READY"
            success = True
            next_action = "Station hardware commands are valid. Run station-hw-manual to verify motor output if needed."
    else:
        reason = "STATION_HW_MANUAL_VALID"
        success = mode == "station-hw-diagnose"
        next_action = "Station frames are valid. Move the station hardware input while holding deadman to verify A/B commands."
    return checks.assert_not_ready_for_full_path_following({
        "mode": mode,
        "success": success,
        "reason": reason,
        "station_hw_result": reason,
        "station_link_seen": station_link_seen,
        "station_frame_count": station_frame_count,
        "station_parse_ok_count": parse_ok_count,
        "station_parse_error_count": parse_error_count,
        "station_transport": _station_last_present(last, "station_transport", "station_hardware_serial"),
        "station_protocol": _station_last_present(last, "station_protocol", "auto"),
        "station_parser": _station_last_present(last, "station_parser", "auto_station_manual"),
        "station_last_frame_age_ms": last.get("station_age_ms", "NA"),
        "station_seq": last.get("station_seq", "NA"),
        "station_manual_valid": bool(manual_valid_rows),
        "station_manual_valid_seen": bool(manual_valid_rows),
        "station_deadman": bool(deadman_rows),
        "station_deadman_seen": bool(deadman_rows),
        "station_estop": bool(estop_rows),
        "station_estop_seen": bool(estop_rows),
        "station_a_cmd": last.get("station_a_cmd", last.get("station_physical_a_cmd", "NA")),
        "station_b_cmd": last.get("station_b_cmd", last.get("station_physical_b_cmd", "NA")),
        "station_forward_cmd": last.get("station_forward_cmd", "NA"),
        "station_turn_cmd": last.get("station_turn_cmd", "NA"),
        "station_physical_a_cmd": last.get("station_physical_a_cmd", "NA"),
        "station_physical_b_cmd": last.get("station_physical_b_cmd", "NA"),
        "station_physical_a_nonzero_seen": station_physical_a_nonzero_seen,
        "station_physical_b_nonzero_seen": station_physical_b_nonzero_seen,
        "active_control_source_candidate": "STATION_HW_MANUAL" if bool(manual_valid_rows) else "STOP",
        "station_rx_count": last.get("station_rx_count", last.get("hc12_rx_count", station_frame_count)),
        "motor_write_called_seen": any(telemetry._parse_bool(row.get("motor_write_called")) is True for row in rows),
        "physical_output_active_seen": any(telemetry.physical_output_active(row) for row in rows),
        "final_motor_nonzero_seen": any(
            abs(telemetry._optional_float(row.get("final_left_cmd")) or 0.0) > 1e-6
            or abs(telemetry._optional_float(row.get("final_right_cmd")) or 0.0) > 1e-6
            for row in rows
        ),
        "rc_input_required": False,
        "gps_required": False,
        "imu_required": False,
        "physical_a_role": "throttle",
        "physical_b_role": "turn",
        "wheel_to_physical_mapping": "physical_ab_manual_equivalent",
        "next_recommended_action": next_action,
        "ready_for_full_path_following": False,
    })


def _station_hw_status_line(summary: dict[str, object], *, elapsed_s: float) -> str:
    """스테이션 HW 요약을 한 줄 상태 문자열로. / Station-hw summary to a one-line status."""
    return (
        f"elapsed_s={elapsed_s:.0f} "
        f"station_link_seen={str(summary.get('station_link_seen', False)).lower()} "
        f"station_frame_count={summary.get('station_frame_count', 0)} "
        f"station_parse_ok_count={summary.get('station_parse_ok_count', 0)} "
        f"station_parse_error_count={summary.get('station_parse_error_count', 0)} "
        f"station_deadman={str(summary.get('station_deadman', False)).lower()} "
        f"station_estop={str(summary.get('station_estop', False)).lower()} "
        f"station_manual_valid={str(summary.get('station_manual_valid', False)).lower()} "
        f"station_physical_a_cmd={summary.get('station_physical_a_cmd', 'NA')} "
        f"station_physical_b_cmd={summary.get('station_physical_b_cmd', 'NA')} "
        f"station_rx_count={summary.get('station_rx_count', 'NA')} "
        f"station_transport={summary.get('station_transport', 'NA')} "
        f"station_parser={summary.get('station_parser', 'NA')} "
        f"motor_write_called={str(summary.get('motor_write_called_seen', False)).lower()} "
        f"physical_output_active={str(summary.get('physical_output_active_seen', False)).lower()} "
        f"reason_so_far={summary.get('reason', 'NA')}"
    )


def station_hw_status_line(rows: Sequence[dict[str, str]], *, mode: str, elapsed_s: float) -> str:
    """행들을 평가해 한 줄 상태로(공개 래퍼). / Evaluate rows into a status line (public)."""
    return _station_hw_status_line(evaluate_station_hw_rows(rows, mode=mode), elapsed_s=elapsed_s)


def _station_raw_frame_dumps(rows: Sequence[dict[str, str]]) -> list[tuple[str, str]]:
    """중복 제거된 원시 스테이션 프레임 (텍스트, hex) 최대 20개. / Dedup raw station frames.

    파서가 맞지 않을 때 실제 바이트를 눈으로 비교하도록 원시/16진 프레임을 수집한다.
    Collects raw + hex frames so a parser mismatch can be inspected byte-for-byte.
    """
    dumps: list[tuple[str, str]] = []
    seen: set[tuple[str, str]] = set()
    for row in rows:
        raw_text = row.get("station_raw_frame")
        raw_hex = row.get("station_raw_frame_hex")
        if not _station_value_present(raw_text) and not _station_value_present(raw_hex):
            continue
        decoded = unquote(str(raw_text or ""))
        hex_text = str(raw_hex or "")
        key = (decoded, hex_text)
        if key in seen:
            continue
        seen.add(key)
        dumps.append(key)
        if len(dumps) >= 20:
            break
    return dumps


def write_station_raw_frame_dumps(out_dir: Path, rows: Sequence[dict[str, str]]) -> int:
    """원시 스테이션 프레임을 파일로 기록하고 개수 반환. / Write raw station frame dumps.

    부수효과: ``raw_station_frames.txt`` / ``raw_station_frames_hex.txt`` 생성.
    Side effect: writes the two raw-frame files under ``out_dir``.
    """
    dumps = _station_raw_frame_dumps(rows)
    if not dumps:
        return 0
    (out_dir / "raw_station_frames.txt").write_text(
        "\n".join(raw for raw, _ in dumps) + "\n",
        encoding="utf-8",
    )
    (out_dir / "raw_station_frames_hex.txt").write_text(
        "\n".join(raw_hex for _, raw_hex in dumps) + "\n",
        encoding="utf-8",
    )
    return len(dumps)


# ── 시리얼 포트 해석·요약 파일 쓰기 / Serial-port resolution + summary writers ──


def arduino_cli_openrb_port() -> str | None:
    """arduino-cli board list 에서 OpenRB-150 포트를 찾는다. / Find OpenRB-150 port.

    부수효과: ``arduino-cli board list`` 서브프로세스 실행. 실패/미검출 시 None.
    Side effect: runs the ``arduino-cli board list`` subprocess; None on failure.
    """
    try:
        completed = subprocess.run(
            ["arduino-cli", "board", "list"],
            check=False,
            capture_output=True,
            text=True,
            timeout=5,
        )
    except (OSError, subprocess.SubprocessError):
        return None
    for line in completed.stdout.splitlines():
        if "OpenRB-150" in line:
            parts = line.split()
            return parts[0] if parts else None
    return None


def detected_serial_ports() -> list[str]:
    """/dev 에서 USB 시리얼 후보 포트를 나열(mac/Linux 패턴). / List USB serial ports."""
    parent = Path("/dev")
    if not parent.exists():
        return []
    patterns = (
        "cu.usbmodem*",
        "tty.usbmodem*",
        "ttyACM*",
        "ttyUSB*",
        "cu.usbserial*",
        "tty.usbserial*",
    )
    ports: list[str] = []
    for pattern in patterns:
        ports.extend(str(path) for path in parent.glob(pattern))
    return sorted(set(ports))


def resolve_port(
    explicit_port: str | None,
    *,
    env: dict[str, str] | None = None,
    system_name: str | None = None,
) -> dict[str, object]:
    """포트 결정 우선순위: 명시 > $PORT > arduino-cli > Linux 기본. / Resolve serial port.

    ``{"port", "source"}`` 를 반환하며 ``source`` 로 어디서 정해졌는지 알려준다.
    ``env``/``system_name`` 인자는 테스트 주입용. Returns ``{"port", "source"}``.
    """
    env = os.environ if env is None else env
    system_name = platform.system() if system_name is None else system_name
    if explicit_port:
        return {"port": explicit_port, "source": "explicit"}
    env_port = env.get("PORT", "")
    if env_port:
        return {"port": env_port, "source": "env"}
    detected = arduino_cli_openrb_port()
    if detected:
        return {"port": detected, "source": "arduino_cli"}
    if system_name == "Linux" and Path(DEFAULT_PORT).exists():
        return {"port": DEFAULT_PORT, "source": "linux_default"}
    return {"port": None, "source": "none"}


def write_summary_files(out_dir: str | Path, summary: dict[str, object], *, title: str) -> dict[str, object]:
    """summary.json + summary.md 를 쓰고 정규화된 dict 반환. / Write summary.json + .md.

    거의 모든 모드가 결과를 남기는 공통 라이터. ``ready_for_full_path_following`` 를
    강제로 False 로 봉인하고(안전 불변식) ``success`` 기본값을 채운 뒤 두 파일을 만든다.
    부수효과: ``out_dir`` 생성 및 두 파일 기록.
    Shared writer; forces the not-ready invariant, defaults ``success``, then
    writes both files. Side effect: creates ``out_dir`` and the two files.
    """
    path = Path(out_dir)
    path.mkdir(parents=True, exist_ok=True)
    normalized = dict(summary)
    normalized.setdefault("success", normalized.get("reason") == "OK")
    normalized["ready_for_full_path_following"] = False
    normalized = checks.assert_not_ready_for_full_path_following(normalized)
    _write_json(path / "summary.json", normalized)
    lines = [f"# {title}", ""]
    lines.extend(f"- {key}: `{value}`" for key, value in normalized.items())
    (path / "summary.md").write_text("\n".join(lines) + "\n", encoding="utf-8")
    return normalized


def write_failure_summary(
    out_dir: str | Path | None,
    *,
    reason: str,
    attempted_port: str | None = None,
    mode: str | None = None,
    next_recommended_action: str = "Check the requested serial port or connect OpenRB-150 and retry.",
) -> None:
    """포트 없음 등 초기 실패 요약을 기록. / Write an early-failure summary (e.g. no port).

    ``out_dir`` 가 None 이면 아무 것도 하지 않는다. Side effect: writes summary files.
    """
    if out_dir is None:
        return
    path = Path(out_dir)
    path.mkdir(parents=True, exist_ok=True)
    payload = {
        "mode": mode or "unknown",
        "reason": reason,
        "success": False,
        "attempted_port": attempted_port,
        "detected_ports": detected_serial_ports(),
        "next_recommended_action": next_recommended_action,
        "ready_for_full_path_following": False,
    }
    write_summary_files(path, payload, title="Physical Path Planner")


def ensure_port(args: argparse.Namespace) -> bool:
    """포트를 해석해 ``args.port`` 에 채우고 존재 여부 검증. / Resolve+validate the port.

    성공 시 True 를 돌려주며 ``args.port``/``args.port_source`` 를 설정한다. ``--from-log``
    은 하드웨어가 필요 없으므로 즉시 True. 실패 시 실패 요약을 쓰고 사유를 출력한 뒤 False.
    거의 모든 하드웨어 핸들러의 첫 관문(게이트)이다.
    Returns True (setting ``args.port``/``port_source``); ``--from-log`` short-circuits
    True. On failure writes a failure summary and returns False. Side effects: sets
    args fields, may write summary + print.
    """
    if getattr(args, "from_log", None):
        return True
    resolved = resolve_port(getattr(args, "port", None))
    args.port = resolved["port"]
    args.port_source = resolved["source"]
    if args.port is None or not Path(str(args.port)).exists():
        write_failure_summary(
            getattr(args, "out_dir", None),
            reason="SERIAL_PORT_NOT_FOUND",
            attempted_port=None if args.port is None else str(args.port),
            mode=getattr(args, "mode", None),
        )
        print(f"reason=SERIAL_PORT_NOT_FOUND attempted_port={args.port} detected_ports={detected_serial_ports()}")
        print("ready_for_full_path_following=false")
        return False
    print(f"resolved_port={args.port}")
    print(f"port_source={args.port_source}")
    return True


def printable_port(explicit_port: str | None) -> str:
    """--print-cmd 표시에 쓸 포트 문자열(미해석 시 ``$PORT``). / Printable port for --print-cmd.

    실제 시리얼을 열지 않고 명령을 출력만 할 때 사용. 결정 못 하면 ``$PORT`` 리터럴.
    Used when printing commands without opening serial; falls back to the ``$PORT`` literal.
    """
    if explicit_port:
        return explicit_port
    resolved = resolve_port(None)
    return str(resolved["port"] or "$PORT")


def build_calibrate_turn_argv(
    *,
    script: str,
    port: str,
    mode: str,
    target_angle_deg: float,
    angle_tolerance_deg: float,
    save_turn_calibration: str,
    turn_calibration_out: str,
    out_dir: str,
    b_cmd: float | None = None,
    pulse_ms: int | None = None,
    max_abs_b: float = 0.35,
    max_ms: int = 1500,
) -> list[str]:
    """Build the argv that shells out to guarded pulse calibration.

    Always passes ``--imu-angle-compare true`` -- that is what makes the launcher
    append ``-DIMU_ENABLE=1 -DIMU_YAW_DIAG=1`` and measure before/after yaw.
    """
    argv = [
        "bash",
        str(script),
        "--port",
        str(port),
        "--mode",
        str(mode),
        "--max-abs-b",
        str(max_abs_b),
        "--max-ms",
        str(max_ms),
        "--imu-angle-compare",
        "true",
        "--target-angle-deg",
        str(target_angle_deg),
        "--angle-tolerance-deg",
        str(angle_tolerance_deg),
        "--save-turn-calibration",
        str(save_turn_calibration),
        "--turn-calibration-out",
        str(turn_calibration_out),
        "--out-dir",
        str(out_dir),
    ]
    if b_cmd is not None:
        argv.extend(["--cmd-list", str(abs(b_cmd))])
    if pulse_ms is not None:
        argv.extend(["--pulse-ms-list", str(pulse_ms)])
    return argv


def resolve_calibration(args: argparse.Namespace) -> dict[str, object]:
    """Resolve calibration honoring real on-disk files, with explicit overrides.

    Unspecified ``--*-calibration-json`` flags fall back to the resolver's default
    on-disk paths (so genuine calibration is used when present); a missing file
    degrades to the repeated-pulses fallback and never raises.
    """
    kwargs: dict[str, object] = {"calibration_mode": args.calibration_mode}
    for flag, key in (
        ("motion_calibration_json", "motion_calibration_json"),
        ("fine_calibration_json", "fine_calibration_json"),
        ("turn_calibration_json", "turn_calibration_json"),
        ("turn_angle_calibration_json", "turn_angle_calibration_json"),
        ("smooth_turn_calibration_json", "smooth_turn_calibration_json"),
    ):
        value = getattr(args, flag)
        if value is not None:
            kwargs[key] = Path(value)
    return calibration.resolve_physical_calibration(**kwargs)


def motion_calibration_loaded(calibration_dict: dict[str, object]) -> bool:
    """승인된 모션 보정 파일이 실제 디스크에 있나. / Is an approved motion calibration on disk?"""
    files = calibration_dict.get("calibration_files")
    if not isinstance(files, dict):
        return False
    motion_path = files.get("motion")
    return bool(motion_path and Path(str(motion_path)).exists())


# ── GPS 시작좌표 스냅샷/캐시 해석 / GPS start-coordinate snapshot + cache resolution ──
# preview/run/auto-relative 가 공유. 라이브 telemetry 행에서 사용 가능한 시작 위경도를
# 뽑거나(gps_snapshot/resolve_start_*), 최근 캐시(load_cached_start)로 대체한다.
# Shared by preview/run/auto-relative: derive a usable start lat/lon from live
# telemetry, or fall back to a recent on-disk cache.


def _lat_lon_from_row(row: dict[str, str], lat_keys: Sequence[str], lon_keys: Sequence[str]) -> tuple[float | None, float | None]:
    """후보 키들에서 (lat, lon) 을 추출. / Extract (lat, lon) from candidate keys."""
    lat = None
    lon = None
    for key in lat_keys:
        lat = telemetry._optional_float(row.get(key))
        if lat is not None:
            break
    for key in lon_keys:
        lon = telemetry._optional_float(row.get(key))
        if lon is not None:
            break
    return lat, lon


def _fresh_cached_gps(row: dict[str, str], max_age_ms: int) -> bool:
    """행의 캐시 GPS 가 충분히 최신인가. / Is this row's cached GPS fresh enough?"""
    age = telemetry._optional_float(row.get("gps_cached_age_ms", row.get("gps_age_ms")))
    if age is not None:
        return age <= max_age_ms
    return telemetry._parse_bool(row.get("gps_location_fresh"), default=False)


def gps_snapshot(rows: Sequence[dict[str, str]], *, min_sats: float = 5.0, max_hdop: float = 2.5) -> dict[str, object]:
    """파싱된 telemetry 에서 GPS 콜드스타트 상태를 요약. / Summarize cold-start GPS state.

    최적 위성수/HDOP/좌표와 "준비된 행"(min_sats/max_hdop 충족 + fix 유효)을 찾아 dict 로
    반환한다(순수 함수, 부수효과 없음). ``ready_row`` 는 시작좌표 확정에 쓰인다.
    Pure: finds best sats/hdop/coords plus a ``ready_row`` (meets thresholds and a
    valid fix), used to lock the plan start. No side effects.
    """
    best_sats: float | None = None
    best_hdop: float | None = None
    best_lat: float | None = None
    best_lon: float | None = None
    best_ready_row: dict[str, str] | None = None
    last = rows[-1] if rows else {}
    for row in rows:
        sats = telemetry._optional_float(row.get("gps_sats"))
        hdop = telemetry._optional_float(row.get("gps_hdop"))
        lat, lon = _lat_lon_from_row(
            row,
            ("current_lat", "gps_lat", "current_gps_lat"),
            ("current_lon", "gps_lon", "current_gps_lon"),
        )
        if sats is not None and (best_sats is None or sats > best_sats):
            best_sats = sats
        if hdop is not None and (best_hdop is None or hdop < best_hdop):
            best_hdop = hdop
        if lat is not None and lon is not None:
            best_lat = lat
            best_lon = lon
            if (
                (sats is None or sats >= min_sats)
                and (hdop is None or hdop <= max_hdop)
                and (
                    telemetry._parse_bool(row.get("gps_ready"))
                    or telemetry._parse_bool(row.get("gps_solution_valid"))
                    or str(row.get("gps_block_reason", "")).upper() == "OK"
                )
            ):
                best_ready_row = row
    current_lat, current_lon = _lat_lon_from_row(
        last,
        ("current_lat", "gps_lat", "current_gps_lat"),
        ("current_lon", "gps_lon", "current_gps_lon"),
    )
    sats = telemetry._optional_float(last.get("gps_sats"))
    hdop = telemetry._optional_float(last.get("gps_hdop"))
    gps_ready = best_ready_row is not None
    return {
        "firmware_profile": last.get("firmware_profile", MAC_PHYSICAL_SUPERVISED_PROFILE),
        "gps_ready": gps_ready,
        "gps_solution_valid": telemetry._parse_bool(last.get("gps_solution_valid")),
        "gps_chars": last.get("gps_chars", "NA"),
        "current_lat": current_lat,
        "current_lon": current_lon,
        "gps_sats": sats,
        "gps_hdop": hdop,
        "best_sats": best_sats,
        "best_hdop": best_hdop,
        "best_lat": best_lat,
        "best_lon": best_lon,
        "last_rmc_status": last.get("last_rmc_status", "NA"),
        "last_gga_fix_quality": last.get("last_gga_fix_quality", "NA"),
        "gps_block_reason": last.get("gps_block_reason", "NA"),
        "imu_present": telemetry._parse_bool(last.get("imu_present")),
        "imu_relative_yaw_deg": last.get("imu_relative_yaw_deg", "NA"),
        "ready_row": best_ready_row,
    }


def _gps_status_line(elapsed_s: float, snapshot: dict[str, object]) -> str:
    """GPS 대기 중 한 줄 상태 문자열. / One-line status while waiting for GPS."""
    return (
        f"elapsed_s={elapsed_s:.0f} "
        f"firmware_profile={snapshot['firmware_profile']} "
        f"gps_chars={snapshot['gps_chars']} "
        f"gps_ready={str(snapshot['gps_ready']).lower()} "
        f"gps_solution_valid={str(snapshot['gps_solution_valid']).lower()} "
        f"current_lat={telemetry._fmt(snapshot['current_lat'], 7) if snapshot['current_lat'] is not None else 'NA'} "
        f"current_lon={telemetry._fmt(snapshot['current_lon'], 7) if snapshot['current_lon'] is not None else 'NA'} "
        f"gps_sats={telemetry._fmt(snapshot['gps_sats'], 0) if snapshot['gps_sats'] is not None else 'NA'} "
        f"gps_hdop={telemetry._fmt(snapshot['gps_hdop'], 2) if snapshot['gps_hdop'] is not None else 'NA'} "
        f"last_rmc_status={snapshot['last_rmc_status']} "
        f"last_gga_fix_quality={snapshot['last_gga_fix_quality']} "
        f"best_sats={telemetry._fmt(snapshot['best_sats'], 0) if snapshot['best_sats'] is not None else 'NA'} "
        f"best_hdop={telemetry._fmt(snapshot['best_hdop'], 2) if snapshot['best_hdop'] is not None else 'NA'} "
        f"best_lat={telemetry._fmt(snapshot['best_lat'], 7) if snapshot['best_lat'] is not None else 'NA'} "
        f"best_lon={telemetry._fmt(snapshot['best_lon'], 7) if snapshot['best_lon'] is not None else 'NA'} "
        f"imu_present={str(snapshot['imu_present']).lower()} "
        f"imu_relative_yaw_deg={snapshot['imu_relative_yaw_deg']}"
    )


def write_gps_cache(snapshot: dict[str, object]) -> None:
    """확보된 시작좌표를 캐시 파일에 저장. / Persist the acquired start fix to the cache.

    이후 preview/run 이 GPS 재확보 없이 최근 시작좌표를 재사용할 수 있게 한다.
    부수효과: ``DEFAULT_GPS_CACHE`` JSON 기록(좌표 없으면 아무 것도 안 함).
    Lets later preview/run reuse a recent start without re-acquiring GPS. Side
    effect: writes the cache JSON (no-op when best_lat/lon is missing).
    """
    lat = snapshot.get("best_lat")
    lon = snapshot.get("best_lon")
    if lat is None or lon is None:
        return
    DEFAULT_GPS_CACHE.parent.mkdir(parents=True, exist_ok=True)
    _write_json(
        DEFAULT_GPS_CACHE,
        {
            "start_lat": lat,
            "start_lon": lon,
            "timestamp_s": time.time(),
            "gps_sats": snapshot.get("best_sats"),
            "gps_hdop": snapshot.get("best_hdop"),
            "source": "gps-wait",
            "firmware_profile": MAC_PHYSICAL_SUPERVISED_PROFILE,
            "ready_for_full_path_following": False,
        },
    )


def load_cached_start(max_age_s: float) -> dict[str, object] | None:
    """캐시된 시작좌표를 나이 제한 내에서 로드. / Load a cached start fix within max age.

    ``max_age_s`` 를 넘겼거나 좌표가 없으면 None. 성공 시 시작좌표 + 스냅샷 dict.
    Returns None when stale/missing; otherwise a start-fix + snapshot dict.
    """
    if not DEFAULT_GPS_CACHE.exists():
        return None
    try:
        data = json.loads(DEFAULT_GPS_CACHE.read_text())
    except (OSError, json.JSONDecodeError):
        return None
    timestamp_s = telemetry._optional_float(data.get("timestamp_s"))
    if timestamp_s is None or time.time() - timestamp_s > max_age_s:
        return None
    lat = telemetry._optional_float(data.get("start_lat"))
    lon = telemetry._optional_float(data.get("start_lon"))
    if lat is None or lon is None:
        return None
    return {
        "start_lat": lat,
        "start_lon": lon,
        "start_source": "cached_gps",
        "start_gps_block_reason": "CACHE",
        "start_gps_sats": data.get("gps_sats", "NA"),
        "start_gps_hdop": data.get("gps_hdop", "NA"),
        "gps_cached_used": True,
        "gps_wait_snapshot": {
            "firmware_profile": data.get("firmware_profile", MAC_PHYSICAL_SUPERVISED_PROFILE),
            "gps_ready": True,
            "gps_solution_valid": True,
            "current_lat": lat,
            "current_lon": lon,
            "gps_sats": data.get("gps_sats"),
            "gps_hdop": data.get("gps_hdop"),
            "best_sats": data.get("gps_sats"),
            "best_hdop": data.get("gps_hdop"),
            "best_lat": lat,
            "best_lon": lon,
            "last_rmc_status": data.get("last_rmc_status", "CACHE"),
            "last_gga_fix_quality": data.get("last_gga_fix_quality", "CACHE"),
            "imu_present": False,
            "imu_relative_yaw_deg": "NA",
        },
    }


def resolve_start_gps_from_rows(
    rows: Sequence[dict[str, str]],
    *,
    start_mode: str,
    cached_start_max_age_ms: int,
    min_sats: float = 5.0,
    max_hdop: float = 2.5,
) -> dict[str, object] | None:
    """Resolve the preview start coordinate from live/current or fresh cached GPS."""
    if start_mode not in {"live_gps", "cached_gps"}:
        return None
    snapshot = gps_snapshot(rows, min_sats=min_sats, max_hdop=max_hdop)
    ready_row = snapshot.get("ready_row")
    if start_mode == "live_gps" and isinstance(ready_row, dict):
        lat, lon = _lat_lon_from_row(
            ready_row,
            ("current_lat", "gps_lat", "current_gps_lat"),
            ("current_lon", "gps_lon", "current_gps_lon"),
        )
        if lat is not None and lon is not None:
            return {
                "start_lat": lat,
                "start_lon": lon,
                "start_source": "live_gps",
                "start_gps_block_reason": ready_row.get("gps_block_reason", "NA"),
                "start_gps_sats": ready_row.get("gps_sats", "NA"),
                "start_gps_hdop": ready_row.get("gps_hdop", "NA"),
                "gps_cached_used": False,
                "gps_wait_snapshot": {k: v for k, v in snapshot.items() if k != "ready_row"},
            }
    for row in reversed(rows):
        lat, lon = _lat_lon_from_row(
            row,
            ("gps_cached_lat", "gps_lat", "current_lat", "current_gps_lat"),
            ("gps_cached_lon", "gps_lon", "current_lon", "current_gps_lon"),
        )
        if lat is not None and lon is not None and _fresh_cached_gps(row, cached_start_max_age_ms):
            return {
                "start_lat": lat,
                "start_lon": lon,
                "start_source": "cached_gps",
                "start_gps_block_reason": row.get("gps_block_reason", "NA"),
                "start_gps_sats": row.get("gps_sats", "NA"),
                "start_gps_hdop": row.get("gps_hdop", "NA"),
                "gps_cached_used": True,
                "gps_wait_snapshot": {k: v for k, v in snapshot.items() if k != "ready_row"},
            }
    return None


def resolve_start_for_preview(args: argparse.Namespace) -> tuple[dict[str, object] | None, list[str]]:
    """미리보기/실행의 시작좌표를 해석(필요시 시리얼 오픈). / Resolve start coords for preview/run.

    우선순위: 명시 --start-lat/lon > (start_mode=explicit 이면 없음) > --from-log 파싱 >
    라이브 시리얼(옵션으로 감독형 펌웨어 업로드 후 GPS 대기) > 최근 캐시. 반환은
    ``(start_dict|None, raw_lines)``. preview 와 run 이 공유하는 시작좌표 획득 진입점.
    부수효과: 라이브 경로에서 시리얼을 열고 펌웨어를 업로드할 수 있으며 상태줄을 출력한다.
    Priority: explicit > (none if start_mode=explicit) > --from-log > live serial
    (optionally uploading supervised firmware then waiting for GPS) > recent cache.
    Returns ``(start_dict|None, raw_lines)``. Side effects on the live path: opens
    serial, may upload firmware, prints status.
    """
    if args.start_lat is not None and args.start_lon is not None:
        return {
            "start_lat": float(args.start_lat),
            "start_lon": float(args.start_lon),
            "start_source": "explicit",
            "start_gps_block_reason": "NA",
            "start_gps_sats": "NA",
            "start_gps_hdop": "NA",
            "gps_cached_used": False,
            "gps_wait_elapsed_s": 0.0,
        }, []
    if getattr(args, "start_mode", "live_gps") == "explicit":
        return None, []

    raw_lines: list[str] = []
    min_sats = float(getattr(args, "gps_min_sats", 5))
    max_hdop = float(getattr(args, "gps_max_hdop", 2.5))
    max_cache_s = float(getattr(args, "max_cached_start_age_s", 600))
    allow_cache = str(getattr(args, "allow_cached_start", "true")).lower() != "false"
    if getattr(args, "from_log", None):
        log_path = Path(args.from_log)
        raw_lines = log_path.read_text(encoding="utf-8").splitlines()
        rows = telemetry.parse_usbdbg_rows("\n".join(raw_lines))
        resolved = resolve_start_gps_from_rows(
            rows,
            start_mode=args.start_mode,
            cached_start_max_age_ms=args.cached_start_max_age_ms,
            min_sats=min_sats,
            max_hdop=max_hdop,
        )
        if resolved is not None:
            resolved["gps_wait_elapsed_s"] = 0.0
        return resolved, raw_lines

    if not ensure_port(args):
        return None, []
    if getattr(args, "upload", "auto") in {"true", "auto"}:
        uploaded = _upload_mac_physical_supervised_firmware(
            args,
            Path(args.out_dir),
            title="Mac Physical Supervised",
            mode=getattr(args, "mode", "preview"),
            build_path="/private/tmp/openrb-mac-physical-supervised",
        )
        if uploaded != 0:
            return None, []
    import serial

    if not telemetry._parse_bool(getattr(args, "wait_gps", "true"), default=True):
        deadline = time.monotonic() + 0.5
    else:
        deadline = time.monotonic() + float(getattr(args, "gps_timeout_s", args.start_timeout_s))
    status_interval_s = float(getattr(args, "gps_status_interval_s", 2.0))
    next_status = time.monotonic()
    start_monotonic = time.monotonic()
    rows: list[dict[str, str]] = []
    with serial.Serial(args.port, baudrate=args.baud, timeout=0.5) as handle:
        while time.monotonic() < deadline:
            raw = handle.readline()
            if not raw:
                continue
            line = raw.decode("utf-8", errors="replace").strip()
            raw_lines.append(line)
            rows = telemetry.parse_usbdbg_rows("\n".join(raw_lines))
            resolved = resolve_start_gps_from_rows(
                rows,
                start_mode=args.start_mode,
                cached_start_max_age_ms=args.cached_start_max_age_ms,
                min_sats=min_sats,
                max_hdop=max_hdop,
            )
            if resolved is not None:
                resolved["gps_wait_elapsed_s"] = time.monotonic() - start_monotonic
                return resolved, raw_lines
            if time.monotonic() >= next_status:
                snapshot = gps_snapshot(rows, min_sats=min_sats, max_hdop=max_hdop)
                print(_gps_status_line(time.monotonic() - start_monotonic, snapshot))
                next_status = time.monotonic() + status_interval_s
    if allow_cache:
        cached = load_cached_start(max_cache_s)
        if cached is not None:
            cached["gps_wait_elapsed_s"] = time.monotonic() - start_monotonic
            return cached, raw_lines
    return None, raw_lines


def resolve_plan(args: argparse.Namespace, calibration_dict: dict[str, object]) -> dict[str, object]:
    """Build the no-motion plan (segments + goal) shared by preview and run."""
    plan = preview.build_preview(
        start_lat=args.start_lat,
        start_lon=args.start_lon,
        goal_mode=args.goal_mode,
        goal_lat=args.goal_lat,
        goal_lon=args.goal_lon,
        goal_east_m=args.goal_east_m,
        goal_north_m=args.goal_north_m,
        goal_dlat=args.goal_dlat,
        goal_dlon=args.goal_dlon,
        goal_bearing_deg=args.goal_bearing_deg,
        goal_distance_m=args.goal_distance_m,
        path_shape=args.path_shape,
        workspace_width_m=args.workspace_width_m,
        step_spacing_m=args.step_spacing_m,
        diagonal_orientation=args.diagonal_orientation,
        max_segment_pulses=args.max_segment_pulses,
        nominal_forward_pulse_m=args.nominal_forward_pulse_m,
        calibration=calibration_dict,
        connector_style=getattr(args, "connector_style", geometry.DEFAULT_CONNECTOR_STYLE),
    )
    validate_resolved_field_config(args, plan)
    plan["field_config"] = build_resolved_field_config(args, plan)
    if str(plan.get("path_shape")) == geometry.DIAGONAL_RECTANGLE_SERPENTINE:
        print("diagonal_rectangle_serpentine follows the A-B diagonal frame; it is not the ㄹ coverage path.")
    return plan


def build_resolved_field_config(args: argparse.Namespace, plan: dict[str, object]) -> dict[str, object]:
    """Resolved A/B field geometry shown to the operator before preview/run."""
    goal_x, goal_y = geometry.goal_to_local(
        float(plan["start_lat"]),
        float(plan["start_lon"]),
        float(plan["goal_lat"]),
        float(plan["goal_lon"]),
    )
    goal_input = plan.get("goal_input", {})
    if not isinstance(goal_input, dict):
        goal_input = {}
    if str(plan.get("goal_mode", getattr(args, "goal_mode", ""))) == "relative_enu":
        if goal_input.get("goal_east_m") is not None:
            goal_x = float(goal_input["goal_east_m"])
        if goal_input.get("goal_north_m") is not None:
            goal_y = float(goal_input["goal_north_m"])
    return {
        "start_mode": getattr(args, "start_mode", "explicit"),
        "start_source": str(plan.get("start_source", "explicit")),
        "start_lat": float(plan["start_lat"]),
        "start_lon": float(plan["start_lon"]),
        "start_x_m": 0.0,
        "start_y_m": 0.0,
        "coordinate_mode": str(plan.get("goal_mode", getattr(args, "goal_mode", "unknown"))),
        "goal_mode": str(plan.get("goal_mode", getattr(args, "goal_mode", "unknown"))),
        "goal_east_m": goal_input.get("goal_east_m", getattr(args, "goal_east_m", None)),
        "goal_north_m": goal_input.get("goal_north_m", getattr(args, "goal_north_m", None)),
        "goal_lat": float(plan["goal_lat"]),
        "goal_lon": float(plan["goal_lon"]),
        "goal_x_m": goal_x,
        "goal_y_m": goal_y,
        "resolved_goal_x_m": goal_x,
        "resolved_goal_y_m": goal_y,
        "workspace_width_m": plan.get("workspace_width_m"),
        "workspace_length_m": plan.get("workspace_length_m"),
        "step_spacing_m": plan.get("step_spacing_m", getattr(args, "step_spacing_m", None)),
        "path_shape": str(plan.get("path_shape", getattr(args, "path_shape", "unknown"))),
        "diagonal_orientation": getattr(args, "diagonal_orientation", "A_top_left_to_B_bottom_right"),
        "expected_goal_distance_m": float(plan["goal_distance_m"]),
        "connector_count": int(plan.get("connector_count", 0)),
        "connector_style": str(plan.get("connector_style", geometry.DEFAULT_CONNECTOR_STYLE)),
        "connector_turn_count": int(plan.get("connector_turn_count", plan.get("connector_count", 0))),
        "step_lane_count": int(plan.get("step_lane_count", 0)),
        "coverage_area_estimate_m2": plan.get("coverage_area_estimate_m2"),
        "expected_sweep_style": plan.get("expected_sweep_style", "lawnmower_ㄹ"),
        "lane_count": int(plan.get("lane_count", 0)),
        "segment_count": int(plan.get("segment_count", 0)),
        "expected_lane_count": int(plan.get("lane_count", 0)),
        "expected_segment_count": int(plan.get("segment_count", 0)),
        "relative_enu_note": (
            "A is local (0,0); B is (goal_east_m, goal_north_m); coverage_lawnmower sweeps axis-aligned local ENU lanes."
            if str(plan.get("goal_mode")) == "relative_enu" and str(plan.get("path_shape")) == "coverage_lawnmower"
            else "A is local (0,0); B is (goal_east_m, goal_north_m); workspace width is perpendicular to the A-B diagonal."
            if str(plan.get("goal_mode")) == "relative_enu"
            else "NA"
        ),
        "ready_for_full_path_following": False,
    }


def validate_resolved_field_config(args: argparse.Namespace, plan: dict[str, object]) -> None:
    """계획 지오메트리 정합성 검증(위반 시 ValueError). / Validate plan geometry, raise on bad.

    목표거리>0, 스텝 간격>0, (직선 외에는) 작업폭>0 을 요구한다. 작업폭이 A-B 대각선에
    비해 과도하면 명시적 ``--allow-wide-field true`` 없이는 거부한다(현장 오설정 방지 가드).
    Requires goal distance>0, step spacing>0, and (except direct_line) width>0;
    rejects an over-wide field unless ``--allow-wide-field true`` is passed.
    """
    distance = float(plan.get("goal_distance_m", 0.0))
    if distance <= 0.0:
        raise ValueError("goal distance must be > 0")
    step_spacing = float(plan.get("step_spacing_m") or getattr(args, "step_spacing_m", 0.0))
    if step_spacing <= 0.0:
        raise ValueError("step_spacing_m must be > 0")
    if str(plan.get("path_shape")) != "direct_line":
        width = plan.get("workspace_width_m")
        if width is None or float(width) <= 0.0:
            raise ValueError("workspace_width_m must be > 0")
        max_ratio = float(getattr(args, "max_width_to_goal_ratio", 0.95))
        allow_wide = telemetry._parse_bool(getattr(args, "allow_wide_field", "false"), default=False)
        if not allow_wide and float(width) > distance * max_ratio:
            raise ValueError(
                "workspace_width_m is too large for the A-B diagonal; pass --allow-wide-field true only after verifying the field geometry"
            )


def format_field_config(config: dict[str, object]) -> str:
    """A/B 필드 구성을 사람이 읽을 여러 줄 텍스트로. / Field config as human-readable text."""
    ordered_keys = [
        "start_mode",
        "start_source",
        "start_lat",
        "start_lon",
        "start_x_m",
        "start_y_m",
        "goal_mode",
        "goal_east_m",
        "goal_north_m",
        "goal_lat",
        "goal_lon",
        "goal_x_m",
        "goal_y_m",
        "resolved_goal_x_m",
        "resolved_goal_y_m",
        "workspace_width_m",
        "step_spacing_m",
        "path_shape",
        "diagonal_orientation",
        "expected_goal_distance_m",
        "expected_lane_count",
        "expected_segment_count",
        "connector_count",
        "connector_style",
        "connector_turn_count",
        "step_lane_count",
        "coverage_area_estimate_m2",
        "expected_sweep_style",
    ]
    lines = ["Field configuration:"]
    for key in ordered_keys:
        lines.append(f"  {key}={config.get(key, 'NA')}")
    if config.get("relative_enu_note") not in (None, "NA"):
        lines.append(f"  note={config['relative_enu_note']}")
    return "\n".join(lines)


def load_rows_from_log(path: Path) -> list[dict[str, str]]:
    """Parse USBDBG telemetry rows from a saved serial log (no serial needed)."""
    return telemetry.parse_usbdbg_rows(path.read_text())


def load_planner_config(path: Path) -> dict[str, object]:
    """Load a shipped JSON config, dropping ``_``-prefixed comment keys.

    Used for the ``configs/*.json`` starting points. A ``field_rectangle_example``
    config loads with keys that are exactly :func:`preview.build_preview` kwargs,
    so ``build_preview(**load_planner_config(path))`` runs it directly.
    """
    data = json.loads(path.read_text())
    if not isinstance(data, dict):
        raise ValueError(f"config {path} must be a JSON object")
    return {key: value for key, value in data.items() if not key.startswith("_")}


def load_plan_dir_plan(plan_dir: Path) -> dict[str, object]:
    """저장된 plan-dir 를 계획 dict 로 복원. / Reconstruct a plan dict from a saved plan-dir.

    plan.json/preview_summary.json 을 기준으로 세그먼트/프리미티브 JSON 을 다시 붙여 레인·
    커넥터 수를 재계산한다. execute-plan/inspect-plan/auto-relative-run 이 공유한다.
    Rebuilds segments/primitives and recomputes lane/connector counts. Raises if no
    plan file is present.
    """
    candidates = [plan_dir / "plan.json", plan_dir / "preview_summary.json"]
    plan_path = next((path for path in candidates if path.exists()), None)
    if plan_path is None:
        raise FileNotFoundError(f"--plan-dir must contain plan.json or preview_summary.json: {plan_dir}")
    plan = json.loads(plan_path.read_text())
    if not isinstance(plan, dict):
        raise ValueError(f"plan file must contain a JSON object: {plan_path}")
    segments_json = plan_dir / "planned_segments.json"
    if segments_json.exists():
        segments = json.loads(segments_json.read_text())
        if isinstance(segments, list):
            plan["segments"] = segments
            plan["segment_count"] = len(segments)
            lane_count = len(
                [
                    seg for seg in segments
                    if str(seg.get("segment_type", "")) in geometry.FULL_LANE_SEGMENT_TYPES
                ]
            )
            plan["lane_count"] = lane_count
            plan["step_lane_count"] = len(
                [seg for seg in segments if str(seg.get("segment_type", "")) == "step_lane"]
            )
            plan["connector_turn_count"] = len(
                [
                    seg for seg in segments
                    if str(seg.get("segment_type", "")) in geometry.CONNECTOR_SEGMENT_TYPES
                ]
            )
            plan["connector_count"] = max(0, lane_count - 1)
    primitives_json = plan_dir / "planned_primitives.json"
    if primitives_json.exists():
        primitives = json.loads(primitives_json.read_text())
        if isinstance(primitives, list):
            plan["primitives"] = primitives
            plan["primitive_count"] = len(primitives)
    return plan


def diagnose_summary(rows: Sequence[dict[str, str]]) -> dict[str, object]:
    """Summarize telemetry rows into a read-only, never-ready diagnostic dict."""
    heartbeats = [r for r in rows if telemetry.event(r) == "HEARTBEAT"]
    last = heartbeats[-1] if heartbeats else None
    event_counts: dict[str, int] = {}
    for row in rows:
        name = telemetry.event(row) or "NONE"
        event_counts[name] = event_counts.get(name, 0) + 1
    summary: dict[str, object] = {
        "mode": "diagnose",
        "row_count": len(rows),
        "heartbeat_count": len(heartbeats),
        "event_counts": event_counts,
        "guarded_pulse_compatible": controller.guarded_pulse_compatible(last) if last else False,
        "physical_output_active": telemetry.physical_output_active(last) if last else False,
        "last_gps_block_reason": telemetry.gps_block_reason(last) if last else "NA",
        "last_gps_sats": telemetry._fmt(telemetry.gps_sats(last)) if last else "NA",
        "last_gps_hdop": telemetry._fmt(telemetry.gps_hdop(last)) if last else "NA",
        "last_imu_relative_yaw_deg": (
            telemetry._fmt(telemetry.imu_relative_yaw_deg(last)) if last else "NA"
        ),
        "ready_for_full_path_following": False,
    }
    return checks.assert_not_ready_for_full_path_following(summary)


def guarded_pulse_ready_summary(rows: Sequence[dict[str, str]]) -> dict[str, object]:
    """가드 펄스 펌웨어 준비 여부를 telemetry 로 판정. / Judge guarded-pulse firmware readiness.

    가드 하트비트 + 펌웨어 ready + IMU(BMI160) 존재/yaw + RC OK + 중립 OK 를 모두
    만족해야 ready. 하나라도 빠지면 사유 리스트를 모아 반환한다(순수, 부수효과 없음).
    Ready requires guarded heartbeat + firmware ready + IMU(BMI160)/yaw + rc_ok +
    neutral_ok; otherwise collects the missing reasons. Pure, no side effects.
    """
    heartbeats = [row for row in rows if telemetry.event(row) == "HEARTBEAT"]
    last = heartbeats[-1] if heartbeats else {}
    guarded_seen = any(
        row.get("usb_pulse_test_mode") == "true" or row.get(_COMPAT_GUARDED_MODE_KEY) == "true"
        for row in rows
    )
    firmware_ready = any(
        row.get("usb_pulse_ready") == "true" or row.get(_COMPAT_GUARDED_READY_KEY) == "true"
        for row in rows
    )
    imu_enabled = any(row.get("imu_enabled") == "true" for row in rows)
    imu_present = any(row.get("imu_present") == "true" for row in rows)
    imu_bmi160 = any(row.get("imu_type") == "BMI160" for row in rows)
    yaw_seen = any(row.get("imu_relative_yaw_deg", "NA").upper() not in {"", "NA", "NAN", "NONE"} for row in rows)
    rc_ok = any(row.get("rc_ok") == "true" for row in rows)
    neutral_ok = any(row.get("neutral_ok") == "true" for row in rows)
    ready = guarded_seen and firmware_ready and imu_enabled and imu_present and imu_bmi160 and yaw_seen and rc_ok and neutral_ok
    reasons: list[str] = []
    if not guarded_seen:
        reasons.append("GUARDED_PULSE_HEARTBEAT_NOT_SEEN")
    if not firmware_ready:
        reasons.append("GUARDED_PULSE_READY_FALSE")
    if not imu_enabled:
        reasons.append("IMU_NOT_ENABLED")
    if not imu_present:
        reasons.append("IMU_NOT_PRESENT")
    if not imu_bmi160:
        reasons.append("BMI160_NOT_SEEN")
    if not yaw_seen:
        reasons.append("IMU_YAW_NOT_AVAILABLE")
    if not rc_ok:
        reasons.append("RC_NOT_OK")
    if not neutral_ok:
        reasons.append("NEUTRAL_NOT_OK")
    return checks.assert_not_ready_for_full_path_following({
        "mode": "guarded-pulse-ready",
        "success": ready,
        "guarded_pulse_ready": ready,
        "guarded_pulse_heartbeat_seen": guarded_seen,
        "turn_angle_calibration_ready": ready,
        "imu_enabled": imu_enabled,
        "imu_present": imu_present,
        "imu_type": last.get("imu_type", "NA"),
        "imu_relative_yaw_available": yaw_seen,
        "rc_ok": rc_ok,
        "neutral_ok": neutral_ok,
        "reason": "OK" if ready else ",".join(reasons),
        "next_recommended_action": (
            "Guarded pulse firmware is ready for turn calibration or usb-pulse-test validation."
            if ready else
            "Upload/check IMU-enabled guarded pulse firmware and inspect heartbeat, IMU, RC, and neutral fields."
        ),
        "ready_for_full_path_following": False,
    })


# ── 출력 라이터 (JSON/CSV/원시 로그/미리보기 이미지) / Output writers ──
# --- Output writers -----------------------------------------------------------


def _write_json(path: Path, obj: object) -> None:
    """객체를 들여쓴 JSON 으로 기록(직렬화 불가는 str). / Write obj as indented JSON."""
    path.write_text(json.dumps(obj, indent=2, default=str) + "\n")


def _write_rows_csv(path: Path, rows: Sequence[dict[str, object]]) -> None:
    """행 dict 들을 CSV 로(열은 관측 순서로 합집합). / Write row dicts to CSV.

    빈 입력이면 빈 파일을 쓴다. 열 이름은 모든 행 키의 등장 순서 합집합.
    Empty input writes an empty file; columns are the ordered union of all keys.
    """
    if not rows:
        path.write_text("")
        return
    fieldnames: list[str] = []
    for row in rows:
        for key in row.keys():
            if key not in fieldnames:
                fieldnames.append(key)
    with path.open("w", newline="") as handle:
        writer = csv.DictWriter(handle, fieldnames=fieldnames)
        writer.writeheader()
        for row in rows:
            writer.writerow(row)


def _write_raw_log(path: Path, lines: Sequence[str]) -> None:
    """원시 시리얼 라인들을 로그 파일로. / Write raw serial lines to a log file."""
    path.write_text("\n".join(lines) + ("\n" if lines else ""))


def _required_preview_image_paths(out_dir: Path) -> dict[str, str]:
    """미리보기가 반드시 만들어야 하는 PNG 경로 맵. / Required preview PNG path map."""
    return {
        "preview_current_goal_rectangle_path": str(out_dir / "preview_current_goal_rectangle_path.png"),
        "preview_overview": str(out_dir / "preview_overview.png"),
    }


def _write_required_preview_images(out_dir: Path, plan: dict[str, object]) -> dict[str, str]:
    """필수 미리보기 PNG 를 렌더링(실패 시 RuntimeError). / Render required preview PNGs.

    이미지가 실제로 생기지 않으면 ``PREVIEW_IMAGE_NOT_WRITTEN`` 로 예외를 던져, 렌더 실패를
    물리 실행 전에 잡도록 한다(호출부가 이 예외를 실패 요약으로 변환).
    Raises ``RuntimeError('PREVIEW_IMAGE_NOT_WRITTEN ...')`` if a PNG is not created,
    so render failures are caught before physical execution.
    """
    image_paths = _required_preview_image_paths(out_dir)
    for expected in image_paths.values():
        expected_path = Path(expected)
        rendered = preview.write_preview_png(
            expected_path,
            plan["segments"],  # type: ignore[arg-type]
            float(plan["start_lat"]),
            float(plan["start_lon"]),
            float(plan["goal_lat"]),
            float(plan["goal_lon"]),
            plan.get("workspace"),  # type: ignore[arg-type]
            path_shape=str(plan.get("path_shape", "unknown")),
        )
        if rendered is None or not expected_path.exists():
            raise RuntimeError(f"PREVIEW_IMAGE_NOT_WRITTEN {expected_path}")
    return image_paths


def _write_plan_artifacts(out_dir: Path, plan: dict[str, object], field_config: dict[str, object]) -> dict[str, str]:
    """계획 산출물(이미지+JSON+CSV) 일괄 기록. / Write all plan artifacts (images/JSON/CSV).

    preview/run 공용. 미리보기 PNG, field_config, plan.json, 세그먼트/프리미티브/경로점
    CSV·JSON 을 out_dir 에 남기고 image_paths 를 반환한다.
    Shared by preview/run; writes PNGs, field_config, plan.json and the segment/
    primitive/path CSV+JSON, returning the image path map.
    """
    image_paths = _write_required_preview_images(out_dir, plan)
    field_config["image_paths"] = image_paths
    plan["image_paths"] = image_paths
    _write_json(out_dir / "field_config_resolved.json", field_config)
    _write_json(out_dir / "plan.json", plan)
    _write_rows_csv(out_dir / "planned_segments.csv", plan.get("segments", []))  # type: ignore[arg-type]
    _write_json(out_dir / "planned_segments.json", plan.get("segments", []))
    _write_rows_csv(out_dir / "planned_primitives.csv", plan.get("primitives", []))  # type: ignore[arg-type]
    _write_json(out_dir / "planned_primitives.json", plan.get("primitives", []))
    _write_rows_csv(out_dir / "planned_path_local.csv", plan.get("path_points", []))  # type: ignore[arg-type]
    return image_paths


def _fail(message: str) -> int:
    """stderr 에 ABORT 를 찍고 종료코드 2 반환. / Print ABORT to stderr, return exit code 2."""
    print(f"ABORT: {message}", file=sys.stderr)
    return 2


def _fail_with_summary(args: argparse.Namespace, *, reason: str, message: str) -> int:
    """실패 요약을 out_dir 에 쓰고 코드 2 반환. / Write a failure summary + return 2.

    입력/구성 오류(예: PLAN_INPUT_INVALID)에서 실패도 감사 가능한 요약으로 남기는 헬퍼.
    Records input/config failures as an auditable summary; side effect: writes files.
    """
    out_dir = getattr(args, "out_dir", None)
    if out_dir is not None:
        write_summary_files(
            out_dir,
            {
                "mode": getattr(args, "mode", "unknown"),
                "success": False,
                "reason": reason,
                "message": message,
                "next_recommended_action": "Fix the reported input or configuration and rerun the same command.",
                "ready_for_full_path_following": False,
            },
            title="Physical Path Planner",
        )
    return _fail(message)


# ══ 모드 핸들러 / Mode handlers (each = one CLI subcommand) ══════════════════
# 여기서부터 각 ``cmd_*`` 는 하나의 CLI 서브커맨드를 구현한다. 공통 패턴:
# (1) out_dir 준비 → (2) print/from-log 무하드웨어 분기 → (3) ensure_port +
# (필요시) 펌웨어 컴파일/업로드 → (4) 시리얼 스트리밍 → (5) telemetry 를 순수
# ``evaluate_*``/summary 로 축약 → (6) write_summary_files + stdout 출력 → 종료코드.
# From here each ``cmd_*`` implements one subcommand; common shape: prepare out_dir,
# handle print/from-log hardware-free branches, ensure_port + optional compile/
# upload, stream serial, reduce telemetry via a pure evaluator, write summaries.


# ── preview / 계획 미리보기 (모션 없음) / Coverage-plan preview (no motion) ──


def cmd_preview(args: argparse.Namespace) -> int:
    """coverage 계획을 만들고 렌더링(모션 없음). / Build + render the coverage plan. No motion.

    시작좌표를 해석(명시/라이브 GPS/캐시)하고 계획을 세워 미리보기 PNG 와 요약을 남긴다.
    시작좌표를 못 얻으면 NO_USABLE_START_GPS, 이미지 렌더 실패면 PREVIEW_IMAGE_NOT_WRITTEN.
    부수효과: 라이브 경로에서 시리얼/펌웨어 업로드, out_dir 에 산출물 기록.
    Resolves the start (explicit/live GPS/cache), builds the plan, writes preview
    PNGs + summary. Side effects: serial/upload on the live path; writes artifacts.
    """
    cal = resolve_calibration(args)
    start, raw_start_lines = resolve_start_for_preview(args)
    if start is None:
        out_dir = Path(args.out_dir)
        out_dir.mkdir(parents=True, exist_ok=True)
        if raw_start_lines:
            _write_raw_log(out_dir / "preview_start_usbdbg.log", raw_start_lines)
        raw_rows = telemetry.parse_usbdbg_rows("\n".join(raw_start_lines))
        snapshot = gps_snapshot(
            raw_rows,
            min_sats=float(getattr(args, "gps_min_sats", 5.0)),
            max_hdop=float(getattr(args, "gps_max_hdop", 2.5)),
        )
        summary = {
            "mode": "preview",
            "success": False,
            "reason": "NO_USABLE_START_GPS",
            "firmware_profile": MAC_PHYSICAL_SUPERVISED_PROFILE,
            "message": NO_USABLE_START_GPS_ACTION,
            "next_recommended_action": NO_USABLE_START_GPS_ACTION,
            "start_mode": getattr(args, "start_mode", "live_gps"),
            "start_source": "none",
            "gps_wait_enabled": telemetry._parse_bool(getattr(args, "wait_gps", "true"), default=True),
            "gps_wait_timeout_s": float(getattr(args, "gps_timeout_s", getattr(args, "start_timeout_s", 0.0))),
            "gps_wait_elapsed_s": float(getattr(args, "gps_timeout_s", getattr(args, "start_timeout_s", 0.0))),
            **{k: v for k, v in snapshot.items() if k != "ready_row"},
            "motion_calibration_loaded": motion_calibration_loaded(cal),
            "ready_for_full_path_following": False,
        }
        write_summary_files(out_dir, summary, title="Physical Path Planner Preview")
        print(f"preview: reason=NO_USABLE_START_GPS. {NO_USABLE_START_GPS_ACTION}")
        return 2
    args.start_lat = float(start["start_lat"])
    args.start_lon = float(start["start_lon"])
    try:
        plan = resolve_plan(args, cal)
    except ValueError as exc:
        return _fail_with_summary(args, reason="PLAN_INPUT_INVALID", message=str(exc))
    out_dir = Path(args.out_dir)
    out_dir.mkdir(parents=True, exist_ok=True)
    if raw_start_lines:
        _write_raw_log(out_dir / "preview_start_usbdbg.log", raw_start_lines)
    summary = {
        **plan,
        "mode": "preview",
        "success": True,
        "reason": "OK",
        "firmware_profile": MAC_PHYSICAL_SUPERVISED_PROFILE,
        "start_mode": getattr(args, "start_mode", "live_gps"),
        "start_source": start["start_source"],
        "current_lat": start["start_lat"],
        "current_lon": start["start_lon"],
        "start_gps_block_reason": start["start_gps_block_reason"],
        "start_gps_sats": start["start_gps_sats"],
        "start_gps_hdop": start["start_gps_hdop"],
        "gps_cached_used": start["gps_cached_used"],
        "gps_wait_enabled": telemetry._parse_bool(getattr(args, "wait_gps", "true"), default=True),
        "gps_wait_timeout_s": float(getattr(args, "gps_timeout_s", getattr(args, "start_timeout_s", 0.0))),
        "gps_wait_elapsed_s": start.get("gps_wait_elapsed_s", 0.0),
        **dict(start.get("gps_wait_snapshot", {})),
        "motion_calibration_loaded": motion_calibration_loaded(cal),
        "connector_mode_effective": cal.get("connector_mode_effective", plan.get("connector_mode_effective")),
        "next_recommended_action": f"Inspect {out_dir / 'summary.md'} and preview outputs before execute-plan or run.",
        "ready_for_full_path_following": False,
    }
    field_config = dict(plan.get("field_config", {}))
    field_config.update(
        {
            "start_mode": getattr(args, "start_mode", "live_gps"),
            "start_source": start["start_source"],
        }
    )
    try:
        image_paths = _write_plan_artifacts(out_dir, plan, field_config)
    except RuntimeError as exc:
        expected = str(exc).replace("PREVIEW_IMAGE_NOT_WRITTEN ", "")
        failure = {
            "mode": "preview",
            "success": False,
            "reason": "PREVIEW_IMAGE_NOT_WRITTEN",
            "expected_image_path": expected,
            "next_recommended_action": "Install/check matplotlib rendering and rerun preview before physical execution.",
            "ready_for_full_path_following": False,
        }
        write_summary_files(out_dir, failure, title="Physical Path Planner Preview")
        print(f"preview: reason=PREVIEW_IMAGE_NOT_WRITTEN expected_image_path={expected}")
        return 2
    plan["image_paths"] = image_paths
    summary["field_config"] = field_config
    summary["image_paths"] = image_paths
    _write_json(out_dir / "preview_summary.json", summary)
    write_summary_files(out_dir, summary, title="Physical Path Planner Preview")
    if telemetry._parse_bool(getattr(args, "print_field_config", "false"), default=False):
        print(format_field_config(field_config))
    print(
        f"preview: {plan['segment_count']} segments, "
        f"{plan['lane_count']} lanes, goal_distance_m={float(plan['goal_distance_m']):.3f} -> {out_dir}"
    )
    return 0


# ── gps-wait / GPS 콜드스타트 대기 (모션 없음) / Wait for GPS fix (no motion) ──


def _gps_wait_summary(
    rows: Sequence[dict[str, str]],
    *,
    mode: str,
    elapsed_s: float,
    timeout_s: float,
    min_sats: float,
    max_hdop: float,
) -> dict[str, object]:
    """gps-wait 결과 요약(준비/타임아웃). / Build the gps-wait summary (ready/timeout)."""
    snapshot = gps_snapshot(rows, min_sats=min_sats, max_hdop=max_hdop)
    summary = {k: v for k, v in snapshot.items() if k != "ready_row"}
    success = bool(snapshot["gps_ready"])
    summary.update(
        {
            "mode": mode,
            "success": success,
            "reason": "GPS_READY" if success else "GPS_WAIT_TIMEOUT",
            "firmware_profile": MAC_PHYSICAL_SUPERVISED_PROFILE,
            "gps_wait_enabled": True,
            "gps_wait_timeout_s": timeout_s,
            "gps_wait_elapsed_s": elapsed_s,
            "gps_min_sats": min_sats,
            "gps_max_hdop": max_hdop,
            "next_recommended_action": (
                "Use preview/run now that a start coordinate is available."
                if success else GPS_WAIT_TIMEOUT_ACTION
            ),
            "ready_for_full_path_following": False,
        }
    )
    return checks.assert_not_ready_for_full_path_following(summary)


def gps_telemetry_parse_mismatch(raw_lines: Sequence[str], rows: Sequence[dict[str, str]]) -> bool:
    """원시 라인은 왔는데 GPS/IMU 필드를 못 알아봤나. / Raw arrived but GPS/IMU fields unparsed?

    True 면 대개 펌웨어 프로파일 불일치 또는 파서 mismatch(잘못된 telemetry 포맷)를 뜻한다.
    True usually indicates a wrong firmware profile or a telemetry parser mismatch.
    """
    if not raw_lines:
        return False
    gps_keys = {
        "gps_chars",
        "gps_ready",
        "gps_solution_valid",
        "current_lat",
        "current_lon",
        "gps_lat",
        "gps_lon",
        "gps_sats",
        "gps_hdop",
        "last_rmc_status",
        "last_gga_fix_quality",
    }
    imu_keys = {"imu_present", "imu_relative_yaw_deg", "imu_enabled", "imu_type"}
    return (
        not rows
        or not any(gps_keys.intersection(row.keys()) for row in rows)
        or not any(imu_keys.intersection(row.keys()) for row in rows)
    )


def write_raw_gps_samples(out_dir: Path, raw_lines: Sequence[str]) -> None:
    """진단용 원시 GPS 라인 최대 20개 기록. / Write up to 20 raw GPS lines for diagnosis."""
    samples = [line for line in raw_lines if line][:20]
    (out_dir / "raw_gps_samples.txt").write_text("\n".join(samples) + ("\n" if samples else ""), encoding="utf-8")


def cmd_gps_wait(args: argparse.Namespace) -> int:
    """사용 가능한 GPS 시작 fix 를 대기(모션 없음). / Wait for a usable GPS start fix. No motion.

    감독형 펌웨어를 (옵션) 업로드하고 시리얼을 스트리밍하며 준비될 때까지 대기, 성공 시
    시작좌표를 캐시에 저장한다. Ctrl-C 는 USER_ABORTED(130), 시리얼 끊김은 SERIAL_DISCONNECT.
    부수효과: 시리얼/업로드, 요약·CSV·원시로그 기록, 성공 시 GPS 캐시 쓰기.
    Optionally uploads supervised firmware, streams serial until GPS is ready, and
    caches the fix on success. Side effects: serial/upload, writes files + cache.
    """
    out_dir = Path(args.out_dir)
    out_dir.mkdir(parents=True, exist_ok=True)
    raw_lines: list[str] = []
    rows: list[dict[str, str]] = []
    start = time.monotonic()
    user_aborted = False
    if getattr(args, "from_log", None):
        raw_lines = Path(args.from_log).read_text(encoding="utf-8").splitlines()
        rows = telemetry.parse_usbdbg_rows("\n".join(raw_lines))
        elapsed_s = 0.0
    else:
        if not ensure_port(args):
            return 2
        if args.upload in {"true", "auto"}:
            uploaded = _upload_mac_physical_supervised_firmware(
                args,
                out_dir,
                title="GPS Wait",
                mode="gps-wait",
                build_path="/private/tmp/openrb-mac-physical-supervised",
            )
            if uploaded != 0:
                return uploaded
        import serial
        try:
            serial_errors = (OSError, serial.serialutil.SerialException)
        except AttributeError:
            serial_errors = (OSError,)

        deadline = start + float(args.timeout_s)
        next_status = start
        try:
            with serial.Serial(args.port, baudrate=args.baud, timeout=0.5) as handle:
                while time.monotonic() < deadline:
                    raw = handle.readline()
                    if not raw:
                        continue
                    line = raw.decode("utf-8", errors="replace").strip()
                    raw_lines.append(line)
                    parsed = telemetry.parse_usbdbg_rows(line)
                    if parsed:
                        rows.extend(parsed)
                    snapshot = gps_snapshot(rows, min_sats=args.min_sats, max_hdop=args.max_hdop)
                    if time.monotonic() >= next_status:
                        print(_gps_status_line(time.monotonic() - start, snapshot))
                        next_status = time.monotonic() + float(args.status_interval_s)
                    if snapshot["gps_ready"]:
                        break
        except KeyboardInterrupt:
            user_aborted = True
            print("gps-wait: user aborted; writing summaries.")
        except serial_errors:
            elapsed_s = time.monotonic() - start
            summary = {
                **_gps_wait_summary(
                    rows,
                    mode="gps-wait",
                    elapsed_s=elapsed_s,
                    timeout_s=float(args.timeout_s),
                    min_sats=float(args.min_sats),
                    max_hdop=float(args.max_hdop),
                ),
                "success": False,
                "reason": "SERIAL_DISCONNECT",
                "next_recommended_action": "Reconnect OpenRB and rerun gps-wait.",
                "ready_for_full_path_following": False,
            }
            _write_raw_log(out_dir / "raw_usbdbg.log", raw_lines)
            _write_rows_csv(out_dir / "gps_wait.csv", rows)
            write_summary_files(out_dir, summary, title="GPS Wait")
            return 2
        elapsed_s = time.monotonic() - start
    summary = _gps_wait_summary(
        rows,
        mode="gps-wait",
        elapsed_s=elapsed_s,
        timeout_s=float(args.timeout_s),
        min_sats=float(args.min_sats),
        max_hdop=float(args.max_hdop),
    )
    if gps_telemetry_parse_mismatch(raw_lines, rows):
        write_raw_gps_samples(out_dir, raw_lines)
        summary = {
            **summary,
            "success": False,
            "reason": "WRONG_FIRMWARE_PROFILE_OR_TELEMETRY_PARSE_MISMATCH",
            "raw_gps_samples": "raw_gps_samples.txt",
            "next_recommended_action": "Telemetry arrived, but GPS/IMU fields for MAC_PHYSICAL_SUPERVISED were not recognized. Inspect raw_gps_samples.txt and verify the firmware profile/parser.",
            "ready_for_full_path_following": False,
        }
    if user_aborted:
        summary = {
            **summary,
            "success": False,
            "reason": "USER_ABORTED",
            "user_aborted": True,
            "next_recommended_action": "Rerun gps-wait when ready to continue waiting for GPS.",
            "ready_for_full_path_following": False,
        }
        summary = checks.assert_not_ready_for_full_path_following(summary)
    _write_raw_log(out_dir / "raw_usbdbg.log", raw_lines)
    _write_rows_csv(out_dir / "gps_wait.csv", rows)
    write_summary_files(out_dir, summary, title="GPS Wait")
    if summary["success"] is True:
        write_gps_cache(gps_snapshot(rows, min_sats=args.min_sats, max_hdop=args.max_hdop))
    print(
        f"gps-wait: reason={summary['reason']} "
        f"best_sats={summary['best_sats']} best_hdop={summary['best_hdop']} -> {out_dir}"
    )
    if user_aborted:
        return 130
    return 0 if summary["success"] is True else 2


# ── calibrate-turn / 턴 각도 보정 (외부 스크립트 위임) / Turn-angle calibration ──


def cmd_calibrate_turn(args: argparse.Namespace) -> int:
    """가드 펄스 턴 각도 보정 스크립트로 위임. / Shell out to guarded-pulse turn calibration.

    이 CLI 는 직접 모터를 돌리지 않고 레거시 보정 스크립트에 argv 를 만들어 넘긴다
    (IMU yaw 비교 강제). ``--print-cmd`` 는 시리얼/펌웨어 없이 명령만 출력.
    부수효과: 서브프로세스 실행, 요약 기록. 반환은 스크립트 종료코드.
    Builds argv for the legacy calibration script (forcing IMU yaw compare) and runs
    it; ``--print-cmd`` only prints. Side effects: subprocess + summary write.
    """
    if args.print_cmd:
        args.port = printable_port(args.port)
    if not args.print_cmd and not ensure_port(args):
        return 2
    mode = args.mode
    if args.direction:
        mode = "turn_left" if args.direction == "left" else "turn_right"
    argv = build_calibrate_turn_argv(
        script=args.script,
        port=args.port,
        mode=mode,
        b_cmd=args.b_cmd,
        pulse_ms=args.pulse_ms,
        max_abs_b=args.max_abs_b,
        max_ms=args.max_ms,
        target_angle_deg=args.target_angle_deg,
        angle_tolerance_deg=args.angle_tolerance_deg,
        save_turn_calibration=args.save_turn_calibration,
        turn_calibration_out=args.turn_calibration_out,
        out_dir=args.out_dir,
    )
    printable = " ".join(shlex.quote(part) for part in argv)
    if args.print_cmd:
        print(printable)
        write_summary_files(
            args.out_dir,
            {
                "mode": "calibrate-turn",
                "success": True,
                "reason": "COMMAND_PRINTED",
                "command": printable,
                "turn_angle_calibration_ready": False,
                "next_recommended_action": "Run without --print-cmd only when ready to upload firmware and calibrate physically.",
                "ready_for_full_path_following": False,
            },
            title="Turn Angle Calibration",
        )
        return 0
    print(f"calibrate-turn: invoking {printable}")
    completed = subprocess.run(argv, check=False)
    write_summary_files(
        args.out_dir,
        {
            "mode": "calibrate-turn",
            "success": completed.returncode == 0,
            "reason": "OK" if completed.returncode == 0 else "TURN_CALIBRATION_FAILED",
            "returncode": completed.returncode,
            "command": printable,
            "turn_angle_calibration_ready": completed.returncode == 0,
            "next_recommended_action": (
                "Inspect the calibration output summary and turn calibration JSON."
                if completed.returncode == 0
                else "Inspect raw logs, IMU yaw availability, ACK/STOP, and visual confirmation."
            ),
            "ready_for_full_path_following": False,
        },
        title="Turn Angle Calibration",
    )
    return completed.returncode


# ── manual-rc / 수동 RC 패스스루 복구·검증 / Manual RC passthrough recovery ──
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
