seonukkim/gps_hc12_robot/tools/side_tool_path_preview.py

"""사이드 툴(측면 장착 청소/도장 도구) 경로 미리보기 CLI / 렌더러.

목적/역할:
    `gps_coverage_core.side_tool_planner`가 계산한 **순수 기하 경로**를 받아
    사람이 검토할 수 있는 산출물(CSV·요약 Markdown·PNG 미리보기·타임라인 프레임)
    로 변환하는 오프라인 도구다. 이 파일 자체는 경로를 계획하지 않는다 —
    계획 로직은 전부 플래너에 있고, 여기서는 그 결과를 "직렬화 + 시각화"만 한다.
    가장 중요한 불변식: **모터 명령·HC-12 프레임·펌웨어 출력을 절대 만들지 않는다**
    (모든 산출물에 `motor_command_generated=False`가 박혀 있고 문구로도 반복 명시).

    Offline preview/rendering CLI for the side-mounted tool path. It takes the
    geometry-only poses produced by `gps_coverage_core.side_tool_planner` and
    turns them into human-review artifacts (CSV, summary markdown, PNG previews,
    timeline/segment frames). It never plans a path and never emits any motor,
    HC-12, or firmware output — everything is preview-only.

시스템 내 위치 (pipeline):
    - Import 하는 것: `side_tool_planner`의 공개 함수(`generate_side_tool_path`,
      `generate_tool_serpentine_preview`, `summarize_side_tool_path`,
      `contamination_analysis`, `strategy_diagnostics`, `swept_volume_summary`,
      `geometry_samples_for_path`, `boundary_polygon`)와 준(準)공개 밑줄 헬퍼
      (`_workspace_info`, `_coverage_grid`, `_cells_for_polygon`). 따라서 플래너
      쪽 이 심볼들의 시그니처가 바뀌면 이 파일이 곧바로 깨진다(강한 결합).
    - `_bootstrap`을 먼저 import 해 리포지토리 루트를 `sys.path`에 넣고
      matplotlib 캐시 디렉터리를 설정한다. matplotlib은 **선택적 의존성**이라
      미설치 시 렌더 함수들은 `None`을 반환하고 CSV/요약만 생성된다.
    - 실행 진입점: `python -m tools.side_tool_path_preview ...`. 파이프라인상
      맨 끝단(검토/디버깅)이며, 다른 모듈이 이 파일을 import 하지는 않는다.

핵심 개념·불변식 (concepts / invariants):
    - **CSV 필드 튜플이 스키마 계약**이다(`CSV_FIELDS`, `GEOMETRY_SAMPLE_FIELDS`,
      `TOOL_SERPENTINE_CSV_FIELDS` 등). 플래너가 채우는 pose dict 키와 이름이
      정확히 일치해야 하며, 순서가 곧 열 순서다. 함부로 재배열/개명 금지.
    - **두 가지 CLI 모드**: 기본은 단순 serpentine 미리보기(`build_simple_parser`,
      `tool_serpentine_ab`), `--advanced`/`--debug-planner-options`를 주면 레거시/
      디버그 플래너 옵션 전체(`build_parser`)가 열린다. 두 모드가 만드는 산출물
      집합과 CSV 파일명이 다르다.
    - **좌표계**: 플래너는 로컬 작업 프레임에서 계산하고 pose에 `world_*` 필드로
      A/B 프레임 좌표를 함께 담는다. 렌더러는 모드에 따라 로컬 오프셋을 더해
      월드로 옮겨 그린다(예: `world(x,y) = (x_min+x, y_min+y)`).
    - **오염(contamination) 재현**: `_contamination_samples`가 플래너의 시간순
      샘플을 다시 훑어 셀별 최초 청소 시각을 기록하고, 섀시가 이미 젖은 셀을 밟는
      위반을 판정한다. 이 로직은 플래너의 판정과 **의미가 일치해야** 한다.

사용법/진입점 (entry points):
    - `main(argv)` — CLI 디스패처. `--advanced` 유무로 파서/구성 경로를 가른다.
    - `build_simple_parser()` / `build_parser()` — 각각 단순/고급 인자 정의.
    - `_run_tool_serpentine_preview_output(...)` — serpentine 모드 산출물 일괄 생성.
    - `_write_*` 계열 — 각 산출물(CSV/MD/PNG/프레임) 하나씩 담당하는 헬퍼.

리팩토링 노트 (refactor cautions):
    - 이 파일은 코드는 byte-identical로 두고 **문서만** 추가해야 하는 대상이다.
    - 새 필드를 추가하려면 반드시 (1) 플래너의 pose dict, (2) 여기 필드 튜플,
      (3) 해당 `_write_*` 헬퍼 세 곳을 함께 손봐야 한다.
    - 모든 렌더 함수는 matplotlib import를 함수 내부 try/except로 감싸 미설치
      환경에서도 CSV 경로가 동작하도록 한다 — 이 패턴을 깨지 말 것.
"""

from __future__ import annotations

import argparse
import csv
import datetime as dt
import json
import sys
from pathlib import Path
from typing import Sequence

try:
    from tools import _bootstrap  # type: ignore  # noqa: F401
except ImportError:
    import _bootstrap  # type: ignore  # noqa: F401

from gps_coverage_core.side_tool_planner import (
    SideToolPlanConfig,
    _cells_for_polygon,
    _coverage_grid,
    _workspace_info,
    boundary_polygon,
    contamination_analysis,
    geometry_samples_for_path,
    generate_tool_serpentine_preview,
    generate_side_tool_path,
    strategy_diagnostics,
    summarize_side_tool_path,
    swept_volume_summary,
)
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
