seonukkim/gps_hc12_robot/tools/stage18_motor_mapping_probe.py

from __future__ import annotations

import argparse
import csv
import time
from pathlib import Path
from typing import Sequence

try:
    from tools import _bootstrap  # type: ignore  # noqa: F401
except ImportError:
    import _bootstrap  # type: ignore  # noqa: F401

from tools import station_path_package_tracker


PROBE_FIELDS = (
    "trial_index",
    "mode",
    "cmd",
    "pulse_ms",
    "seq",
    "arm_command_text",
    "stage18_command_text",
    "stop_command_text",
    "requested_left_cmd",
    "requested_right_cmd",
    "logical_left_cmd",
    "logical_right_cmd",
    "physical_a_cmd",
    "physical_b_cmd",
    "final_left_cmd",
    "final_right_cmd",
    "motor_write_called",
    "motor_backend",
    "motor_enable_state",
    "pwm_or_dynamixel_write_status",
    "firmware_active_target_source",
    "physical_path_following_enable",
    "allow_motor_output",
    "physical_output_active_seen",
    "physical_output_active_after_stop",
    "arm_ack_seen",
    "ack_seen",
    "stop_seen",
    "reject_seen",
    "reject_reason",
    "left_wheel_user_report",
    "right_wheel_user_report",
    "body_motion_user_report",
    "visible_motion_confirmed",
    "motor_power_or_mapping_suspect",
    "next_action",
    "ready_for_full_path_following",
)

WHEEL_RESPONSES = {"yes", "no", "twitch", "unknown"}
BODY_RESPONSES = {"none", "forward", "backward", "left", "right", "twitch", "unknown"}
VISIBLE_WHEEL = {"yes", "twitch"}
VISIBLE_BODY = {"forward", "backward", "left", "right", "twitch"}


def _parse_bool(value: object, default: bool = False) -> bool:
    if value is None:
        return default
    return str(value).strip().lower() in {"1", "true", "yes", "y", "ok", "active"}


def _parse_float(value: object, default: float = 0.0) -> float:
    try:
        return float(str(value).strip())
    except (TypeError, ValueError):
        return default


def _latest(rows: Sequence[dict[str, str]], key: str, default: str = "NA") -> str:
    for row in reversed(rows):
        if key in row:
            return row[key]
    return default


def parse_float_list(text: str, *, max_value: float) -> list[float]:
    values: list[float] = []
    for item in text.split(","):
        stripped = item.strip()
        if not stripped:
            continue
        value = float(stripped)
        if value <= 0 or value > max_value:
            raise ValueError(f"value {value} exceeds safe limit {max_value}")
        values.append(value)
    if not values:
        raise ValueError("empty command list")
    return values


def parse_int_list(text: str, *, max_value: int) -> list[int]:
    values: list[int] = []
    for item in text.split(","):
        stripped = item.strip()
        if not stripped:
            continue
        value = int(float(stripped))
        if value <= 0 or value > max_value:
            raise ValueError(f"value {value} exceeds safe limit {max_value}")
        values.append(value)
    if not values:
        raise ValueError("empty pulse list")
    return values
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
