seonukkim/gps_hc12_robot/(commit log)

2026-05-02 Validate RC mix calibration and failsafe behavior
    [rc_mix_test.ino]
2026-05-02 Finalize station RC mapping with CH5 manual auto switch
2026-05-02 Document final station CH5 mode switch convention
2026-05-03 docs: organize report materials and project figures
2026-05-26 docs: record GPS Serial2 success and choose UART option B
2026-05-26 docs: revise UART allocation to option A
2026-05-27 firmware: add fixed wiring GPS Serial2 diagnostic mode
    [openrb_robot_controller.ino]
2026-05-27 Document fixed wiring GPS and legacy HC-12 references
2026-05-27 firmware: add fixed wiring RC GPS autonomy dry-run
    [openrb_robot_controller.ino]
2026-05-27 docs: record fixed wiring RC GPS dry-run validation
2026-05-28 station: correct coverage planner to corner rectangle mode
    [test_planner.py, test_station_plan_coverage_path.py]
2026-05-28 firmware: add I2C scanner for IMU verification
2026-05-28 docs: record fixed D11 D12 IMU scan failure
2026-05-28 firmware: harden default Wire I2C scanner
2026-05-28 docs: mark IMU bus stuck low and continue without IMU
2026-05-29 firmware: add safe RC channel probe
2026-05-29 firmware: add GPS stability state to Serial2 probe
    [gps_uart_probe.ino, openrb_robot_controller.ino]
2026-05-29 firmware: add guarded ground crawl after armed output test
2026-05-30 docs: record guarded crawl 0.08 clamp and latch test
2026-05-30 firmware: add GPS-independent motor pulse calibration
2026-05-30 docs: separate GPS validation from motor pulse testing
2026-05-30 firmware: add differential drive calibration support
2026-05-30 firmware: make motor pulse use direct wheel commands
2026-05-30 firmware: fix motor pulse direct wheel command path
    [openrb_robot_controller.ino]
2026-05-30 firmware: map logical wheel commands to throttle-turn outputs
2026-05-30 firmware: fix manual RC arcade mixer
    [openrb_robot_controller.ino]
2026-05-30 tools: add path preview and steering dry-run diagnostics
2026-06-03 feat: add IMU heading diagnostics for path dry-run
2026-06-03 diagnostics: add strict IMU checks and no-motion dry-run workflow
2026-06-06 feat: add BMI160 IMU support for no-motion rover validation
2026-06-07 Add guarded straight and turn calibration workflows
2026-06-08 Clean up deprecated stage scripts from user workflow
2026-06-08 Fix station hardware manual control workflow
    [cli.py, test_ppp_cli.py]
2026-06-08 Fix station hardware frame parser mismatch handling
    [cli.py, openrb_robot_controller.ino, test_ppp_cli.py]
2026-06-08 Remove numbered stage sprawl from active workflow
2026-06-08 Fix physical path planning workflow
    [cli.py, controller.py, openrb_robot_controller.ino, ppm_channel_map_probe.ino, ppm_test.ino, preview.py, rc_channel_probe.ino, test_ppp_cli.py]
2026-06-08 Trace and restore old working PPM manual control profile
2026-06-08 Add closed-loop GPS/IMU path following + AUTO-switch relative run
    Fix execute-plan closed-loop correction and add an AUTO-switch-triggered relative path-planning workflow for Mac-supervised physical field tests.
    Closed-loop fixes:
    - Capture the IMU heading-hold reference per lane (honor explicit --start-yaw-deg
    for the first lane, else auto-capture from the lane's first heartbeat) so heading
    correction is live without a manual start yaw; the previous None default left
    heading_error permanently 0, so corrections never reached the B axis.
    - Add segment_start/end_x_m/y_m to closed_loop_trace.csv; report
    closed_loop_correction_applied and field_config_loaded; emit
    lane_count/segment_c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
    [cli.py, controller.py, openrb_robot_controller.ino, test_ppp_auto_relative.py, test_ppp_cli.py, test_ppp_controller.py, test_ppp_field_config.py]
2026-06-08 Add initial heading alignment and motion recalibration workflow
    Initial heading alignment for Mac-supervised physical path planning, plus a
    recalibration workflow that protects the previous approved motion calibration.
    Heading alignment:
    - New align-heading mode estimates the rover's absolute ENU heading from a short
    guarded GPS-displacement probe, then turns to the first lane heading using IMU
    yaw only as turn feedback (magnitude), not as an absolute compass. Strategies:
    gps_probe (probe + IMU turn), user_confirmed (operator points, capture IMU yaw),
    and skip. Writes summary.md/json, align_heading_trace.csv, and raw_usbdbg.log.
    - Integrate optional alignment into run/execute-plan/a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
    [alignment.py, cli.py, executor.py, test_ppp_alignment.py, test_ppp_auto_relative.py, test_ppp_cli.py, tuning.py]
2026-06-08 Add stop-correct-go control mode and calibration-check preflight
    Stop-correct-go control mode:
    - New --path-control-mode stop_correct_go for run / auto-relative-run: a
    discrete move/stop/sense/correct loop that reuses the executor pulse FSM and
    the B-only heading + cross-track correction math (correction applied only
    while stopped, never lowering calibrated A/ms).
    - Sensor priority via --sensor-trust-mode (imu_gps_first default); GPS
    degradation dead-reckons on the IMU; writes stop_correct_go_trace.csv and
    heading_correction_trace.csv plus sensor/correction counters in the summary.
    Calibration completeness + calibration-check:
    - calibration.calibration_completeness reports which p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
    [calibration.py, cli.py, controller.py, test_ppp_auto_relative.py, test_ppp_calibration_check.py, test_ppp_cli.py, test_ppp_stop_correct_go.py]
2026-06-08 Add manual motion calibration override workflow
2026-06-11 Make connector turns respect calibrated per-pulse angle with IMU feedback
    The turn_*_90 calibration on this rover is physically a small pulse
    (~15-45 deg), but the executor assumed one pulse completed each 90 deg
    lawnmower corner and verified it against a start yaw that is normally
    absent, so every corner silently under-turned and the coverage path
    degraded into a wide arc.
    - connector_primitive now surfaces target_angle_deg (falling back to the
    measured imu_yaw_delta_deg, then 90) instead of dropping it.
    - stop_correct_go connectors pulse the calibrated turn repeatedly and stop
    on the measured yaw delta from the connector's own start, bounded by
    --max-connector-pulses-per-turn; witho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
2026-06-11 Plan lawnmower corners as drivable turn-step-turn sub-segments
    The single path_connector segment claimed a 1.2 m sideways translation
    that execution never drove (it only pulsed a pivot), so the planned ㄹ
    and the physical path could not match. Each lane-to-lane transition is
    now decomposed, by default, into:
    pivot ~90 deg -> step-over straight (forward after forward lanes,
    reverse after backward lanes) -> pivot ~90 deg back
    which is exactly the forward/turn/step/turn/reverse pattern the rover
    can execute with its calibrated primitives. Turn directions and signed
    turn_angle_deg are derived from the actual body-heading geometry (so
    fields stepping right of travel turn right), and every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
    [cli.py, controller.py, geometry.py, preview.py, test_ppp_coverage_lawnmower.py, test_ppp_stop_correct_go.py]
2026-06-11 Document ㄹ corner semantics, field runbooks, and collaboration guide
    - architecture: turn_step_turn connector decomposition, target_angle_deg
    turn semantics, mission vs per_lane heading reference, AUTO/MANUAL
    switch behavior
    - README runbook: end-to-end ㄹ coverage field workflow with recommended
    stop_correct_go parameters, and the auto-relative-run MANUAL/AUTO
    switch workflow
    - known_issues: record the rounded-corner root causes as resolved with
    the operator rules learned
    - new docs/claude_collaboration_guide.md (Korean): single entry point
    for future AI-assisted sessions (state, semantics, trace-reading
    decision tree, git workflow, glossary)
    - interim report for this refac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
2026-06-12 Stop connector pulsing on measured overshoot
    Field tune-motion data showed the same turn command producing anywhere
    from 1.6 to 43 degrees per pulse (stiction vs breakaway). A pulse that
    blows past the corner must not be followed by more same-direction
    pulses: once the measured remaining error flips sign the connector now
    stops, records turn_overshoot, and leaves the residual to the next
    lane's direction-aware heading correction. Summary gains
    connector_overshoot_count; the trace gains turn_overshoot.
    https://claude.ai/code/session_01DA9qvEeHuJFbqvKu6P3WED
    [cli.py, controller.py, test_ppp_stop_correct_go.py]
2026-06-12 Hand small connector remainders to lane correction instead of coarse pulses
    Right-turn field data shows one pulse covering most of a corner with
    2-3x variance; when the measured remaining angle is under half of one
    pulse's expected rotation, another full pulse would land farther from
    the corner than we already are. The connector now stops there
    (turn_handed_off) and the next lane's finer IMU heading correction owns
    the remainder. Summary gains connector_handed_off_count.
    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
    [cli.py, controller.py, test_ppp_stop_correct_go.py]
2026-06-12 Run connectors as continuous live IMU pivots; guard GPS teleports
    First field run after the corner refactor surfaced two failures:
    1. The first corner pulse (calibrated 2200 ms) was rejected with
    COMMAND_EXCEEDS_MAX_MS: the guarded-pulse firmware's max duration is a
    compile-time flag baked at upload (3000 ms for tune-motion uploads,
    1000 ms for usb-pulse-test uploads), so calibration measured under one
    upload can be unrunnable under another. Connectors now execute as ONE
    continuous live-drive IMU-feedback pivot per corner (the proven heading
    correction mechanism): no long guarded pulses, no per-pulse stiction
    restarts, stop on measured yaw within tolerance, overshoot st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
    [cli.py, controller.py, test_ppp_stop_correct_go.py]
2026-06-12 Turn in burst-stop-measure cycles; in-motion telemetry is starved
    Field run 20260612_135922 (uploaded summaries): all 4 connectors ran
    their full 10 s cap blind (connector_completed_count=0) and 16 of 21
    heading corrections failed. Root cause: while motors run, the firmware
    streams MOTOR_TRACE every ~2 ms and saturates the 115200 bps link, so
    yaw-bearing heartbeats rarely reach the host -- any turn loop that
    expects in-motion IMU feedback spins blind to its time cap (the 360-720
    degree corner spins observed in the field).
    _run_stop_correct_go_heading_turn (used by both connectors and lane
    corrections) now turns in burst -> stop -> measure cycles: one bounded
    deadman live SET sized from the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
    [controller.py, test_ppp_stop_correct_go.py]
2026-06-12 Add untethered rc-auto-pattern: CH5 MANUAL sticks / AUTO onboard pattern
    auto-relative-run keeps the brain on the station, so unplugging USB
    stops everything by design (deadman). rc-auto-pattern uploads a
    standalone firmware built on the proven rc-mix-ppm manual profile plus
    IMU yaw: CH5 MANUAL drives the RC sticks exactly as manual-control
    does; holding MANUAL >=1 s and flipping to AUTO runs ONE onboard ㄹ
    pattern (timed forward/reverse lanes, IMU-feedback ~90 deg pivots with
    overshoot/timeout stops, step-overs mirroring the planner's
    turn_step_turn corners); flipping back to MANUAL stops motors on the
    next loop tick and resumes stick control. Booting with the switch in
    AUTO never moves: a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
    [cli.py, openrb_robot_controller.ino, test_ppp_rc_auto_pattern.py]
2026-06-12 Default rc-auto-pattern to the field-proven PPM decode profile
    The first untethered upload sat in FAILSAFE the whole session:
    ppm_decode_reason=PPM_SYNC_ONLY_NO_CHANNELS, ppm_frame_count=0 -- the
    rc-mix-ppm base profile's falling-edge PPM decode never produced a
    frame on this receiver, so neither the sticks nor the AUTO pattern
    could run. The supervised firmware's heartbeats on the same receiver
    decode channels (mode_us, growing ppm_frame_count) using the
    firmware-default settings, which full-telemetry-ppm keeps.
    rc-auto-pattern now bases its flags on full-telemetry-ppm by default
    and exposes --profile (full-telemetry-ppm / old-working-ppm /
    rc-mix-ppm) for receivers that need a different d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
    [cli.py, test_ppp_rc_auto_pattern.py]
2026-06-12 Keep untethered control responsive; escalate stalled pivots; render pattern preview
    Field round 2 of rc-auto-pattern: PPM decode now works (frames counting,
    MANUAL sticks drive), but two issues remained.
    1. Manual driving turned laggy the moment the USB cable or monitor went
    away. The firmware prints a ~3 KB USBDBG status line every 500 ms;
    with no host draining the CDC port those writes stall the control
    loop. RC_AUTO_PATTERN builds now print telemetry (status line and
    pattern lines) only while a USB host is attached, so the untethered
    loop runs print-free and stick response stays immediate.
    2. AUTO drove the first straight lane and then appeared dead: the fixed
    pivot B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
    [cli.py, openrb_robot_controller.ino, test_ppp_rc_auto_pattern.py]
2026-06-12 Fix untethered pattern veer/early-stop/restart semantics and USB print stalls
    Untethered RC_AUTO_PATTERN firmware:
    - Anchor every AUTO run to the yaw captured at start (RUN_START) and give
    each step an absolute body-heading target, so corner residue and lane
    veer never accumulate; every MANUAL->AUTO flip rebuilds the steps and
    restarts from step 0 at the current pose (no resume of a partial run).
    - Drive lanes with heading-hold steering (HEADING_KP/HEADING_MAX_B plus
    DRIVE_B_TRIM) in both directions, fixing straights that bowed ~60 deg
    left per lane.
    - Pivot toward the absolute target with live direction re-selection (no
    overshoot latch); stall escalation resets on direction chan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
    [cli.py, openrb_robot_controller.ino, test_ppp_rc_auto_pattern.py]
2026-06-12 Fix lane heading-hold runaway, make corners square, auto re-zero gyro bias
    Field log analysis (tethered monitor, first heading-hold run): both pivots
    converged to tolerance while all three driven segments diverged under the
    same feedback sign (error -0.3 -> -148.9 deg as B saturated). On this
    drivetrain the yaw response to B while translating is inverted relative to
    a stationary pivot, so lanes now apply RC_AUTO_PATTERN_DRIVE_STEER_SIGN
    (default -1) to the heading-hold feedback only; pivots are unchanged. A
    lane whose error still diverges past RC_AUTO_PATTERN_DRIVE_ABORT_ERR_DEG
    stops early instead of carving a donut.
    Square corners: pivots stop early by the measured yaw rate times
    RC_AUTO_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
    [cli.py, openrb_robot_controller.ino, test_ppp_rc_auto_pattern.py]
2026-07-01 Add diagram PDF of the station routing/drive code guide
    Six-page A4 visual guide (matplotlib vector PDF) covering the PC-vs-rover
    architecture, install/run entry points and mode table, the per-file role
    map, the build-time + serial-protocol Python<->Arduino connection, the
    step-by-step tethered run flow, and the routing-only file pointers. Korean
    renders via WenQuanYi Zen Hei with a Unifont glyph fallback. The generator
    script is committed so the PDF is reproducible: uv run python
    scripts/build_station_routing_pdf.py.
    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
2026-07-01 Add bilingual (KO/EN) documentation across tests and analysis scripts
    Document every pytest file under tests/ and the figure/station scripts under
    scripts/ with bilingual Korean+English docstrings: each test module states the
    behavior/contract it locks in, each test function states the scenario/invariant
    it verifies, and fixtures/helpers get section banners. The analysis pipeline
    and the coverage-path planner script get the same module/function treatment,
    noting the test-locked contract surfaces.
    Documentation only: every executable statement is byte-identical (verified by a
    docstring-stripped AST comparison over all changed files) and the full test
    suite passes unchanged.
    https://claude.a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
    [test_analyze_heading_readiness_log.py]
2026-07-01 Complete test_ppp_cli bilingual docs (final tail)
    The slowest documentation agent added the remaining per-test docstrings and
    section banners for the diagnose --from-log through reset-motion-calibration
    sections of tests/test_ppp_cli.py. Documentation only; AST-identical to before
    (no logic change); py_compile clean and the file's tests pass.
    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
    [test_ppp_cli.py]
2026-07-01 Fix undefined _robot_length NameError in tool-serpentine preview
    generate_tool_serpentine_preview built its summary with
    `_robot_length(config)` when tool_length_m was unset, but no _robot_length
    helper exists in the module — a latent NameError on that (previously
    untested) branch. Reuse the existing tool_length_m() resolver, which already
    implements the intended tool -> robot -> 0.18 m fallback, and update the two
    docstring notes that flagged the defect. Adds a regression test covering the
    tool_length_m=None branch.
    Behavior for the common (tool_length set) path is unchanged; the full test
    suite passes.
    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
    [test_side_tool_planner.py]
